Brahiam18/controlador-pid-analogico-levitador/README.md

# Controlador PID analógico para levitación electromagnética







Diseño, cálculo, simulación, implementación y pruebas de un controlador **PID 100 % analógico**, construido solo con amplificadores operacionales LM741, para estabilizar la posición de un objeto en levitación por atracción electromagnética. El repositorio incluye el informe técnico completo (PDF y código fuente LaTeX), las figuras, la lista de materiales, las mediciones del montaje físico y su comparación con la teoría.

> **TL;DR (EN):** Fully analog, parallel PID controller built with LM741 op-amps for an electromagnetic levitation system: error amplifier, P / I (with anti-windup leak) / D (with high-frequency limiting) stages, and a summing stage with offset that produces a 1–3 V control signal. Reference voltages are generated by resistive dividers isolated with voltage-follower buffers. Includes hand calculations, Proteus simulation and an IEEE-style report written in LaTeX (Spanish).

📄 **Informe:** [`informe/Informe_PID_Analogico_Levitador.pdf`](informe/Informe_PID_Analogico_Levitador.pdf)

---

## Resumen del diseño

| Parámetro | Valor |
|---|---|
| Topología | PID en **paralelo** (P, I y D independientes; no en cascada) |
| Amplificadores | 7 × LM741 (U1–U7) |
| Alimentación de diseño | ±16 V |
| Salida del controlador | 1 V a 3 V (1 V = error nulo) |
| Referencia de posición | `V_ref` ≈ 2 V |
| Ganancias finales | `Kp = 2.2` · `Ki,max = 4.5` · `Kd,max = 22` |
| Frecuencias de diseño | integrador: `f_aw ≈ 0.2 Hz` · derivador: `f_c ≈ 150 Hz` |

**¿Por qué un PID?** Un levitador por atracción es inestable en lazo abierto (teorema de Earnshaw). Se descartaron el control todo-o-nada (fuerza discontinua), el P puro y el PD (ambos dejan error de estado estable o no lo eliminan) y se eligió el PID: P corrige el error instantáneo, I elimina el error de estado estable y D aporta el amortiguamiento que el sistema no tiene por sí mismo.

## Arquitectura

```mermaid
flowchart LR
    S["Sensor de posición<br/>V_sensor"] --> D["Diferenciador de error<br/>U1"]
    VR["Divisor + buffer V_ref<br/>R12, R13, U6"] --> D
    D -- "V_e" --> P["Proporcional<br/>U2 (Pot1, R5)"]
    D -- "V_e" --> I["Integral + anti-windup<br/>U3 (Pot2, Ci, R11)"]
    D -- "V_e" --> De["Derivativo + filtro<br/>U4 (R6, C2, Pot3)"]
    P --> SUM["Sumador<br/>U5 (R7–R10, R_offset)"]
    I --> SUM
    De --> SUM
    VO["Divisor + buffer V_off<br/>R14, R15, U7"] --> SUM
    SUM -- "1 a 3 V" --> OUT["Etapa de potencia y bobina"]
    OUT --> OBJ["Posición del objeto"]
    OBJ -. "realimentación" .-> S
```

| Etapa | CI | Ecuación de diseño | Valores finales |
|---|---|---|---|
| Diferenciador de error | U1 | `V_e = (R2/R1)·(V_sensor − V_ref)`, `Av = 1` | R1 = R2 = R3 = R4 = 10 kΩ |
| Proporcional (P) | U2 | `V_P = −(Pot1/R5)·V_e` | R5 = 10 kΩ, Pot1 = 22 kΩ (`Kp = 2.2`) |
| Integral (I) | U3 | `V_I = −(1/(Pot2·Ci))∫V_e dt`, con fuga `R11 ‖ Ci`: `K_max = R11/Pot2` | Pot2 = 220 kΩ, Ci = 1 µF, R11 = 1 MΩ (`K_max = 4.5`) |
| Derivativo (D) | U4 | `V_D = −Pot3·C2·dV_e/dt`, `G_max = Pot3/R6`, `f_c = 1/(2π·R6·C2)` | R6 = 1 kΩ, C2 = 1 µF, Pot3 = 22 kΩ (`Kd,max = 22`) |
| Sumador | U5 | `V_PID = −(R10/R7·V_P + R10/R8·V_I + R10/R9·V_D + R10/R_offset·V_off)` | R7 = R8 = R9 = R_offset = 10 kΩ, R10 = 1 kΩ (ganancia 0.1 por rama) |
| Referencia `V_ref` | U6 | divisor + seguidor | R12 = 160 kΩ, R13 = 240 kΩ (desde 5 V → 2 V) |
| Offset `V_off` | U7 | divisor + seguidor | R14 = 96 kΩ (calculada; **pendiente de medir**), R15 = 160 kΩ |

La nomenclatura de las resistencias fue actualizada respecto a la primera versión del informe; la tabla de equivalencias está en [`docs/nomenclatura.md`](docs/nomenclatura.md).

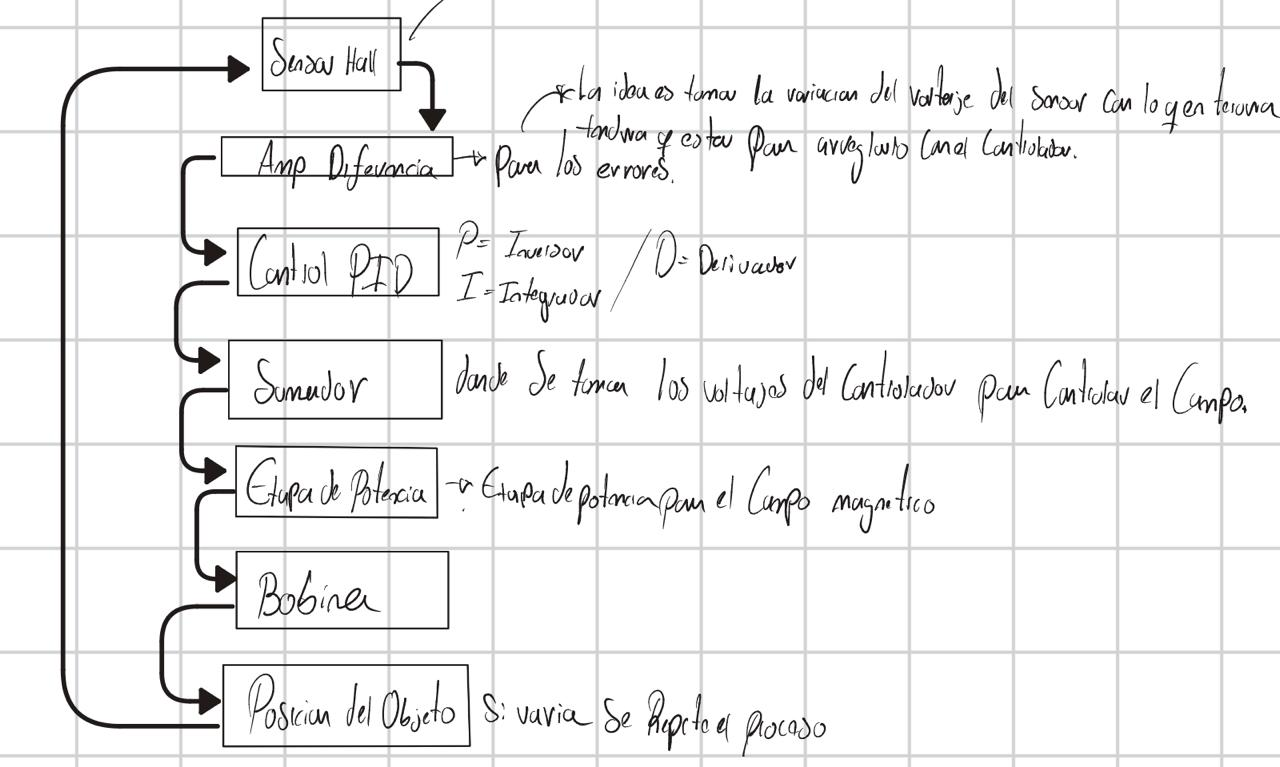
[picture p1: informe/figuras/diagrama_de_bloques.jpeg]
Diagrama de bloques


## Problemas encontrados y cómo se resolvieron

1. **Saturación del sumador.** Con ganancia unitaria por rama, la salida teórica ante error máximo era de 23.24 V, muy por encima de los rieles. Se bajó la ganancia por rama a 0.1 (`R10`: 10 kΩ → 1 kΩ), se agregó un voltaje de offset para fijar el piso en 1 V y se redujo `Kp` de 3 a 2.2 para que el máximo converja a ≈ 3 V (3.02 V).
2. **Topología del integrador.** La resistencia de anti-windup se había conectado *en serie* con el capacitor, dejando la realimentación abierta en continua. Al colocarla en **paralelo** (`R11 ‖ Ci`) el integrador recuperó su comportamiento (salida nula para error nulo, rampa ante un escalón). Además se rediseñó `Ki` (ganancia DC máxima de 80 → 4.5) porque la original saturaba ante errores pequeños.
3. **Efecto de carga en los divisores.** Los divisores de `V_ref` y `V_off` entregaban menos voltaje del calculado al conectarse a la etapa siguiente. Se intercaló un seguidor de voltaje (U6 y U7) en cada uno.

## Placa de circuito impreso (2 PID con etapa de potencia por tarjeta)

En [`hardware/pcb/`](hardware/pcb/) hay una placa de una sola cara (170.2 × 116.8 mm, cabe en una baquela de 20 × 20 cm) con **dos controladores PID independientes, cada uno con su etapa de potencia** (TIP122, banco de sensado de 3 × 1 Ω y bornes de bobina). Para los cuatro controladores se hacen **dos tarjetas iguales**. Está lista para quemar en baquela: archivos EAGLE para Fusion, hojas de cobre espejado a escala 1:1 y de ensamble con los nombres de cada pieza (U1 a U8 sobre los TL074CN), lista de puentes y el generador en Python. El informe todavía describe el diseño con LM741.

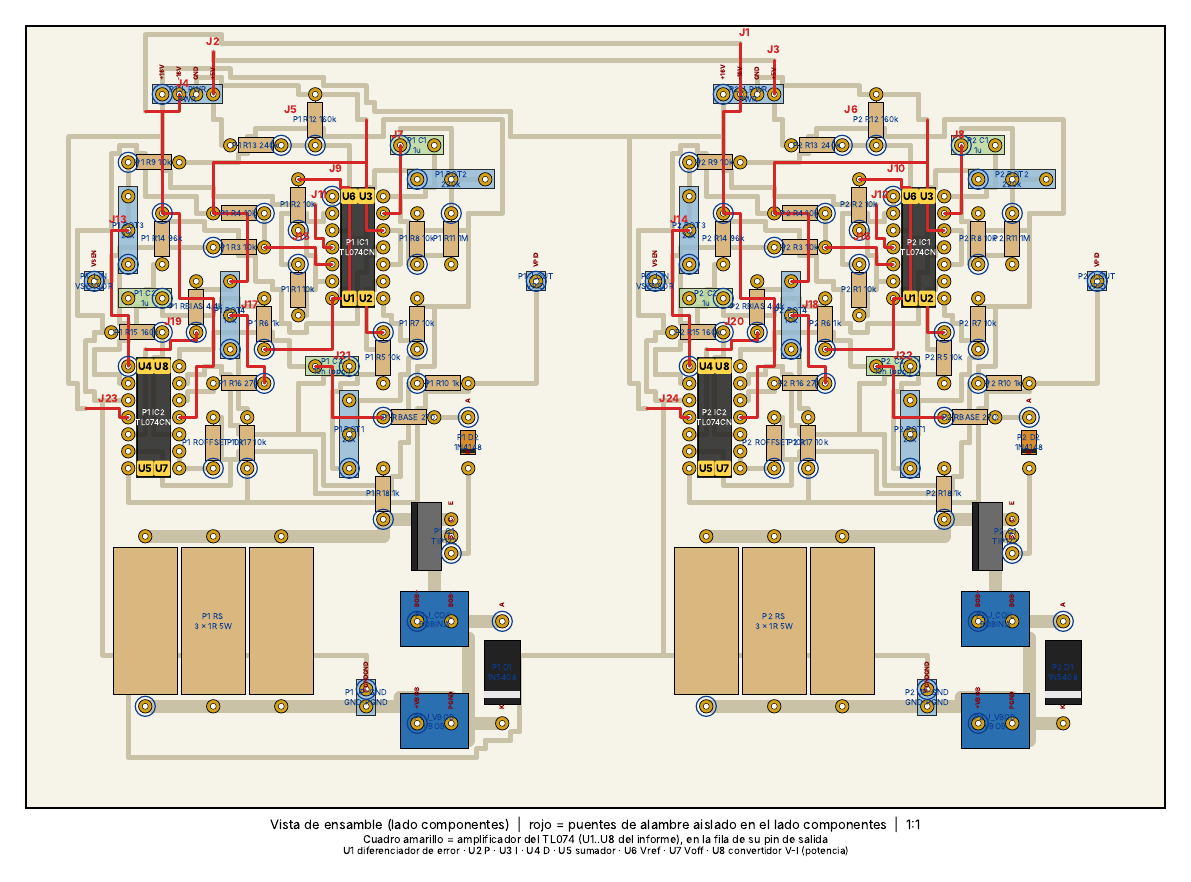
[picture p2: hardware/pcb/img/ensamble.png]
Placa de 2 PID


## Etapa de potencia (convertidor tensión-corriente)

La salida del PID (`V_PID`, 1 V a 3 V) no mueve la bobina directamente: pasa por un **convertidor tensión-corriente** con un amplificador operacional (U8) y un transistor Darlington TIP122, de modo que la bobina recibe una **corriente proporcional a `V_PID`** y no depende de su resistencia ni de la fuente (mientras el transistor no se sature). Es lo que se necesita en un levitador: la fuerza magnética depende de la corriente.

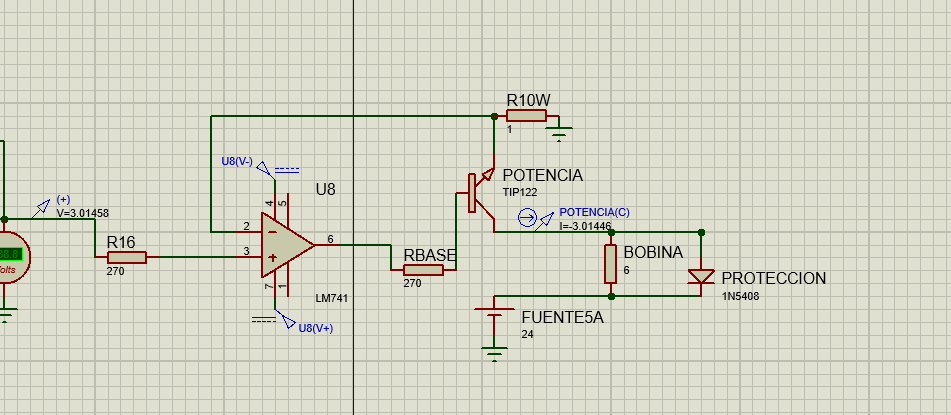
[picture p3: informe/figuras/proteus_etapa_potencia.png]
Etapa de potencia en Proteus


**Cómo funciona.**

1. `V_PID` llega a la entrada no inversora de U8 por `R17` (10 kΩ), el potenciómetro de calibración `POT4` (10 kΩ) y `R16` (270 Ω); `POT4` fija cuántos amperios se obtienen por voltio de `V_PID`.
2. U8 maneja la base del TIP122 a través de `R_BASE` (270 Ω) y del diodo `D2` (1N4148).
3. La corriente de la bobina pasa por el TIP122 y por el **banco de sensado** (3 × 1 Ω / 5 W en paralelo = 0.33 Ω), cuya caída `V_ISENSE = 0.33 V/A · I` vuelve a la entrada inversora de U8 por `R18` (1 kΩ).
4. U8 corrige la base hasta que `V_ISENSE` iguala la tensión de su entrada no inversora; por eso `I ≈ V₊ / R_sense`, es decir, **la corriente sigue a `V_PID`**.
5. `D1` (1N5408) en antiparalelo con la bobina absorbe la tensión inducida cuando se corta la corriente. `C3` (10 nF, opcional) compensa el lazo de U8 si oscila.

| Elemento | Valor | Función |
|---|---|---|
| `R17` | 10 kΩ | entrada del convertidor desde `V_PID` |
| `POT4` | 10 kΩ | calibración (A por voltio de `V_PID`) |
| `R16` | 270 Ω | protección de la entrada no inversora de U8 |
| `R18` | 1 kΩ | realimentación de `V_ISENSE` a la entrada inversora |
| `R_BASE` | 270 Ω | limita la corriente de base del TIP122 |
| `R_sense` | 3 × 1 Ω / 5 W (0.33 Ω) | sensado de la corriente de la bobina |
| `D1` / `D2` | 1N5408 / 1N4148 | protección de la bobina / protección de la base |
| TIP122 | Darlington NPN | elemento de paso (≈ 4.7 W con 1 A: lleva disipador de ≤ 10 °C/W y tab aislado) |

**Simulación (Proteus).** El archivo [`simulacion/proteus/EtapaPID1.pdsprj`](simulacion/proteus/EtapaPID1.pdsprj) contiene el PID completo con esta etapa. La captura muestra una **variante de simulación** para comprobar el principio: LM741 como U8, resistencia de sensado de 1 Ω / 10 W, bobina de 6 Ω y fuente de 24 V. Con `V₊ = 3.015 V` la corriente por el TIP122 es de **3.014 A**, igual a `V₊ / 1 Ω`: el convertidor entrega la corriente que se le pide. En el montaje real el sensado es de 0.33 Ω, la bobina ronda los 4 Ω y la corriente de trabajo es de unos 1 A, alimentada desde módulos reductores (ver [`docs/estado_del_proyecto.md`](docs/estado_del_proyecto.md)).

## Simulación en Proteus

Cada etapa se simuló y midió con voltímetros virtuales antes del montaje. El proyecto de Proteus se encuentra en [`simulacion/proteus/`](simulacion/proteus/) (`EtapaPID1.pdsprj`). El esquemático completo está en [`informe/figuras/proteus_circuito_completo.png`](informe/figuras/proteus_circuito_completo.png) y el esquemático hecho a mano en [`informe/figuras/circuito_manuscrito.jpeg`](informe/figuras/circuito_manuscrito.jpeg).

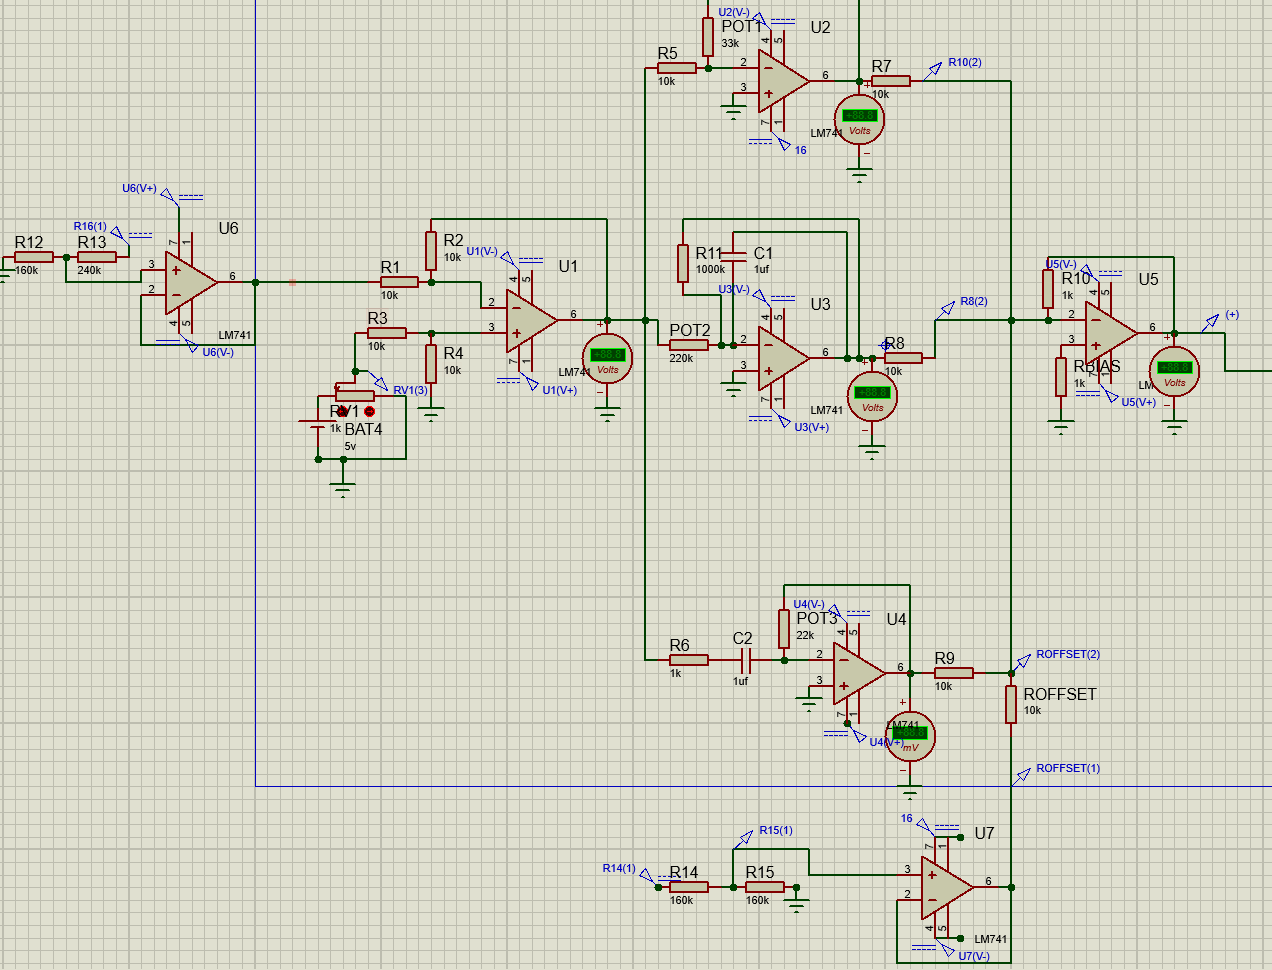
[picture p4: informe/figuras/proteus_circuito_completo.png]
Esquemático en Proteus


## Resultados experimentales

Voltaje teórico vs. práctico por etapa, para error mínimo, medio y máximo (`V_sensor` = 0, 2 y 5 V con `V_ref` = 2 V). Las mediciones se tomaron con multímetro sobre el montaje en protoboard alimentado a ±16 V. Los datos completos, con error absoluto y relativo, están en [`datos/mediciones_practicas.csv`](datos/mediciones_practicas.csv).

| Etapa | Teórico mín. (V) | Teórico medio (V) | Teórico máx. (V) | Práctico mín. (V) | Práctico medio (V) | Práctico máx. (V) |
|---|---:|---:|---:|---:|---:|---:|
| Diferenciador | −2 | 0 | 3 | −2.02 | 0 | 2.99 |
| Proporcional (P) | 4.38 | −0.01 | −6.6 | 4.46 | −0.15 | −6.6 |
| Integral (I) | 9.14 | 0.07 | −13.5 | 6.22 | −0.32 | −13.22 |
| Derivativo (D) | −3.24 mV | −3.24 mV | −3.3 mV | 3 mV | 3 mV | 172 mV |
| Sumador | −0.35 | 1 | 3.01 | −0.04 | 1 | 2.96 |
| Divisor `V_ref` | 2 | 2 | 2 | 2 | 2 | 2 |
| Divisor `V_off` | −10.1 | −10.1 | −10.1 | −10.21 | −10.21 | −10.21 |

**Lectura rápida:**
- El diferenciador, el proporcional, el sumador y los divisores con buffer coinciden con lo calculado (error relativo ≤ 2 % donde el valor teórico es mayor que 0.5 V). La salida del sumador con error máximo es 2.96 V, dentro del rango de diseño de 1 V a 3 V, y con error medio es exactamente 1 V.
- La etapa integral con error mínimo da 6.22 V frente a 9.14 V teóricos (−32 %). Con ese valor práctico, el sumador resulta en −0.04 V, que es coherente con la salida medida.
- En la etapa derivativa, con entrada en DC, los valores son del orden de milivoltios; el de 172 mV con error máximo queda pendiente de analizar.

### Montaje físico

<p align="center">
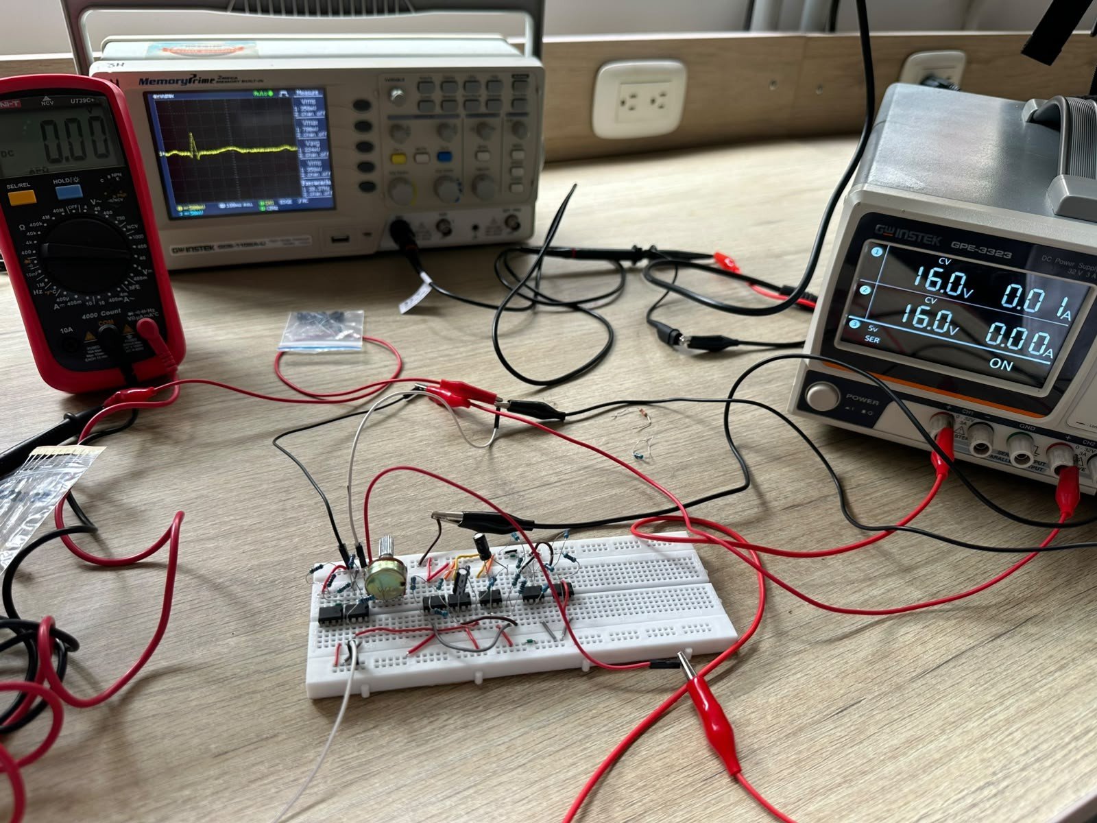
[picture p5: informe/figuras/pruebas/montaje_fisico.jpg]
Montaje físico del controlador PID
  
</p>

| Circuito en protoboard | Medición a la salida del diferenciador (2.99 V) |
|:-:|:-:|
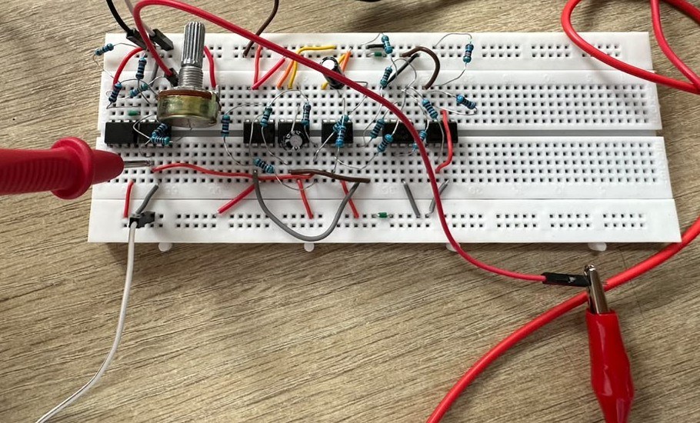
[picture p6: informe/figuras/pruebas/montaje_protoboard.jpg]
Protoboard
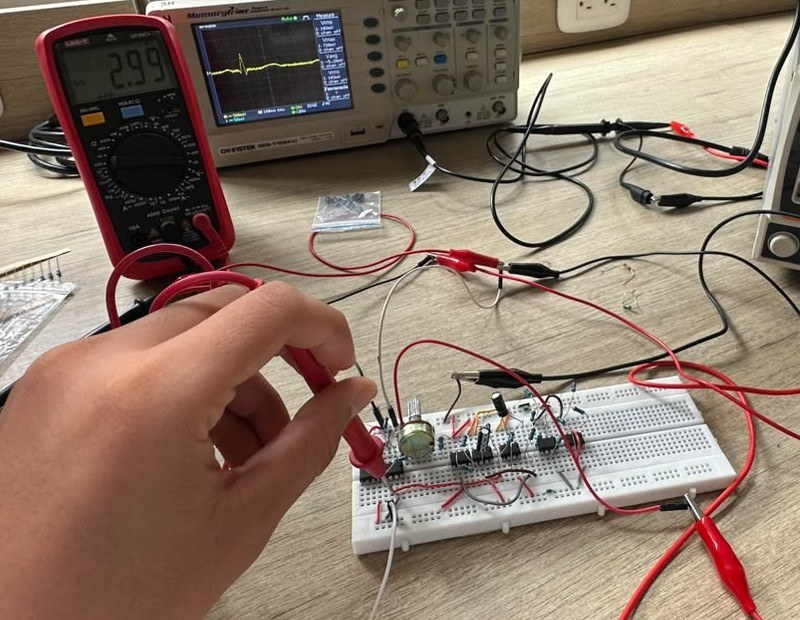
[picture p7: informe/figuras/pruebas/medicion_diferenciador.jpg]
Medición del diferenciador
|  |  |

## Simulación del campo y póster

Modelo del campo magnético de las 4 bobinas y del imán (aproximación de dipolos, solvers propios en Python, no FEMM) para estimar la corriente de equilibrio: unos **0,7 A por bobina a 30 mm** (±15 %). Es una estimación ilustrativa; **la levitación todavía no se ha logrado en el montaje**.

<p align="center">
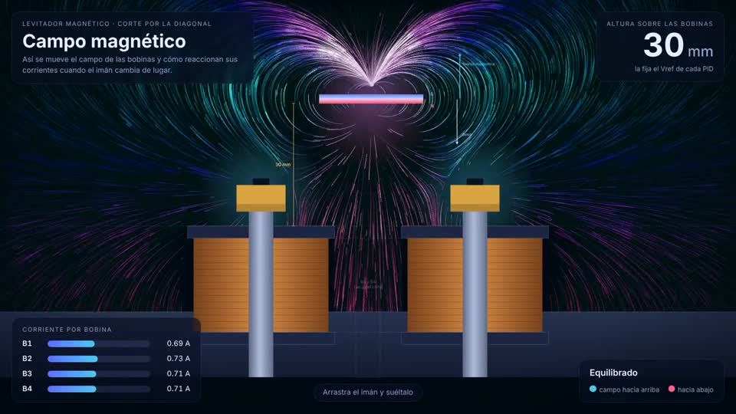
[picture p8: docs/simulacion_campo/vista_previa.jpg]
Video de la simulación del campo
  
</p>

- Video (720p): [`docs/simulacion_campo/campo_levitador_720p.mp4`](docs/simulacion_campo/campo_levitador_720p.mp4)
- Visor interactivo 3D: [`docs/simulacion_campo/campo_levitador.html`](docs/simulacion_campo/campo_levitador.html) (descargar y abrir en el navegador)
- Notas del modelo: [`docs/simulacion_campo/README.md`](docs/simulacion_campo/README.md)
- Póster presentado en METIE 2026: [PDF](docs/poster_metie/Poster_Levitador_METIE.pdf) · [PPTX](docs/poster_metie/Poster_Levitador_METIE.pptx)

<p align="center">
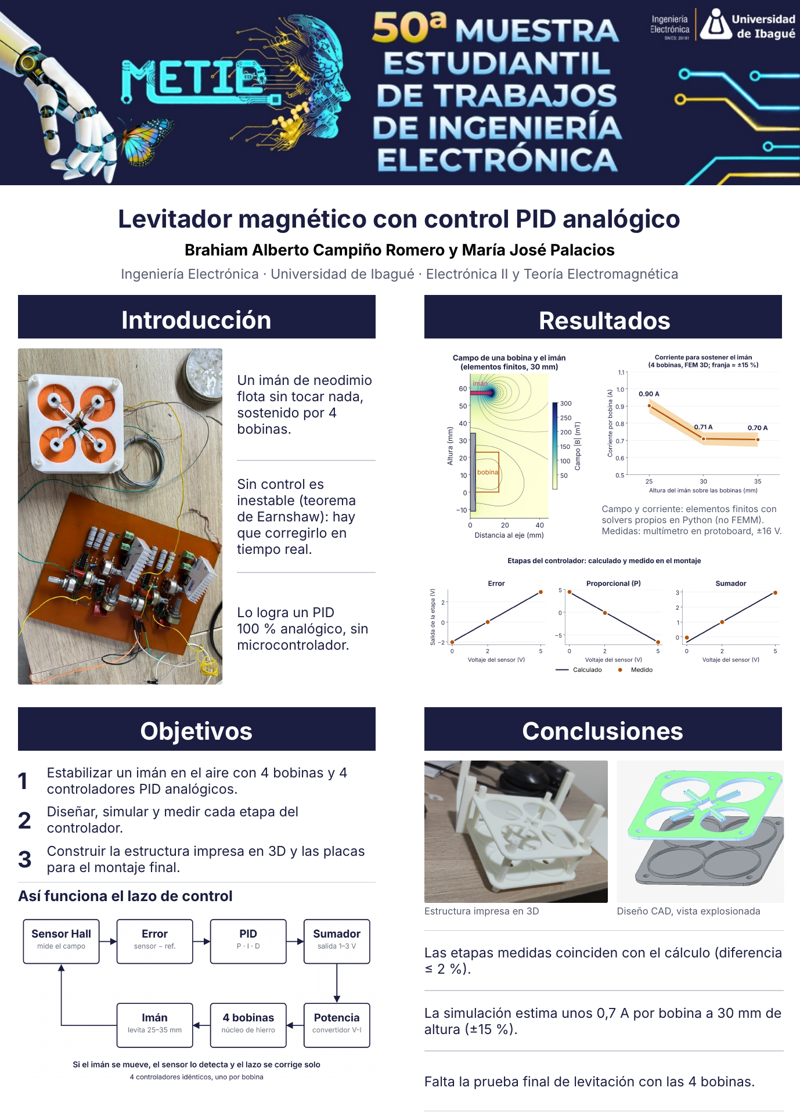
[picture p9: docs/poster_metie/poster_vista_previa.png]
Póster METIE 2026
  
</p>

## Estructura del repositorio

```text
.
├── informe/
│   ├── informe_pid_analogico.tex        # código fuente del informe (IEEEtran)
│   ├── Informe_PID_Analogico_Levitador.pdf
│   └── figuras/                         # esquemáticos (incl. Proteus de la etapa de potencia), cálculos a mano y diagrama de bloques
│       └── pruebas/                     # fotografías del montaje y de las mediciones
├── docs/
│   ├── nomenclatura.md                  # nomenclatura vigente y equivalencias con la versión anterior
│   ├── errata-y-pendientes.md           # inconsistencias detectadas en el informe y tareas abiertas
│   ├── estado_del_proyecto.md           # estado actual, qué falta y requisitos de alimentación
│   ├── plan_2027.md                     # plan para lograr la levitación estable
│   ├── guia_depuracion.md               # diagnósticos y pruebas de un PID
│   ├── resumen_para_posgrado.md         # resumen del proyecto (ES/EN)
│   ├── simulacion_campo/                # visualización interactiva del campo y video
│   └── poster_metie/                    # póster de la muestra METIE 2026
├── hardware/
│   ├── lista_de_materiales.md
│   ├── lista_de_materiales.csv
│   └── pcb/                             # placa de 2 PID: .sch/.brd (Fusion/EAGLE), PDF de cobre y ensamble, generador
├── simulacion/
│   └── proteus/                         # proyecto de Proteus (PID + etapa de potencia)
├── pruebas/
│   ├── montaje/                         # fotos del montaje de los 4 PID con la base 3D (nov. 2026)
│   └── levitacion/                      # fotos de los 4 PID levitando y Vref por altura (pendiente)
├── datos/
│   └── mediciones_practicas.csv         # teórico vs. práctico, con error absoluto y relativo
├── fuente/                              # fuente ±16 V (1,5 A) / +5 V de los 4 PID (informe, esquemáticos, simulación, PCB, pruebas)
├── LICENSE
└── README.md
```

## Compilar el informe

Requiere una distribución de TeX Live con `IEEEtran`, `siunitx` y `booktabs`.

```bash
cd informe
latexmk -pdf informe_pid_analogico.tex
```

## Estado y próximos pasos

**Noviembre de 2026:** los 4 PID, la etapa de potencia y la base impresa en 3D están montados y funcionando por separado, pero la levitación estable a 3 cm quedó pendiente: falta un método rápido para fijar los `V_ref` y los sensores ven una variación muy pequeña del campo. El trabajo continúa en 2027; ver [`docs/estado_del_proyecto.md`](docs/estado_del_proyecto.md), [`docs/plan_2027.md`](docs/plan_2027.md) y [`docs/guia_depuracion.md`](docs/guia_depuracion.md).

<p align="center">
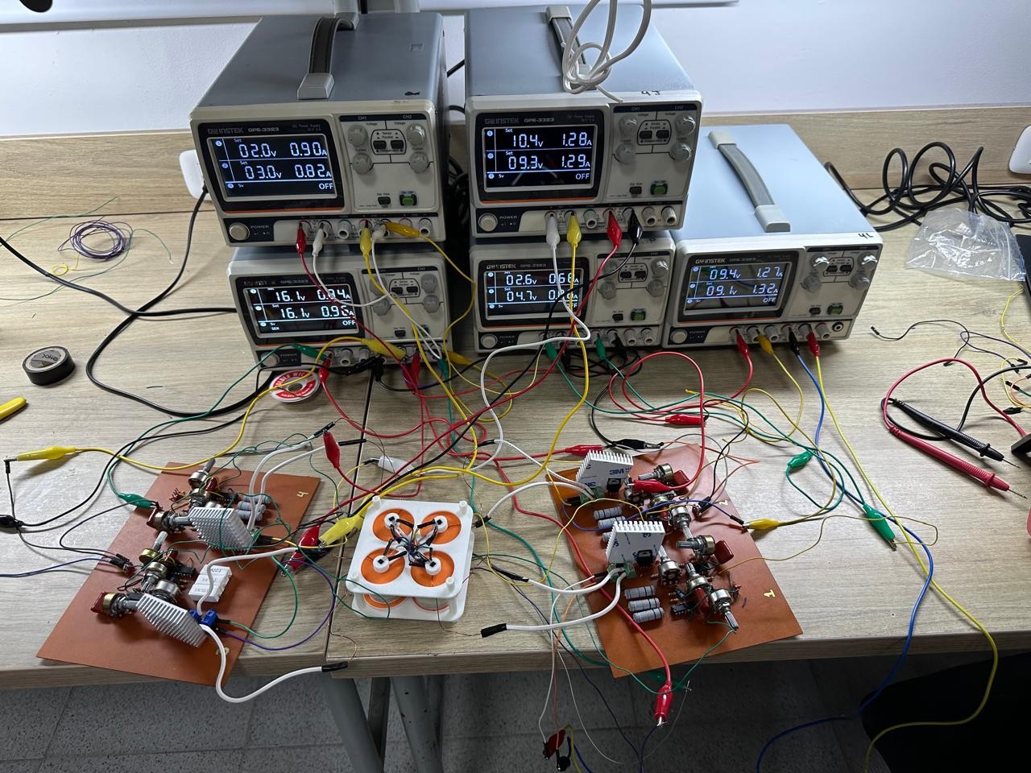
[picture p10: pruebas/montaje/montaje_2026-11_banco_4_pid.jpg]
Banco con los 4 PID y la base impresa en 3D
  
</p>

- [x] Diseño y cálculo de cada etapa
- [x] Simulación en Proteus
- [x] Informe técnico en LaTeX (formato IEEE)
- [ ] Medir `R14` (divisor de `V_off`) y registrar su valor final
- [x] Tomas de voltaje prácticas por etapa (error mínimo, medio y máximo)
- [x] Fotografías del montaje
- [ ] Analizar la desviación de la etapa integral con error mínimo y el valor de la etapa derivativa con error máximo
- [ ] Capturas de osciloscopio con la escala legible (pruebas con señal senoidal)
- [x] Agregar el archivo del proyecto de Proteus
- [x] Documentar la etapa de potencia (README e informe)
- [ ] Fotos de los 4 PID con el objeto levitando y `V_ref` por altura ([`pruebas/levitacion/`](pruebas/levitacion/))
- [ ] Aplicar la [errata](docs/errata-y-pendientes.md) al informe (versión 1.1)

## Autor

**Brahiam Alberto Campiño Romero**: Ingeniería Electrónica, Universidad de Ibagué (Ibagué-Tolima, Colombia) · [@Brahiam18](https://github.com/Brahiam18)

## Licencia

[MIT](LICENSE)
