Brahiam18/controlador-pid-analogico-levitador/hardware/pcb/puentes_esquinas45.md

# Puentes de alambre (capa de arriba)

| # | Red | Largo (mm) | Extremos |
|---|---|---|---|
| J1 | +5V | 7 | P1_J_PWR.4 ↔ agujero (27.8; 113.1) mm, junto a P1_J_PWR.4 |
| J2 | +5V | 5 | P2_J_PWR.4 ↔ agujero (111.3; 111.8) mm, junto a P2_J_PWR.4 |
| J3 | -16V | 67 | P2_IC2.11 ↔ agujero (106.7; 111.7) mm, junto a P2_J_PWR.2 |
| J4 | -16V | 65 | P1_IC2.11 ↔ P1_J_PWR.2 ↔ agujero (17.3; 104.1) mm, junto a P1_J_PWR.1 |
| J5 | GND | 70 | P2_IC1.12 ↔ P2_POT4.3 ↔ agujero (135.9; 105.9) mm, junto a P2_C1.1 ↔ agujero (135.9; 96.5) mm, junto a P2_C1.1 |
| J6 | GND | 67 | P1_IC1.12 ↔ P1_POT4.3 ↔ agujero (50.8; 102.9) mm, junto a P1_C1.1 ↔ agujero (50.8; 96.5) mm, junto a P1_IC1.14 |
| J7 | P1_U3N | 13 | P1_C1.1 ↔ P1_IC1.13 |
| J8 | P2_U3N | 13 | P2_C1.1 ↔ P2_IC1.13 |
| J9 | P1_VE | 56 | P1_R2.2 ↔ P1_R5.1 ↔ P1_R6.1 ↔ agujero (48.3; 76.2) mm, junto a P1_IC1.7 |
| J10 | P2_VE | 56 | P2_R2.2 ↔ P2_R5.1 ↔ P2_R6.1 ↔ agujero (132.1; 76.2) mm, junto a P2_IC1.7 |
| J11 | +16V | 9 | P2_IC1.4 ↔ agujero (127.0; 90.7) mm, junto a P2_IC1.1 |
| J12 | +16V | 9 | P1_IC1.4 ↔ agujero (43.2; 90.2) mm, junto a P1_IC1.1 |
| J13 | P1_VD | 25 | P1_IC2.1 ↔ P1_POT3.2 |
| J14 | P2_VD | 25 | P2_IC2.1 ↔ P2_POT3.2 |
| J15 | P1_U1P | 13 | P1_IC1.5 ↔ P1_R3.2 |
| J16 | P2_U1P | 13 | P2_IC1.5 ↔ P2_R3.2 |
| J17 | P1_VCAL | 15 | P1_POT4.2 ↔ P1_R16.1 |
| J18 | P2_VCAL | 15 | P2_POT4.2 ↔ P2_R16.1 |
| J19 | P1_U5P | 10 | P1_RBIAS.1 ↔ agujero (17.8; 68.6) mm, junto a P1_IC2.1 |
| J20 | P2_U5P | 10 | P2_RBIAS.1 ↔ agujero (101.6; 68.6) mm, junto a P2_IC2.1 |
| J21 | P1_IOUT | 18 | P1_C3.2 ↔ P1_RBASE.1 |
| J22 | P2_IOUT | 18 | P2_C3.2 ↔ P2_RBASE.1 |
| J23 | +16V | 7 | P1_IC2.4 ↔ agujero (8.9; 59.2) mm, junto a P1_IC2.4 |
| J24 | +16V | 10 | P2_IC2.4 ↔ agujero (88.9; 59.2) mm, junto a P2_IC2.4 |
