Brahiam18/controlador-pid-analogico-levitador/hardware/pcb/puentes.md

| N.º | Red | Longitud aprox. | Extremos |
|:-:|---|--:|---|
| J1 | `-16V` | 71 mm | P2_IC2.11 ↔ agujero (106.7; 114.3) mm, junto a P2_J_PWR.2 |
| J2 | `+5V` | 6 mm | P1_J_PWR.4 ↔ agujero (27.9; 113.0) mm, junto a P1_J_PWR.4 |
| J3 | `+5V` | 5 mm | P2_J_PWR.4 ↔ agujero (111.8; 111.8) mm, junto a P2_J_PWR.4 |
| J4 | `-16V` | 66 mm | agujero (17.8; 104.1) mm, junto a P1_J_PWR.1 ↔ P1_IC2.11 ↔ P1_J_PWR.2 |
| J5 | `GND` | 67 mm | P1_POT4.3 ↔ agujero (50.8; 102.9) mm, junto a P1_C1.1 ↔ P1_IC1.12 |
| J6 | `GND` | 67 mm | P2_POT4.3 ↔ agujero (134.6; 102.9) mm, junto a P2_C1.1 ↔ P2_IC1.12 |
| J7 | `P1_U3N` | 13 mm | P1_IC1.13 ↔ P1_C1.1 |
| J8 | `P2_U3N` | 13 mm | P2_IC1.13 ↔ P2_C1.1 |
| J9 | `P1_VE` | 56 mm | P1_R6.1 ↔ P1_R2.2 ↔ P1_R5.1 |
| J10 | `P2_VE` | 56 mm | P2_R6.1 ↔ P2_R2.2 ↔ P2_R5.1 |
| J11 | `+16V` | 9 mm | agujero (43.2; 90.2) mm, junto a P1_IC1.1 ↔ P1_IC1.4 |
| J12 | `+16V` | 9 mm | agujero (127.0; 90.2) mm, junto a P2_IC1.1 ↔ P2_IC1.4 |
| J13 | `P1_VD` | 25 mm | P1_IC2.1 ↔ P1_POT3.2 |
| J14 | `P2_VD` | 25 mm | P2_IC2.1 ↔ P2_POT3.2 |
| J15 | `P1_U1P` | 13 mm | P1_R3.2 ↔ P1_IC1.5 |
| J16 | `P2_U1P` | 13 mm | P2_R3.2 ↔ P2_IC1.5 |
| J17 | `P1_VCAL` | 15 mm | P1_POT4.2 ↔ P1_R16.1 |
| J18 | `P2_VCAL` | 15 mm | P2_POT4.2 ↔ P2_R16.1 |
| J19 | `P1_U5P` | 10 mm | agujero (17.8; 68.6) mm, junto a P1_IC2.1 ↔ P1_RBIAS.1 |
| J20 | `P2_U5P` | 10 mm | agujero (101.6; 68.6) mm, junto a P2_IC2.1 ↔ P2_RBIAS.1 |
| J21 | `P1_IOUT` | 18 mm | P1_C3.2 ↔ P1_RBASE.1 |
| J22 | `P2_IOUT` | 18 mm | P2_C3.2 ↔ P2_RBASE.1 |
| J23 | `+16V` | 8 mm | agujero (8.9; 59.7) mm, junto a P1_IC2.3 ↔ P1_IC2.4 |
| J24 | `+16V` | 8 mm | agujero (92.7; 59.7) mm, junto a P2_IC2.3 ↔ P2_IC2.4 |
