Brahiam18/controlador-pid-analogico-levitador/fuente/hardware/pcb/puentes.md

# Puentes de alambre (lado de componentes)

| N.º | Red | Longitud aprox. | Extremos |
|:-:|---|--:|---|
| P1 | `IN1` | 36 mm | agujero (88.9; 129.5) mm junto a Q2.3 ↔ Q4.1 ↔ R7A.2 |
| P2 | `BD1` | 9 mm | Q3.1 ↔ agujero (80.0; 121.9) mm junto a D5.2 |
| P3 | `+5V` | 6 mm | agujero (158.8; 121.9) mm junto a C19.1 ↔ C19.1 |
| P4 | `ADJ1` | 15 mm | C6.1 ↔ agujero (139.7; 119.4) mm junto a R20.1 |
| P5 | `LED3A` | 8 mm | R22.2 ↔ LED3.1 |
| P6 | `+5V` | 9 mm | agujero (168.9; 78.7) mm junto a RV3.2 ↔ D11.1 |
| P7 | `IN2` | 34 mm | agujero (102.9; 27.9) mm junto a R16.2 ↔ agujero (102.9; 35.6) mm junto a R16.1 ↔ agujero (129.5; 33.0) mm junto a TP14.1 |
| P8 | `BD2` | 30 mm | agujero (63.5; 20.3) mm junto a RSC2.2 ↔ Q6.3 |
