Brahiam18/controlador-pid-analogico-levitador/docs/plan_2027.md

# Plan de trabajo para lograr la levitación estable (hacia METIE 2027)

Objetivo: imán de Ø25,4 × 2,1 mm (7,94 g) estable a 3 cm de las bobinas, con los 4 PID analógicos. Estado de partida en [`estado_del_proyecto.md`](estado_del_proyecto.md); procedimientos en [`guia_depuracion.md`](guia_depuracion.md).

Los dos bloqueos de 2026 fueron (1) el tiempo que toma encontrar los `V_ref` y (2) la poca variación que ven los sensores. Lo que sigue son **propuestas** por validar en el banco; ninguna se ha probado todavía.

## 1. Señal del sensor (prioridad alta)
- Medir con el imán a 25, 30 y 35 mm la salida de cada SS495A y registrar la variación en mV (hoy ≈2,4 V con poca variación). Anotar con qué cara del imán sube el voltaje al acercarse.
- Subir la ganancia del diferenciador U1 (`V_e = (R2/R1)(V_sensor − V_ref)`, hoy `Av = 1`): cambiar `R2` y `R4` de 10 kΩ a 100 kΩ daría `Av = 10`. Recalcular las ganancias del sumador para que la salida siga en 1–3 V y revisar que no sature.
- Evaluar sensado diferencial entre sensores opuestos para X e Y, y la posición del sensor (más cerca de la cara del imán o con núcleo) para aumentar la señal.

## 2. Encontrar los `V_ref` más rápido (prioridad alta)
- Hoy se ajusta cada `V_ref` a mano, imán en mano. Propuesta: procedimiento con separador calibrado (por ejemplo, un cilindro impreso de 30 mm) y tabla de `V_ref` por altura y por PID, de modo que cada ajuste sea medir una vez el voltaje del sensor y fijarlo.
- Poner `V_ref` en un potenciómetro multivuelta (la PCB actual tiene R12/R13 fijas; cambiar R12 por un pot de 500 kΩ como reóstato, con una fija de ~100 kΩ en serie) y un selector por altura para los cuatro a la vez.
- Los cuatro sensores y bobinas no son idénticos, por lo que cada PID necesita su propio `V_ref`.

## 3. Fuerza y corriente
- Verificar con una balanza la fuerza real sobre el imán a 25–35 mm contra la simulación FEM (≈0,7 A por bobina a 30 mm, ±15 %; a 20 mm no hay fuerza útil). Subir a 1,0–1,2 A solo con disipador en los TIP.
- Confirmar que las 4 bobinas repelen (probar una a una) y fijar el sentido del imán respecto del sensor.
- Repetir la corriente de equilibrio con FEMM (scripts `.lua` en `simulacion/magnetica/femm/`) para comparar con los solvers propios.

## 4. Ajuste del control
- Con ganancia alta en U1, partir de `Kp` bajo (`POT1`) y subir de a poco. Descargar el integrador antes de cada prueba (puente corto en `C1`).
- Registrar en `pruebas/levitacion/` fotos y capturas de osciloscopio con los valores de cada potenciómetro.

## 5. Presentación y documentación
- Posible proyecto conjunto de dos materias para METIE 2027 (por definir).
- Aplicar la errata v1.1 del informe, cambiar LM741 por TL074CN y agregar los resultados de levitación.
