Brahiam18/controlador-pid-analogico-levitador/fuente/esquematicos/esq_completo.tex

\documentclass[border=6pt]{standalone}
\usepackage{amsmath}
\input{estilo}
\usetikzlibrary{calc}
\begin{document}
\begin{circuitikz}
\node[font=\Large\bfseries, anchor=west] at (-6.4,5.6) {Fuente $\pm$16 V / 1,5 A y +5 V (versión 2.2) --- esquemático completo};
\node[font=\small, anchor=west] at (-6.4,4.9) {Las redes con el mismo nombre ($V_{RAW+}$, $V_{RAW-}$, +16 V, GND) están unidas. Brahiam Alberto Campiño Romero, Universidad de Ibagué.};
\begin{scope}[shift={(0,0)}]\input{etapa_entrada.tikz}\end{scope}
\node[font=\bfseries, anchor=west] at (-6.4,-8.0) {Riel +16 V: limitador con foldback ($R_{SC1}$, $Q_1$--$Q_2$, $Q_3$), ampliación de corriente ($Q_4$) y regulador U1};
\begin{scope}[shift={(-6.0,-12.6)}]\input{etapa_pos.tikz}\end{scope}
\node[font=\bfseries, anchor=west] at (-6.4,-21.4) {Riel $-$16 V: limitador con foldback ($R_{SC2}$, $Q_5$--$Q_6$, $Q_7$), ampliación de corriente ($Q_8$) y regulador U2};
\begin{scope}[shift={(-6.0,-26.0)}]\input{etapa_neg.tikz}\end{scope}
\node[font=\bfseries, anchor=west] at (-6.4,-33.4) {Riel +5 V (desde +16 V por $R_{19}$, regulador U3)};
\begin{scope}[shift={(-6.0,-36.6)}]\input{etapa_5v.tikz}\end{scope}
\node[font=\bfseries, anchor=west] at (-6.4,-42.6) {Borneras de salida y puntos de prueba};
\begin{scope}[shift={(-3.0,-43.6)}]\input{etapa_salida.tikz}\end{scope}
\end{circuitikz}
\end{document}
