Brahiam18/controlador-pid-analogico-levitador/fuente/esquematicos/wrap.tex

\documentclass[border=4pt]{standalone}
\usepackage{amsmath}
\input{estilo}
\usetikzlibrary{calc}
\begin{document}
\begin{circuitikz}
\input{\etapa}
\end{circuitikz}
\end{document}
