Brahiam18/controlador-pid-analogico-levitador/docs/poster_metie/Poster_Levitador_METIE.pptx

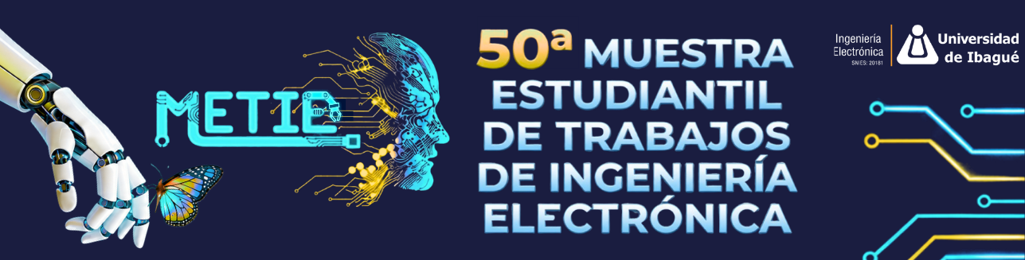
[picture p33: figure]

Introducción

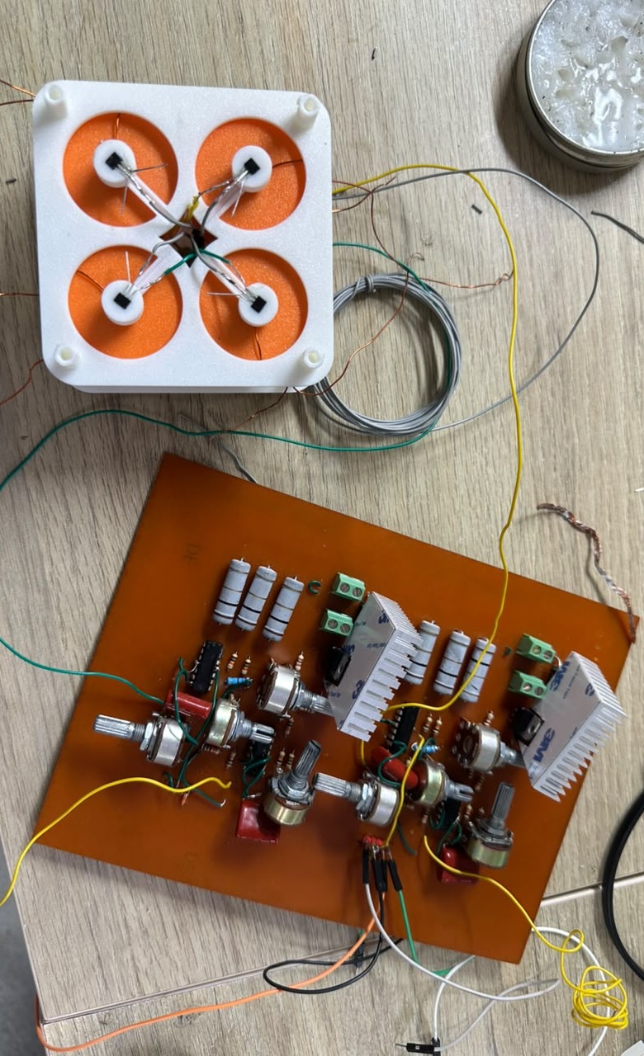
[picture p34: figure]

Levitador magnético con control PID analógico

Brahiam Alberto Campiño Romero y María José Palacios
Ingeniería Electrónica · Universidad de Ibagué · Electrónica II y Teoría Electromagnética

Resultados

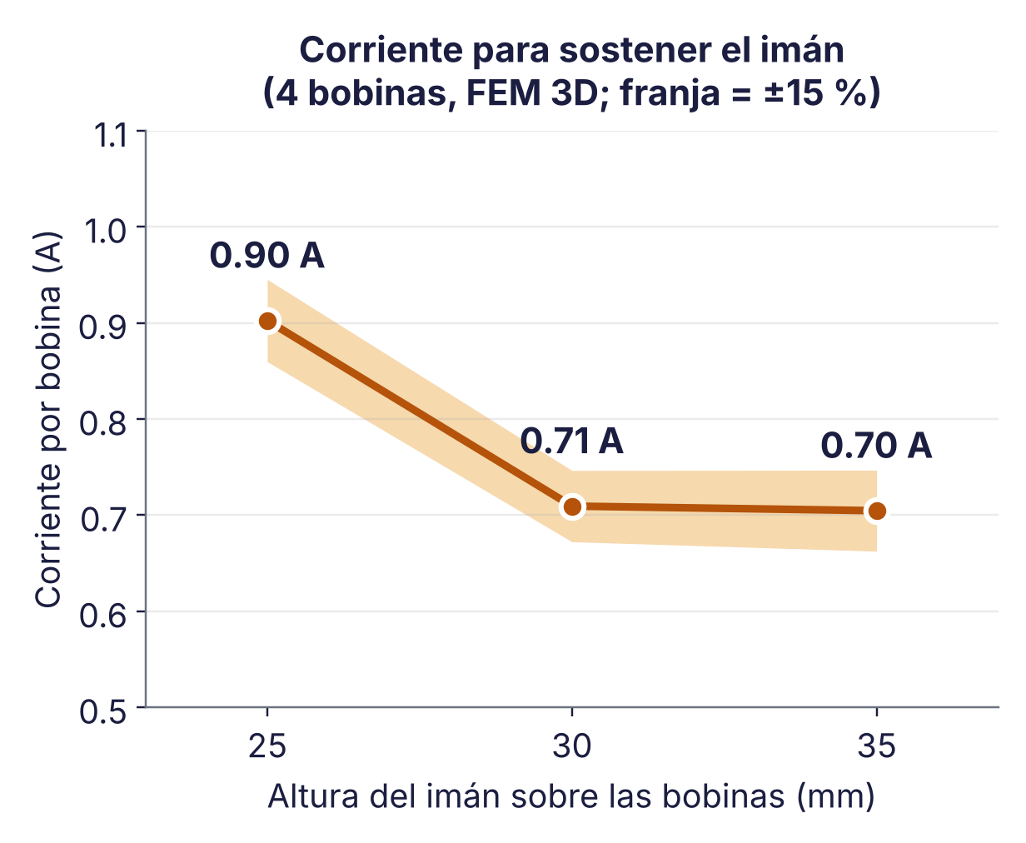
[picture p35: figure]

Campo y corriente: elementos finitos con solvers propios en Python (no FEMM). Medidas: multímetro en protoboard, ±16 V.

Un imán de neodimio flota sin tocar nada, sostenido por 4 bobinas.

Sin control es inestable (teorema de Earnshaw): hay que corregirlo en tiempo real.

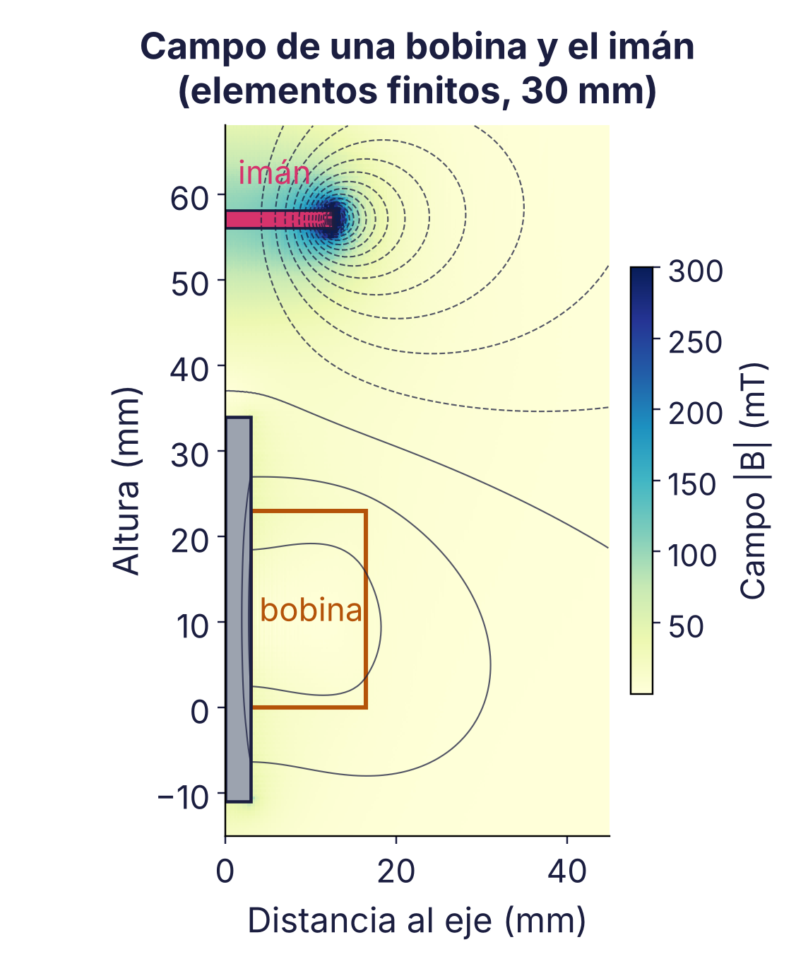
[picture p36: figure]
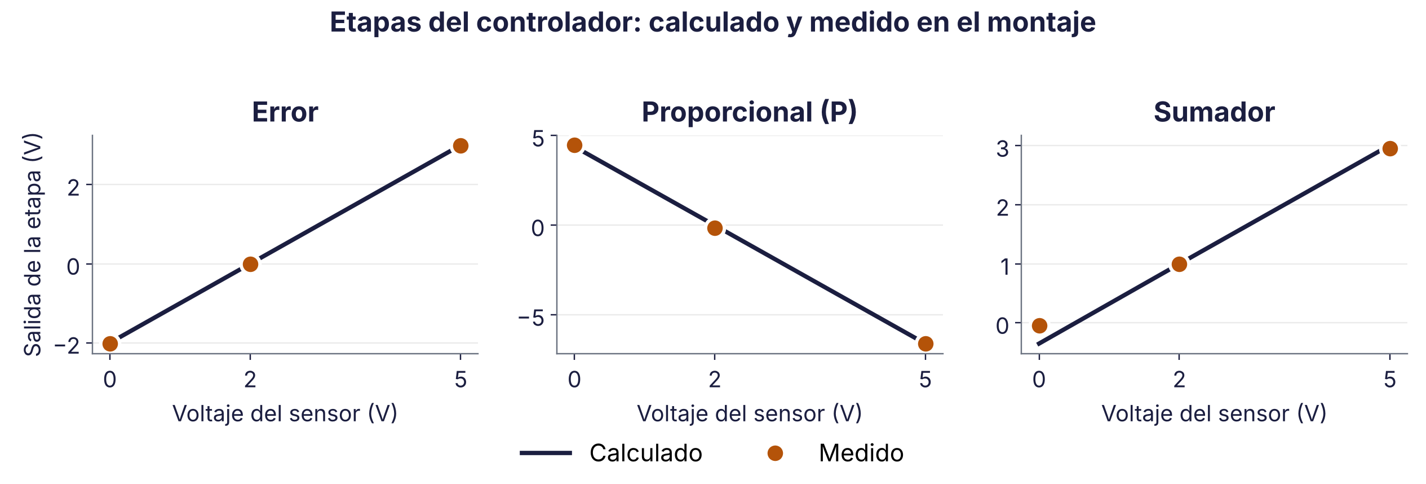
[picture p37: figure]

Lo logra un PID 100 % analógico, sin microcontrolador.

Objetivos

Estabilizar un imán en el aire con 4 bobinas y 4 controladores PID analógicos.

Conclusiones

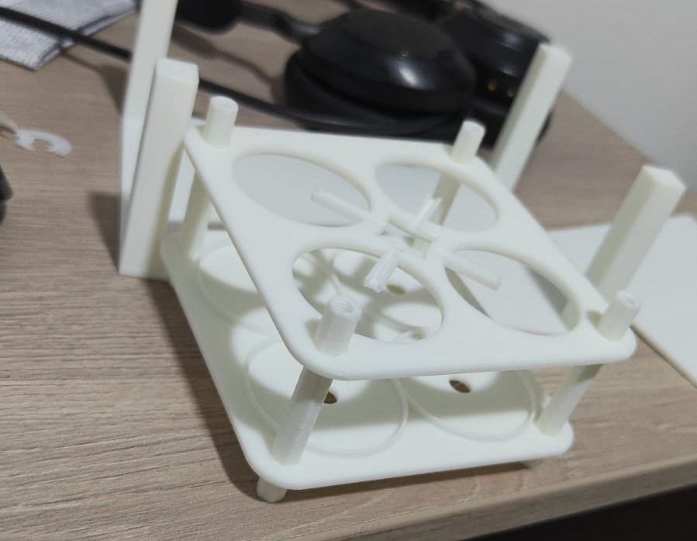
[picture p38: figure]

Estructura impresa en 3D

1

2

Diseñar, simular y medir cada etapa del controlador.

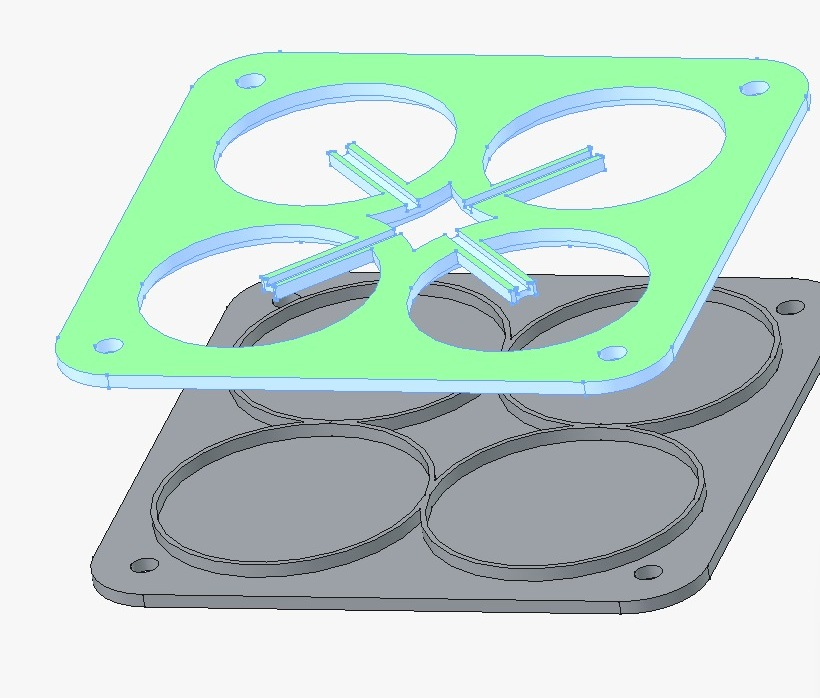
[picture p39: figure]

Diseño CAD, vista explosionada

3

Así funciona el lazo de control

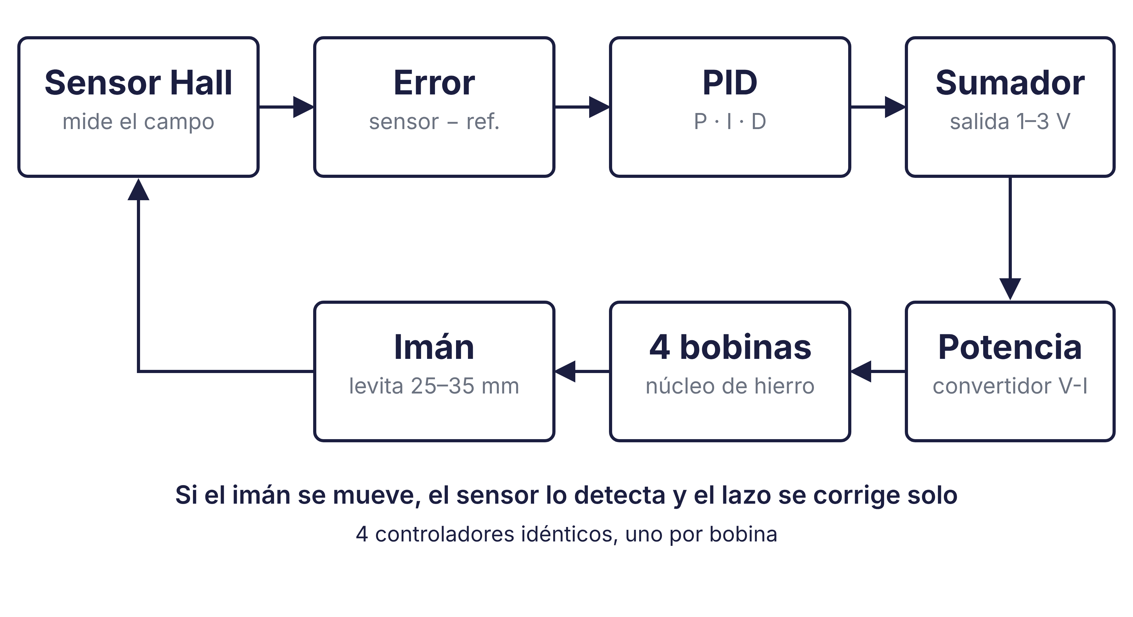
[picture p40: figure]

Construir la estructura impresa en 3D y las placas para el montaje final.

Las etapas medidas coinciden con el cálculo (diferencia ≤ 2 %).

La simulación estima unos 0,7 A por bobina a 30 mm de altura (±15 %).

Falta la prueba final de levitación con las 4 bobinas.
