Brahiam18/controlador-pid-analogico-levitador/informe/Informe_PID_Analogico_Levitador.pdf

Diseno e Implementaci ˜ | on de un Controlador PID ´

# Analogico con Amplificadores Operacionales para ´

un Sistema de Levitacion Electromagn ´ | etica ´

Brahiam Alberto Campino Romero ˜
Programa de Ingeniería Electronica ´ Universidad de Ibagué
Ibague-Tolima, Colombia ´
brahiam.campino@estudiantesunibague.edu.co
Abstract—Se presenta el diseno, el c ˜ | alculo te ´ | orico y la imple- ´
mentacion de un controlador Proporcional-Integral-Derivativo ´ (PID) completamente analogico, construido con amplificadores ´ operacionales, destinado a estabilizar la posicion de un objeto ´
en levitacion mediante fuerza electromagn ´ | etica de atracci ´ | on. El ´
controlador entrega una senal de salida que var ˜ | ía entre 1 V
y 3 V, proporcional al estado de correccion requerido por el ´ sistema. Se justifica la eleccion del PID frente a alternativas de ´
control mas simples, se derivan las ecuaciones de dise ´ | no de cada ˜
etapa (diferenciador de error, proporcional, integral con anti-windup, derivativo y sumador), y se documentan las correcciones realizadas durante la etapa experimental, entre ellas la saturacion´ del integrador y del sumador, y el efecto de carga observado en los divisores resistivos utilizados para generar los voltajes de referencia y de offset. Los resultados teoricos se contrastan con ´ las mediciones obtenidas sobre el circuito implementado. Index Terms—control PID analogico, amplificador operacional, ´
levitacion magn ´ | etica, anti-windup, control de posici ´ | on, LM741 ´
I. INTRODUCCION Y ´ | JUSTIFICACION DEL ´ | CONTROLADOR
Un sistema de levitacion electromagn ´ | etica por atracci ´ | on´
es, por naturaleza, un sistema inestable en lazo abierto: la
fuerza de atraccion entre el electroim ´ | an y el objeto aumenta ´
al disminuir la distancia entre ambos, de modo que cualquier desviacion respecto al punto de equilibrio tiende a crecer ´ en lugar de corregirse por sí sola. Este comportamiento está respaldado por el teorema de Earnshaw [1], que demuestra que ninguna configuracion est ´ atica de imanes puede sostener ´ un cuerpo en equilibrio estable sin control activo.
Antes de seleccionar la estrategia de control se evaluaron las siguientes alternativas:
- Control todo-o-nada: produce una fuerza discontinua, generando oscilaciones bruscas incompatibles con un posicionamiento fino y continuo.
- Proporcional (P) puro: reacciona de forma instantanea ´ al error, pero al no tener memoria del pasado, su salida es nula en el punto de equilibrio exacto (error nulo), dejando un error de estado estable permanente.
- Proporcional-Derivativo (PD): anade amortiguamiento ˜ y mejora la estabilidad dinamica, pero conserva el error ´ de estado estable al carecer de accion integral. ´
- Proporcional-Integral-Derivativo (PID): combina los tres efectos de forma paralela. El termino proporcional ´ corrige el error instantaneo, el integral elimina el error de ´ estado estable acumulando el historial reciente del error, y el derivativo introduce el amortiguamiento que el sistema no posee de forma natural, al no existir friccion mec ´ anica ´ real en un sistema sin contacto.

Matematicamente, el controlador PID se expresa como la ´ suma de tres terminos independientes: ´

u(t) = Kp e(t) + Ki

Z t

0

e(τ ) dτ + Kd

de(t)
dt | (1)

Es fundamental resaltar que los tres terminos se implemen- ´ tan en configuracion´ paralela y no en cascada: la definicion´
matematica del PID es una suma, y una conexi ´ | on en serie ´
alteraría la funcion de transferencia resultante, acoplando las ´ ganancias Kp, Ki y Kd entre sí e impidiendo su ajuste independiente.
II. MARCO TEORICO DE ´ | CADA ETAPA

La nomenclatura de referencia utilizada en esta seccion´ corresponde a la Tabla II.

A. Amplificador diferenciador de error

Compara el voltaje del sensor de posicion ( ´ Vsensor) contra el voltaje de referencia (Vref ). Con R1 = R3 y R2 = R4:

Ve =

R2
R1
(Vref − Vsensor) | (2)

Ve alimenta en paralelo a las ramas P, I y D.

B. Etapa Proporcional (P)

Amplificador inversor simple, sin memoria:

VP (t) = −Kp Ve(t) = −

P ot1
R5
Ve(t) | (3)

Por sí sola deja un error de estado estable, pues su salida es nula cuando el error es nulo.

C. Etapa Integral (I)

Acumula el historial del error, eliminando el error de estado estable que deja P:

VI (t) = −

1
RiCi

Z
Ve(t) dt | (4)

Un integrador ideal posee memoria infinita, lo que provoca saturacion ( ´ windup) ante cualquier offset residual del amplificador operacional. Se incorpora una resistencia de fuga R6 en paralelo con Ci
, acotando la ganancia en continua a un valor finito y dotando al integrador de una memoria efectiva finita τ = R6Ci
:

GDC,max =

R11
P ot2

, faw =

1
2πR11Ci

(5)

D. Etapa Derivativa (D)

Responde a la velocidad de cambio del error, aportando el amortiguamiento que el sistema no posee de forma natural:

VD(t) = −P ot3 C2

dVe(t)
dt | (6)

Se agrega una resistencia R7 en serie con C2 para limitar la ganancia a alta frecuencia y no amplificar ruido:

Gmax =

P ot3
R6

, fc =

1
2πR6C2

(7)

Esta etapa opera normalmente en el rango de milivoltios y no de voltios, ya que su salida depende de que tan r ´ apido cambia ´ el error (de/dt) y no de su magnitud. Dado que la posicion del ´ objeto varía de forma mecanica —relativamente lenta frente ´
a la respuesta electrica del circuito— ´ | de/dt es pequena la ˜
mayor parte del tiempo, y VD solo alcanza el rango de voltios durante una perturbacion brusca. El voltaje residual de pocos ´ milivoltios observado en reposo corresponde principalmente al offset de entrada propio del amplificador operacional (1 a 6 mV típico en el LM741), no a una derivada real distinta de cero.
E. Etapa Sumadora

Combina VP , VI , VD y el offset Vof f :

VP ID = −

R10
R7

VP +

R10
R8

VI +

R10
R9

VD +

R10

Rof f set

Vof f

(8)
Es la salida final del controlador, con rango de operacion´ objetivo entre 1 V y 3 V.
F. Generacion de ´ Vref y Vof f

Para evitar fuentes adicionales, Vref y Vof f se generan desde una unica fuente mediante divisores resistivos. Un ´ divisor cargado por la etapa siguiente entrega un voltaje distinto al calculado (efecto de carga); por ello cada divisor se desacopla con un amplificador operacional en configuracion´ de seguidor de voltaje (buffer no inversor, ganancia unitaria), de alta impedancia de entrada y baja impedancia de salida, que preserva el voltaje calculado sin alterarlo.

III. CALCULOS DE ´ | DISENÕ
Esta seccion presenta la derivaci ´ | on completa de cada etapa a ´
partir del analisis nodal del amplificador operacional (corriente ´ de entrada nula, corto virtual entre sus terminales).
A. Diferenciador de error
Con R1 = R3, R2 = R4, corto virtual (V

− = V
+) y
I1 = I2:

I1 =

V1 − V

+
R1
| = I2 = V + − Vout
R2

(9)

−

Vout
R2

=

V1
R1

− V

+

| 1 R1 +
| 1 R2
(10)

Vout =

1 +

R2
R1
V

+ − V1

R2
R1

(11)

Sustituyendo el divisor de la rama no inversora, V

+ =

V2

R2
R1 + R2

, y simplificando:

Vout =

R2
R1

(V1 − V2) = R2
R1
Vs | , | Av =

R2
R1

(12)

Diseno: ˜ se propone una ganancia unitaria para obtener la diferencia sin alterar las magnitudes de entrada:

Av = 1, | R1 = 10 kΩ, | VCC > Vout, | Vref = 2 V
(13)
Condiciones de voltajes maximos, medios y m ´ | ínimos:
Vout,max = (5V − 2V) = | 3 V | (14)
Vout,min = (0V − 2V) = | −2 V | (15)
Vout,mid = (2V − 2V) = | 0 V | (16)

Despeje de R2:
R2 = Av · R1 | (17)

Con VCC,general = 16 V, los valores finales de diseno son: ˜

Av = 1, | R1 = 10 kΩ, | R2 = 10 kΩ, | VCC = ±16 V
(18)
Ecuacion final: ´
Vout = (Vsensor − Vref ) | (19)
B. Etapa Proporcional (P)
Con V

− = 0 (entrada no inversora a tierra) e I1 = I2:

Vout1
R5

= −

Vout2
P ot1

⇒ Av =

P ot1
R5

(20)

Diseno: ˜ con R5 = 10 kΩ y Vout,max = 3 V como referencia de prueba:
P ot1 = Kp · R5 | (21)

Valores evaluados: Kp = 1 ⇒ P ot1 = 10 kΩ; Kp = 2 ⇒ P ot1 = 20 kΩ. El potenciometro se dispuso para variar de ´ 10 kΩ a 20 kΩ segun el punto de ajuste deseado. ´

C. Etapa Integral (I)
Eleccion de ´ | faw: se parte de la dinamica reportada en ´
la literatura de referencia (oscilaciones entre 2 y 5 Hz [2]), ubicando faw con margen amplio por debajo de dicho rango:
faw = 0.2 Hz, | Ci = 1 µF | (22)

R11 =

1
2π (0.2)(1µF)
| ≈ 800 kΩ | (23)

Constante de integracion: ´

Ki =

1
RiCi

= 10 s

−1 ⇒ P ot2 =

| 1
(1µF)(10) = 10 kΩ
| | (24)
Derivacion por Laplace (integrador ideal), condiciones ´ iniciales nulas:

Vout(s) = −

1
P ot2 Ci

·

Ve(s)
s

, H(s) = −

1
P ot2 Ci s
| | (25)

Sustituyendo s = j2πf y tomando magnitud:

|H(jω)| =

| 1
2π P ot2 f Ci
| | (26)

Integrador con fuga (R6 ∥ Ci
, topología correcta tras la
correccion descrita en la Secci ´ | on IV): ´

Zf (s) = R11 ∥

1

sCi | = R11 1 + sR11Ci | (27)

|H(jω)| = p

| R11/P ot2
| 1 + (f /faw)
| 2 | (28)

Evaluando en f = 0 se obtiene la ganancia maxima en ´ continua:

Ki,max =

R11/P ot2
√
1 + 0

=

R11
P ot2

=

1M
12.5k
= | 80 | (29)
D. Etapa Derivativa (D)
Limitacion de ganancia en alta frecuencia: ´ | dado que
ZC = 1/(2πfC) → 0 a alta frecuencia, un diferenciador puro amplificaría el ruido sin límite. R7 fija un piso mínimo de impedancia:
R7 ≤

1
2πfcC2

(30)

Eleccion de ´ fd (frecuencia de corte, termino medio entre la ´ dinamica del sistema y el ruido de alta frecuencia, valor de ´ prueba):
fd = 150 Hz, | C2 = 1 µF | (31)

R7 =

1
2π(150)(1µF)
= 1.06 kΩ ≈ | 1 kΩ | (32)

Ganancia:
Kd =

P ot3
R6

(33)

Con Kd = 21 como punto de diseno: ˜

P ot3 = Kd ·R6 = 21×1k = 21 kΩ ≈ | 22 kΩ | (Kd,max = 22)
(34)
E. Etapa Sumadora
Condiciones de partida (op-amp ideal): Iin = 0, corto virtual entre terminales. Criterio de diseno: se busca ganancia ˜ unitaria por rama para no alterar los valores de Kp, Ki y Kd ya calculados; las resistencias no deben ser demasiado altas (acoplan ruido) ni demasiado bajas (cargan la salida del operacional anterior).
Con R8 = R9 = R10 = R7 kΩ (entradas y realimentacion´
iguales, Avs = 1), el analisis nodal en el nodo inversor ( ´ | V

−,
corto virtual con V

+ = 0), incluyendo la rama de offset, da:

V

− − 0

Req

=

0 − Vout

R10

| (35)

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
Vout

R10

| (36)

Con ganancia unitaria por rama (R10 = R8 = R9 = R7 =

Rof f set):

Vout = R10
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
(37)
Vout = VP + VI + VD | (38)
Resistencia de compensacion de bias ´ | en la entrada no
inversora:
Rbias = R8 ∥ R9 ∥ R7 = 10k ∥ 10k ∥ 10k = | 3.3 kΩ | (39)
F. Divisores de Vof f y Vref
Divisor de Vof f (VCC = 16 V, R15 = 160 kΩ fijo, objetivo Vout = 10 V antes del buffer):

Vout = VCC ·

R15

R15 + R14

⇒ R14 =

VCC R15

Vout

− R15 (40)

R14 =

(16)(160k)
10
− 160k = | 96 kΩ | (41)

Divisor de Vref (R13 = 160 kΩ fijo, objetivo Vout = 2 V):

R12 =

VCC R13

Vout

− R13 | (42)

R12 =

(16)(160k)
2
− 160k = | 1.12 MΩ | (43)
Nota de verificacion: en el desarrollo a mano de esta etapa se registr ´ | ó
VCC = 5 V para el divisor de Vref , lo que da R12 =

(5)(160k)
2 −
160k = 240 kΩ. Confirmar con el montaje físico cual de las dos fuentes ´ (5 V dedicada o 16 V compartida) alimenta realmente esta rama antes de fijar el valor definitivo de R12.

IV. AJUSTES REALIZADOS DURANTE LAS PRUEBAS

A. Saturacion de la etapa sumadora ´
Al evaluar la salida del controlador con un error cercano
al maximo esperado, se observ ´ | o que la salida del sumador ´
tendía a saturarse contra los rieles de alimentacion por su alta ´ ganancia (la cual era de 23.24v) cuando su alimentacion max ´ es de 18v. Para solucionarlo se bajo la ganancia unitaria del sumador por una de 0.1 veces en todas las ramas para no afectar a los datos de control, ademas se bajo la ganancia ´

propuesta anteriormente de P para acercarse mas a los valores requeridos.
Ajuste del rango de salida (1 V a 3 V): con las ganancias
iniciales de diseno, se eval ˜ | ua el error m ´ | ínimo y maximo del ´
sistema:
Verror,min = 0 + 0 + 0 ≈ 0 V | (44)

Verror,max = 9.90+13.5+3.24×10⁻³ = 23.24 V (excesivo)
| | | (45)
Se corrige bajando la ganancia del sumador de 1 a 0.1 (resistencia de realimentacion´ R12 de 10 kΩ a 1 kΩ):

Vout,max =

1k
10k
(9.9) + 1k
| 10k (13.3)

+

1k
10k
| (3 × 10⁻³
) + 1
10k
(10) = 3.34 V
| | | (46)

Se agrega el voltaje de offset para fijar el piso en 1 V:

Vout,min =

| 1k 10k
(0) + 1k
| 10k

(0)
| + 1k 10k
(0) + 1
| 10k
(10) = | 1 V
| | | (47)

Finalmente se reduce Kp de 3 a Kp = 2.2 (P ot1 = 22 kΩ) para que el valor maximo converja exactamente a 3 V: ´

Vout,max =

1k
10k
(6.6) + 1k
| 10k (13.3)

+

1k
10k
| (3 × 10⁻³
) + 1
| 10k
(10) = | 3.02 V
| | | (48)

Ecuacion del sumador modificada.

−

VP R7 − | VI R8 − VD R9 − Vof f

Rof f set

| | = − Vout R10 | (49)

Con ganancia unitaria por rama (R10 = R8 = R9 = R7 =

Rof f set):

Vout = R10
| VP R10 + VI R10
+
| | VD R10 + Vof f R10 | (50)

Nueva Rbias.

Rbias = R8 ∥ R9 ∥ R7 ∥ Rof f set = 10k ∥ 10k ∥ 10k ∥ 10k = | 4.4 kΩ
| | | (51)


B. Saturacion y correcci ´ | on de topolog ´ | ía de la etapa integral
En una primera implementacion, la resistencia de anti- ´ windup se conectó en serie con el capacitor de integracion, ´ en lugar de en paralelo. Esta configuracion deja la rama ´ de realimentacion en circuito abierto en corriente continua ´ (el capacitor en serie bloquea el paso de DC), dejando al amplificador operacional sin una realimentacion negativa bien ´ definida en ese regimen y produciendo un comportamiento ´ dominado por el desbalance interno del propio amplificador,
en lugar de la funcion de integraci ´ | on esperada. Al corregir ´
la conexion a su posici ´ | on correcta ( ´ | R11 ∥ Ci), el circuito
recupero el comportamiento esperado: salida nula para error ´ nulo y respuesta en rampa ante un escalon de error sostenido. ´ Adicionalmente, se verifico que una ganancia en continua ´ desproporcionadamente alta respecto a Kp saturaba la etapa integral ante errores muy por debajo del rango real de op-
eracion, lo que llev ´ | o a reconsiderar el valor te ´ | orico de dise ´ | nõ
(R11 = 1 MΩ, ganancia DC de 80) y a recalcular con un punto de operacion distinto, obtenido durante las pruebas: ´
Ki = 4.5, | Ci = 1 µF, | faw = 0.2 Hz | (52)

Ki =

1
Ri
- Ci

Ki,max =

R11
P ot2

(53)

4.5 =

1
(1 µF) · P ot2

⇒ P ot2 =

1
(1 µF)(4.5) = | 220 kΩ
| (54)
Con R11 = 1 MΩ, se verifica la ganancia maxima resultante: ´

Kmax =

1M
220k
⇒ | Kmax = 4.5 | (55)
C. Efecto de carga en los divisores resistivos

Se verifico experimentalmente que los divisores resistivos ´
disenados para ˜ | Vref y Vof f no entregaban el voltaje teorico ´
calculado al conectarse a la etapa siguiente: el voltaje medido variaba y disminuía bajo carga. Este comportamiento corresponde al efecto de carga de un divisor resistivo, que solo entrega el voltaje calculado con precision cuando la ´ resistencia de la etapa siguiente es considerablemente mayor que las resistencias del propio divisor. La solucion aplicada ´ fue intercalar un amplificador operacional en configuracion de ´ seguidor de voltaje (buffer no inversor, ganancia unitaria) entre cada divisor y la etapa que utiliza esa referencia, aprovechando la alta impedancia de entrada del operacional para no cargar el divisor.
V. RESULTADOS EXPERIMENTALES
A. Montaje y pruebas

Fig. 1: Esquematico a mano del controlador PID com- ´ pleto(puede verlo mas grande en los anexos).

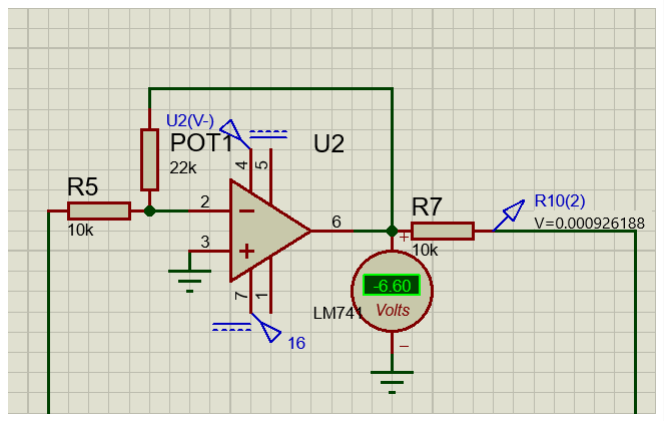
[picture p41: figure]

Fig. 2: Esquematico en Proteus inversor. ´

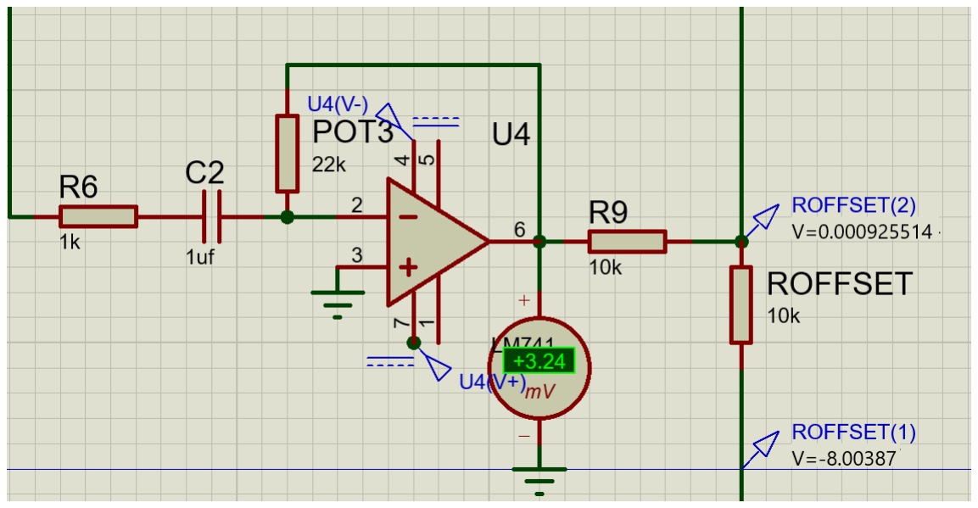
[picture p42: figure]

Fig. 3: Esquematico en Proteus integrador. ´

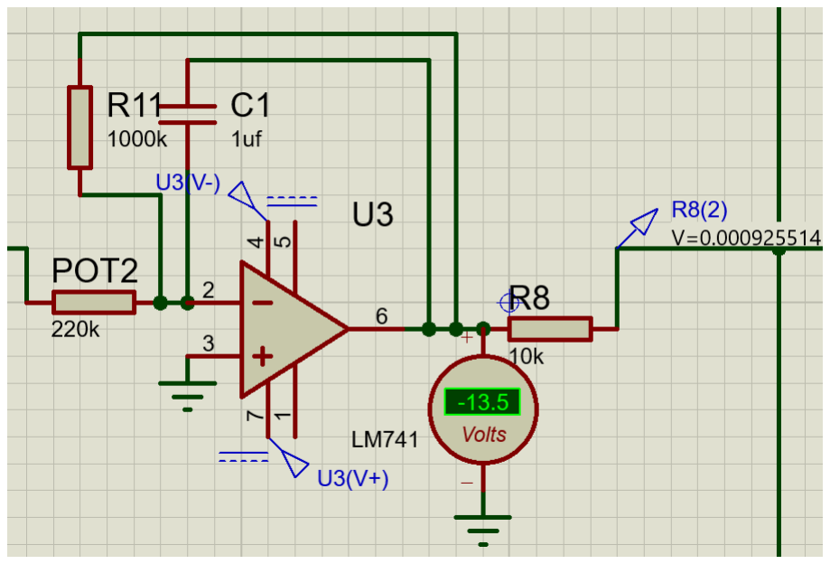
[picture p43: figure]

Fig. 4: Esquematico en Proteus derivador. ´


Fig. 5: Esquematico en Proteus diferenciador. ´


Fig. 6: Esquematico en Proteus sumador. ´

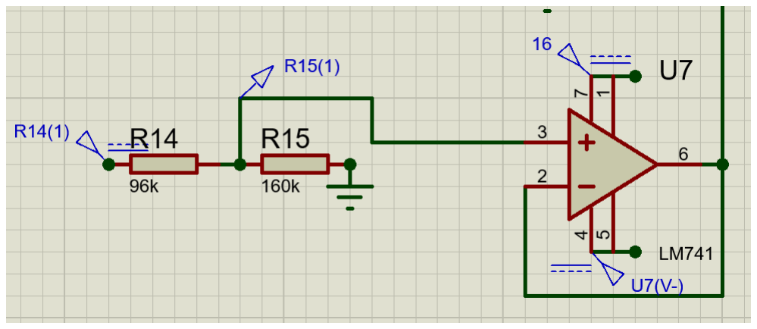
[picture p44: figure]

Fig. 7: Esquematico en Proteus del controlador PID completo. ´


Fig. 8: Esquematico en Proteus del controlador PID completo. ´

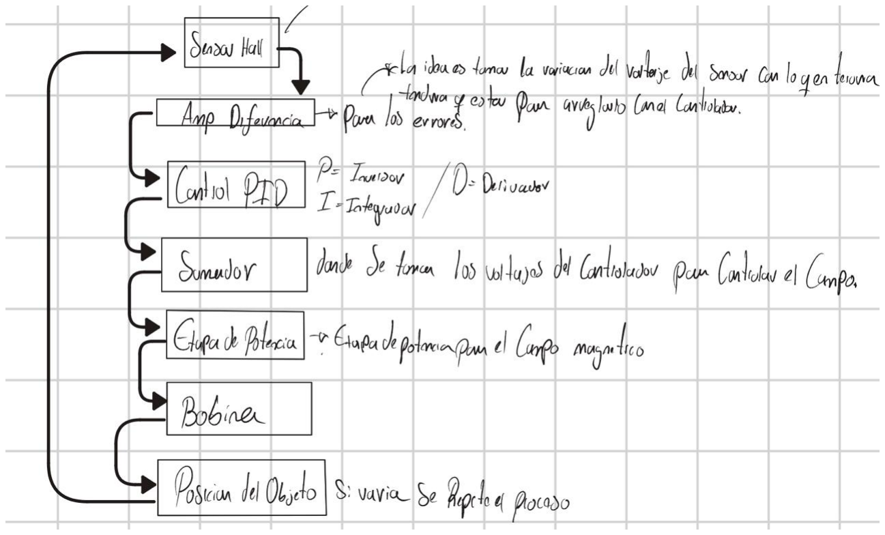
[picture p45: figure]

Fig. 9: Esquematico diagrama de bloques. ´


Fig. 10: Montaje físico del controlador PID: fuente de alimentacion de ´ ±16 V, osciloscopio, multímetro y protoboard.


Fig. 11: Circuito del controlador PID armado en protoboard con los siete amplificadores LM741.


Fig. 12: Toma de voltaje practico con mult ´ | ímetro a la salida
del diferenciador de error: 2.99 V para el error maximo. ´
B. Comparacion de voltajes te ´ | oricos y pr ´ | acticos ´
La Tabla I resume, para cada etapa, el voltaje de entrada y de salida medido experimentalmente frente al valor teorico ´ calculado, evaluado para error mínimo, medio y maximo. ´

TABLE I: Comparacion de voltajes te ´ | oricos y pr ´ | acticos por etapa ´
Etapa | Teorico (V) | Pr ´ | actico (V) ´
mín. | medio | max. | m ´ | ín. | medio | max. ´
Diferenciador | −2 | 0 | 3 | −2.02 | 0 | 2.99
Proporcional (P) | 4.38 | −0.01 | −6.6 | 4.46 | −0.15 | −6.6
Integral (I) | 9.14 | 0.07 | −13.5 | 6.22 | −0.32 | −13.22
Derivativo (D) | −3.24 mV | −3.24 mV | −3.3 mV | 3 mV | 3 mV | 172 mV
Sumador | −0.35 | 1 | 3.01 | −0.04 | 1 | 2.96
Divisor Vref | 2 | 2 | 2 | 2 | 2 | 2
Divisor Voff | −10.1 | −10.1 | −10.1 | −10.21 | −10.21 | −10.21

VI. LISTA DE COMPONENTES

TABLE II: Nomenclatura general del circuito

Ref. Descripcion´

Diferenciador de error
R1 | Entrada Vsensor (rama inversora)
Rf1 | Realimentacion del diferenciador ´
R3 | Entrada Vref (rama no inversora)
R4 | A GND (rama no inversora)
U1 | LM741 — Diferenciador de error

Proporcional (P)
R5 | Entrada fija (10 kΩ)
P ot1 | Potenciometro de realimentaci ´ | on, ajusta ´ | Kp
U2 | LM741 — Etapa Proporcional

Integral (I)
P ot2 | Potenciometro de entrada, ajusta ´ | | Ki (Ri)
Ci | Capacitor de integracion ( ´ | 1 µF)
R6 | Resistencia de fuga (anti-windup), en paralelo con Ci
U3 | LM741 — Etapa Integral

Derivativa (D)
C2 | Capacitor de entrada (1 µF)
R7 | En serie con C2, limita ganancia en alta frecuencia
P ot3 | Potenciometro de realimentaci ´ | on, ajusta ´ | Kd
U4 | LM741 — Etapa Derivativa

Sumador
R8 | Entrada desde VP
R9 | Entrada desde VI
R10 | Entrada desde VD
R11 | Entrada desde Voff
R12 | Realimentacion del sumador ´
U5 | LM741 — Sumador

Divisor + buffer de Vref
R13 | Divisor — resistencia superior
R14 | Divisor — resistencia inferior
U6 | LM741 — Buffer no inversor

Divisor + buffer de Voff
R15 | Divisor — resistencia superior
R16 | Divisor — resistencia inferior
P ot4 | Ajuste fino del offset
U7 | LM741 — Buffer no inversor

TABLE III: Valores teoricos y finales ajustados ´

Ref. | Teorico | Final (ajustado) | Obs. ´
R1 | 10 kΩ | 10 kΩ
R2 | 10 kΩ | 10 kΩ
R3 | 10 kΩ | 10 kΩ
R4 | 10 kΩ | 10 kΩ
R5 | 10 kΩ | 10 kΩ
P ot1 | 33 kΩ | 22 kΩ | Kp = 2.2
P ot2 | 12.5 kΩ | 220 kΩ | Ki (ajustado)
Ci (C1) | 1 µF | 1 µF
R6 | 1 kΩ | 1 kΩ
C2 | 1 µF | 1 µF
R7 | 10 kΩ | 10 kΩ
P ot3 | 22 kΩ | 22 kΩ | Kd = 22
R8 | 10 kΩ | 10 kΩ | Entrada VP (sumador)
R9 | 10 kΩ | 10 kΩ | Entrada VI (sumador)
R10 | 10 kΩ | 1 kΩ | Entrada VD (sumador)
R11 | 1 MΩ | 1 MΩ | Ki,max = 4.5 (fuga/anti-windup)
R12 | 160 kΩ | 160 kΩ | Divisor Vref (fija)
R13 | 240 kΩ | 240 kΩ | Divisor Vref (VCC = 5 V)
R14 | 96 kΩ | falta medir | Divisor Voff (calculada)
R15 | 160 kΩ | 160 kΩ | Divisor Voff (fija)
Roffset | 10 kΩ | 10 kΩ | Entrada Voff (sumador)

VII. CONCLUSIONES

A. Sobre la arquitectura de control
El controlador PID en configuracion paralela permiti ´ | ó
cubrir, con un solo circuito, las tres necesidades dinamicas ´
del sistema: correccion proporcional al error instant ´ | aneo (P), ´
eliminacion del error de estado estable mediante acumulaci ´ | on´
del historial reciente de error (I), y amortiguamiento ante
transitorios rapidos (D). La conexi ´ | on en paralelo, y no en ´
cascada, fue indispensable para ajustar Kp, Ki y Kd de forma independiente.
B. Sobre las correcciones de disenõ
La resistencia de anti-windup del integrador debe conectarse en paralelo con el capacitor de integracion, nunca en serie: una ´
conexion en serie deja la rama de realimentaci ´ | on en circuito ´
abierto en continua y el amplificador opera practicamente en ´ lazo abierto. La ganancia en continua del integrador debe
guardar una proporcion razonable frente a ´ | Kp, ya que una
ganancia DC excesiva provoca saturacion ante errores muy por ´ debajo del rango real de operacion. Un divisor de voltaje re- ´ sistivo solo entrega el voltaje calculado cuando la etapa que lo carga presenta una impedancia de entrada considerablemente mayor que las resistencias del propio divisor; este efecto de carga se resolvio con un buffer no inversor en cada divisor. ´ El rango de salida (1 V a 3 V) se logro mediante dos ajustes ´ independientes y secuenciales: la ganancia del sumador, que define el ancho del rango, y el offset, que define su punto de partida.
C. Sobre el comportamiento observado
La etapa derivativa opera en el rango de milivoltios la mayor parte del tiempo, alcanzando el rango de voltios solo durante
transitorios rapidos del error, dado que la din ´ | amica mec ´ | anica ´

del sistema es comparativamente lenta frente a la respuesta electrica del circuito. El offset de entrada de los amplificadores ´ LM741 (1 a 6 mV típico) resulta despreciable frente a las senales de voltios manejadas por P y el sumador, pero se ˜ vuelve relevante al amplificarse por la ganancia en continua del integrador.

D. Efecto de carga en los divisores resistivos

Se verifico experimentalmente que los divisores resistivos ´
disenados para ˜ | Vref y Vof f no entregaban el voltaje teorico ´
calculado al conectarse a la etapa siguiente: el voltaje medido variaba y disminuía bajo carga. Este comportamiento corresponde al efecto de carga de un divisor resistivo, que solo entrega el voltaje calculado con precision cuando la ´ resistencia de la etapa siguiente es considerablemente mayor que las resistencias del propio divisor. La solucion aplicada ´ fue intercalar un amplificador operacional en configuracion de ´ seguidor de voltaje (buffer no inversor, ganancia unitaria) entre cada divisor y la etapa que utiliza esa referencia, aprovechando la alta impedancia de entrada del operacional para no cargar el divisor.
Nota (Algunos cambios practicos e explicaciones mas pro-fundas se encuetran en el apartado IV)
| REFERENCES
[1] S. Earnshaw, “On the nature of the molecular forces which regulate the constitution of the luminiferous ether,” Transactions of the Cambridge Philosophical Society, vol. 7, pp. 97–112, 1842.
[2] P. Berkelman and S. Kang, “Optimization of the Four Coil Configuration for Single Magnet Levitation from Below,” University of Hawaii at Manoa, Honolulu, HI, USA. ¯
[3] Texas Instruments, “LM741 Operational Amplifier,” datasheet.
[4] Honeywell, “SS490 Series / SS495A Linear Hall-Effect Sensor,” datasheet.
[5] STMicroelectronics, “TIP122 — NPN Darlington Power Transistor,” datasheet.

[6] K. Ogata, Modern Control Engineering, 5th ed. Upper Saddle River, NJ, USA: Prentice Hall, 2010.

APPENDIX
| ÍNDICE DE CALCULOS A ´ | MANO
La Tabla IV indexa las imagenes de los c ´ | alculos realizados ´
a mano durante el desarrollo del proyecto, referenciando la etapa a la que corresponde cada una.

TABLE IV: Índice de anexos de imagenes ´

N.° | Descripcion | Etapa ´
1 | Circuito completo simulado en Proteus | Montaje
2 | Circuito armado físicamente (fotografía) | Montaje
3–4 | Derivacion del diferenciador (amplificador ´
| diferencial) | | Diferenciador
5–6 | Derivacion de la etapa inversora / Propor- ´
| cional | | P
7–8 | Derivacion del integrador, Laplace y anti- ´
| windup | | I
9–10 | Derivacion del derivador y filtro en alta ´
| frecuencia | | D
11 | Derivacion del sumador y ´ | Rbias | Sumador
12 | Calculos de los divisores de ´ | Vref y Voff | Offset/Ref.
13 | Ajuste de ganancias del sumador por sat-
| uracion y offset ´ | | Sumador
14–19 | Tomas de voltajes practicos por etapa (6 ´
| imagenes) ´ | | Resultados


Fig. 13: Esquematico de proteous.

Fig. 14: Esquematico hecho a mano.


Fig. 15: Calculos diferenciador (1). ´


Fig. 16: Calculos diferenciador (2). ´


Fig. 17: Calculos inversor (1). ´


Fig. 18: Calculos inversor (2). ´


Fig. 19: Calculos integrador (1). ´


Fig. 20: Calculos integrador (2). ´


Fig. 21: Calculos Derivador (1). ´


Fig. 22: Calculos Derivador (2). ´


Fig. 23: Calculos Sumador. ´


Fig. 24: Calculos divisor Voffset y Vref. ´

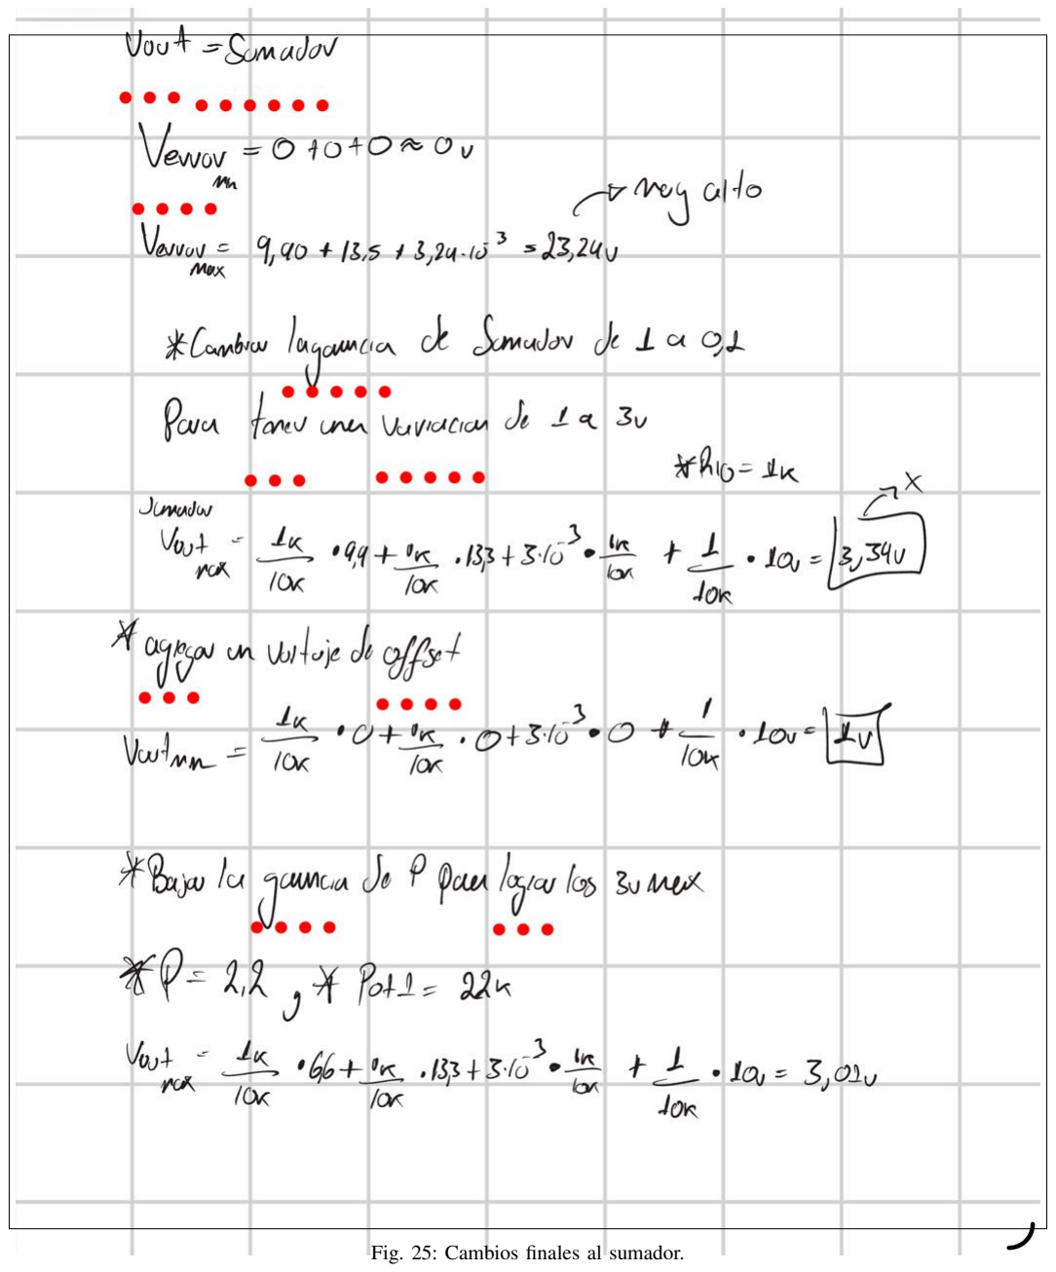
[picture p46: page 23]

Fig. 25: Cambios finales al sumador.
