Brahiam18/controlador-pid-analogico-levitador/fuente/informe/Informe_Fuente_Alimentacion.pdf

Diseno de una Fuente de Alimentaci ˜ | on Lineal ´

# Regulada de ±16 V / 1,5 A y +5 V con Proteccion´ Foldback para los Controladores PID Analogicos de ´ un Levitador Magnetico ´

Brahiam Alberto Campino Romero ˜
Programa de Ingeniería Electronica ´ Universidad de Ibagué
Ibague-Tolima, Colombia ´
brahiam.campino@estudiantesunibague.edu.co

Resumen—Se disena, simula y lleva a placa una fuente lineal ˜ que entrega +16 V y −16 V, cada una capaz de 1,5 A, y +5 V, para alimentar los cuatro controladores PID analogicos ´ de un levitador magnetico y para demostrar la corriente de ´
especificacion sobre una carga de prueba removible. El m ´ | etodo ´
es el del tema 3 de la monografía Electronica Tomo II ´ | [1]:
transformador, rectificador, filtro y regulador, con regulacion´ de línea, regulacion de carga, factor de rizado y protecciones. ´ Como los reguladores LM317 y LM337 no podían cambiarse, su capacidad se amplía con un transistor de potencia (Fig. 3-

### 21 de la monografía), de modo que el integrado conduzca solo

una cuarta parte de la corriente. Antes de cada regulador hay un limitador de corriente con transistor Darlington y proteccion´ foldback (Figs. 3-26 y 3-27): limita a unos 2,4 A en sobrecarga y reduce la corriente de cortocircuito a 0,3–0,9 A segun la red, ´ y esta ajustado para que la carga de prueba no lo deje trabado ´ al arrancar. Un transformador de 18-0-18 V / 5 A con puente rectificador alimenta los dos rieles, y se reutilizan capacitores de 15 000 µF y 2 × 6800 µF. La simulacion en ngspice muestra ´ salidas de ±15,98 V con 1,6 A, regulacion de carga del 0,08 %, ´ rizado de salida de 0,1 mVpp, regulacion aun con la red al ´
−10 %, y recuperacion autom ´ | atica tras cortocircuitos sostenidos. ´
La validacion en Proteus llev ´ | o a dos ajustes (versi ´ | on 2.1): el ´
divisor de foldback paso de 270 a ´ | | 330 Ω y el transformador de 3
a 5 A. Se entregan los esquematicos, los archivos EAGLE/Fusion ´ de una placa de una cara de 190 × 140 mm con pistas a 45°, la lista de materiales y el plan de pruebas.
Palabras clave—fuente lineal, LM317, LM337, ampliacion de ´ corriente, foldback, limitador de corriente, puente rectificador,
regulacion de carga, levitaci ´ | on magn ´ | etica ´
I. INTRODUCCION´

El levitador magnetico del proyecto usa cuatro controladores ´
PID analogicos id ´ | enticos, uno por bobina. Cada uno tiene dos ´
TL074CN, un sensor Hall SS495A y un divisor que genera la referencia Vref = 2 V a partir de +5 V [2]. Los amplificadores se alimentan con ±16 V, el divisor y los sensores con +5 V, y las bobinas con una fuente aparte, cuyo negativo (PGND) se une a la tierra de senal en un solo punto. ˜
La primera version de esta fuente se dimension ´ | o solo para ´
los operacionales: 0,27 A por riel con el transformador M509
disponible. Despues se agreg ´ | o una especificaci ´ | on: la fuente ´

debe entregar 1,5 A en los rieles de ±16 V sobre una carga de prueba que pueda conectarse y desconectarse, para medir con y sin carga. Ademas, deb ´ ía conservar las protecciones y usar los mismos reguladores LM317 y LM337, porque no había tiempo para conseguir otros. Este informe documenta el
diseno definitivo (versi ˜ | on 2.1, ajustada tras la validaci ´ | on en ´
Proteus) y explica que cambi ´ | o y por qu ´ | e.´
Todos los archivos (calculos, simulaciones en ngspice y ´ Proteus, esquematicos, placa, lista de materiales y pruebas) ´ estan en el repositorio https://github.com/Brahiam18/Fuente-1 (https://github.com/Brahiam18/Fuente-1.6A--16v-5v-con-anti-corto-en-solo-un-fuente-a-la-vez-carga-y-sin-carga) ´ .6A--16v-5v-con-anti-corto-en-solo-un-fuente-a-la-vez-carga -y-sin-carga. (https://github.com/Brahiam18/Fuente-1.6A--16v-5v-con-anti-corto-en-solo-un-fuente-a-la-vez-carga-y-sin-carga)
El metodo es el del tema 3 de la monograf ´ | ía [1]. La
fuente se divide en los bloques de su Fig. 3-1: transformador, rectificador, filtro y regulador. Los parametros se definen como ´
allí: voltaje y corriente de salida, regulacion de l ´ | ínea ante
±10 %, regulacion de carga, factor de rizado y coeficiente de ´
temperatura. Las topologías y los criterios de diseno tambi ˜ | en´
son los de la monografía.

II. OBJETIVOS

A. Objetivo general
Disenar una fuente lineal regulada de ˜ | ±16 V / 1,5 A y
+5 V, con proteccion contra cortocircuito, que alimente los ´ cuatro controladores PID del levitador y permita demostrar la corriente de especificacion sobre una carga removible, ´
siguiendo el metodo de la monograf ´ | ía Electronica Tomo II ´ | .
B. Objetivos específicos
- Dimensionar el transformador, el rectificador y el filtro para 1,5 A, reutilizando los capacitores disponibles.
- Ampliar la corriente de los reguladores LM317/LM337 sin reemplazarlos.
- Disenar una protecci ˜ | on contra cortocircuito que soporte ´
un corto sostenido y que no se trabe al arrancar con la carga de prueba.
- Dimensionar disipadores y fusibles.

- Comprobar el diseno por simulaci ˜ | on: r ´ | egimen, l ´ | ínea,
carga, cortocircuito, arranque y curva V–I.
- Entregar la placa, la lista de materiales y el plan de pruebas.

III. ESPECIFICACIONES

A. Corrientes

Los cuatro PID consumen hasta 200 mA en cada riel de ±16 V (50 mA por PID, con margen [9]). La rama de +5 V consume 57 mA: cuatro sensores de 10 mA [10], los divisores, la red de ajuste de su regulador y un LED. La especificacion de ´ 1,5 A se comprueba con una resistencia externa RL = 10 Ω en la bornera J4 (+16 V) o J5 (−16 V), que da 16/10 = 1,6 A. A esa corriente se suma el consumo interno de cada riel (red de ajuste, LED y, en +16 V, la rama de +5 V):

IL(+16) = 1,6 + 0,017 + 0,057 = 1,674 A, | (1)
IL(−16) = 1,6 + 0,017 = 1,617 A. | (2)

La carga de 1,5 A se prueba en un riel a la vez, y con eso se dimensiona el transformador.

TABLA I: Especificaciones de la fuente (version 2.1) ´

Parametro | +16 V ´ | −16 V | +5 V
Ajuste de salida | ±15 a ±17 V | 4,7 a 5,2 V
Corriente nominal | 1,5 A (RL) | 1,5 A (RL) | 57 mA
Límite en sobrecarga | ≈2,4 A | ≈90 mA
Corriente de corto | 0,3–0,9 A (foldback) | 0,145 A
Regulacion de carga ´ | ≤0,5 %
Regulacion de l ´ | ínea (±10 %) | ≤0,2 % de Vout
Rizado de salida | <1 mVpp
Entrada | 120 Vrms ±10 %, 60 Hz

IV. MARCO TEORICO ´

A. Parametros de la fuente ´

La fuente regulada (Fig. 3-1 de [1]) esta formada por ´ transformador, rectificador, filtro y regulador. La monografía la caracteriza con cuatro parametros: voltaje y corriente de salida, ´
regulacion (de l ´ | ínea, ante ±10 % de Vin, y de carga), factor
de rizado Fr = Vr(rms)/VDC y coeficiente de temperatura. La regulacion de carga se define como ´

% Regulacion´ =

# |Vro| − |Vr|

|Vr|

× 100 %, | (3)

con Vro la salida en vacío y Vr a plena carga.

B. Regulador ajustable

El LM317 mantiene VA = 1,25 V entre OUT y ADJ, y por ADJ sale una corriente IQ ≈ 50 µA [3]. Con R1 entre OUT y ADJ y R2 de ADJ a tierra (ec. (3.19) de [1]):

Vout = VA

1 +

R2
R1
+ IQR2. | (4)

El LM337 es su complemento negativo [4].

C. Ampliacion de corriente ´
La monografía amplía la corriente de un regulador integrado con un transistor de paso PNP (Fig. 3-21). La corriente de entrada del regulador, IU , pasa por una resistencia R conectada entre la base y el emisor del transistor. Cuando IU R llega a VBE, el transistor conduce y aporta la corriente que falta:

IL = IC1 + IU , R =

VBE
IU − IB
. | (5)
El regulador sigue fijando la tension de salida, y la monograf ´ | ía
recomienda que IU sea menor que el 50 % de la corriente maxima del regulador. ´
D. Limitacion de corriente y foldback ´
En el limitador con transistor (Figs. 3-24b y 3-26), la corriente pasa por RSC , conectada entre la base y el emisor de un transistor sensor. Cuando IRSC ≥ VBE, el sensor le quita la corriente de base al transistor de paso:

RSC =

VBE

IL(max)

. | (6)

En un corto sostenido, el transistor de paso disipa VinIL(max) .
El limitador foldback (Fig. 3-27) suma al sensor una fraccion´
k de una tension que cae cuando la salida colapsa. As ´ | í la
corriente de corto ISC queda por debajo de la corriente maxima ´ IF B (ecs. (3.33)–(3.35)):

ISC =

VBE
kRSC
, | IF B = ISC +

(1 − k)Vout
kRSC

. (7)

V. DISENO PASO A PASO ˜
A. Historial de versiones
La Tabla II resume la evolucion del dise ´ | no. ˜
- Version 1. ´ | Solo alimentaba los operacionales. Con el
M509 (9-6-0-6-9 V / 2 A) usaba el devanado completo de 18 V con dos rectificadores de media onda, limitadores de 0,39 y 0,32 A y capacitores de 3300 µF. Estos se cambiaron luego por 6800 µF, que ya se tenían.
- Version 2. ´ Al pedirse 1,5 A, el M509 ya no alcanzaba: con media onda, su secundario habría conducido unos 3,6 A eficaces, casi el doble de su capacidad. Ademas, el ´ LM317 solo a 1,5 A estaría en su límite y no habría disipador capaz de mantenerlo frío. Se especifico un ´ transformador de 18-0-18 V / 3 A y se paso a onda ´ completa. Los capacitores disponibles se reutilizaron: el de 15 000 µF en el riel positivo y los dos de 6800 µF en paralelo en el negativo. Se agregaron la ampliacion´ de corriente y el limitador con foldback. El regulador de +5 V no cambio.´
- Version 2.1. ´ | La simulacion en Proteus (Secci ´ | on VIII) ´
mostro dos ajustes necesarios. (a) Con el transformador ´ de 3 A y la red al −10 %, la salida con RL caía a 14,6 V: la resistencia de su devanado le quitaba el poco margen que había. Con uno de 5 A, de menor resistencia, regula.
(b) El sensor Q3 del modelo de Proteus conduce con ≈ 0,8 V en vez de 0,7 V, y la corriente de corto con la red baja subía a 1,26 A (≈ 23 W en Q1). Con R5 =

R13 = 330 Ω el foldback es mas fuerte, la corriente de ´ corto baja a 0,3–0,9 A y la fuente sigue sin trabarse con
RL. Ademas, ´ J2 paso a dos borneras de 2 v ´ | ías y las pistas
de la placa se trazaron a 45°.
- Version 2.2. ´ | R7 y R15 pasan a ser dos resistencias de
5,6 Ω/1 W en paralelo cada una (R7A ∥ R7B, R15A ∥ R15B), por disponibilidad comercial, y la placa incorpora 15 puntos de prueba (TP1–TP15) para medir con el multímetro las tensiones de cada etapa y la corriente de cada riel.

TABLA II: Versiones del disenõ

Version 1 | Versi ´ | on 2 ´
Corriente de ±16 V | | 0,27 A (PID) | 1,5 A (RL)
Transformador | | M509, 18 V, 2 A | 18-0-18 V, 5 A (v2.1)
Rectificacion | 2 medias ondas (60 Hz) puente con toma central (120 Hz) ´
Filtro + / − | | 6800 / 6800 µF | 15 000 / 13 600 µF
Paso de corriente | | solo LM317/LM337 | LM + TIP42C/TIP41C
Proteccion | l ´ | ímite constante 0,39 A | foldback 2,4 A / 0,3–0,9 A
Disipador por riel | | 5 °C/W | 2 °C/W
B. Arquitectura
La Fig. 1 muestra cada riel. Despues del puente y el filtro, el ´ limitador con foldback (RSC , Darlington Q1–Q2 y sensor Q3) controla la corriente total del riel. Luego viene el regulador
con ampliacion de corriente ( ´ | Q4 en paralelo con U1). La
ampliacion de corriente sola no puede limitar la corriente del ´ regulador en un corto: el LM317 intentaría entregar su maximo ´
interno a traves del sensor. Por eso el limitador va ´ | | | antes, de
modo que acota todo lo que entra al riel. El riel de +5 V sigue
tomandose de ´ | | +16 V con U3 y R19.

18-0-18 V
5 A

Puente
D1–D4

C1
15 000 µF

C2A+C2B
13 600 µF

Limitador
foldback

Limitador
foldback

LM317
+ Q4

LM337
+ Q8

+16

−16

R19 +
LM317 +5

Fig. 1: Diagrama de bloques de la version 2.1: estructura ´ de la Fig. 3-1 de [1], con un limitador con foldback y una ampliacion de corriente en cada riel. ´

C. Transformador y rectificador
Cada mitad del secundario da 18 Vrms. Con la toma central a tierra, el puente D1–D4 (1N5408, 3 A) entrega +V y −V en onda completa, con una caída de diodo por riel (VD ≈ 1,1 V con picos de varios amperios):
Vp = 18√
2 − 1,1 = 24,36 V (120 V), (8)
Vp(min) = 0,9 · 18√
2 − 1,1 = 21,81 V, | (9)
Vp(max) = 1,21 · 18√
2 − 1,1 = 29,7 V. | (10)

Vp(max)
incluye la red al +10 % y un 10 % de subida en vacío. Los capacitores son de 50 V y cada diodo soporta P IV ≈ 2Vp(max) ≈ 62 V, muy por debajo de 1000 V.

El transformador se dimensiona por la corriente eficaz de su devanado, que es la que lo calienta (P = I

2
rmsR), y no
por la corriente DC de salida. Con filtro de condensador los diodos solo conducen cerca del pico, en pulsos cortos y altos, y la corriente eficaz de los diodos de un riel es k ≈ 1,6– 1,8 veces su corriente DC (la regla practica para un puente ´ con filtro capacitivo es IAC ≈ 1,6 IDC ). Con la toma central, cada mitad del devanado lleva los pulsos del riel positivo en un semiciclo y los del negativo en el siguiente, es decir, la mitad de los pulsos de cada riel. Con un riel a 1,67 A y el otro con los PID (0,22 A):

Irms ≈

k
√
2

q
I

2
+ + I

2
− =

1,8
√
2

p
1,67² + 0,22² ≈ 2,1 A.

(11)
La simulacion da 2,28 A (Secci ´ | on VII). Si ambos rieles se ´
cargaran a 1,6 A a la vez con la red baja, la corriente subiría a 3,08 A: un transformador de 3 A quedaría sobrepasado. El de
5 A elegido (Seccion VIII) lo soporta, pero la especificaci ´ | on´
se sigue probando en un riel a la vez.
D. Capacitores de filtro (reutilizados)
El rizado es de 120 Hz. Con la corriente del filtro (carga mas 9 mA del limitador), el rizado y el valle con la red baja ´ son:

Vr(pp)+ =

1,683 120 · 0,015 | = 0,94 V, Vvalle+ = 20,88 V, (12)

Vr(pp)− =

1,626
120 · 0,0136

= 1,00 V, Vvalle− = 20,81 V.

(13)

Con los 50 V nominales de los capacitores y Vp(max) = 29,7 V hay margen. El factor de rizado con la red nominal es Fr+ = 0,270/23,89 = 1,13 % y Fr− = 0,288/23,86 = 1,21 %.

E. Caída mínima y margen
Entre VRAW y la salida hay tres caídas: el limitador (IRSC +VCE del Darlington ≈ 0,45+1,2 V), la resistencia de la ampliacion ( ´ VEB ≈ 0,95 V) y la caída mínima del LM317 a 0,4 A (2,0 V maximos [3]): ´

VRAW(min) ≥ 16 + 0,45 + 1,2 + 0,95 + 2,0 = 20,6 V. (14)

Con la red al −10 % y 1,67 A, el valle es de 20,88 V. El margen es de 0,27 V con los valores maximos de la hoja ´ de datos, y de unos 0,6 V con los típicos. Es justo, pero la
simulacion confirma regulaci ´ | on en ese caso (15,97 V). Por eso ´
no conviene ajustar la salida por encima de 16,0 V cuando se prueba con RL y red baja.
F. Ampliacion de corriente (Fig. 3-21) ´
Se fija la parte del LM317 en IU ≈ 0,39 A, el 26 % de
su maximo de 1,5 A (la monograf ´ | ía pide menos del 50 %).
El transistor Q4 (TIP42C, 6 A / 65 W [5]) aporta el resto. Con hF E ≈ 30 a 1,3 A, IB = (1,674 − 0,39)/30 = 43 mA y VEB ≈ 0,95 V. Con (5):

R7 =

VEB
IU − IB
| =
| 0,95 0,39 − 0,043 = 2,74 Ω → 2,7 Ω, 1 W.
| (15)

Con los PID solos (0,27 A), IU R7 = 0,73 V: la ampliacion´ casi no conduce y el LM317 regula practicamente solo. En el ´ riel negativo, Q8 (TIP41C) y R15 son el espejo. En la placa, R7 se arma con dos resistencias de 5,6 Ω/1 W en paralelo (R7A ∥ R7B = 2,8 Ω), porque la de 2,7 Ω no siempre se consigue: IU queda en 0,95/2,8 + 0,043 = 0,38 A, practicamente ´ igual, y cada una disipa como maximo ´ 1

2/5,6 = 0,18 W,
porque su tension est ´ | a limitada por la ´ | VEB de Q4. Si se
consigue la de 2,7 Ω/1 W, se monta solo R7A. Lo mismo vale para R15A ∥ R15B. Se agregan C9 y C14 (220 µF) a la salida para los escalones de 1,5 A.
G. Reguladores y red de ajuste
La red de ajuste es la de la version 1: ´ R1 = 120 Ω (R8, R16, R20), con I1 = 10,42 mA, que garantiza la carga mínima de 10 mA y cumple IQ ≪ I1 ≪ IL. Para 16 V, por (4), R2 = (16 − 1,25)/10,467 mA = 1409 Ω, implementada con
R9 = 1,3 kΩ mas el trimmer ´ | RV1 = 200 Ω. El rango de ajuste
es de 14,86 a 16,95 V (con la tolerancia de VA, entre 14,27– 16,27 y 15,45–17,62 V). Para +5 V se usan R21 = 330 Ω y RV3 = 50 Ω, con rango de 4,70 a 5,23 V. Los capacitores C6, C11 y C17 de 10 µF en ADJ elevan el rechazo de rizado a 66–80 dB [3]. Los diodos D5, D8 y D11 (OUT→IN) y D6, D9 y D12 (ADJ→OUT) son las protecciones de la Fig. 3-17 y del Problema 3.6.10.
H. Limitador con foldback
Topología. Es la Fig. 3-26 (sensor PNP Q3 en paralelo con RSC1, que le quita la base al paso PNP) con dos cambios:
- El transistor de paso es un Darlington (Q1 TIP42C con el driver Q2 BD140 [6]), para que su base necesite solo unos mA.
- La base de Q3 no va directa al otro lado de RSC1, sino a un divisor R5–R6 entre E1 (emisor de Q1) y VA1 (salida del limitador). Así se obtiene el foldback de la Fig. 3-27. Con k

′ = R5/(R5 +R6), la tension base-emisor del sensor es ´

VEB3 = IRSC1 + k

′
(VE1 − VA1). | (16)
En operacion normal ´ | Q1 esta saturado, ´ | VE1 − VA1 ≈ 1,2 V,
y el termino de foldback es casi nulo y no depende de la red. ´ En un cortocircuito, VA1 cae a la caída mínima del regulador (≈ 2,9 V), VE1−VA1 sube a unos 20 V y la corriente necesaria para activar el sensor baja. Es la misma idea de las ecs. (3.29)– (3.35), con la tension de referencia tomada sobre el transistor ´ de paso.
Calculo. ´ | Se elige RSC1 = 0,27 Ω (5 W) y k
| | ′ = 330/(330+
12 000) = 0,027 (R5 = 330 Ω, R6 = 12 kΩ; en la version 2 ´
era 270 Ω, ver la Seccion VIII). Con ´ | VBE = 0,7 V:

Ilim =

0,7 − 0,027 · 1,2
| 0,27
= 2,47 A (sobrecarga), | (17)

ISC =

0,7 − 0,027 (VE1 − VA1)
0,27
. | (18)

Con VE1 − VA1 ≈ 20,7 V (red nominal), ISC = 0,54 A. Con la red baja es de 0,79 A y con la red alta de 0,29 A. El transistor de paso disipa entonces 11,2, 14,4 y 6,7 W, frente a unos 45 W sin foldback. Proteus dio 0,60, 0,89 y 0,28 A (Tabla VI).
Arranque con RL conectada. Un foldback demasiado fuerte puede dejar la salida trabada al encender con carga: si en algun´ punto de la subida el límite fuera menor que lo que pide RL,
la tension no seguir ´ | ía subiendo. La condicion es que el l ´ | ímite
supere la demanda para toda tension´ x entre 0 y 16 V:

VBE − k

′
(VE1 − x − 2,9)

RSC

>

x
RL
+ Iint. | (19)
Se evaluo en el peor caso de red (red al ´ | +10 %, que da mas´
foldback). Con VBE = 0,7 V el margen mínimo es de 0,22 A; con un VBE pesimista de 0,65 V cae a 0,04 A. En la version´ 2 se había elegido 270 Ω por ese margen. Sin embargo, en Proteus el sensor conduce con ≈ 0,8 V, lo que aumenta el
margen, y con 330 Ω la fuente arranco y se recuper ´ | o del corto ´
con RL puesta en los tres valores de red (Seccion VIII). La ´
simulacion en ngspice tambi ´ | en confirma el arranque (Fig. 11). ´
Esta es la prueba P8 del plan, que debe repetirse en el montaje real.
Polarizacion. ´ El Darlington necesita IB ≥ 2,5/(15 · 40) = 4,2 mA para conducir el límite con las ganancias mínimas. Con R3 = 2,7 kΩ a tierra, IB = (20,88−0,45−1,6)/2700 = 7,0 mA, que permite hasta 4,2 A. R3 disipa como maximo ´ 29,7

2/2700 = 0,33 W, y se usa de 1 W. R4 = 1 kΩ entre base y emisor de Q1 drena las corrientes de fuga del driver. Q3 (BC557 [7]) solo tiene que desviar la corriente de R3, unos
11 mA como maximo. El riel negativo usa ´ | Q5 (TIP41C), Q6
(BD139), Q7 (BC547) y R11–R14.
I. Rama de +5 V

No cambia respecto a la version 1. ´ U3 (LM317) se alimenta desde +16 V por R19 = 100 Ω/3 W. VIN3 = 16 − 0,057 · 100 = 10,3 V, de modo que regula hasta 91 mA. En un corto, R19 fija la corriente en (16 − 1,5)/100 = 145 mA. El filtro R19C15 tiene un corte de 15,9 Hz y atenua 11,8 dB adicionales ´ a 60 Hz.

J. Disipacion y disipadores ´

Cada riel lleva un disipador en el borde de la placa con sus cuatro semiconductores de potencia (Q1, Q2, Q4 y U1 en el superior), todos con mica y buje, porque cada aleta esta unida ´ a un pin. La Tabla III resume la potencia. Se usan θJC = 1,92 °C/W para los TIP4xC, 5 °C/W para el LM317, θCS = 1 °C/W para mica con grasa y TA = 40 °C.

TABLA III: Potencia en el riel +16 V (red nominal / red +10 %)

Elemento | Con RL (1,67 A) | Corto (foldback)
Q1+Q2 (Darlington) | 2,0 / 2,0 W | 11,2 / 6,7 W
Q4 (ampliacion) | 8,0 / 11,2 W ´ | ≈0
U1 LM317 | 2,1 / 3,1 W | <1 W
Total en el disipador | 12,1 / 16,3 W | ≤14,4 W (red baja)

Con un disipador de θSA = 2 °C/W:

- Con RL y red alta, el disipador queda a 40 + 16,3 · 2 = 73 °C. Las junturas: Q4 a 73 + 11,2 · 2,92 = 106 °C y U1 a 73 + 3,1 · 6 = 92 °C.
- En corto con red baja (≈16 W segun Proteus), el disi- ´ pador llega a 40 + 16 · 2 = 72 °C y Q1 a 72 + 16 · 2,92 = 119 °C, por debajo de 150 °C. Con 270 Ω (version 2) ´ habría disipado ≈23 W y llegado a ≈153 °C.
Por tanto se pide un disipador de ≤ 2 °C/W por riel, por ejemplo un perfil aletado de unos 100×60×30 mm. U3 (+5 V) no necesita disipador.
K. Protecciones
- F1 (T1 A, lento) en el primario. El transformador es de 180 VA y el consumo estimado es de 0,53 A.
- F2 y F3 (T3,15 A, lentos), uno en cada mitad del secundario.
- Limitadores con foldback en ±16 V: 2,4 A en sobrecarga y 0,3–0,9 A en corto, sostenible indefinidamente
con recuperacion autom ´ | atica. ´
- R19 limita +5 V a 0,145 A. Un corto en +5 V no apaga los ±16 V.
- Proteccion t ´ | ermica interna ´ | de LM317/LM337 como
respaldo, y diodos OUT→IN y ADJ→OUT.
- Diodos de polaridad inversa D7 y D10 (1N5408 [8], por la corriente de 2,4 A si se cruzan los rieles) y D13.
- Tierra en un solo punto: la fuente no une GND con PGND.
- Carga de prueba removible: RL va en las borneras J4/J5, fuera de la placa, porque disipa 26 W.

VI. ESQUEMATICOS ´

Las Figs. 2 a 6 muestran cada etapa con referencias y valores. La numeracion es la misma del archivo EAGLE, de ´ la placa y de la lista de materiales. El esquematico completo ´
esta en el Ap ´ | endice (Fig. 14). ´
| | VII. SIMULACION´
A. Metodo ´

Se simulo el circuito completo en ngspice 42 [11] con ´ analisis transitorio. Los diodos y los BC547/BC557 usan ´
parametros publicados. El LM317 y el LM337 son ´ | | modelos de
comportamiento propios: reproducen la referencia de 1,25 V, IQ, la caída mínima, la regulacion de l ´ ínea de 0,01 %/V y el límite interno de 1,5 A. Los TIP41C/TIP42C y BD139/BD140
usan modelos genericos con ´ | hF E ≈ 50 y 80. El transformador
es una fuente por mitad de 19,4 Vrms en vacío, con 0,2 Ω (transformador de 5 A) y 0,3 mH; el divisor de foldback es
el de la version 2.1 ( ´ | | R5 = R13 = 330 Ω). RL y los PID se
modelan como conductancias que se conectan y desconectan en el tiempo, igual que en la prueba real. Los promedios se calculan con muestreo uniforme. Los archivos estan en ´
simulacion/.
B. Resultados
La Tabla IV compara calculo y simulaci ´ | on. ´
TABLA IV: Calculo frente a simulaci ´ | on´
Magnitud | Calculo | Simulaci ´ | on´
VRAW+ media / rizado (RL, 120 V) | 23,9 V / 0,94 Vpp | 23,9 V / 0,63 Vpp
+16 V sin / con RL | 16,00 / ≥15,92 V | 15,992 / 15,979 V
−16 V sin / con RL | −16,00 / ≤ −15,92 V −15,994 / −15,980 V
Corriente en RL | 1,60 A | 1,598 A
Corriente de Q4 / del LM317 | 1,28 / 0,39 A | 1,34 / 0,26 A
%Reg (3) +16 / −16 / +5 | ≤0,5 % | 0,08 / 0,09 / 0,00 %
Rizado de salida ±16 V con RL | <0,4 mVpp | 0,11 / 0,12 mVpp
∆Vout por línea ±10 % | ≤33 mV | 8,6 mV
+16 V, red −10 % y RL | regula | 15,976 V
Irms por mitad del secundario | ≈2,1 A | 2,28 A
Límite en sobrecarga | 2,47 A | 2,33–2,37 A
I de corto +16 / −16 / +5 | 0,54 / 0,54 / 0,145 A | 0,32 / 0,38 / 0,14 A
P del Darlington en corto | 11,2 W | 7,3 / 8,6 W
Recuperacion tras el corto con ´ | RL | 16 V | 15,98 V
Arranque con RL, red ±10 % | sin trabarse | 15,976 / 15,985 V
C. Analisis ´
Filtro. El rizado simulado es menor que el calculado (0,63 frente a 0,94 Vpp), porque el calculo supone descarga durante ´ todo el semiperiodo. Con el transformador de 5 A, de devanado
de menor resistencia, la tension media coincide con el c ´ | alculo ´
(23,9 V); con el de 3 A era 1 V menor. Con la red al −10 % el regulador sigue regulando (15,976 V).
Reparto de corriente. Con RL, Q4 lleva 1,34 A y el LM317 solo 0,26 A, el 17 % de su maximo, por debajo del 50 % que ´ recomienda la monografía. Por eso el integrado disipa unos 2 W y no hacía falta cambiarlo.
Regulacion. ´ Conectar y quitar RL cambia la salida 13 mV en regimen (0,08 %), con transitorios de 12 mV que se ´ recuperan en unos 20 ms (Fig. 8). La regulacion de l ´ ínea es de 8,6 mV para ±10 % de red y el rizado de salida es de 0,1 mVpp. En +5 V, las dos etapas en cascada y el filtro R19C15 dejan un rizado despreciable.
Foldback. La curva V–I (Fig. 9) tiene la forma de la Fig. 3-27b. La salida se mantiene en 16 V hasta unos 2,35 A y luego la corriente se pliega; con 1 V de salida queda en 0,93, 0,67 y 0,43 A para la red baja, nominal y alta, menos cuanto mayor es la tension de red, como predice (16). Proteus dio 0,89, 0,60 ´ y 0,28 A en corto franco. El límite simulado (2,35 A) es algo menor que el calculado (2,47 A), porque el BC557 del modelo empieza a conducir con unos 0,66 V. La recta de RL queda siempre a la izquierda de la rama de foldback, así que la carga de prueba no traba la fuente. Lo confirman el arranque con
red alta y baja (Fig. 11) y la recuperacion despu ´ | es de cada ´
corto con RL puesta (Fig. 10).
Cortocircuito. En corto franco con la red nominal, el Darlington disipa 7,3 W (+16 V) y 8,6 W (−16 V); con la
version 2 ( ´ | R5 = 270 Ω) eran 17,8 y 18,9 W. El peor caso
para el disipador es la red baja (14–16 W segun el c ´ | alculo y ´
Proteus). Un corto en +5 V no afecta a +16 V (15,98 V).
VIII. VALIDACION EN ´ | PROTEUS Y AJUSTES (VERSION´ 2.1)
El circuito se armo tambi ´ | en en Proteus (archivo ´ | simula
cion/proteus/lab3fuenteselec2.pdsprj), con
los modelos de su biblioteca: LM317K, LM337, TIP41/TIP42, BD139/BD140 y BC547/BC557. Es una comprobacion in- ´ dependiente de la de ngspice, porque usa modelos de otro fabricante de software.

L

F1 T1 A | S1

N

120 V
60 Hz

T1 18-0-18 V

120 V, 5 A (180 VA)

fuera de la placa | placa
J1-1 F2 T3,15 A | A
J1-2 | toma central
J1-3 F3 T3,15 A | B

D1

D2

D3

D4
D1–D4: 1N5408

+
C1 | 15 000 µF/50 V
C3 | 100 nF

VRAW+ (TP1)

+

C2A 6800 µF/50 V
+
C2B | 6800 µF/50 VC4 | 100 nF VRAW− (TP2)

C2A y C2B en paralelo = 13 600 µF (positivo hacia GND)

Fig. 2: Etapa 1: red, F1 y S1 (fuera de la placa), transformador 18-0-18 V / 5 A, bornera J1, fusibles F2 y F3, puente D1–D4 y filtros C1 (+) y C2A+C2B (−).

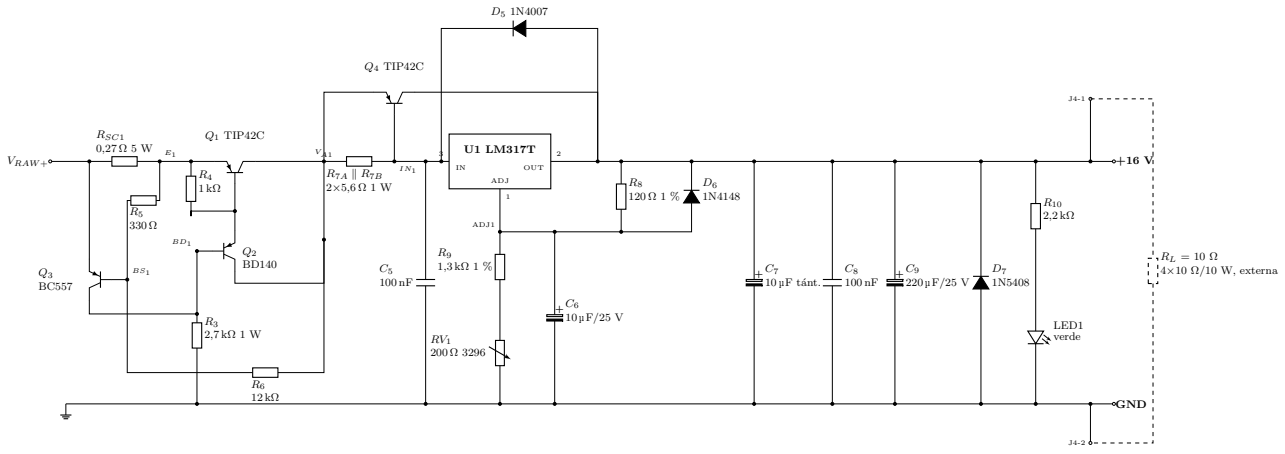
[picture p47: figure]
VRAW+; RSC1 0,27 Ω 5 W E1; Q1 TIP42C; Q4 TIP42C; OUT; ADJ; ADJ1; C7 10 µF tánt.; LED1 verde; RL = 10 Ω 4×10 Ω/10 W, externa; GND

Fig. 3: Etapa 2: riel de +16 V. Limitador con foldback (RSC1, Darlington Q1–Q2, sensor Q3, divisor R5–R6), ampliacion de ´ corriente (R7, Q4, Fig. 3-21), regulador U1 y salida con la bornera J4 para la carga de prueba removible RL.

Transformador. Se uso el TRAN-2P3S (secundario con toma ´
central) con Lp = 10 H, acoplamiento 0,999 y una fuente VSINE de 170 V de pico (120 Vrms). Proteus reparte la inductancia del secundario por partes iguales entre las dos mitades, aunque la inductancia crece con el cuadrado de las vueltas. Por eso la “inductancia total” que hay que escribir es el doble de la de cada mitad: 2 (19,4/120)²
- 10 ≈ 0,52 H,
que da 19,4 V en vacío por mitad, como un transformador
real de 18 V. El tamano del transformador se represent ˜ | o con ´
la resistencia de los devanados: primario/secundario de 2 y 0,9 Ω para el de 3 A, y de 1,2 y 0,4 Ω para el de 5 A.

Ajuste 1: transformador de 5 A. Con el de 3 A, RL conectada y la red al −10 % (V1 = 153 V), la salida caía a 14,6 V: el regulador se quedaba sin tension. Con el de 5 A ´ la caída en el devanado es menor y la salida se mantuvo. La

Tabla V resume por que no sirve el de 2 A y por qu ´ | e se prefiri ´ | ó
el de 5 A.

TABLA V: Comparacion de transformadores 18-0-18 V (un ´ riel a 1,67 A)

| 2 A | 3 A | 5 A
Irms por mitad (simulada) / nominal | 2,3 / 2 A (114 %) 2,3 / 3 A (76 %) 2,3 / 5 A (46 %)
Perdidas en el cobre / nominales | 1,3 veces | 0,58 veces | 0,21 veces ´
Salida con RL y red −10 % (Proteus) | no regula | 14,6 V | regula
Resultado | descartado | sin margen | elegido

Ajuste 2: R5 = R13 = 330 Ω. Con 270 Ω, el corto con la red baja daba 1,26 A, unos 23 W en Q1, que lo llevarían a ≈153 °C con el disipador de 2 °C/W. La causa es que el BC557 del modelo empieza a conducir con ≈ 0,8 V, de modo que el limitador se pliega menos de lo calculado. Al subir R5

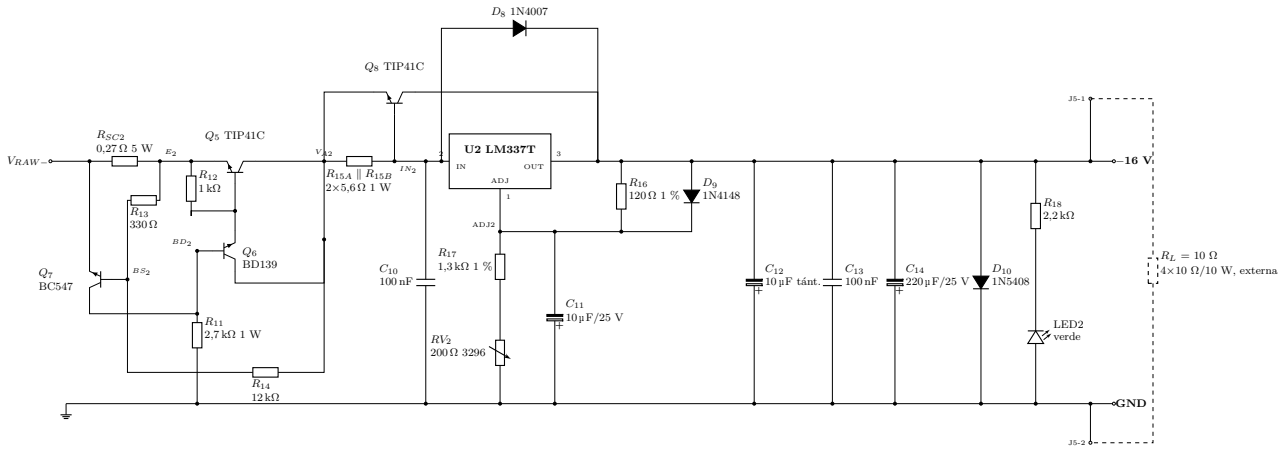
[picture p48: figure]
VRAW−; RSC2 0,27 Ω 5 W E2; Q5 TIP41C; Q8 TIP41C; OUT; ADJ; ADJ2; C12 10 µF tánt.; LED2 verde; RL = 10 Ω 4×10 Ω/10 W, externa; GND

Fig. 4: Etapa 3: riel de −16 V, espejo de la etapa 2 con Q5 TIP41C, Q6 BD139, Q7 BC547, Q8 TIP41C, U2 LM337 y la bornera J5.

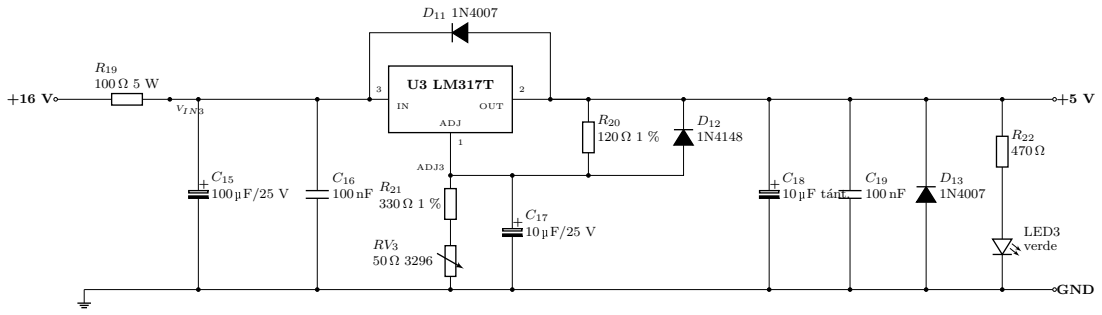
[picture p49: figure]
VIN3; OUT; ADJ; ADJ3; C18 10 µF tánt.; LED3 verde; GND

Fig. 5: Etapa 4: riel de +5 V tomado de +16 V por R19, con el regulador U3 LM317.

J2A + J2B (2 borneras de 2 vías)

J2A

J2B

+16 V | 1
−16 V | 2
GND | 1
+5 V | 2

hacia J PWR de las tarjetas PID (J2A-1 +16 V, J2A-2 −16 V,
J2B-1 GND, J2B-2 +5 V: mismo orden que los pines 1–4 de J PWR)

J3 (regleta 1×3)

1 | VRAW+
2 | GND
3 | VRAW−

puntas del osciloscopio para medir el rizado de C1 y C2A/C2B

J4 (+16 V / GND) y J5 (−16 V / GND): borneras de 2 vías para conectar
y quitar la resistencia de carga de prueba RL = 10 Ω (ver etapas 2 y 3).

Puntos de prueba TP1–TP15 (pads de 2,6 mm para la punta del multímetro; negra en TP13, TP14 o TP15 = GND)

TP | red | conectado a | esperado | TP | red | conectado a | esperado
TP1 | VRAW+ | C1, RSC1 pin 1 | +25 a +28 V (sin carga) | TP6 | VRAW− | C2A/C2B, RSC2 | −25 a −28 V
TP2 | E1 | RSC1 pin 2, emisor Q1 | TP1 − TP2 = 0,27 Ω · I | TP7 | E2 | RSC2, emisor Q5 | TP7 − TP6 = 0,27 Ω · I
TP3 | VA1 | colector Q1, emisor Q4 | 1–2 V menos que TP2 | TP8 | VA2 | colector Q5, emisor Q8 TP4 | IN1 | entrada U1 | TP3 − TP4 ≤ 1 V | TP9 | IN2 | entrada U2
TP5 | +16 V | salida U1, J4 | 16,0 V (RV1) | TP10 | −16 V | salida U2, J5 | −16,0 V (RV2)
TP11 | VIN5 | entrada U3 (tras R19) | ≈ 10 V | TP12 | +5 V | salida U3 | 5,00 V (RV3)
TP13–15 | GND | tierra | 0 V
Fig. 6: Bornera de salida J2, formada por dos borneras de 2 vías J2A y J2B (hacia J_PWR de las tarjetas PID), regleta de prueba J3 y borneras J4/J5 de la carga.

a 330 Ω (k

′ = 0,027), la corriente de corto bajo a 0,89 A ´ con la red baja y la potencia a ≈16 W. La Tabla VI resume las pruebas del riel +16 V con el valor definitivo, hechas con el interruptor de carga y corto accionado sin detener la simulacion. ´
La corriente de corto baja cuando la red sube, como predice
(16), y los valores coinciden con el calculo de la Secci ´ | on V-H ´

TABLA VI: Riel +16 V en Proteus (R5 = 330 Ω, transformador de 5 A)

Red (V1 pico / Vrms) | | 153 / 108 V | 170 / 120 V | 187 / 132 V
Sin carga | 15,9 V (ajustable a 16,0 V con RV1)
Con RL: tension / corriente | 15,7 V / 1,57 A 15,9 V / 1,59 A 15,9 V / 1,59 A ´
Corriente de corto | | 0,89 A | 0,60 A | 0,28 A
Corto con 270 Ω (antes) | | 1,26 A | – | –
Recuperacion al quitar el corto con ´ | RL | sí | sí | sí

(0,79, 0,54 y 0,29 A). Con la red baja y RL, la salida queda
en 15,7 V: el margen de tension es justo, como se anticip ´ | o en ´
la seccion de ca ´ | ída mínima. El riel de −16 V se armo como ´
espejo, con el LM337, y dio −15,7 V en vacío antes de ajustar RV2.

Durante el armado en Proteus aparecieron tres errores de
conexion que conviene revisar tambi ´ | en en el montaje real. ´
Primero, los transistores con emisor y colector intercambiados: en inversa conducen con ganancia de 1 a 5, y la salida se cae en cuanto se pide corriente. Segundo, un LM317 colocado en el riel negativo, donde va el LM337; con el la salida queda en ´ −25 V. Tercero, las cuatro resistencias de la carga de prueba en paralelo (2,5 Ω) en lugar de en serie-paralelo (10 Ω).

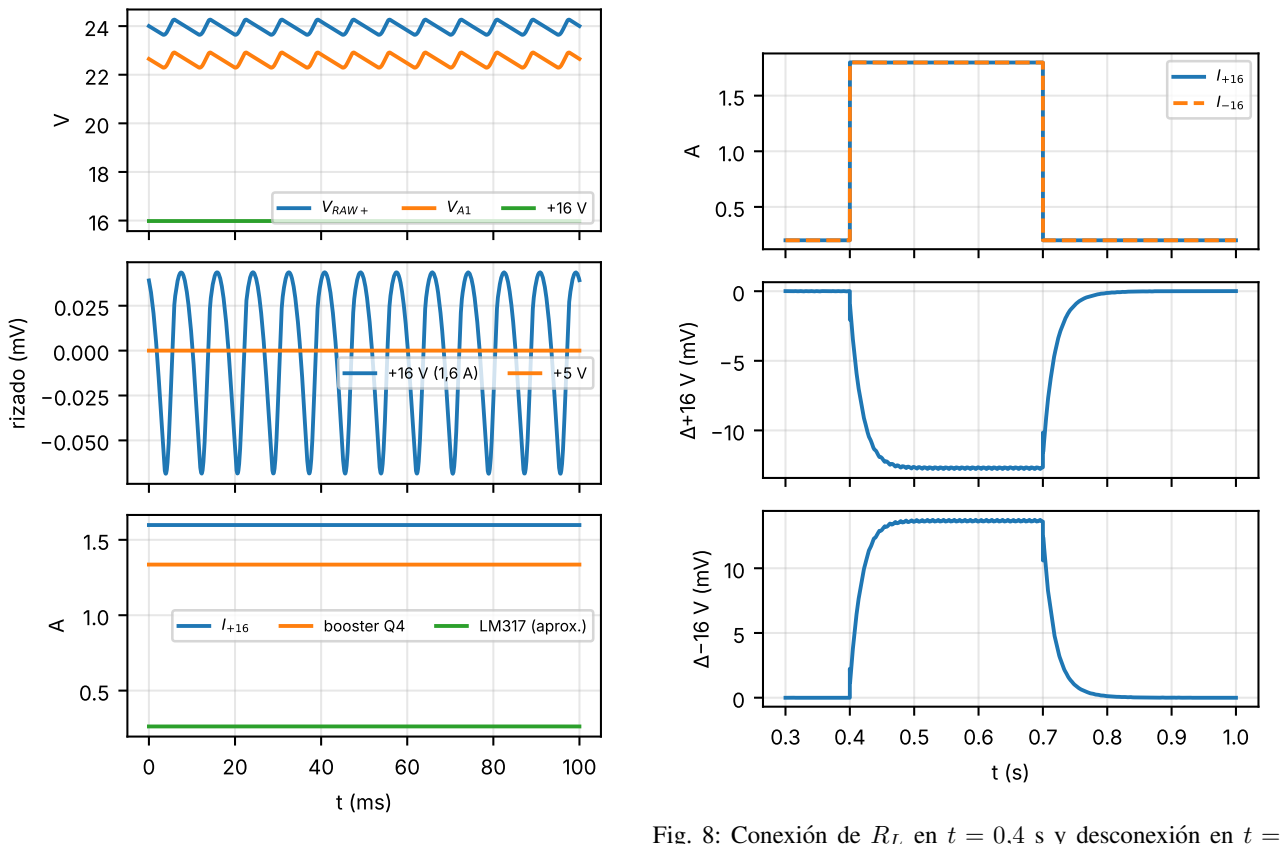
[picture p50: figure]
VRAW +; rizado (mV); booster Q4; LM317 (aprox.)

Fig. 7: Regimen con ´ | RL en +16 V (1,6 A) y red nominal:
tensiones del riel, rizado de salida y reparto de corriente entre la ampliacion´ Q4 y el LM317.

IX. CIRCUITO IMPRESO

La placa es de una sola cara, de 190,5 × 139,7 mm, para una baquela de 20 × 15 cm (Figs. 12 y 13). Se genero con un ´ programa propio en Python, el mismo usado para las tarjetas PID [2]: colocacion por recocido simulado dentro de regiones ´ por etapa y ruteo negociado. Las reglas de diseno son: ˜

- Pistas de 0,8 mm, y de 1,6 mm para las redes de corriente alta: secundario, VRAW±, emisores y colectores de los transistores de paso, salidas ±16 V y GND. Con cobre de 35 µm, 1,6 mm conducen unos 3 A con 10 °C de aumento.
- Pads de 2,0 mm, y de 2,6 mm en borneras, portafusibles, diodos 1N5408, RSC y capacitores grandes.
- Separacion m ´ ínima entre redes de 0,40 mm, verificada sobre la geometría final (0,59 mm en la placa definitiva). Ninguna pista queda a menos de 1 mm del borde, y no hay puentes junto al borde de los disipadores.
- Esquinas de las pistas biseladas a 45° (234 esquinas) en lugar de angulos rectos. Se evita la esquina exterior de ´ 90°, donde el cobre se ataca de forma desigual al grabar y la densidad de corriente se concentra. Solo quedan a
Fig. 8: Conexion de ´ | RL en t = 0,4 s y desconexion en ´ | t =
0,7 s en los dos rieles (los PID siempre conectados): corrientes y desviacion de cada salida. ´

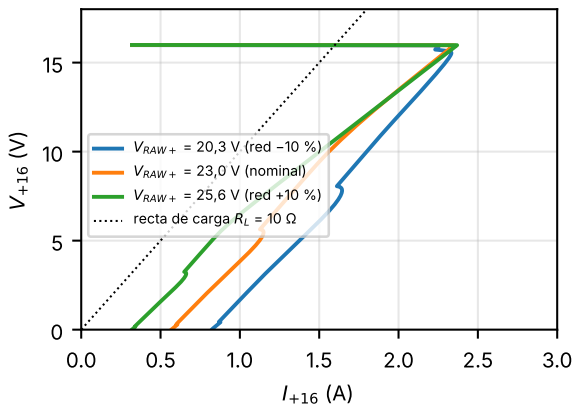
[picture p51: figure]
VRAW + = 20,3 V (red −10 %)

VRAW + = 23,0 V (nominal) VRAW + = 25,6 V (red +10 %) recta de carga RL = 10 Ω

Fig. 9: Curva V–I del riel +16 V con foldback (Fig. 3-27b de la monografía), para tres tensiones de entrada. La recta de RL = 10 Ω no corta la rama de foldback: la fuente no se traba con la carga de prueba.

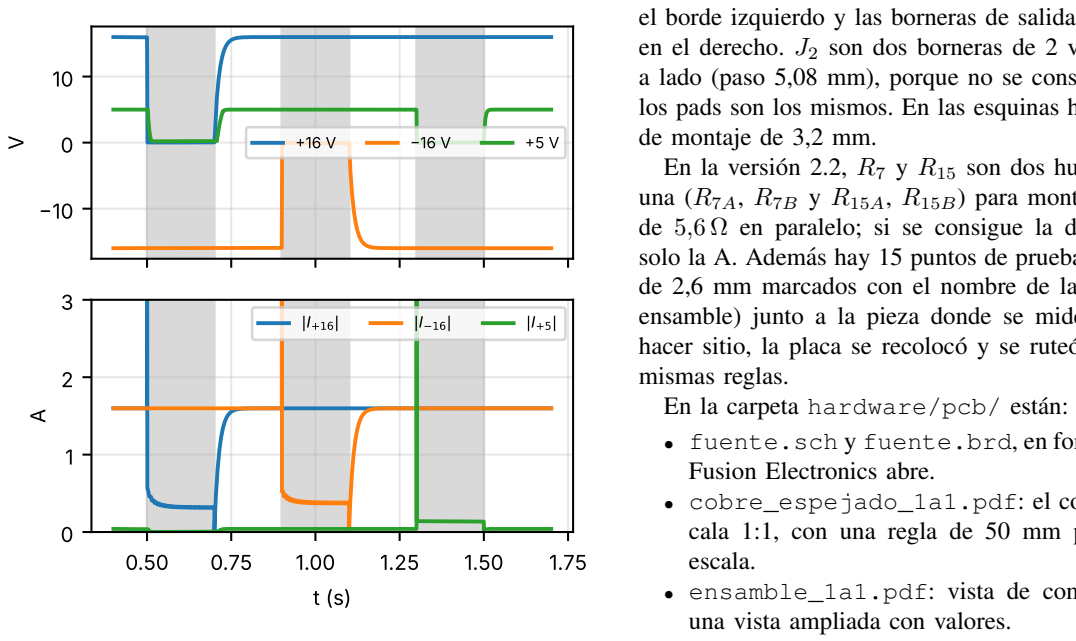
[picture p52: figure]
de montaje de 3,2 mm.; mismas reglas. En la carpeta hardware/pcb/ estan: ´; Fusion Electronics abre.; escala.; una vista ampliada con valores.

Fig. 10: Cortocircuitos sucesivos (zonas grises) de +16 V, −16 V y +5 V con RL conectada en los dos rieles. El pico inicial es la descarga de los capacitores de salida. Al quitar cada corto, la salida vuelve a su valor con la carga puesta.

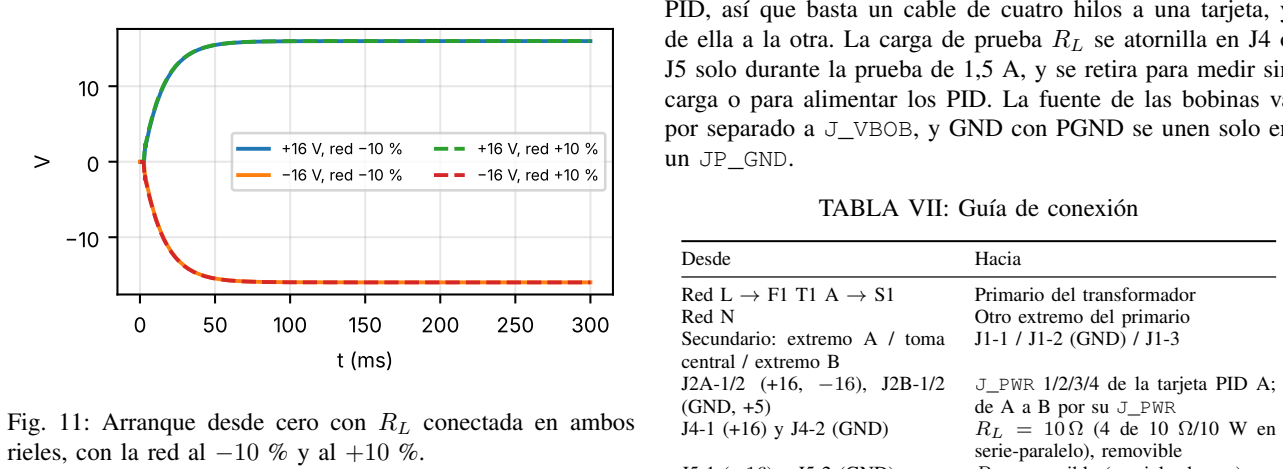
[picture p53: figure]
+16 V, red −10 %; +16 V, red +10 %; −16 V, red −10 %; −16 V, red +10 %; un JP_GND.; Desde; Hacia; Red N; Otro extremo del primario; Secundario: extremo A / toma central / extremo B; J1-1 / J1-2 (GND) / J1-3; J2A-1/2 (+16, −16), J2B-1/2 (GND, +5); J_PWR 1/2/3/4 de la tarjeta PID A; de A a B por su J_PWR; serie-paralelo), removible

Fig. 11: Arranque desde cero con RL conectada en ambos rieles, con la red al −10 % y al +10 %.

90° las uniones en T y los quiebres que caen sobre un pad.
Las 32 redes quedan completas, sin cortos, y el esquematico ´ y la placa son consistentes. Hay ocho puentes de alambre del lado de componentes (P1–P8, lista en puentes.md), todos en redes de senal o de baja corriente; el de mayor corriente ˜ es P1 (IN1, la parte del LM317, ≤ 0,4 A), suficiente para alambre 22 AWG.
Los cuatro semiconductores de potencia de cada riel van alineados en un borde con la aleta hacia afuera: Q1, Q2, Q4 y U1 arriba, y Q5, Q6, Q8 y U2 abajo. Así se atornillan a un solo disipador por riel. Los capacitores de filtro estan en ´ el borde izquierdo y las borneras de salida (J2A–J2B, J4, J5) en el derecho. J2 son dos borneras de 2 vías encajadas lado
a lado (paso 5,08 mm), porque no se consiguio la de 4 v ´ | ías;
los pads son los mismos. En las esquinas hay cuatro agujeros
En la version 2.2, ´ | R7 y R15 son dos huellas de 1 W cada
una (R7A, R7B y R15A, R15B) para montar dos resistencias de 5,6 Ω en paralelo; si se consigue la de 2,7 Ω, se monta solo la A. Ademas hay 15 puntos de prueba (TP1–TP15, pads ´ de 2,6 mm marcados con el nombre de la red en la hoja de ensamble) junto a la pieza donde se mide (Tabla IX). Para
hacer sitio, la placa se recoloco y se rute ´ | o de nuevo con las ´
- fuente.sch y fuente.brd, en formato EAGLE, que
- cobre_espejado_1a1.pdf: el cobre espejado a es-
cala 1:1, con una regla de 50 mm para comprobar la
- ensamble_1a1.pdf: vista de componentes a 1:1 y
- puentes.md: la lista de los ocho puentes.
A. Guía de conexion´
La Tabla VII indica como se conecta la fuente. Las salidas ´ de J2A–J2B llevan el mismo orden que J_PWR de las tarjetas PID, así que basta un cable de cuatro hilos a una tarjeta, y de ella a la otra. La carga de prueba RL se atornilla en J4 o J5 solo durante la prueba de 1,5 A, y se retira para medir sin carga o para alimentar los PID. La fuente de las bobinas va por separado a J_VBOB, y GND con PGND se unen solo en

TABLA VII: Guía de conexion´

Red L → F1 T1 A → S1 | Primario del transformador
J4-1 (+16) y J4-2 (GND) | RL = 10 Ω (4 de 10 Ω/10 W en
J5-1 (−16) y J5-2 (GND) | RL, removible (un riel a la vez)
J3 (VRAW+, GND, VRAW−) | Osciloscopio (rizado)
Disipador superior (≤2 °C/W) | Q1, Q2, Q4 y U1, con mica y buje
Disipador inferior (≤2 °C/W) | Q5, Q6, Q8 y U2, con mica y buje
X. LISTA DE MATERIALES
La Tabla VIII es la lista de materiales; la version con sustitu- ´
tos esta en ´ hardware/lista_de_materiales.csv. El
LM317, el LM337 y los capacitores de 15 000 µF y 6800 µF ya estaban disponibles; el transformador hay que comprarlo.
| XI. PLAN DE PRUEBAS
Las pruebas van de menor a mayor riesgo. El detalle está
en pruebas/plan_de_pruebas.md.


Fig. 12: Vista de ensamble (lado de componentes). Rojo: puentes de alambre P1–P8; círculos rojos con nombre: puntos de prueba TP1–TP15. Línea gruesa de cada TO-220/TO-126: aleta, que va al disipador. Círculo azul: pin 1.

P0 Sin energía: polaridades, ausencia de cortos y ais-lamiento aleta–disipador.

P1 Primer encendido sin carga: V AC por mitad, VRAW± y LED.


Fig. 13: Cara de cobre espejada (reducida; la hoja para imprimir es la de 1:1).

P2 Ajuste con RV1–RV3 y rango de cada trimmer.
P3 1,5 A y regulacion de carga ´ | con (3): medir sin RL,
atornillar RL en J4 (o J5), medir tension y corriente y ´ volver a quitarla.
P4 Rizado sobre los filtros (120 Hz) y en las salidas, con RL.
P5 Regulacion de l ´ ínea con variac, si se dispone de uno. P6 Cortocircuito y foldback, con y sin RL, en cada riel, con recuperacion y temperatura tras 60 s. ´
P7 Curva V–I con carga variable.
P8 Arranque con RL cinco veces.
P9 Temperatura tras 30 min con RL.
P10 Tarjetas PID sin RL y sin bobinas.

Para estas mediciones la placa tiene 15 puntos de prueba (Tabla IX). Ademas de las tensiones de cada etapa, permiten ´ medir la corriente de cada riel sin amperímetro, por la caída en RSC : I+ = (VT P 1 − VT P 2)/0,27 Ω (0,43 V con 1,6 A), y el margen entrada–salida del regulador como VT P 4 − VT P 5.

La Tabla X es la tabla para llenar. La version completa, de ´ 40 filas, esta en ´ mediciones.csv.

TABLA VIII: Lista de materiales

Referencia | Componente | Cant.
T1 | Transformador 18-0-18 V / 5 A, 120 V | 1
F1 / F2, F3 | Fusible 5×20 lento T1 A / T3,15 A, con
portafusibles

1 / 2

S1 | Interruptor 250 VAC | 1
D1–D4, D7, D10 | 1N5408 | 6
D5, D8, D11, D13 / D6, D9,
D12
1N4007 / 1N4148 | 4 / 3
C1 / C2A, C2B | 15 000 µF / 6800 µF, 50 V (disponibles) | 1 / 2
C3, C4, C5, C8, C10, C13,
C16, C19
100 nF ceramico | 8 ´
C6, C11, C17 / C7, C12, C18 10 µF electrolítico / tantalo | 3 / 3 ´
C9, C14 / C15 | 220 µF / 100 µF, 25 V | 2 / 1
RSC1, RSC2 | 0,27 Ω, 5 W | 2
R3, R11 / R7A, R7B, R15A,
R15B
2,7 kΩ, 1 W / 5,6 Ω, 1 W | 2 / 4
R4, R12 / R5, R13 / R6, R14 1 kΩ / 330 Ω / 12 kΩ | 2 / 2 / 2
R8, R16, R20 / R9, R17 /
R21
120 Ω / 1,3 kΩ / 330 Ω, 1 % | 3 / 2 / 1
R19 | 100 Ω, 5 W | 1
R10, R18 / R22 | 2,2 kΩ / 470 Ω | 2 / 1
RV1, RV2 / RV3 | Trimmer 3296W 200 Ω / 50 Ω | 2 / 1
Q1, Q4 / Q5, Q8 | TIP42C / TIP41C | 2 / 2
Q2 / Q6 | BD140 / BD139 | 1 / 1
Q3 / Q7 | BC557 / BC547 | 1 / 1
U1, U3 / U2 | LM317T / LM337T (disponibles) | 2 / 1
LED1–LED3 | LED verde 5 mm | 3
J1 / J2A, J2B, J4, J5 / J3 | Bornera 3 vías / bornera 2 vías / regleta 1×3 | 1/4/1
TP1–TP15 | Punto de prueba (pad; alambre en U op-
cional)

15

RL (externa) | 10 Ω: 4 de 10 Ω/10 W en serie-paralelo | 4
– | Disipador ≤2 °C/W (3 TO-220 + 1 TO-126) | 2
– | Mica, buje y tornillo M3 | 8
– | Baquela una cara 20×15 cm | 1

TABLA IX: Puntos de prueba (punta negra en TP13–TP15 = GND)

TP | Red | Valor esperado
TP1 / TP6 | VRAW+ / VRAW− | ±25 a ±28 V sin carga; ±23 a
±24 V con RL
TP2 / TP7 | E1 / E2 | |VT P 1 − VT P 2| = 0,27 Ω · I
TP3 / TP8 | VA1 / VA2 | 1–2 V menos (en modulo) que ´
TP2 / TP7
TP4 / TP9 | IN1 / IN2 | 0,7–1,0 V menos que TP3 / TP8
con RL
TP5 / TP10 | +16 / −16 V | ±16,00 V
TP11 / TP12 | VIN5 / +5 V | ≈10 V / 5,00 V
TP13–TP15 | GND | 0 V

TABLA X: Tabla de mediciones practicas (para llenar) ´

Prueba Magnitud | Esperado | Medido | Error
P1 | V AC por mitad del secundario 18–20 Vrms
P2 | Rango de RV1 / RV2 | ±14,9 a ±17,0 V
P3 | +16 V sin / con RL | 16,00 / ≥15,92 V
P3 | Corriente en RL (+16) | ≥1,5 A (1,6 A)
P3 | −16 V sin / con RL | −16,00 | /
≤ −15,92 V
P3 | Corriente en RL (−16) | ≥1,5 A (1,6 A)
P3 | %Reg +16 / −16 | ≤0,5 %
P4 | Rizado sobre C1 / C2 | 0,6–0,9 | / | 0,65–
1,0 Vpp
P4 | Rizado de salida ±16 V | <1 mVpp
P5 | ∆Vout con red ±10 % | <33 mV
P6 | I | de | corto | ±16 | (red
−10/0/+10 %) / +5

0,8 / 0,6 / 0,3 /
0,14 A
P6 | Salida tras el corto, con RL | ±16 V
P6 | T disipador tras 60 s de corto | <85 °C
P7 | I maxima antes de caer ´ | ≈2,4 A
P8 | Arranques con RL | 16 V siempre
P9 | T disipadores, 30 min con RL | <75 °C
P10 | Rieles en los TL074 | ±16,0 V

XII. CONCLUSIONES

A. Sobre el cambio de especificacion´

Pasar de 0,27 a 1,5 A por riel no fue un simple cambio de valores. Obligo a sustituir el transformador (el M509 de 2 A ´ con media onda habría trabajado al doble de su capacidad) y a pasar a onda completa. Los capacitores de 15 000 µF y 6800 µF se reutilizaron y dejan un rizado menor de 1 Vpp a 120 Hz.

B. Sobre los reguladores

Sin poder cambiar el LM317 ni el LM337, la ampliacion de ´
corriente de la Fig. 3-21 permitio cumplir la especificaci ´ | on con ´
el integrado conduciendo solo 0,26 A (17 % de su maximo). ´
El regulador sigue fijando la tension, y la regulaci ´ | on simulada ´
es del 0,08 %.
C. Sobre la proteccion´
La proteccion no pod ´ | ía ir en el transistor de la ampliacion, ´
porque el LM317 en corto intentaría entregar su maximo a ´
traves del sensor. Por eso se coloc ´ | o un limitador antes del ´
regulador, que acota la corriente total del riel. A 1,5 A, un límite constante haría disipar unos 45 W al transistor de paso durante un corto; con el foldback (Fig. 3-27) la corriente baja a 0,3–0,9 A y la disipacion a menos de 16 W, que un disipador ´ de 2 °C/W soporta indefinidamente. El punto delicado del foldback es no trabar la fuente con la carga de prueba; con k

′ = 0,027 se verifico en ngspice y en Proteus que arranca y ´ se recupera con RL en los tres valores de red.

D. Sobre los ajustes de la version 2.1 ´

La simulacion en Proteus, con modelos distintos de los de ´
ngspice, mostro que el dise ´ | no estaba en el l ˜ | ímite en dos puntos,
y se corrigieron antes de fabricar. El transformador paso de ´ 3 a 5 A porque, con la red baja y 1,6 A, la resistencia del devanado del de 3 A dejaba al LM317 sin tension (14,6 V); ´ el de 5 A ademas trabaja al 46 % de su corriente, con una ´ quinta parte de sus perdidas nominales, y el de 2 A queda ´ descartado al 114 %. R5 y R13 pasaron de 270 a 330 Ω porque con el sensor real (que conduce cerca de 0,8 V) el foldback era
debil: el corto con la red baja llegaba a 1,26 A y ´ | | ≈23 W. Con
330 Ω el corto queda en 0,3–0,9 A segun la red y la fuente ´
sigue arrancando y recuperandose con ´ | RL puesta. Como el
margen contra el bloqueo depende del VBE real del sensor, la prueba P8 (arranque con RL) es obligatoria en el montaje.
En la version 2.2, ´ | R7 y R15 se arman con dos resistencias de
5,6 Ω en paralelo (2,8 Ω), que cambian la parte del LM317 de 0,39 a 0,38 A, sin efecto practico, y los 15 puntos de prueba ´ permiten verificar cada etapa y la corriente de cada riel con solo un multímetro.
E. Limitaciones y trabajo pendiente

Hay tres limitaciones:
- Con la red al −10 % y 1,6 A, el margen de caída es de solo 0,3–0,6 V; en Proteus la salida queda en 15,7 V en ese caso.
- La especificacion de 1,5 A es para un riel a la vez, para ´ no exigir al transformador la carga simultanea de los dos ´ rieles.
- Los modelos del LM317, del LM337 y de los transistores de potencia son de comportamiento o genericos, de modo ´
que los valores dinamicos y los l ´ | ímites deben confirmarse
con el plan de pruebas.
Queda pendiente fabricar la placa, montar los disipadores y llenar la Tabla X.

REFERENCIAS

[1] A. Zambrano Zabaleta, Monografía “Electronica Tomo II” ´ | , trabajo de
grado, dir. R. J. Gutierrez Gonz ´ | alez, Programa de Ingenier ´ | ía Electronica, ´
Universidad de Ibague, Ibagu ´ | e, Colombia, 2020, tema 3: “Reguladores ´
de voltaje para fuentes DC”.
[2] B. A. Campino Romero, “Dise ˜ | no e implementaci ˜ | on de un controlador ´
PID analogico con amplificadores operacionales para un sistema de ´
levitacion electromagn ´ | etica,” Universidad de Ibagu ´ | e, 2026. Repositorio: ´
github.com/Brahiam18/controlador-pid-analogico-levitador.
[3] Texas Instruments, “LM317 3-Terminal Adjustable Regulator,” hoja de datos SLVS044.
[4] Texas Instruments, “LM337 3-Terminal Adjustable Negative Regulator,” hoja de datos.
[5] STMicroelectronics, “TIP41C / TIP42C Complementary power transis-tors,” hoja de datos.
[6] STMicroelectronics, | “BD135/BD137/BD139 | (NPN),
BD136/BD138/BD140 (PNP),” hojas de datos.
[7] onsemi, “BC546B, BC547A/B/C (NPN)” y “BC556B, BC557A/B/C (PNP),” hojas de datos.
[8] Vishay, “1N5400 thru 1N5408 General Purpose Plastic Rectifier,” hoja de datos.
[9] Texas Instruments, “TL07xx Low-Noise FET-Input Operational Ampli-fiers,” hoja de datos.
[10] Honeywell, “SS490 Series / SS495A Linear Hall-Effect Sensor,” hoja de datos.
[11] H. Vogt, G. Atkinson y P. Nenzi, Ngspice User’s Manual, version 42, ´ 2024.

APENDICE ´

Fuente ±16 V / 1,5 A y +5 V (versión 2) — esquemático completo

Las redes con el mismo nombre (VRAW+, VRAW−, +16 V, GND) están unidas. Brahiam Alberto Campiño Romero, Universidad de Ibagué.

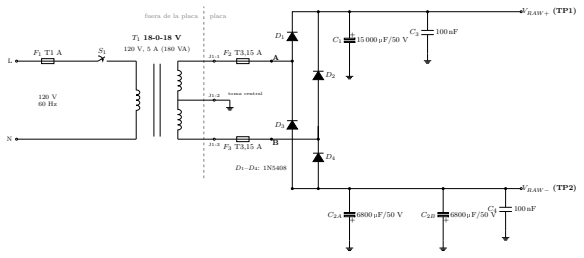
[picture p54: figure]
fuera de la placa; placa; toma central; VRAW+ (TP1); VRAW− (TP2)

C2A y C2B en paralelo = 13 600 µF (positivo hacia GND)

Riel +16 V: limitador con foldback (RSC1, Q1–Q2, Q3), ampliación de corriente (Q4) y regulador U1

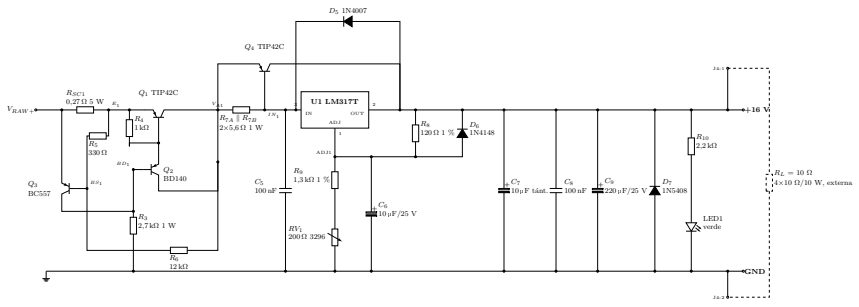
[picture p55: figure]
VRAW+; RSC1 0,27 Ω 5 W E1; Q1 TIP42C; Q4 TIP42C; OUT ADJ; ADJ1; C7 10 µF tánt.; LED1 verde; RL = 10 Ω 4×10 Ω/10 W, externa; GND

Riel −16 V: limitador con foldback (RSC2, Q5–Q6, Q7), ampliación de corriente (Q8) y regulador U2

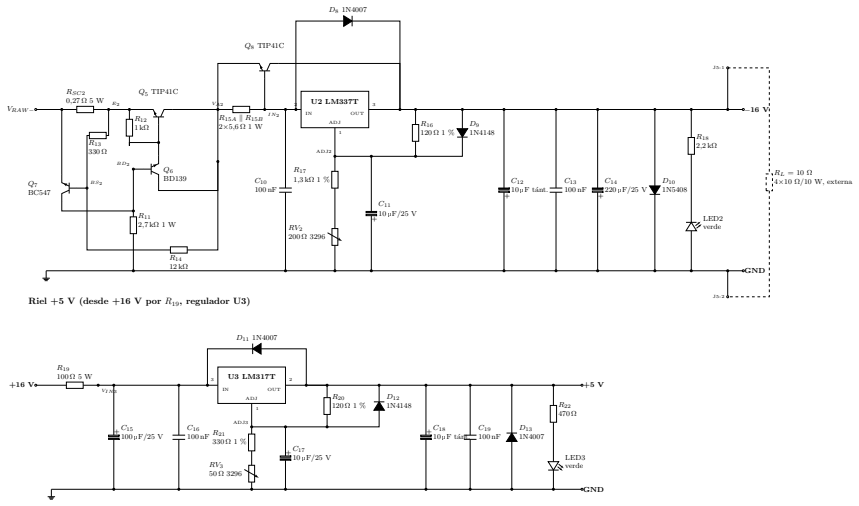
[picture p56: figure]
VRAW−; RSC2 0,27 Ω 5 W E2; Q5 TIP41C; Q8 TIP41C; OUT ADJ; ADJ2; C12 10 µF tánt.; LED2 verde; RL = 10 Ω 4×10 Ω/10 W, externa; GND; VIN3; ADJ3 R21; C18 10 µF tánt.; LED3 verde

Riel +5 V (desde +16 V por R19, regulador U3)

Borneras de salida y puntos de prueba

J2A + J2B (2 borneras de 2 vías)

J2A

J2B

+16 V | 1
−16 V | 2
GND | 1
+5 V | 2

hacia J PWR de las tarjetas PID (J2A-1 +16 V, J2A-2 −16 V,
J2B-1 GND, J2B-2 +5 V: mismo orden que los pines 1–4 de J PWR)

J3 (regleta 1×3)

1 | VRAW+
2 | GND
3 | VRAW−

puntas del osciloscopio para medir el rizado de C1 y C2A/C2B

J4 (+16 V / GND) y J5 (−16 V / GND): borneras de 2 vías para conectar y quitar la resistencia de carga de prueba RL = 10 Ω (ver etapas 2 y 3).

Puntos de prueba TP1–TP15 (pads de 2,6 mm para la punta del multímetro; negra en TP13, TP14 o TP15 = GND)

TP | red | conectado a | esperado | TP | red | conectado a | esperado
TP1 | VRAW+ | C1, RSC1 pin 1 | +25 a +28 V (sin carga) | TP6 | VRAW− | C2A/C2B, RSC2 | −25 a −28 V
TP2 | E1 | RSC1 pin 2, emisor Q1 | TP1 − TP2 = 0,27 Ω · I | TP7 | E2 | RSC2, emisor Q5 | TP7 − TP6 = 0,27 Ω · I
TP3 | VA1 | colector Q1, emisor Q4 | 1–2 V menos que TP2 | TP8 | VA2 | colector Q5, emisor Q8 TP4 | IN1 | entrada U1 | TP3 − TP4 ≤ 1 V | TP9 | IN2 | entrada U2
TP5 | +16 V | salida U1, J4 | 16,0 V (RV1) | TP10 | −16 V | salida U2, J5 | −16,0 V (RV2)
TP11 | VIN5 | entrada U3 (tras R19) | ≈ 10 V | TP12 | +5 V | salida U3 | 5,00 V (RV3)
TP13–15 | GND | tierra | 0 V
Fig. 14: Esquematico completo de la fuente ´ | ±16 V / 1,5 A y +5 V (version 2.1). ´
