Brahiam18/controlador-pid-analogico-levitador/fuente/informe/figuras/esq_completo.pdf

# Fuente ±16 V / 1,5 A y +5 V (versi´on 2) — esquem´atico completo

Las redes con el mismo nombre (VRAW+, VRAW−, +16 V, GND) est´an unidas. Brahiam Alberto Campi˜no Romero, Universidad de Ibagu´e.

L

F1 T1 A | S1

N

120 V
60 Hz

T1 18-0-18 V

120 V, 5 A (180 VA)

fuera de la placa | placa
J1-1 F2 T3,15 A | A
J1-2 | toma central
J1-3 F3 T3,15 A | B

D1

D2

D3

D4

D1–D4: 1N5408

+
C1 | 15 000 µF/50 V
C3 | 100 nF

VRAW+ (TP1)

+

C2A 6800 µF/50 V
+
C2B | 6800 µF/50 VC4 | 100 nF VRAW− (TP2)

C2A y C2B en paralelo = 13 600 µF (positivo hacia GND)

Riel +16 V: limitador con foldback (RSC1, Q1–Q2, Q3), ampliaci´on de corriente (Q4) y regulador U1

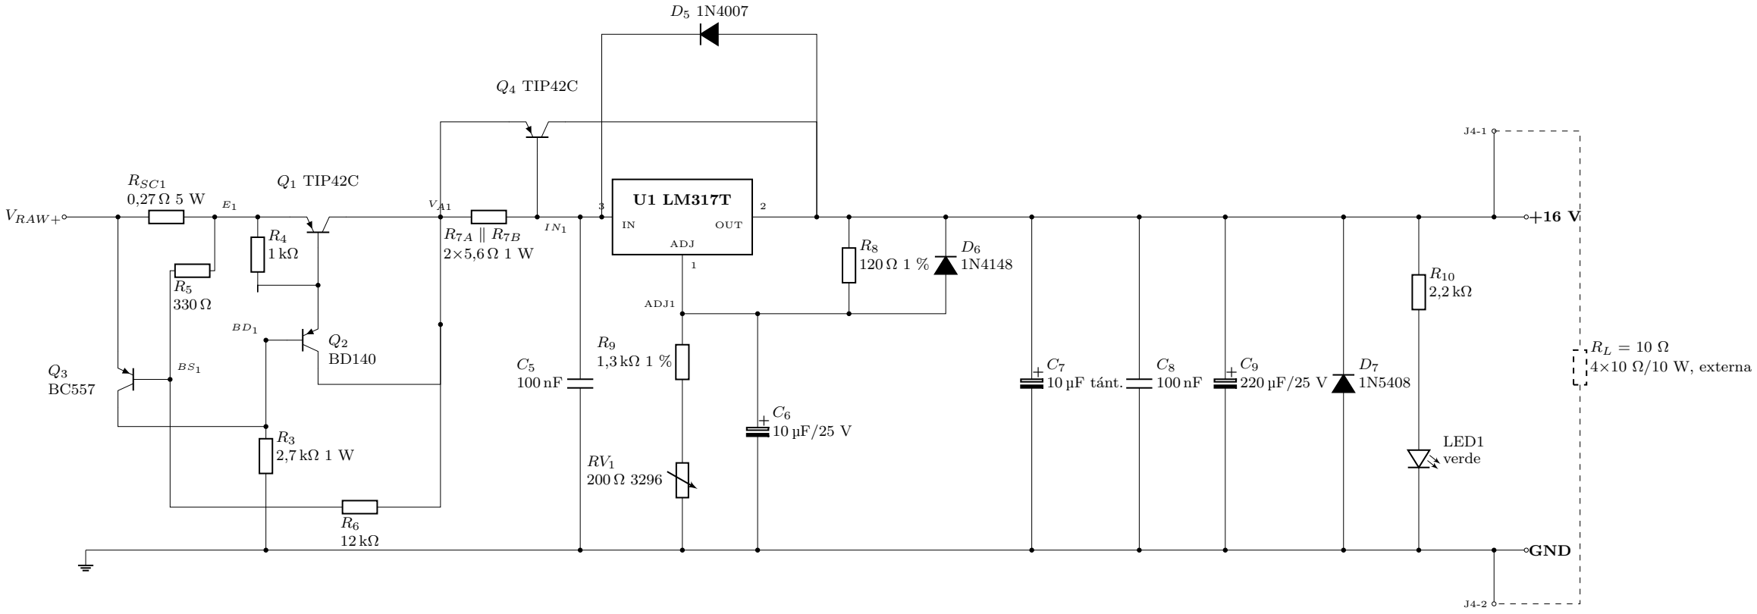
[picture p60: figure]
VRAW+; RSC1 0,27 Ω 5 W E1; Q1 TIP42C; Q4 TIP42C; OUT; ADJ; ADJ1; C7 10 µF t´ant.; LED1 verde; RL = 10 Ω 4×10 Ω/10 W, externa; GND

Riel −16 V: limitador con foldback (RSC2, Q5–Q6, Q7), ampliaci´on de corriente (Q8) y regulador U2

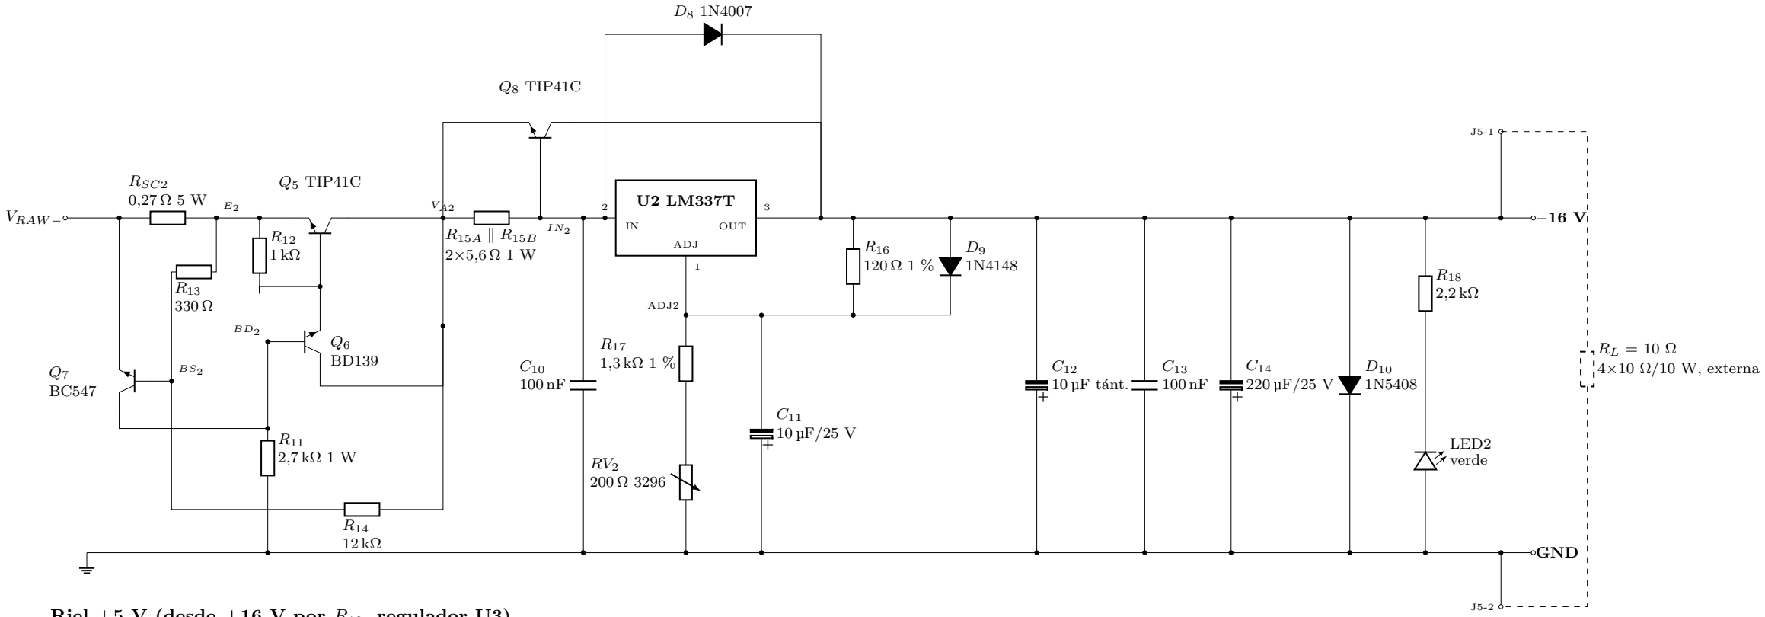
[picture p61: figure]
VRAW−; RSC2 0,27 Ω 5 W E2; Q5 TIP41C; Q8 TIP41C; OUT; ADJ; ADJ2; C12 10 µF t´ant.; LED2 verde; RL = 10 Ω 4×10 Ω/10 W, externa; GND

## Riel +5 V (desde +16 V por R19, regulador U3)

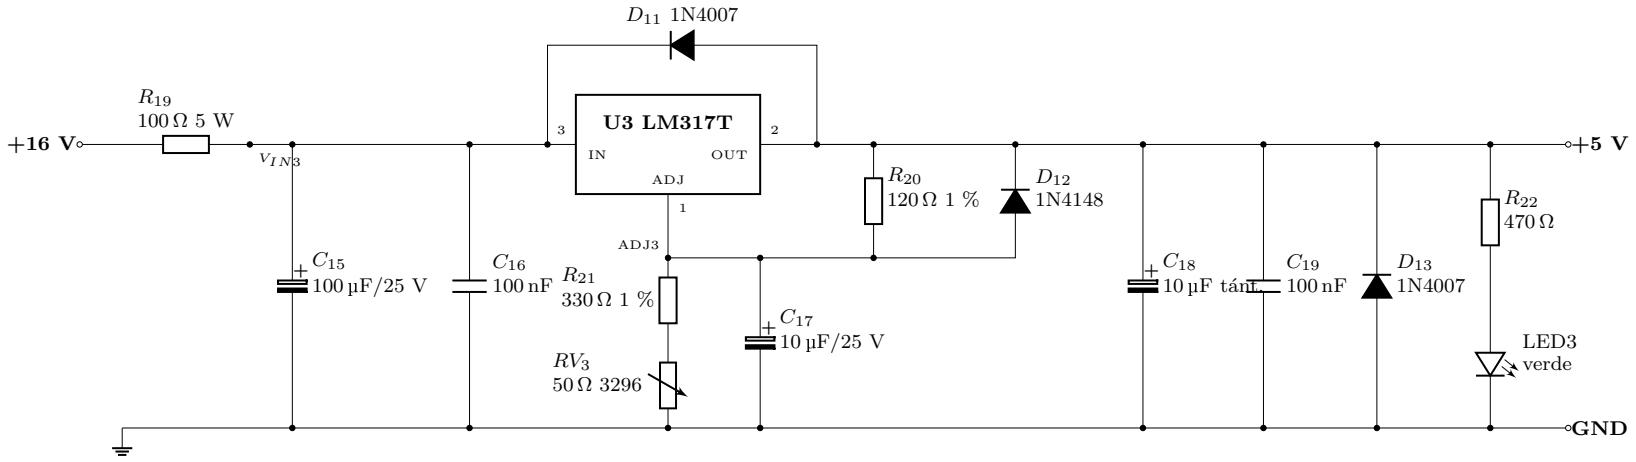
[picture p62: figure]
VIN3; OUT; ADJ; ADJ3; C18 10 µF t´ant.; LED3 verde; GND

## Borneras de salida y puntos de prueba

J2A + J2B (2 borneras de 2 v´ıas)

J2A

J2B

+16 V | 1
−16 V | 2
GND | 1
+5 V | 2

hacia J PWR de las tarjetas PID (J2A-1 +16 V, J2A-2 −16 V,
J2B-1 GND, J2B-2 +5 V: mismo orden que los pines 1–4 de J PWR)

J3 (regleta 1×3)

1 | VRAW+
2 | GND
3 | VRAW−

puntas del osciloscopio para medir el rizado de C1 y C2A/C2B

J4 (+16 V / GND) y J5 (−16 V / GND): borneras de 2 v´ıas para conectar y quitar la resistencia de carga de prueba RL = 10 Ω (ver etapas 2 y 3).

Puntos de prueba TP1–TP15 (pads de 2,6 mm para la punta del mult´ımetro; negra en TP13, TP14 o TP15 = GND)

TP | red | conectado a | esperado | TP | red | conectado a | esperado
TP1 | VRAW+ | C1, RSC1 pin 1 | +25 a +28 V (sin carga) | TP6 | VRAW− | C2A/C2B, RSC2 | −25 a −28 V
TP2 | E1 | RSC1 pin 2, emisor Q1 | TP1 − TP2 = 0,27 Ω · I | TP7 | E2 | RSC2, emisor Q5 | TP7 − TP6 = 0,27 Ω · I
TP3 | VA1 | colector Q1, emisor Q4 | 1–2 V menos que TP2 | TP8 | VA2 | colector Q5, emisor Q8
TP4 | IN1 | entrada U1 | TP3 − TP4 ≤ 1 V | TP9 | IN2 | entrada U2
TP5 | +16 V | salida U1, J4 | 16,0 V (RV1) | TP10 | −16 V | salida U2, J5 | −16,0 V (RV2)
TP11 | VIN5 | entrada U3 (tras R19) | ≈ 10 V | TP12 | +5 V | salida U3 | 5,00 V (RV3)
TP13–15 | GND | tierra | 0 V
