Brahiam18/controlador-pid-analogico-levitador/fuente/informe/figuras/sim_arranque.pdf

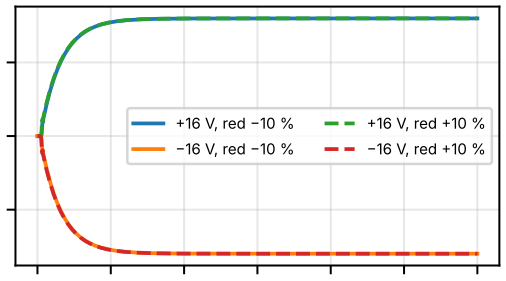
[picture p63: figure]
+16 V, red −10 %; +16 V, red +10 %; −16 V, red −10 %; −16 V, red +10 %

0 | 50 | 100 | 150 | 200 | 250 | 300
| | | t (ms)

−10

0

10

V
