Brahiam18/controlador-pid-analogico-levitador/fuente/informe/figuras/sim_foldback.pdf

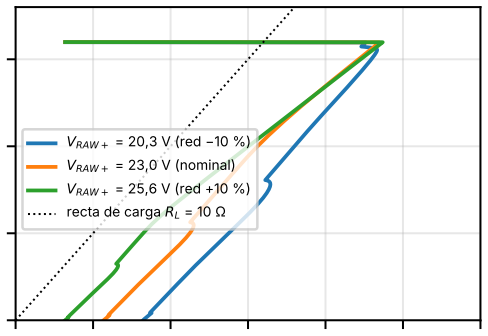
[picture p64: figure]
VRAW + = 20,3 V (red −10 %); VRAW + = 23,0 V (nominal); VRAW + = 25,6 V (red +10 %) recta de carga RL = 10 Ω

0.0 | 0.5 | 1.0 | 1.5 | 2.0 | 2.5 | 3.0
I+16 (A)

0

5

10

15

V+16 (V)
