Brahiam18/controlador-pid-analogico-levitador/docs/voltajes_por_etapa/voltajes_por_etapa.png

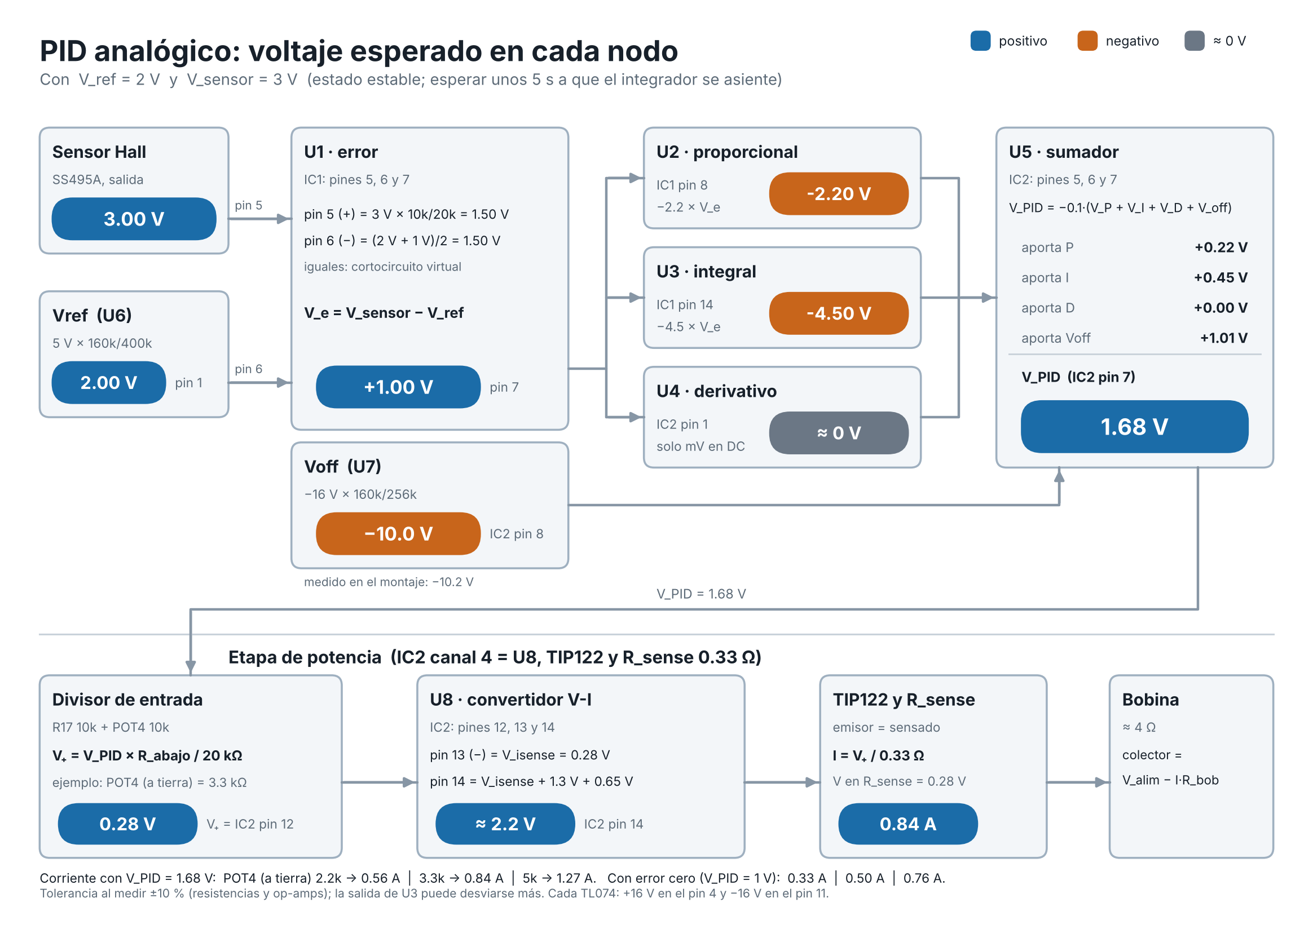
docs/voltajes_por_etapa/voltajes_por_etapa.png
