Brahiam18/controlador-pid-analogico-levitador/fuente/esquematicos/esq_entrada.png

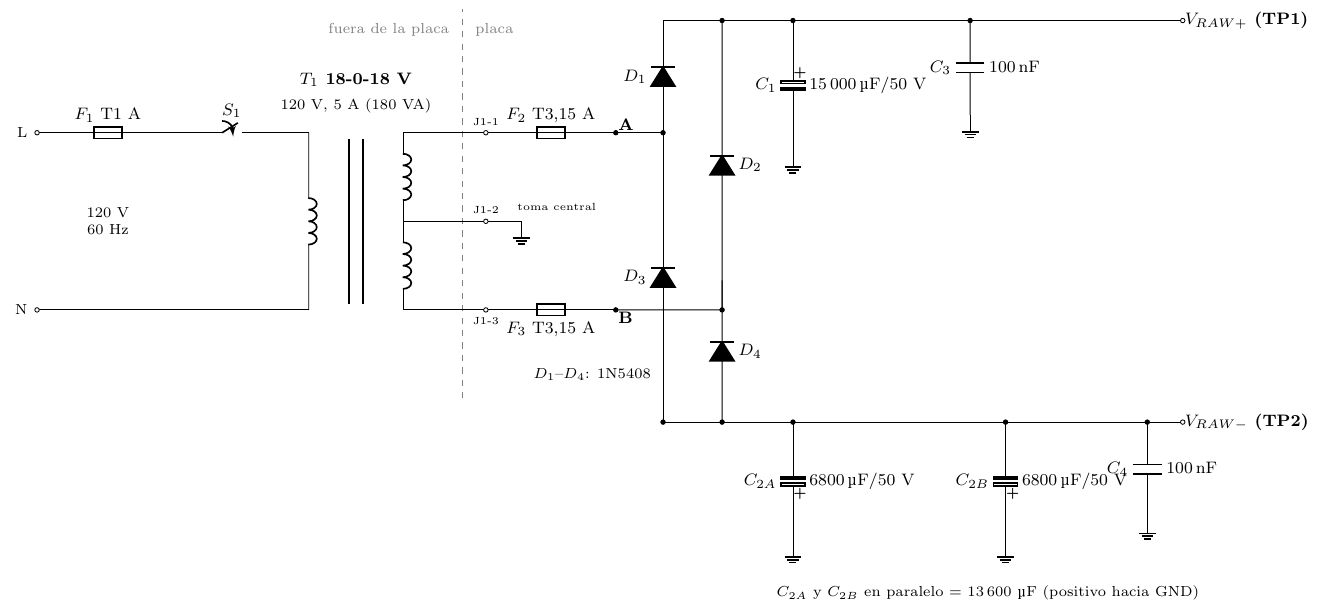
fuente/esquematicos/esq_entrada.png
