Brahiam18/controlador-pid-analogico-levitador/fuente/esquematicos/esq_salida.png

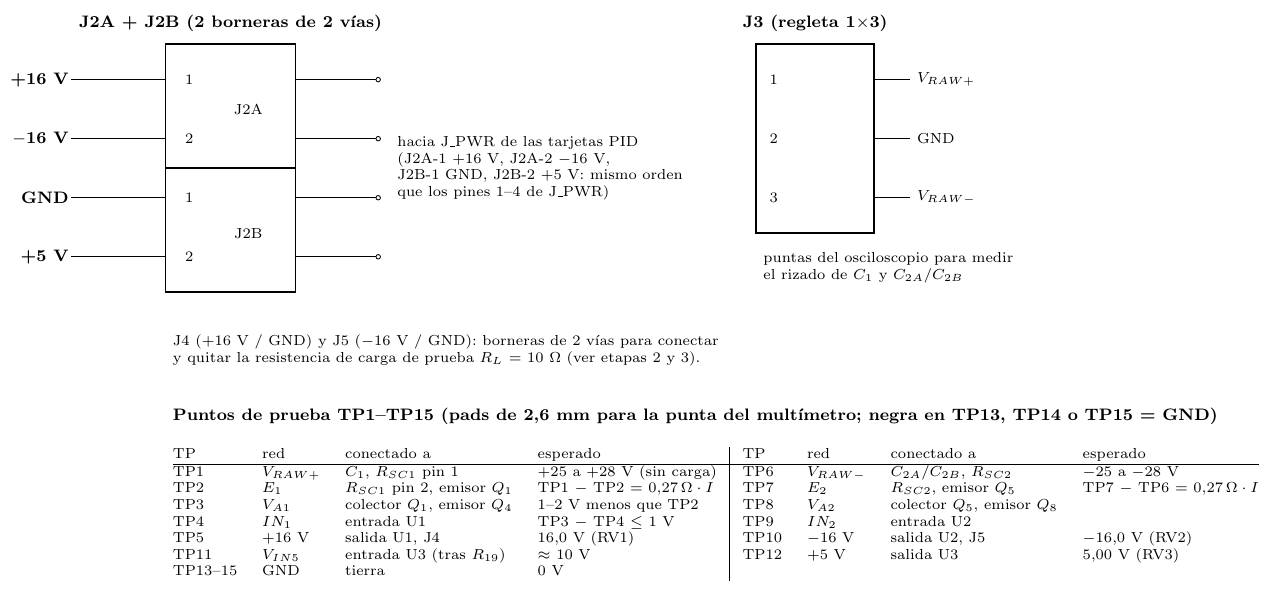
fuente/esquematicos/esq_salida.png
