Brahiam18/controlador-pid-analogico-levitador/fuente/simulacion/figuras/sim_arranque.png

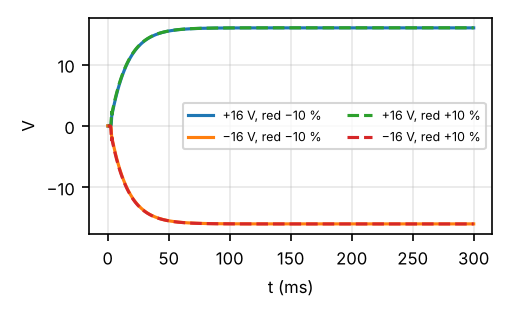
fuente/simulacion/figuras/sim_arranque.png
