Brahiam18/controlador-pid-analogico-levitador/fuente/simulacion/figuras/sim_carga.png

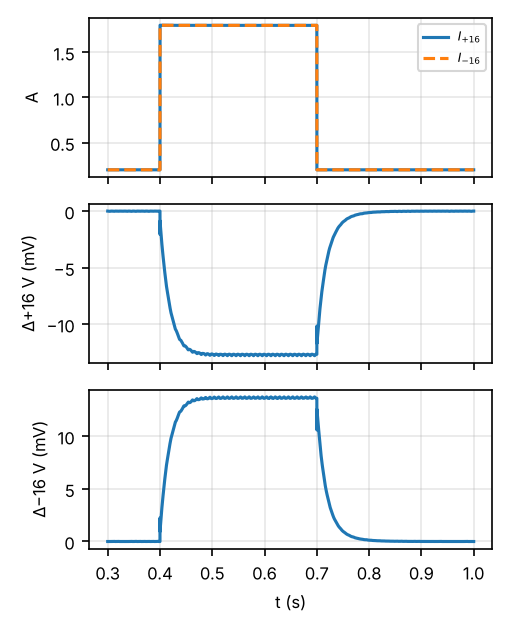
fuente/simulacion/figuras/sim_carga.png
