Brahiam18/controlador-pid-analogico-levitador/fuente/simulacion/figuras/sim_corto.png

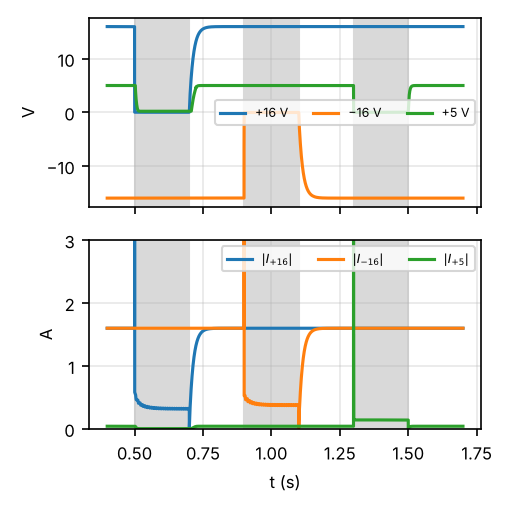
fuente/simulacion/figuras/sim_corto.png
