Brahiam18/controlador-pid-analogico-levitador/fuente/simulacion/figuras/sim_foldback.png

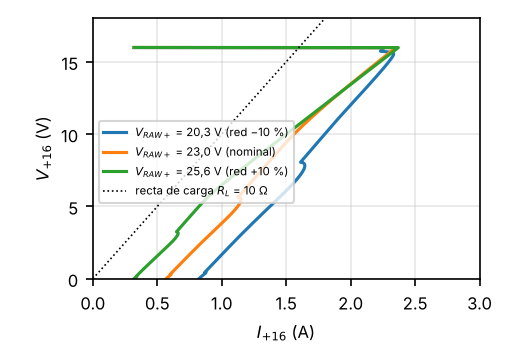
fuente/simulacion/figuras/sim_foldback.png
