Brahiam18/controlador-pid-analogico-levitador/fuente/simulacion/figuras/sim_regimen.png

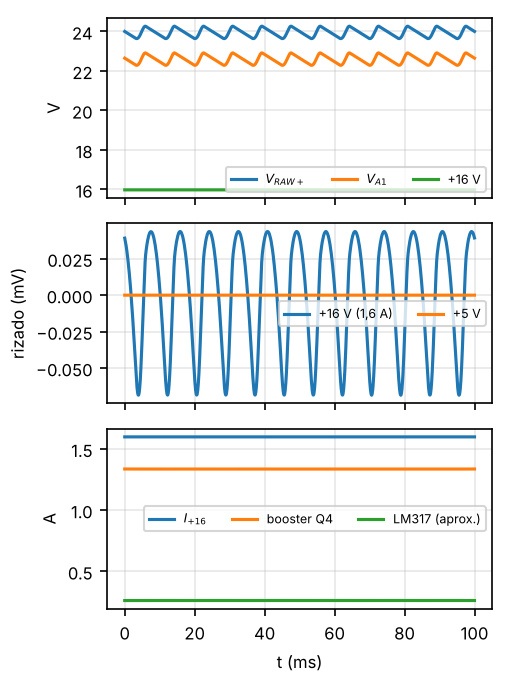
fuente/simulacion/figuras/sim_regimen.png
