Brahiam18/controlador-pid-analogico-levitador/simulacion/magnetica/figuras/fem_1_mapa_campo.png

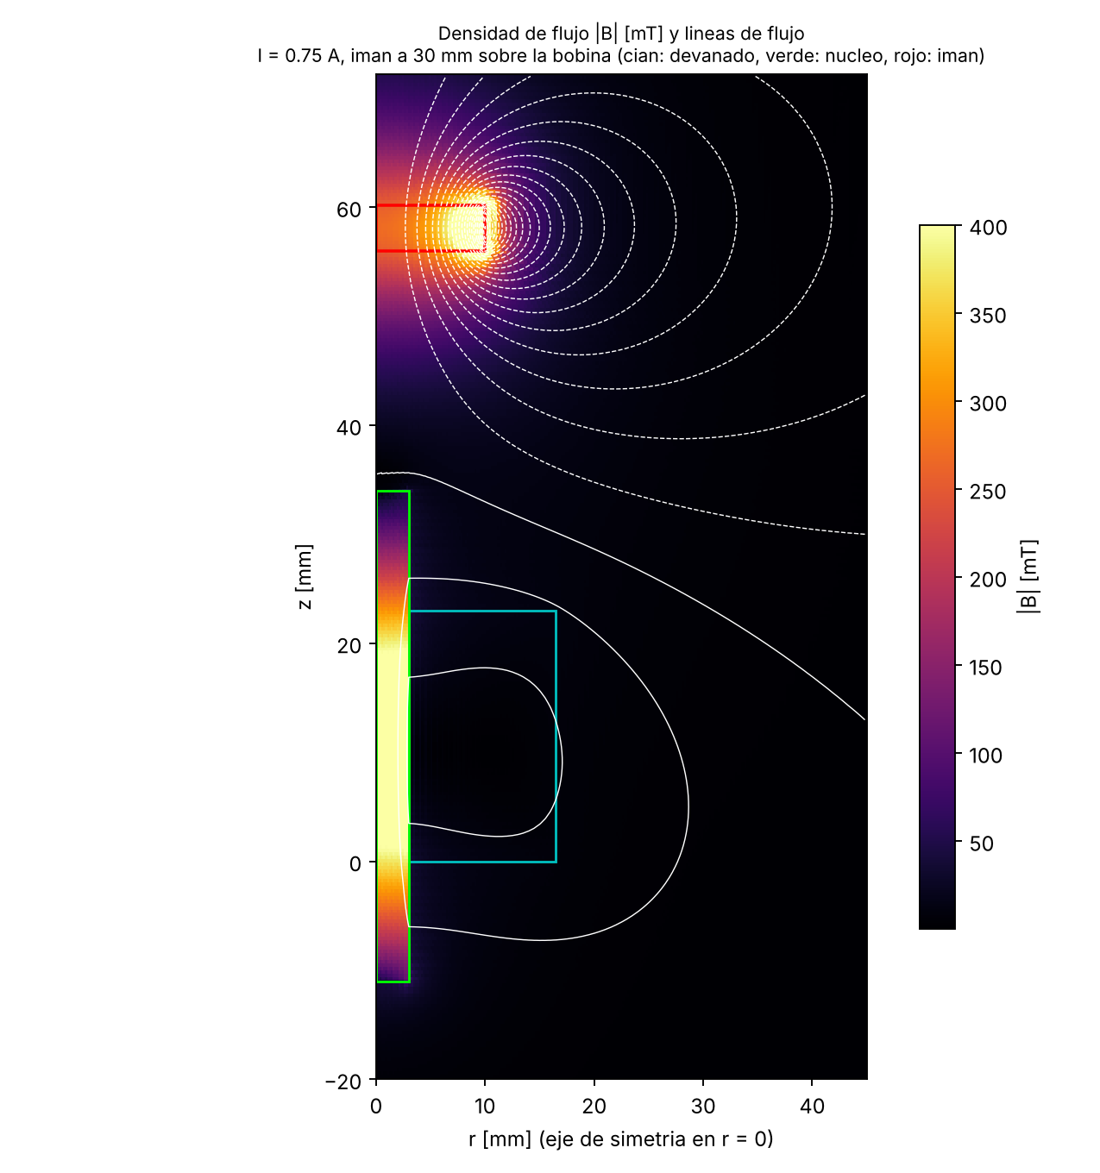
simulacion/magnetica/figuras/fem_1_mapa_campo.png
