Brahiam18/controlador-pid-analogico-levitador/simulacion/magnetica/figuras/fem_2_fuerza_vs_corriente.png

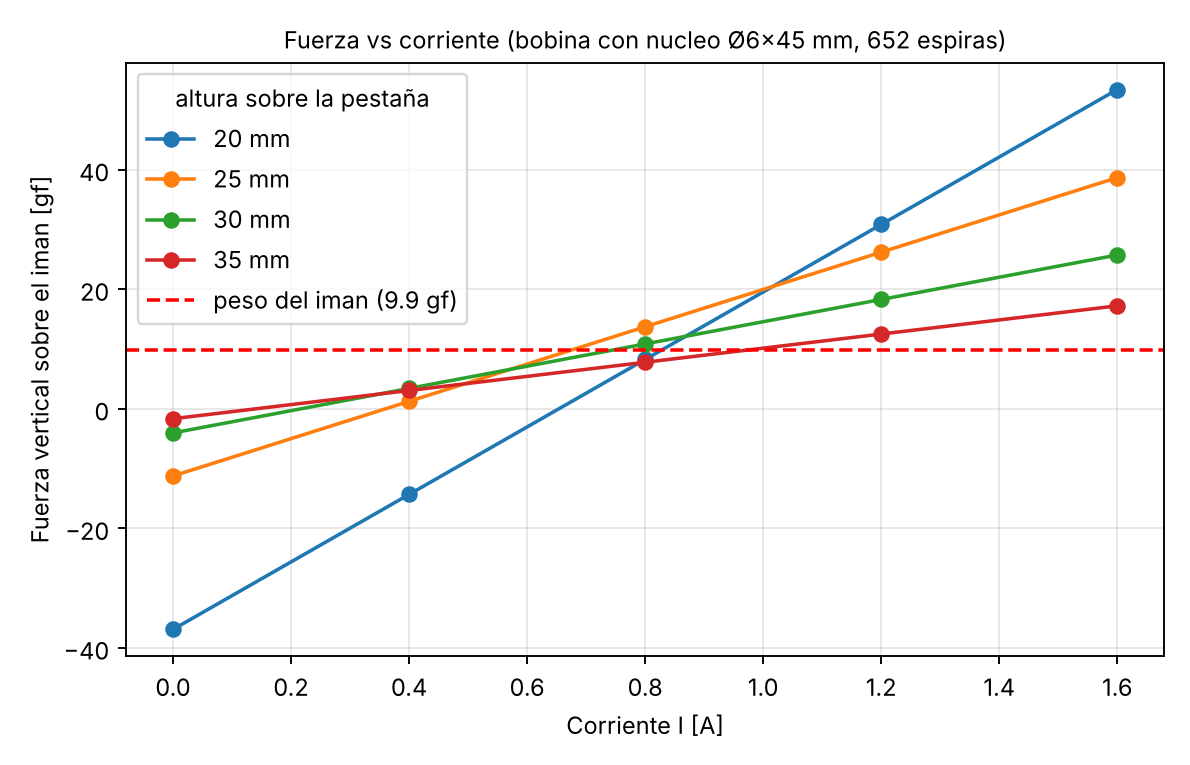
simulacion/magnetica/figuras/fem_2_fuerza_vs_corriente.png
