Brahiam18/controlador-pid-analogico-levitador/simulacion/magnetica/figuras/fem_3_corriente_equilibrio.png

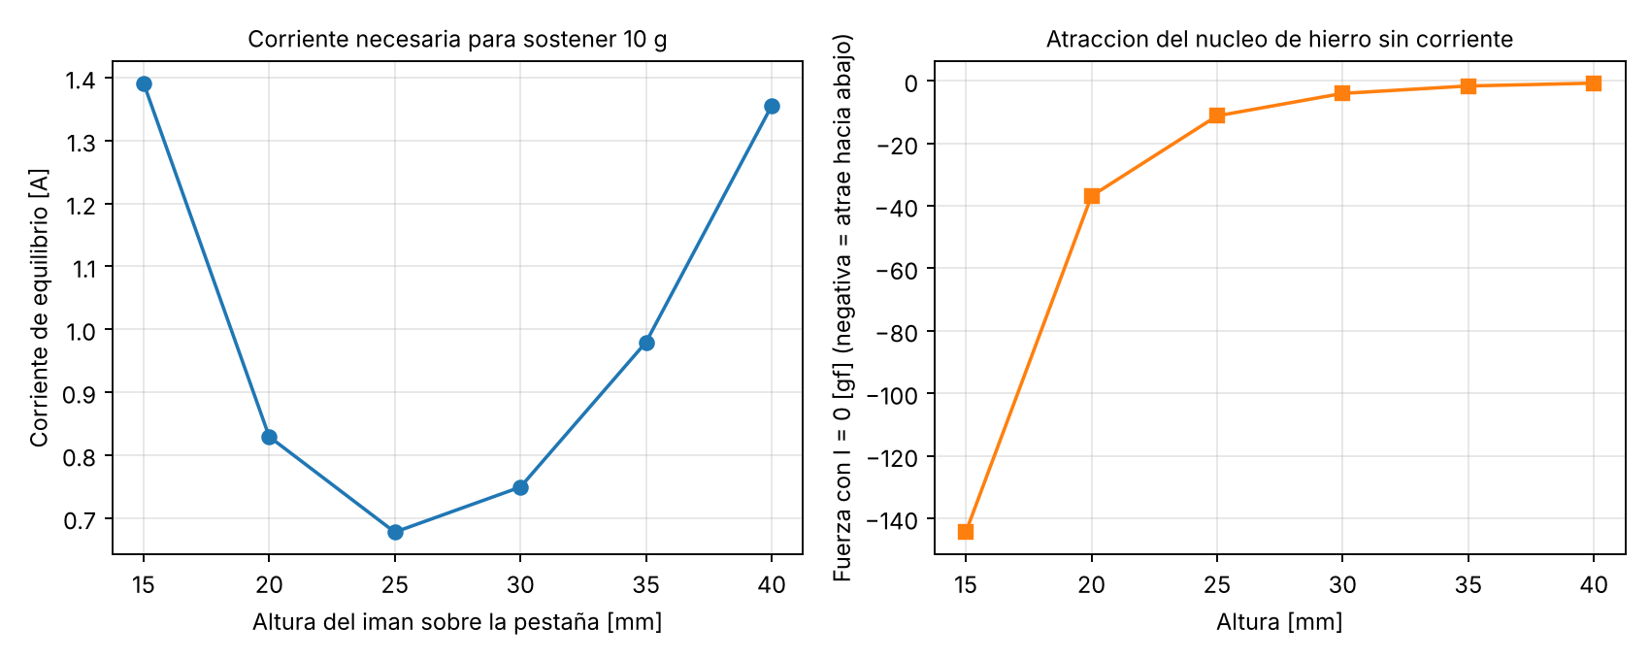
simulacion/magnetica/figuras/fem_3_corriente_equilibrio.png
