Brahiam18/controlador-pid-analogico-levitador/fuente/hardware/Lista_Materiales_Fuente_v2.2.xlsx

Sheet: Lista de compras
Lista de materiales – Fuente ±16 V / 1,6 A y +5 V (versión 2.2)
Cómo usarla: en "¿Ya lo tengo?" y "¿Comprado?" elige Sí/No (celdas amarillas). La fila se tacha y se pone gris cuando tienes la pieza. Escribe los precios que falten en "Precio unit." (amarillo). Precios de las tiendas consultados el 30-oct-2026 (COP); pueden cambiar.
Total de ítems |  |  | 53
Ítems que ya tengo o compré |  |  | 4
Ítems que faltan |  |  | 48
Costo pendiente (con precio conocido) |  |  | $138900
Ítems que faltan sin precio |  |  | 38
¿Ya lo tengo? | ¿Comprado? | Categoría | Referencia | Componente | Valor | Especificación | Cant. | Tienda sugerida | Link | Precio unit. (COP) | Subtotal pendiente (COP) | Notas | Estado
No | No | 1. Entrada | T1 | Transformador | 18-0-18 V / 5 A | Primario 120 V; toma central | 1 | Ferretronica | Abrir (https://www.ferretronica.com/collections/componentes-pasivos/products/transformador-18v-5a-con-tap-central-18-0-18) | $125000 | $125000 | Elegido (v2.1): con el de 3 A la salida cae a 14,6 V con red baja en Proteus. El de 2 A NO sirve | Falta
No | No | 1. Entrada | F1 | Fusible lento + portafusible de chasis | T1 A | 5x20 mm 250 V | 1 | Cualquier tienda |  |  | $0 | Fuera de la placa, en el primario | Falta
No | No | 1. Entrada | F2, F3 | Fusible lento + portafusible de PCB | T3,15 A | 5x20 mm | 2 | Cualquier tienda |  |  | $0 | Uno por mitad del secundario | Falta
No | No | 1. Entrada | S1 | Interruptor de balancín | — | 250 VAC 3 A | 1 | Cualquier tienda |  |  | $0 |  | Falta
No | No | 1. Entrada | — | Cable de poder con clavija | — | 2 x 18 AWG | 1 | Cualquier tienda |  |  | $0 | Aislar empalmes con termoencogible | Falta
Sí | No | 2. Reguladores | U1, U3 | Regulador ajustable positivo | LM317T | TO-220 | 2 | Cualquier tienda |  |  | $0 | Ya disponibles. Opcional: LM350T (3 A) en U1, mismo pinout | Lo tengo
Sí | No | 2. Reguladores | U2 | Regulador ajustable negativo | LM337T | TO-220 | 1 | Cualquier tienda |  |  | $0 | Ya disponible | Lo tengo
No | No | 2. Reguladores | U1 (opcional) | Regulador 3 A (sustituto de U1) | LM350T | TO-220 | 0 | Zamux (Bogotá) | Abrir (https://www.zamux.co/regulador-de-voltaje-lm350t) | $2900 | $0 | Cantidad 0 = no se compra. Poner 1 si se quiere | Opcional
No | No | 3. Transistores | Q1, Q4 | Transistor PNP de potencia | TIP42C | TO-220 6 A 65 W | 2 | Ferretronica | Abrir (https://www.ferretronica.com/products/tip42c-transistor-bjt-pnp-100v-6a-to-220) | $1100 | $2200 | Con mica y buje | Falta
No | No | 3. Transistores | Q5, Q8 | Transistor NPN de potencia | TIP41C | TO-220 6 A 65 W | 2 | Ferretronica |  | $1100 | $2200 | En Ferretronica (buscar TIP41C) | Falta
No | No | 3. Transistores | Q2 | Transistor PNP mediana potencia | BD140 | TO-126 | 1 | Ferretronica | Abrir (https://www.ferretronica.com/products/bd140-transistor-bjt-pnp-80v-1-5a-to-126) | $1000 | $1000 | Al disipador con mica | Falta
No | No | 3. Transistores | Q6 | Transistor NPN mediana potencia | BD139 | TO-126 | 1 | Ferretronica | Abrir (https://www.ferretronica.com/products/bd139-transistor-bjt-npn-80v-1-5a-to-126) | $1000 | $1000 | Al disipador con mica | Falta
No | No | 3. Transistores | Q3 | Transistor PNP de señal | BC557 | TO-92 | 1 | Cualquier tienda |  |  | $0 | Sustituto 2N3906 (girado 180°) | Falta
No | No | 3. Transistores | Q7 | Transistor NPN de señal | BC547 | TO-92 | 1 | Cualquier tienda |  |  | $0 | Sustituto 2N3904 (girado 180°) | Falta
No | No | 4. Diodos y LED | D1-D4, D7, D10 | Diodo rectificador | 1N5408 | 3 A 1000 V DO-201 | 6 | Cualquier tienda |  |  | $0 | D1-D4 puente; D7, D10 polaridad inversa | Falta
No | No | 4. Diodos y LED | D5, D8, D11, D13 | Diodo | 1N4007 | 1 A DO-41 | 4 | Cualquier tienda |  |  | $0 |  | Falta
No | No | 4. Diodos y LED | D6, D9, D12 | Diodo de señal | 1N4148 | DO-35 | 3 | Cualquier tienda |  |  | $0 |  | Falta
No | No | 4. Diodos y LED | LED1-LED3 | LED | Verde | 5 mm | 3 | Cualquier tienda |  |  | $0 |  | Falta
No | No | 5. Resistencias de potencia | RSC1, RSC2 | Resistencia de cemento | 0,27 Ω | 5 W | 2 | Ferretronica | Abrir (https://www.ferretronica.com/products/resistencias-5-w-de-0-1-ohm-a-820-ohm) | $500 | $1000 | Elegir 0.27 Ω en la página | Falta
No | No | 5. Resistencias de potencia | R19 | Resistencia de cemento | 100 Ω | 5 W (en lugar de 3 W) | 1 | Ferretronica | Abrir (https://www.ferretronica.com/products/resistencias-5-w-de-0-1-ohm-a-820-ohm) | $500 | $500 | Elegir 100 Ω; dejar levantada de la placa | Falta
No | No | 5. Resistencias de potencia | R7A, R7B, R15A, R15B | Resistencia metal óxido | 5,6 Ω | 1 W | 4 | Cualquier tienda |  |  | $0 | v2.2: dos en paralelo por riel (2,8 Ω). Si consigues 2,7 Ω / 1 W, compra 2 y monta solo R7A y R15A | Falta
No | No | 5. Resistencias de potencia | R3, R11 | Resistencia | 2,7 kΩ | 1 W | 2 | Ferretronica | Abrir (https://www.ferretronica.com/products/resistencias-1-w-de-1-kohm-a-1-mohm) | $200 | $400 | Elegir 2.7 KΩ | Falta
No | No | 5. Resistencias de potencia | RL (externa) | Resistencia cerámica (carga de prueba) | 10 Ω | 10 W | 4 | Ferretronica | Abrir (https://www.ferretronica.com/products/resistencias-10-w-de-0-1-ohm-a-820-ohm) | $1000 | $4000 | 2 en serie x 2 en paralelo = 10 Ω; 6,4 W c/u | Falta
No | No | 6. Resistencias ¼ W | R4, R12 | Resistencia | 1 kΩ | 1/4 W | 2 | Cualquier tienda |  |  | $0 |  | Falta
No | No | 6. Resistencias ¼ W | R5, R13 | Resistencia | 330 Ω | 1/4 W 1 % | 2 | Cualquier tienda |  |  | $0 | Divisor de foldback (v2.1: antes 270 Ω) | Falta
No | No | 6. Resistencias ¼ W | R6, R14 | Resistencia | 12 kΩ | 1/4 W 1 % | 2 | Cualquier tienda |  |  | $0 | Divisor de foldback | Falta
No | No | 6. Resistencias ¼ W | R8, R16, R20 | Resistencia película metálica | 120 Ω | 1/4 W 1 % | 3 | Cualquier tienda |  |  | $0 |  | Falta
No | No | 6. Resistencias ¼ W | R9, R17 | Resistencia película metálica | 1,3 kΩ | 1/4 W 1 % | 2 | Cualquier tienda |  |  | $0 | Alternativa 1,2 kΩ + 100 Ω en serie | Falta
No | No | 6. Resistencias ¼ W | R21 | Resistencia película metálica | 330 Ω | 1/4 W 1 % | 1 | Cualquier tienda |  |  | $0 |  | Falta
No | No | 6. Resistencias ¼ W | R10, R18 | Resistencia | 2,2 kΩ | 1/4 W | 2 | Cualquier tienda |  |  | $0 | LED de ±16 V | Falta
No | No | 6. Resistencias ¼ W | R22 | Resistencia | 470 Ω | 1/4 W | 1 | Cualquier tienda |  |  | $0 | LED de +5 V | Falta
No | No | 6. Resistencias ¼ W | RV1, RV2 | Trimmer multivuelta | 200 Ω | 3296W | 2 | Cualquier tienda |  |  | $0 | Ajuste de ±16 V | Falta
No | No | 6. Resistencias ¼ W | RV3 | Trimmer multivuelta | 50 Ω | 3296W | 1 | Cualquier tienda |  |  | $0 | Ajuste de +5 V | Falta
Sí | No | 7. Condensadores | C1 | Electrolítico | 15 000 µF | 50 V, Ø ≤ 35 mm, paso 10 mm | 1 | Cualquier tienda |  |  | $0 | Ya disponible | Lo tengo
Sí | No | 7. Condensadores | C2A, C2B | Electrolítico | 6800 µF | 50 V, Ø 28 mm, paso 10 mm | 2 | Cualquier tienda |  |  | $0 | Ya disponibles | Lo tengo
No | No | 7. Condensadores | C3, C4, C5, C8, C10, C13, C16, C19 | Cerámico | 100 nF | 50 V (C3, C4 de 100 V) | 8 | Cualquier tienda |  |  | $0 |  | Falta
No | No | 7. Condensadores | C6, C11, C17 | Electrolítico | 10 µF | 25 V | 3 | Cualquier tienda |  |  | $0 |  | Falta
No | No | 7. Condensadores | C7, C12, C18 | Tántalo | 10 µF | 25 V | 3 | Cualquier tienda |  |  | $0 | Respetar polaridad | Falta
No | No | 7. Condensadores | C9, C14 | Electrolítico | 220 µF | 25 V | 2 | Cualquier tienda |  |  | $0 |  | Falta
No | No | 7. Condensadores | C15 | Electrolítico | 100 µF | 25 V | 1 | Cualquier tienda |  |  | $0 |  | Falta
No | No | 8. Conectores | J1 | Bornera de tornillo | 3 vías | paso 5,08 mm | 1 | Cualquier tienda |  |  | $0 | Secundario A / CT / B | Falta
No | No | 8. Conectores | J2A, J2B | Bornera de tornillo | 2 vías | paso 5,08 mm, encajadas | 2 | Cualquier tienda |  |  | $0 | Salida a J_PWR de los PID (en lugar de una de 4 vías) | Falta
No | No | 8. Conectores | J4, J5 | Bornera de tornillo | 2 vías | paso 5,08 mm | 2 | Cualquier tienda |  |  | $0 | Carga de prueba RL removible | Falta
No | No | 8. Conectores | J3 | Regleta macho | 1x3 | 2,54 mm | 1 | Cualquier tienda |  |  | $0 | Rizado con el osciloscopio | Falta
No | No | 8. Conectores | TP1-TP15 | Punto de prueba (pad) | — | alambre 22 AWG en U o pin de regleta (opcional) | 15 | Cualquier tienda |  |  | $0 | v2.2: puntos para el multímetro; se puede medir directo sobre el pad | Falta
No | No | 9. Mecánica | — | Disipador de aluminio aletado | ≤ 2 °C/W | ≈ 100 x 69 x 36 mm | 2 | Mercado Libre | Abrir (https://www.mercadolibre.com.co/disipador-de-calor-con-amplificador-de-potencia-de-aluminio/p/MCO2001400103) |  | $0 | Uno por riel; verificar medidas antes de comprar | Falta
No | No | 9. Mecánica | — | Mica TO-220 con buje | — | sirve también para TO-126 | 8 | JK Electronics (Pamplona) | Abrir (https://jkelectronics.co/producto/aislante-de-mica-to-220/) | $200 | $1600 | Preguntar primero en Ferretronica | Falta
No | No | 9. Mecánica | — | Tornillos M3 + tuercas | M3 x 10 mm |  | 8 | Cualquier tienda |  |  | $0 | Para fijar al disipador | Falta
No | No | 9. Mecánica | — | Grasa térmica | — |  | 1 | Cualquier tienda |  |  | $0 |  | Falta
No | No | 9. Mecánica | — | Baquela una cara | 20 x 15 cm | FR-4 o fibra | 1 | Cualquier tienda |  |  | $0 | Placa de 190,5 x 139,7 mm | Falta
No | No | 9. Mecánica | — | Separadores M3 | 10 mm |  | 4 | Cualquier tienda |  |  | $0 | Agujeros de montaje | Falta
No | No | 9. Mecánica | — | Alambre aislado | 22 AWG |  | 1 | Cualquier tienda |  |  | $0 | 1 m, para los 7 puentes | Falta
No | No | 9. Mecánica | — | Cable para RL y salidas | 18 AWG |  | 1 | Cualquier tienda |  |  | $0 | 1 m | Falta

Sheet: Por tienda
Pedido por tienda (solo lo que falta)
Tienda | Ítems que faltan | Costo pendiente (COP)
Ferretronica | 9 | $137300
JK Electronics (Pamplona) | 1 | $1600
Mercado Libre | 1 | $0
Zamux (Bogotá) | 0 | $0
Cualquier tienda | 37 | $0
Total | 48 | $138900
Las piezas sin tienda (diodos, condensadores, resistencias de ¼ W, conectores) se consiguen en cualquier tienda de electrónica; escribe su precio en la hoja principal.
