Brahiam18/controlador-pid-analogico-levitador/fuente/pruebas/mediciones.csv

Prueba | Magnitud | Condición | Esperado (cálculo) | Esperado (simulación) | Medido | Error % | Observaciones
P1 | V AC mitad A (J1-1 a J1-2) | sin carga | 18-20 V rms | 19.4 V rms (modelo)
P1 | V AC mitad B (J1-2 a J1-3) | sin carga | 18-20 V rms | 19.4 V rms (modelo)
P1 | V_RAW+ | sin carga | +25 a +28 V | —
P1 | V_RAW- | sin carga | -25 a -28 V | —
P2 | +16 V ajustado | sin carga | 16.00 V | 15.99 V
P2 | Rango RV1 | giro completo | 14.86 a 16.95 V | —
P2 | -16 V ajustado | sin carga | -16.00 V | -15.99 V
P2 | Rango RV2 | giro completo | -14.88 a -16.97 V | —
P2 | +5 V ajustado | sin carga | 5.00 V | 5.00 V
P2 | Rango RV3 | giro completo | 4.70 a 5.23 V | —
P3 | +16 V sin RL (V_ro) | J4 libre | 16.00 V | 15.991 V
P3 | +16 V con RL (V_r) | RL 10 ohm en J4 | ≥ 15.92 V | 15.977 V
P3 | I por RL (+16) | RL 10 ohm en J4 | ≥ 1.5 A (1.6 A) | 1.598 A
P3 | %Reg +16 V | — | ≤ 0.5 % | 0.09 %
P3 | -16 V sin RL (V_ro) | J5 libre | -16.00 V | -15.993 V
P3 | -16 V con RL (V_r) | RL 10 ohm en J5 | ≤ -15.92 V | -15.978 V
P3 | I por RL (-16) | RL 10 ohm en J5 | ≥ 1.5 A (1.6 A) | 1.598 A
P3 | %Reg -16 V | — | ≤ 0.5 % | 0.10 %
P3 | +5 V sin / con 120 ohm | — | 5.00 V | 5.000 V
P4 | Rizado sobre C1 | RL en J4 | 0.93 V pp | 0.60 V pp
P4 | Rizado sobre C2A/C2B | RL en J5 | 1.00 V pp | 0.65 V pp
P4 | Frecuencia del rizado | — | 120 Hz | 120 Hz
P4 | Rizado +16 V | RL en J4 | < 1 mV pp | 0.11 mV pp
P4 | Rizado -16 V | RL en J5 | < 1 mV pp | 0.12 mV pp
P5 | Delta +16 V | red 103.5 a 126.5 V con RL | < 33 mV | 8.8 mV
P6 | I de corto +16 V | sin RL (red nominal) | 0.54 A (0.29-0.79 A según red) | 0.32 A ngspice / 0.60 A Proteus
P6 | I de corto -16 V | sin RL (red nominal) | 0.54 A (0.29-0.79 A según red) | 0.38 A ngspice
P6 | I de corto +5 V | — | 0.145 A | 0.14 A
P6 | +16 V tras quitar el corto con RL | RL en J4 | 16.0 V | 15.98 V
P6 | -16 V tras quitar el corto con RL | RL en J5 | -16.0 V | -15.98 V
P6 | +16 V durante corto de +5 V | — | 16.0 V | 15.98 V
P6 | T disipador tras 60 s de corto | — | < 75 °C | —
P7 | I máxima antes de caer (+16) | sobrecarga | 2.5 A | 2.36 A
P7 | I con V = 1 V (+16) | sobrecarga | 0.9 A | 1.01 A
P8 | Arranques con RL (5 veces) | RL en J4 | 16 V siempre | 16 V
P9 | T disipador superior | 30 min con RL | < 75 °C | —
P9 | T disipador inferior | 30 min con RL | < 75 °C | —
P10 | +16 V en pin 4 de los TL074 | tarjetas conectadas | 16.0 V | —
P10 | -16 V en pin 11 de los TL074 | tarjetas conectadas | -16.0 V | —
P10 | +5 V en las tarjetas | tarjetas conectadas | 5.00 V | —
