Brahiam18/controlador-pid-analogico-levitador/hardware/mecanica/base_mdf_fabricacion.dxf

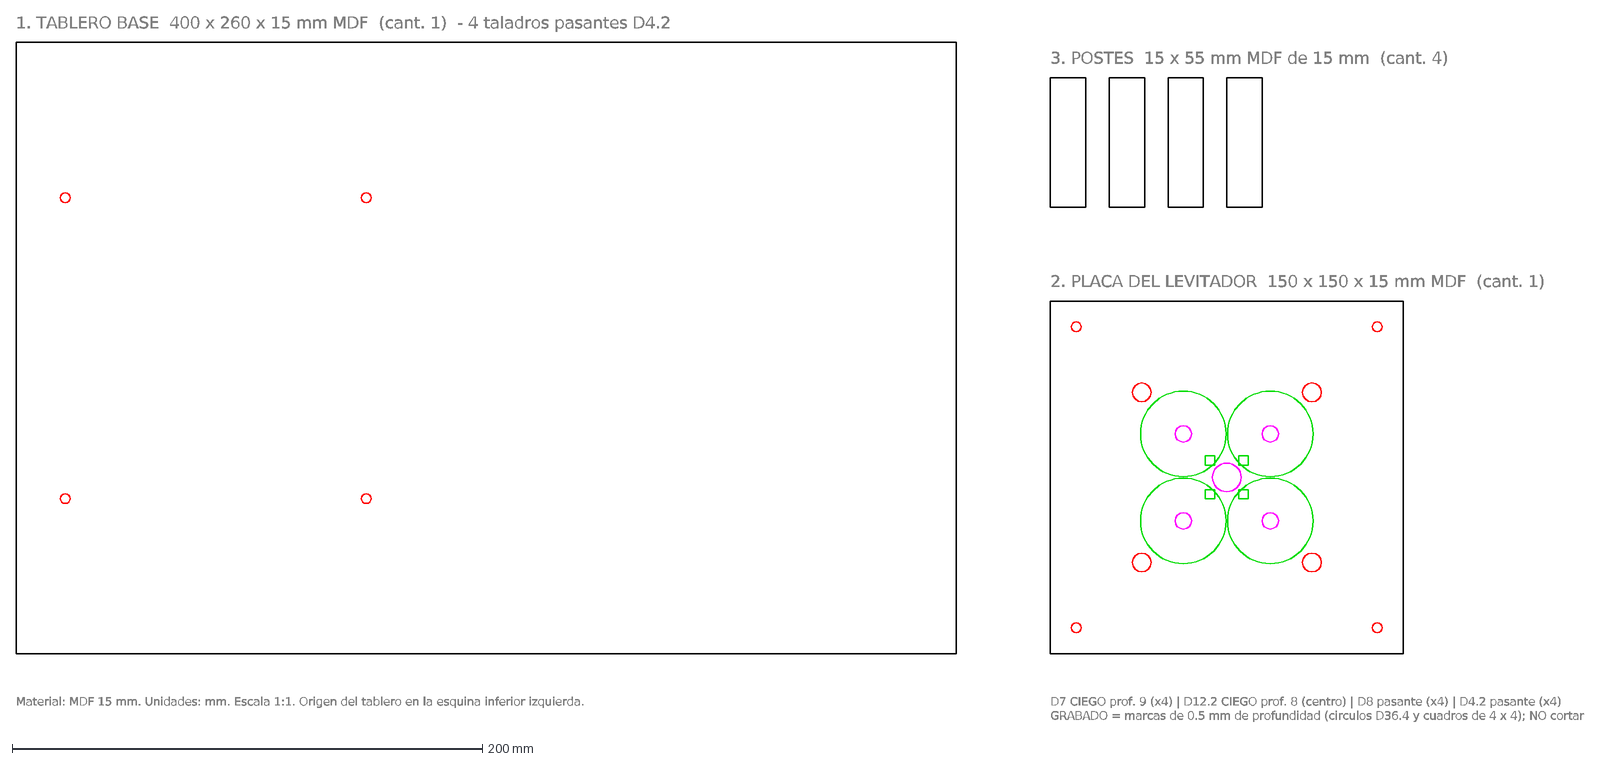
[picture p76: CAD file, 2026-11-09]
hardware/mecanica/base_mdf_fabricacion.dxf
1. TABLERO BASE 400 x 260 x 15 mm MDF (cant. 1) - 4 taladros pasantes D4.2
2. PLACA DEL LEVITADOR 150 x 150 x 15 mm MDF (cant. 1)
D7 CIEGO prof. 9 (x4) | D12.2 CIEGO prof. 8 (centro) | D8 pasante (x4) | D4.2 pasante (x4)
GRABADO = marcas de 0.5 mm de profundidad (circulos D36.4 y cuadros de 4 x 4); NO cortar
3. POSTES 15 x 55 mm MDF de 15 mm (cant. 4)
Material: MDF 15 mm. Unidades: mm. Escala 1:1. Origen del tablero en la esquina inferior izquierda.
