Brahiam18/controlador-pid-analogico-levitador/hardware/mecanica/impresion_3d/soporte_bobinas.stl

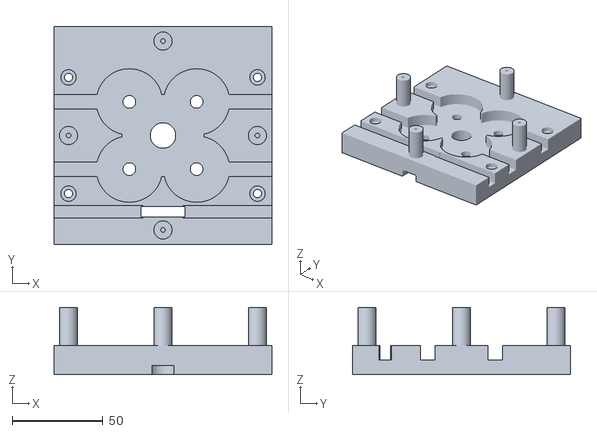
[picture p77: CAD file, 2026-11-10]
hardware/mecanica/impresion_3d/soporte_bobinas.stl
120.0 x 120.0 x 37.0
