Brahiam18/controlador-pid-analogico-levitador/hardware/mecanica/impresion_3d/capuchon_sensor.stl

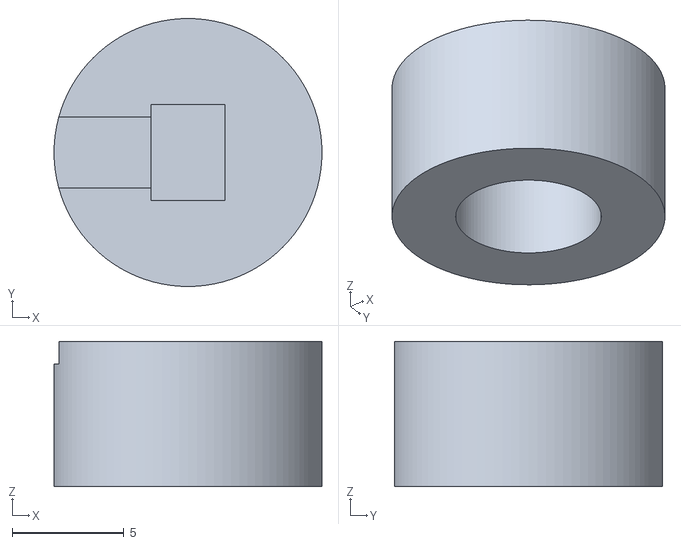
[picture p78: CAD file, 2026-11-10]
hardware/mecanica/impresion_3d/capuchon_sensor.stl
12.0 x 12.0 x 6.50
