Brahiam18/controlador-pid-analogico-levitador/hardware/mecanica/tablero_base.dxf

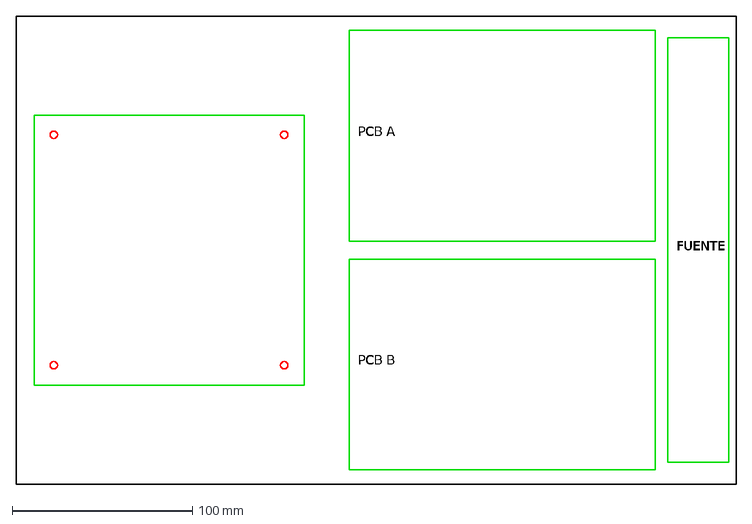
[picture p79: CAD file, 2026-11-09]
hardware/mecanica/tablero_base.dxf
PCB A
PCB B
FUENTE
