Brahiam18/controlador-pid-analogico-levitador/hardware/mecanica/impresion_3d/tapa_bobinas.stl

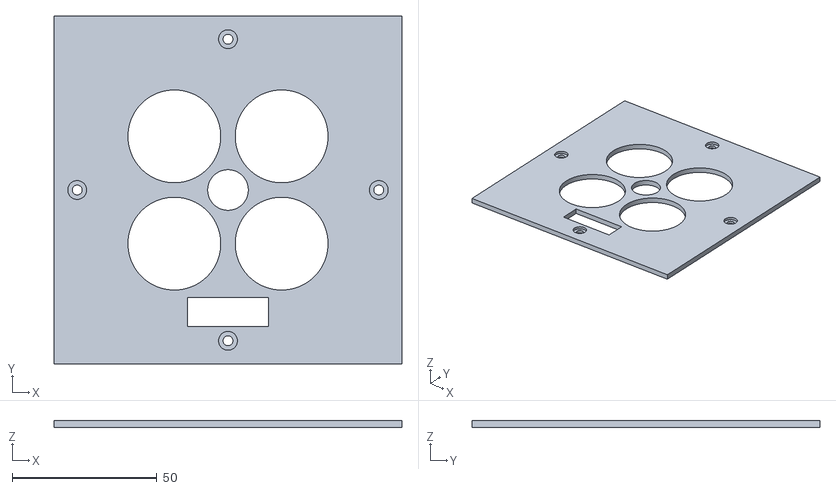
[picture p80: CAD file, 2026-11-10]
hardware/mecanica/impresion_3d/tapa_bobinas.stl
120.0 x 120.0 x 2.50
