Brahiam18/controlador-pid-analogico-levitador/hardware/mecanica/placa_levitador.dxf

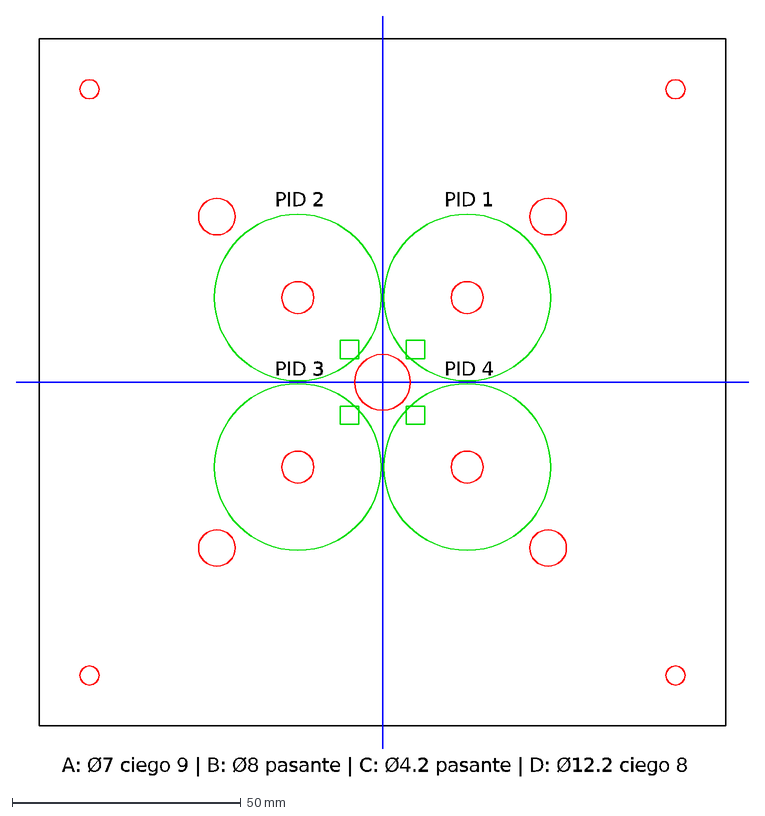
[picture p81: CAD file, 2026-11-09]
hardware/mecanica/placa_levitador.dxf
PID 1
PID 2
PID 3
PID 4
A: Ø7 ciego 9 | B: Ø8 pasante | C: Ø4.2 pasante | D: Ø12.2 ciego 8
