Brahiam18/controlador-pid-analogico-levitador/hardware/mecanica/impresion_3d/bandeja_baqueta.stl

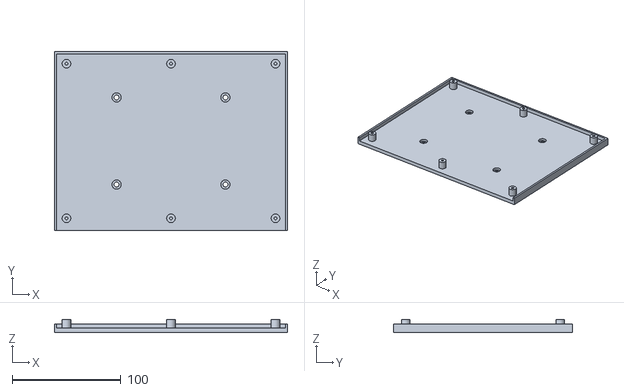
[picture p82: CAD file, 2026-11-10]
hardware/mecanica/impresion_3d/bandeja_baqueta.stl
214.0 x 164.0 x 12.0
