Brahiam18/controlador-pid-analogico-levitador/pruebas/montaje/README.md

# Montaje de los 4 PID con la base impresa en 3D (noviembre de 2026)

| Archivo | Contenido |
|---|---|
| `montaje_2026-11_base_y_placa.jpg` | Base impresa en 3D con las 4 bobinas (núcleos de hierro, soportes blancos de los sensores Hall) junto a una de las dos placas de 2 PID. |
| `montaje_2026-11_banco_4_pid.jpg` | Banco con las dos placas conectadas a la base y fuentes de laboratorio: ±16 V para los operacionales y 9 V para las bobinas. |

Estado en esta fecha: los 4 PID funcionan por separado (etapas, sumador, convertidor V-I y corriente por bobina), pero no se llegó a la levitación estable a 3 cm. Ver [`../../docs/estado_del_proyecto.md`](../../docs/estado_del_proyecto.md) y [`../../docs/plan_2027.md`](../../docs/plan_2027.md).
