Brahiam18/controlador-pid-analogico-levitador/pruebas/montaje/montaje_2026-11_base_y_placa.jpg

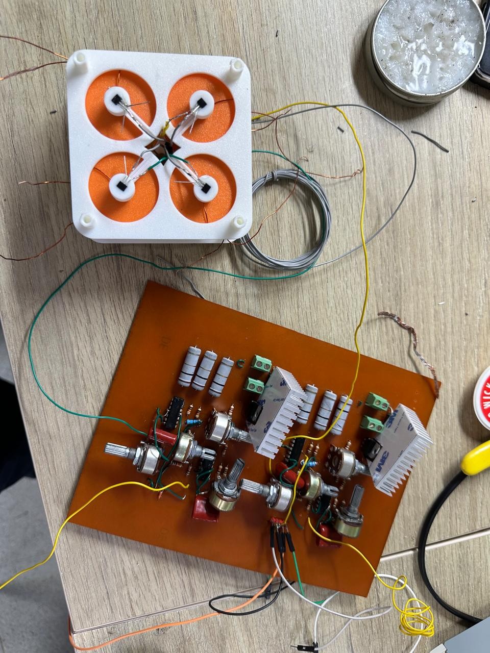
pruebas/montaje/montaje_2026-11_base_y_placa.jpg
