Brahiam18/controlador-pid-analogico-levitador/pruebas/levitacion/README.md

# Pruebas de levitación

Pendiente: fotos de cada uno de los 4 PID con el objeto levitando y el voltaje de referencia usado en cada altura.

| PID | Bobina | Altura (mm) | `V_ref` (V) | Foto |
|:-:|:-:|:-:|:-:|---|
| 1 | | | | |
| 2 | | | | |
| 3 | | | | |
| 4 | | | | |
