Brahiam18/controlador-pid-analogico-levitador/informe/figuras/pruebas/README.md

# Fotografías de las pruebas prácticas

| Archivo | Contenido | Figura del informe |
|---|---|:-:|
| `montaje_fisico.jpg` | Banco de pruebas: fuente de ±16 V, osciloscopio, multímetro y protoboard | 10 |
| `montaje_protoboard.jpg` | Circuito del controlador armado en protoboard (7 × LM741) | 11 |
| `medicion_diferenciador.jpg` | Medición con multímetro a la salida del diferenciador: 2.99 V con error máximo | 12 |

## Pendientes

Fotografías o capturas por etapa que aún pueden agregarse (nombres sugeridos):
`medicion_proporcional.jpg`, `medicion_integral.jpg`, `medicion_derivativo.jpg`, `medicion_sumador.jpg` y `medicion_divisores.jpg`.

Para que una captura de osciloscopio sirva como evidencia debe verse la escala vertical (V/div), la base de tiempo y el punto del circuito donde se mide.
