Brahiam18/controlador-pid-analogico-levitador/fuente/hardware/carga_prueba/img/cobre_espejado.png

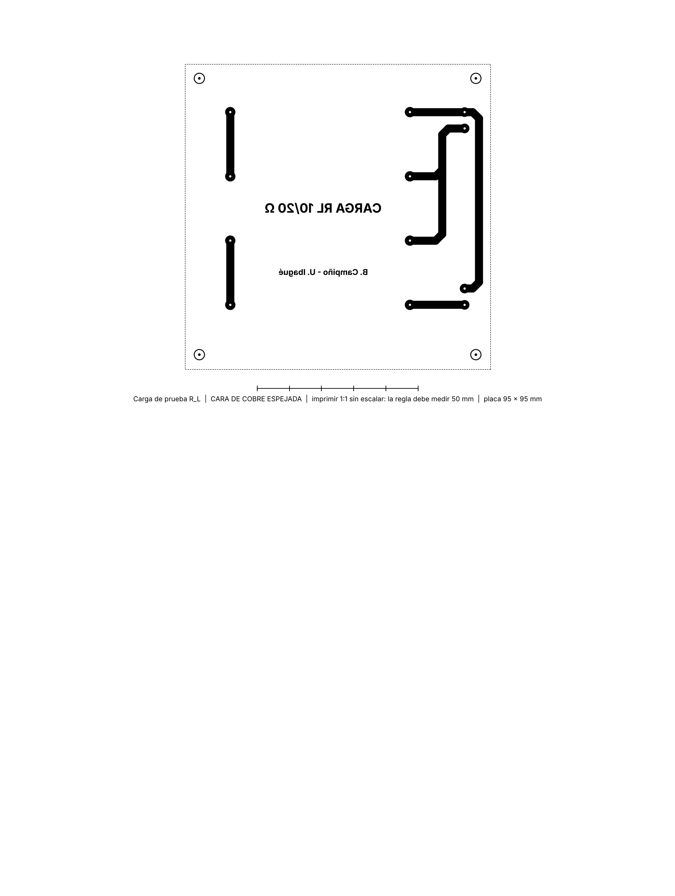
fuente/hardware/carga_prueba/img/cobre_espejado.png
