Brahiam18/controlador-pid-analogico-levitador/hardware/mecanica/impresion_3d/cortes_verificacion.png

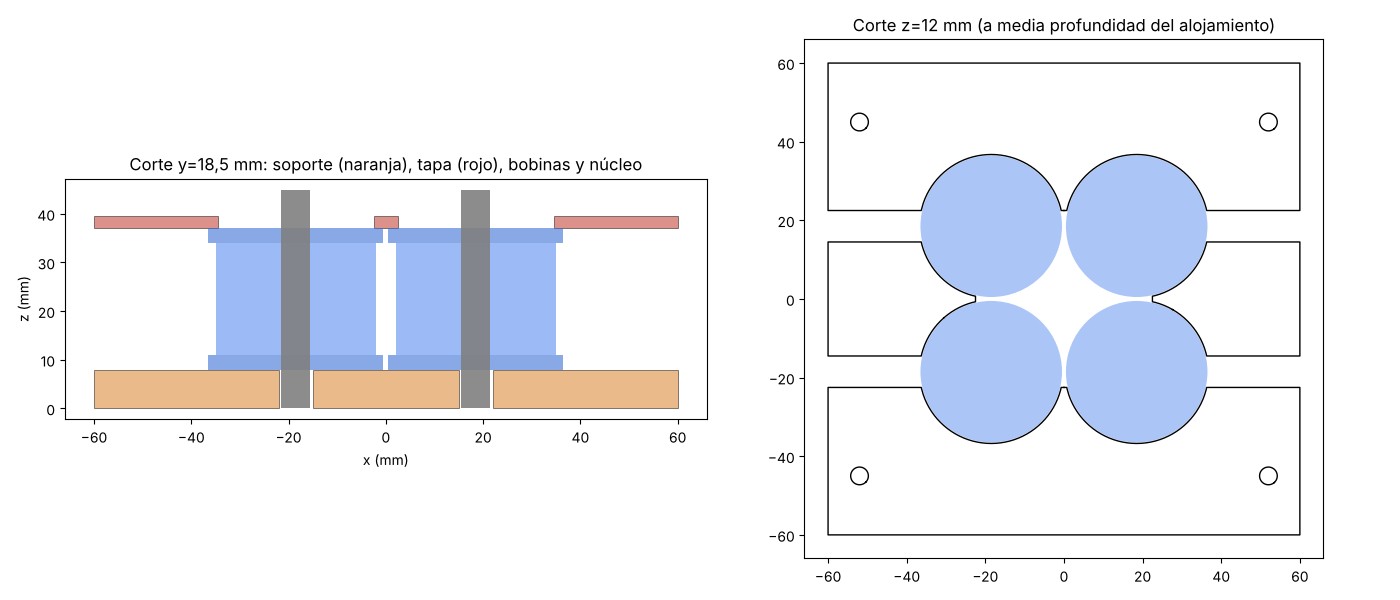
hardware/mecanica/impresion_3d/cortes_verificacion.png
