Brahiam18/controlador-pid-analogico-levitador/hardware/pcb/ensamble_esquinas45_1a1.pdf

J1
J3 J2

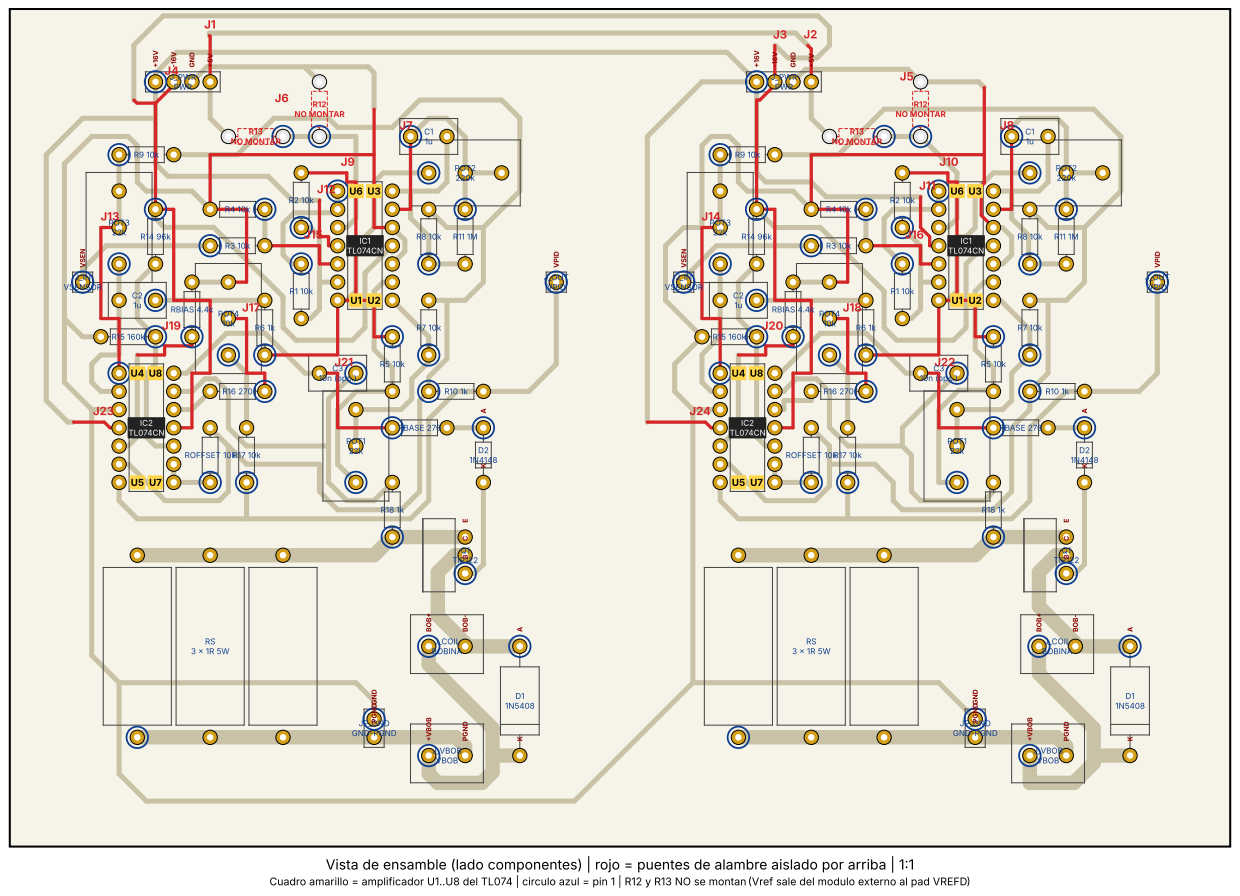
[picture p88: page 1]

Vista de ensamble (lado componentes) | rojo = puentes de alambre aislado por arriba | 1:1

Cuadro amarillo = amplificador U1..U8 del TL074 | circulo azul = pin 1 | R12 y R13 NO se montan (Vref sale del modulo externo al pad VREFD)

# PID 1 | vista de ensamble (lado componentes) | escala 2.2:1

Amarillo = U1..U8 del informe | circulo azul = pin 1 | rojo punteado = NO MONTAR (R12, R13) | J# = puentes (ver tabla)

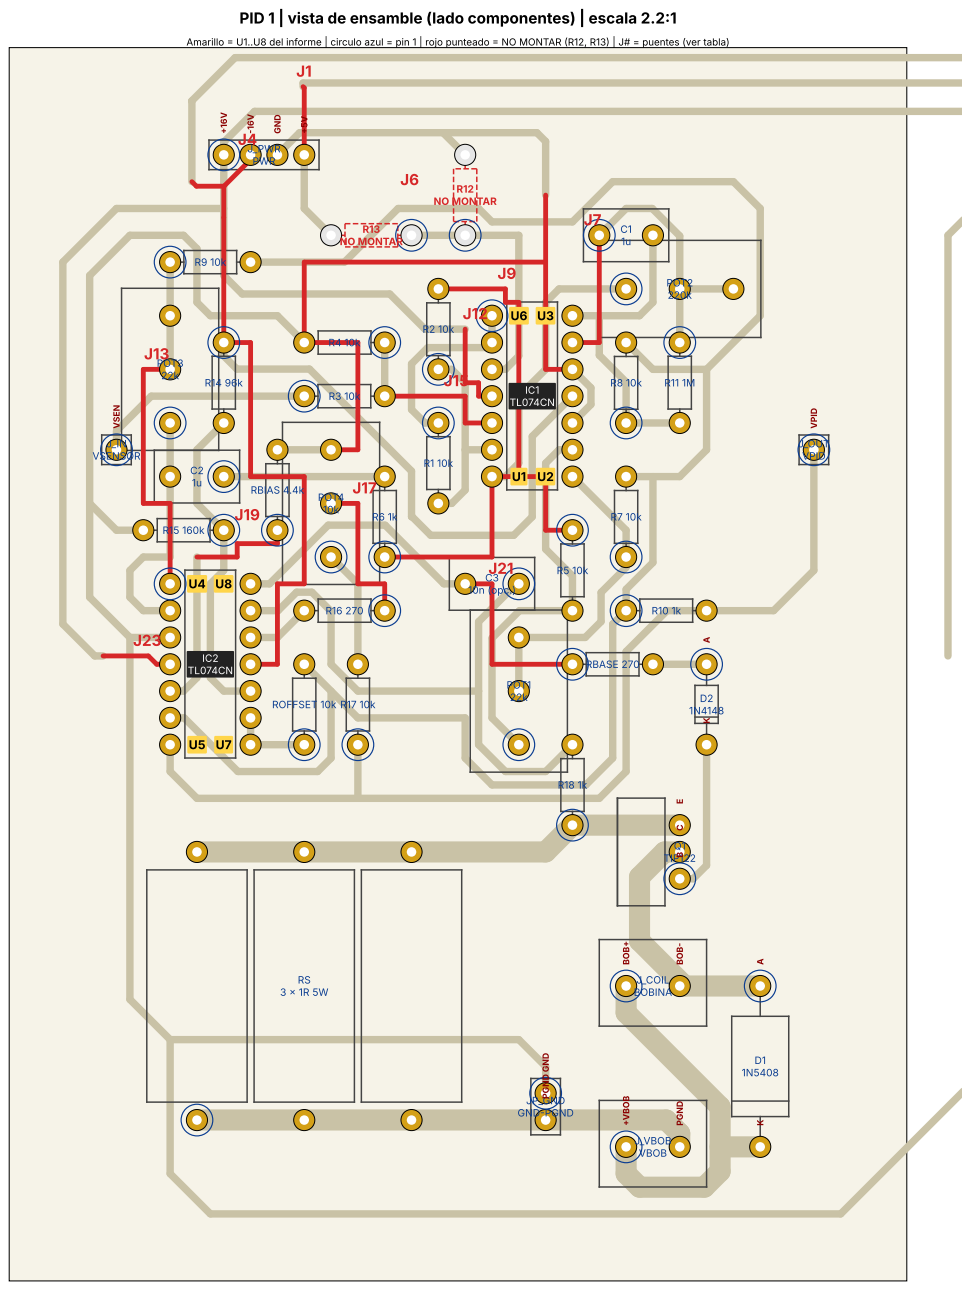
[picture p89: page 2]

1u | POT2

# PID 2 | vista de ensamble (lado componentes) | escala 2.2:1

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

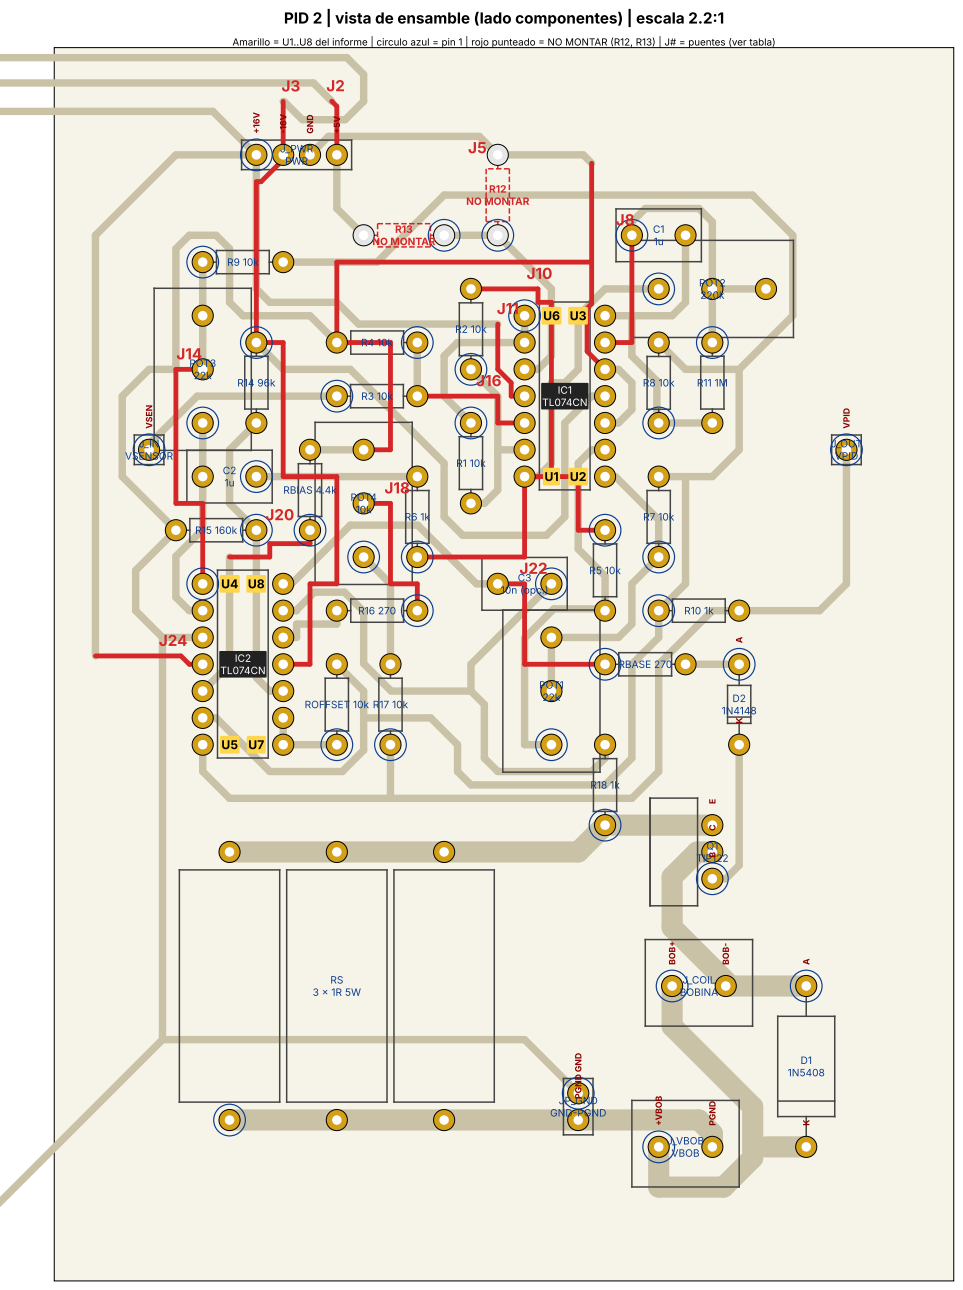
[picture p90: page 3]
