Brahiam18/controlador-pid-analogico-levitador/hardware/pcb/guia_colores_conexiones.pdf

IC1

R2

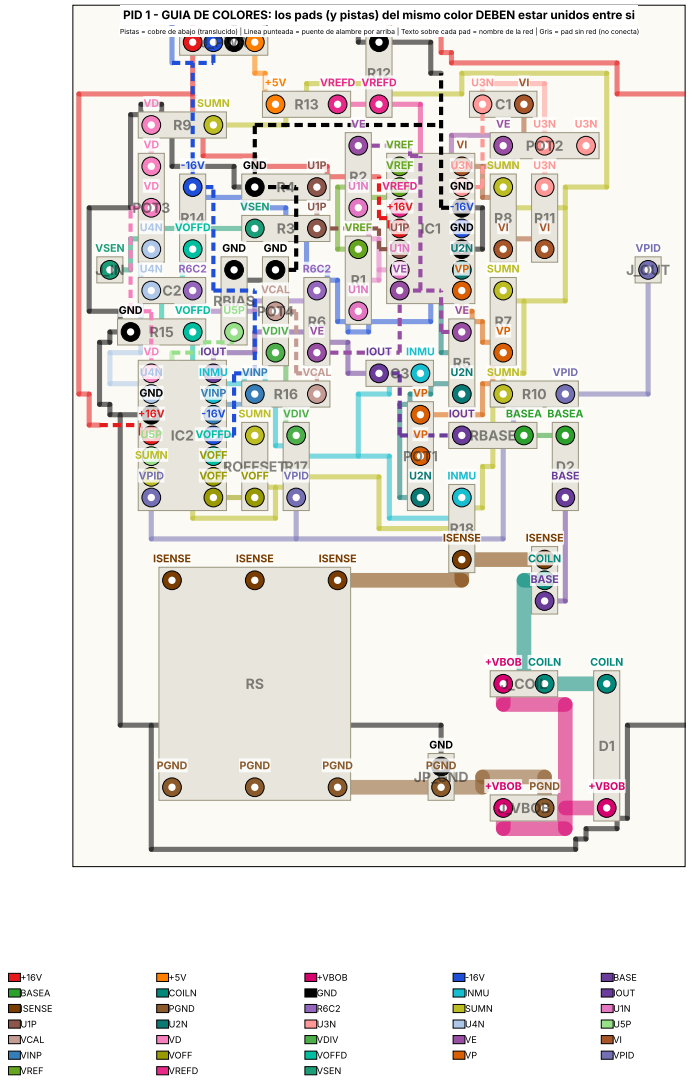
[picture p91: page 1]

PID 1 - GUIA DE COLORES: los pads (y pistas) del mismo color DEBEN estar unidos entre si

Pistas = cobre de abajo (translucido) | Linea punteada = puente de alambre por arriba | Texto sobre cada pad = nombre de la red | Gris = pad sin red (no conecta)

IC1

R2

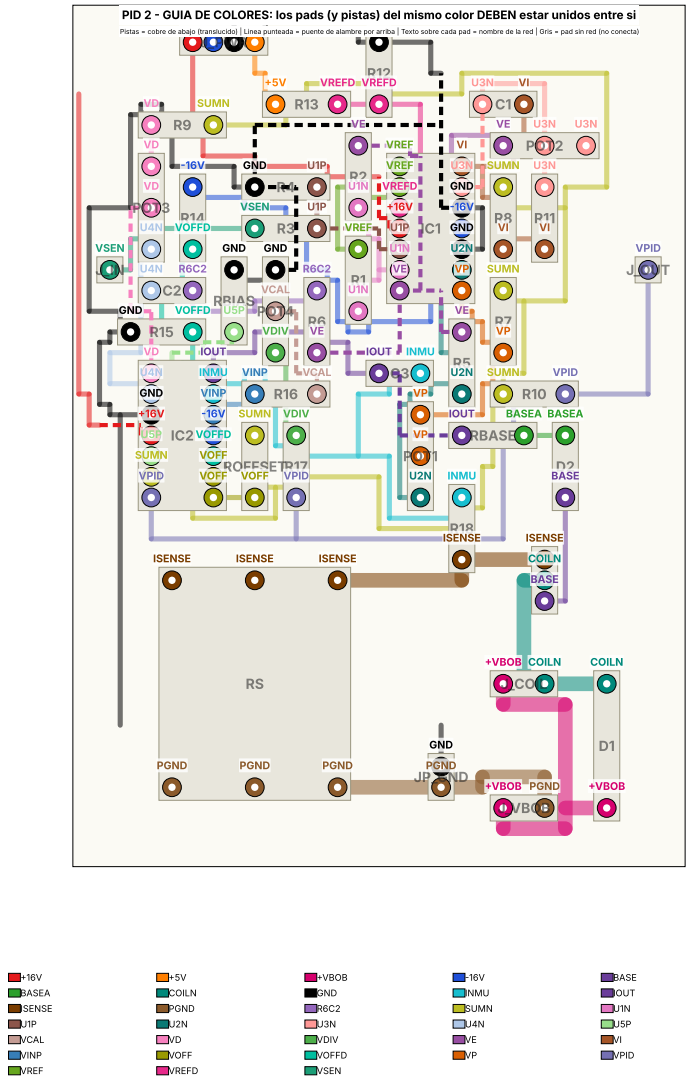
[picture p92: page 2]

PID 2 - GUIA DE COLORES: los pads (y pistas) del mismo color DEBEN estar unidos entre si

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

# Que pads van unidos (PID 1; el PID 2 es identico con prefijo P2_)

+16V: IC1.4, IC2.4, J_PWR.1

+5V: R13.2, J_PWR.4

-16V: IC1.11, IC2.11, R14.1, J_PWR.2

GND: R12.2, R4.2, IC1.10, IC1.12, IC2.3, RBIAS.2, R15.2, POT4.3, JP_GND.1, J_PWR.3

+VBOB: D1.2, J_COIL.1, J_VBOB.1

BASE: D2.2, Q1.1

BASEA: RBASE.2, D2.1

COILN: Q1.2, D1.1, J_COIL.2

INMU: R18.2, C3.1, IC2.13

IOUT: IC2.14, C3.2, RBASE.1

ISENSE: Q1.3, R18.1, RS.4, RS.5, RS.6

PGND: RS.1, RS.2, RS.3, J_VBOB.2, JP_GND.2

R6C2: R6.2, C2.1

SUMN: R7.2, R8.2, R9.2, ROFFSET.2, R10.1, IC2.6

U1N: R1.2, R2.1, IC1.6

U1P: R3.2, R4.1, IC1.5

U2N: R5.2, POT1.1, IC1.9

U3N: POT2.2, POT2.3, C1.1, R11.1, IC1.13

U4N: C2.2, POT3.1, IC2.2

U5P: IC2.5, RBIAS.1

VCAL: POT4.2, R16.1

VD: IC2.1, POT3.2, POT3.3, R9.1

VDIV: R17.2, POT4.1

VE: IC1.7, R2.2, R5.1, POT2.1, R6.1

VI: IC1.14, C1.2, R11.2, R8.1

VINP: R16.2, IC2.12

VOFF: IC2.8, IC2.9, ROFFSET.1

VOFFD: R14.2, R15.1, IC2.10

VP: IC1.8, POT1.2, POT1.3, R7.1

VPID: IC2.7, R10.2, J_OUT.1, R17.1

VREF: IC1.1, IC1.2, R1.1

VREFD: R12.1, R13.1, IC1.3

VSEN: R3.1, J_IN.1
