Brahiam18/controlador-pid-analogico-levitador/hardware/pcb/ensamble_1a1.pdf

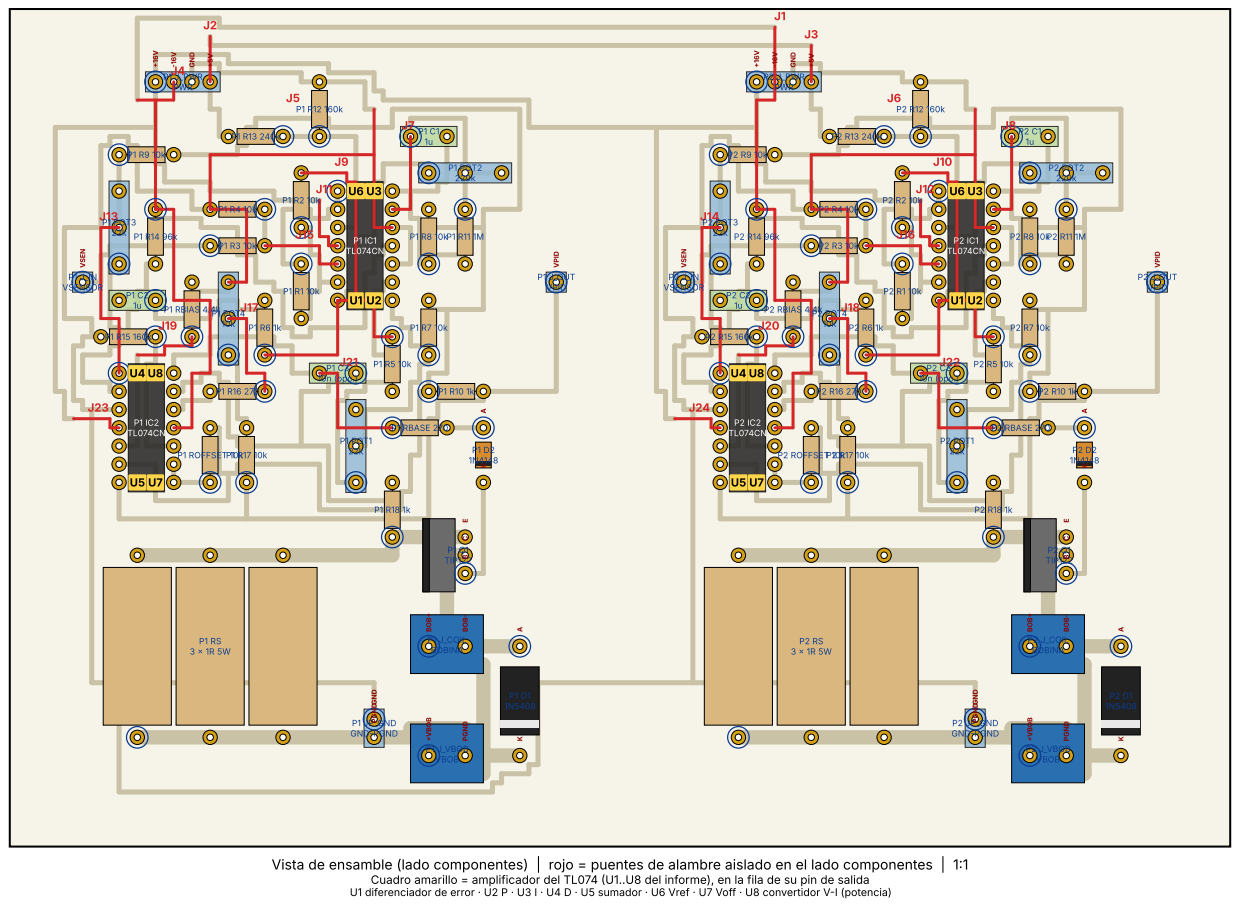
[picture p93: page 1]

Vista de ensamble (lado componentes) | rojo = puentes de alambre aislado en el lado componentes | 1:1

Cuadro amarillo = amplificador del TL074 (U1..U8 del informe), en la fila de su pin de salida
U1 diferenciador de error · U2 P · U3 I · U4 D · U5 sumador · U6 Vref · U7 Voff · U8 convertidor V-I (potencia)

PID 1 | | vista de ensamble (lado componentes) | escala 2.60:1
U6 | U3

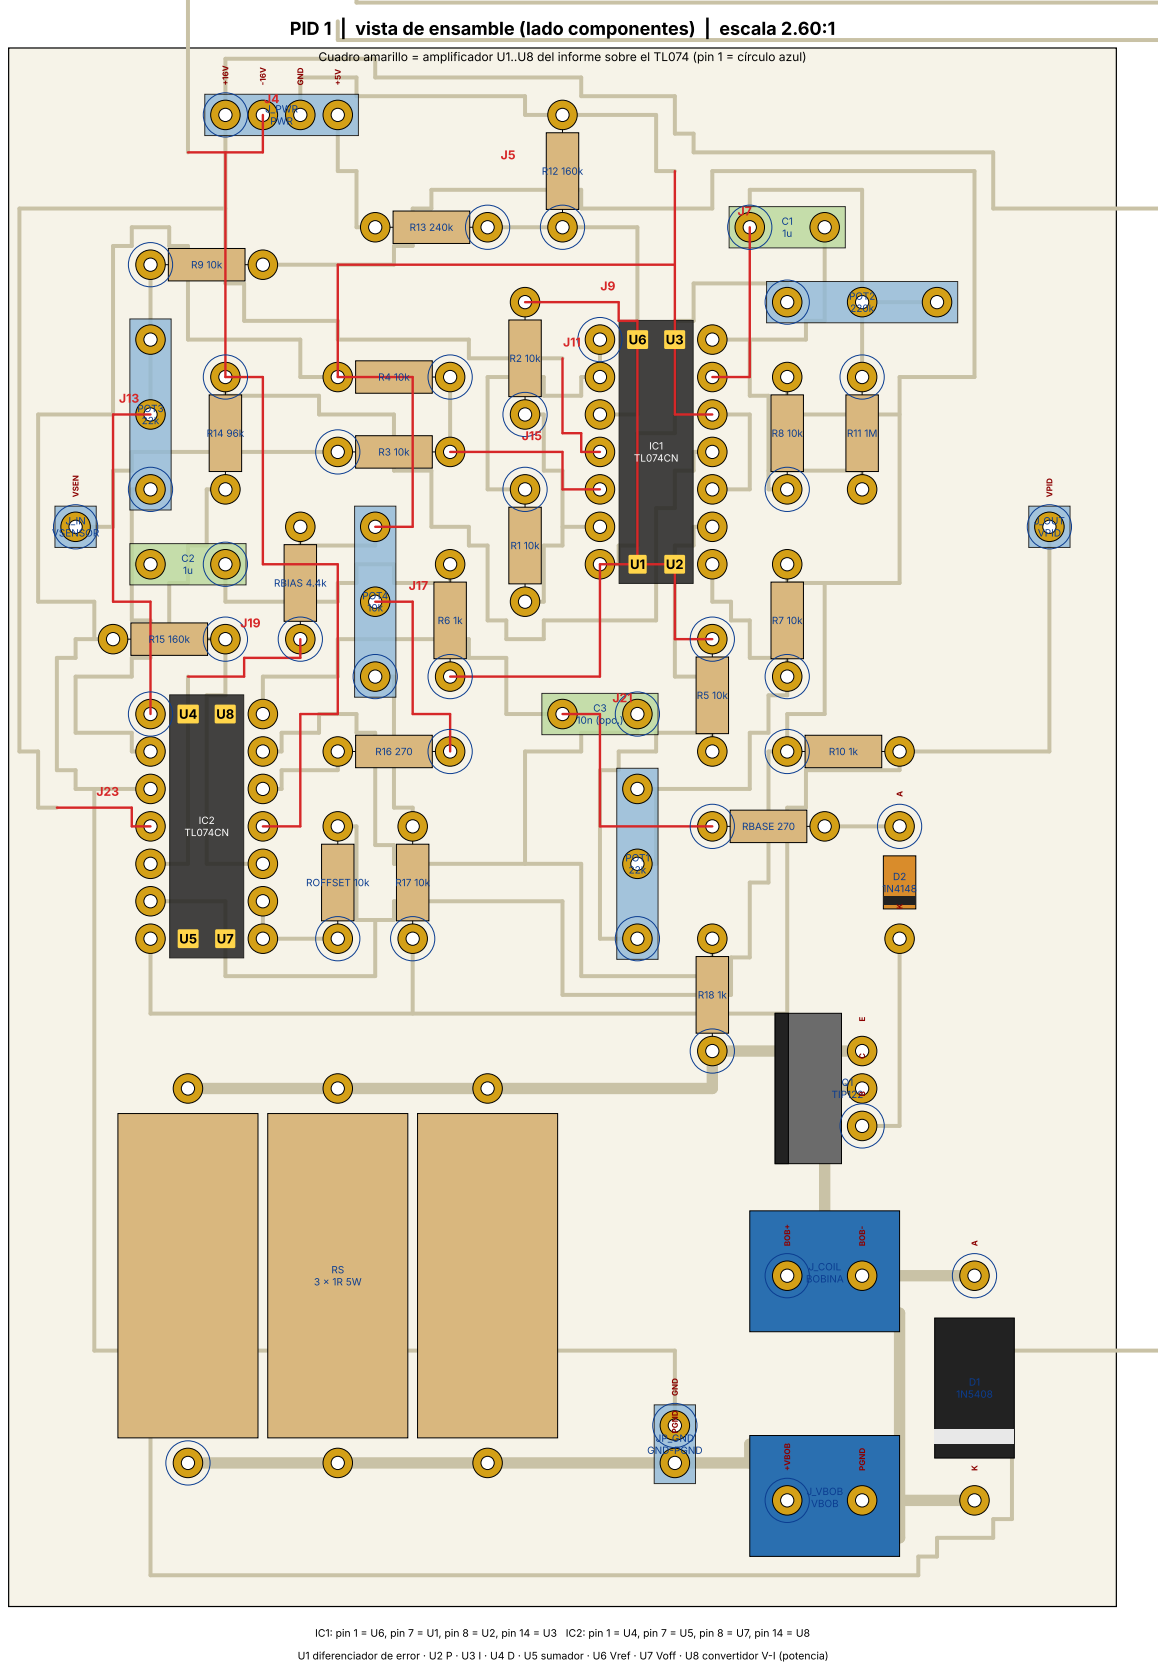
[picture p94: page 2]

Cuadro amarillo = amplificador U1..U8 del informe sobre el TL074 (pin 1 = círculo azul)

IC1: pin 1 = U6, pin 7 = U1, pin 8 = U2, pin 14 = U3 IC2: pin 1 = U4, pin 7 = U5, pin 8 = U7, pin 14 = U8

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

# PID 2 | vista de ensamble (lado componentes) | escala 2.60:1

U6 U3

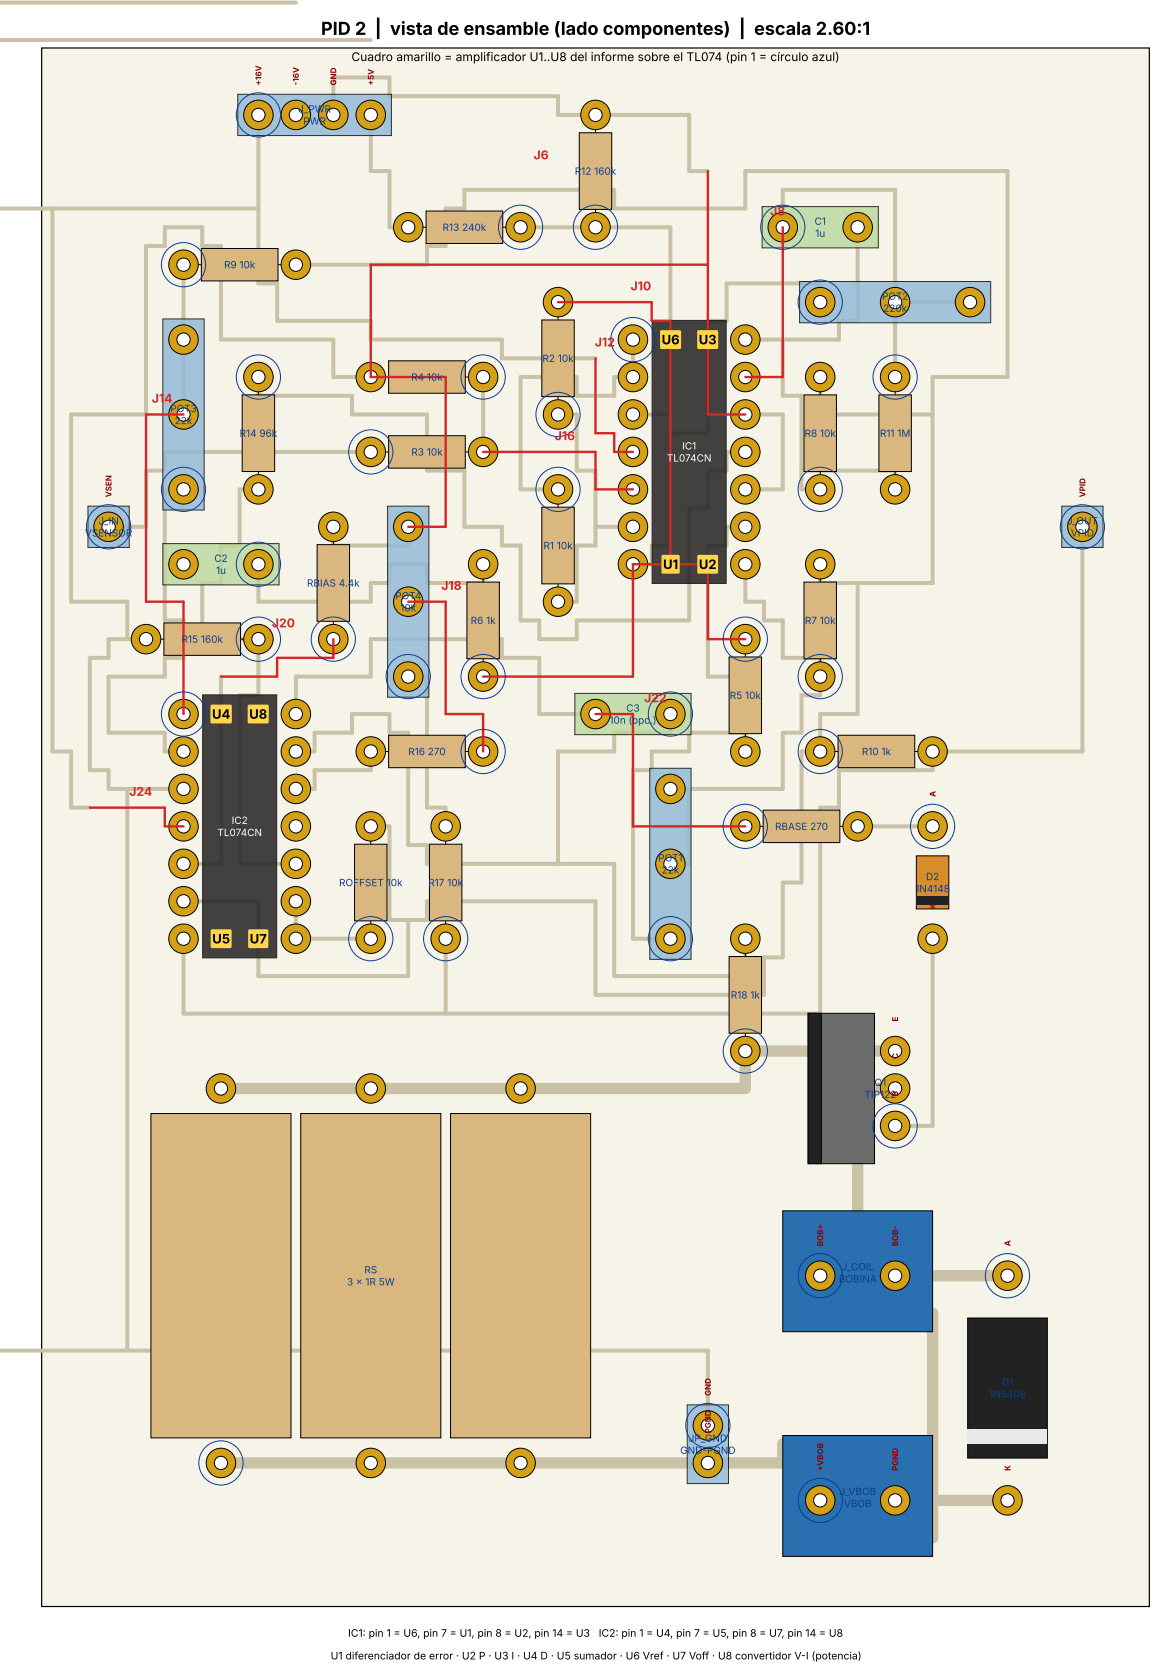
[picture p95: page 3]

Cuadro amarillo = amplificador U1..U8 del informe sobre el TL074 (pin 1 = círculo azul)

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
