Brahiam18/controlador-pid-analogico-levitador/hardware/pcb/cobre_espejado_1a1.pdf

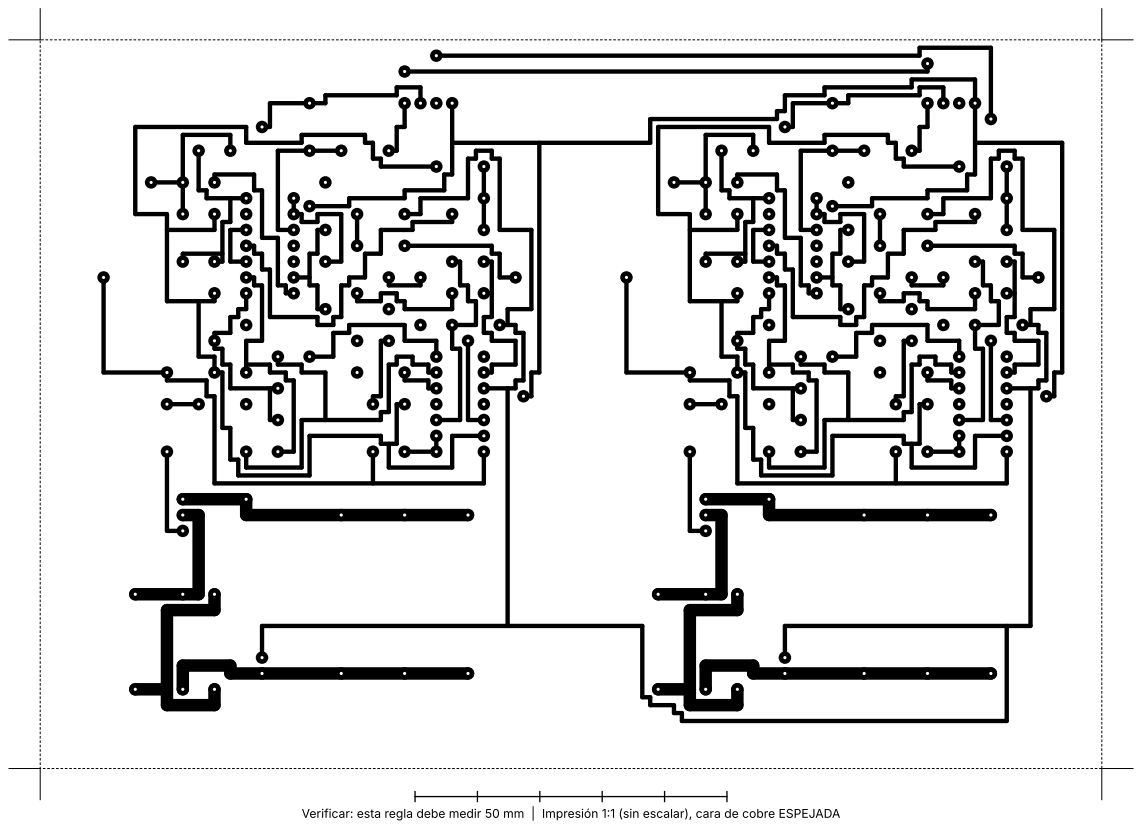
[picture p96: page 1]

Verificar: esta regla debe medir 50 mm | Impresión 1:1 (sin escalar), cara de cobre ESPEJADA
