Brahiam18/controlador-pid-analogico-levitador/fuente/hardware/carga_prueba/cobre_espejado_1a1.pdf

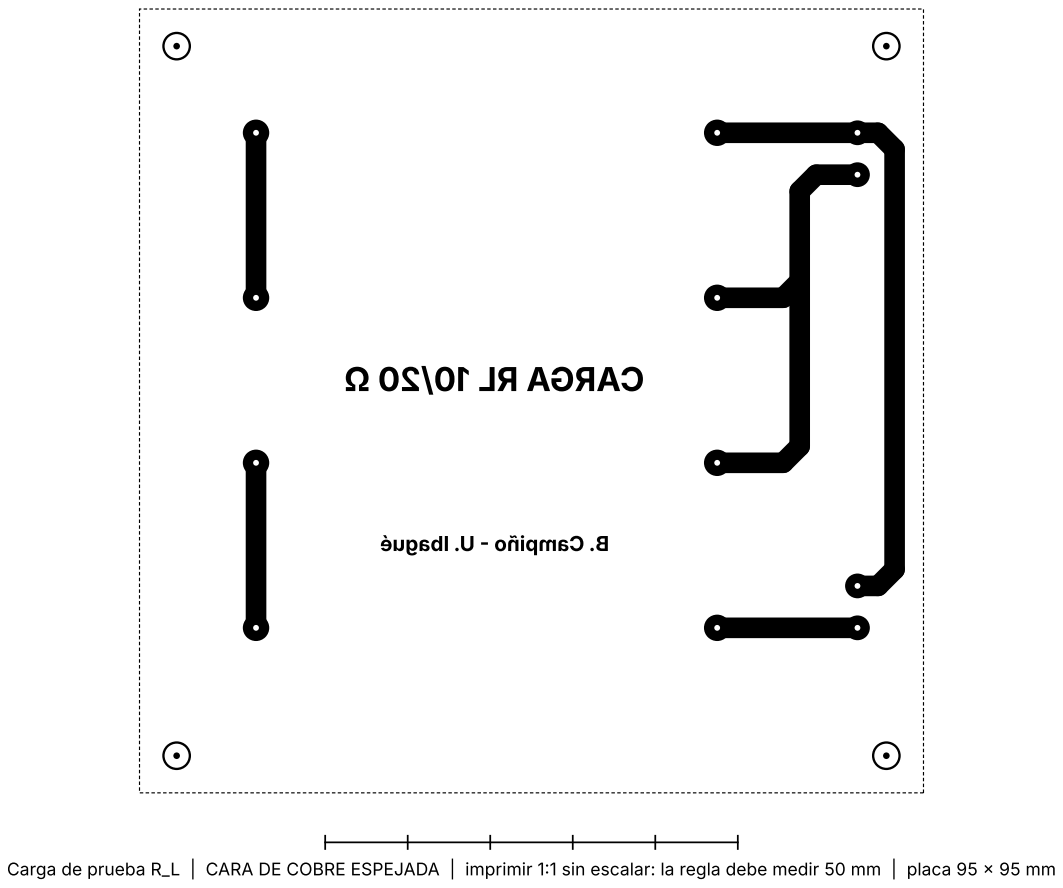
[picture p97: page 1]

Carga de prueba R_L | CARA DE COBRE ESPEJADA | imprimir 1:1 sin escalar: la regla debe medir 50 mm | placa 95 x 95 mm
