Brahiam18/controlador-pid-analogico-levitador/fuente/hardware/carga_prueba/ensamble_1a1.pdf

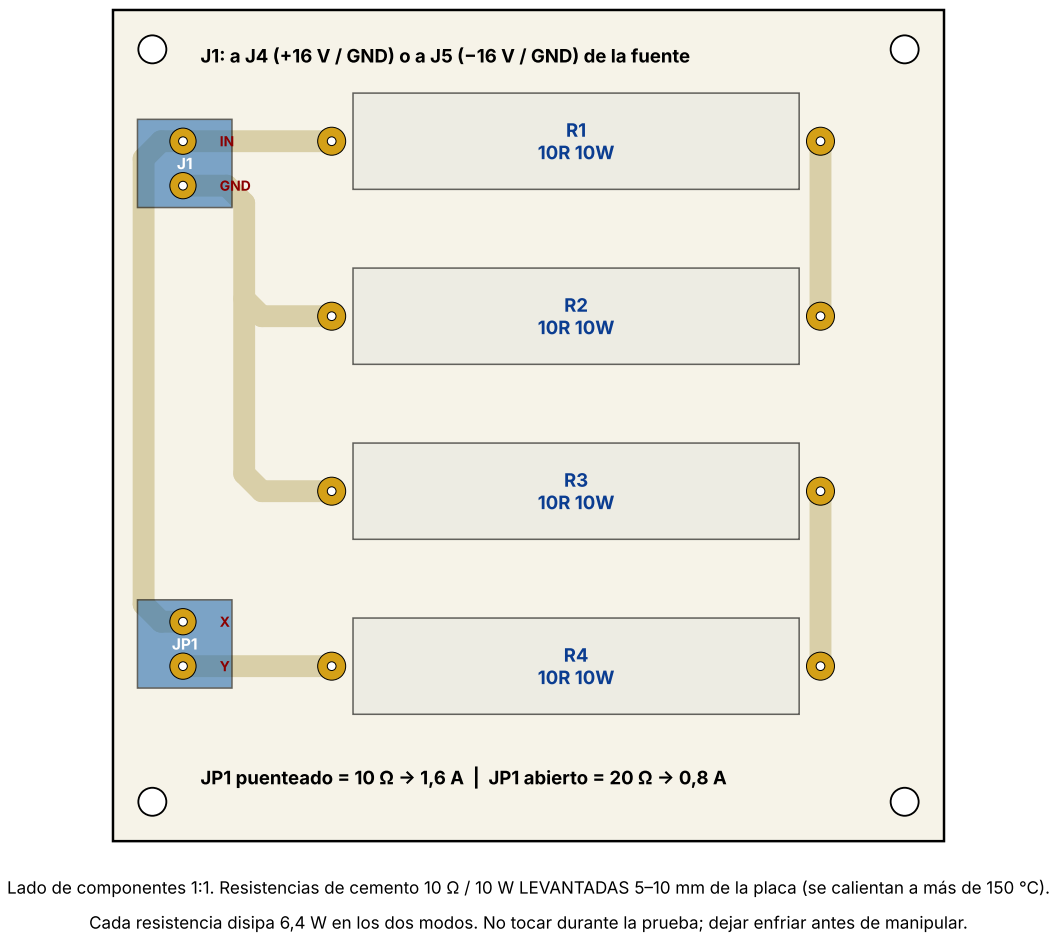
[picture p98: page 1]

J1: a J4 (+16 V / GND) o a J5 (−16 V / GND) de la fuente

Lado de componentes 1:1. Resistencias de cemento 10 Ω / 10 W LEVANTADAS 5–10 mm de la placa (se calientan a más de 150 °C).

Cada resistencia disipa 6,4 W en los dos modos. No tocar durante la prueba; dejar enfriar antes de manipular.
