Brahiam18/controlador-pid-analogico-levitador/fuente/hardware/pcb/cobre_espejado_1a1.pdf

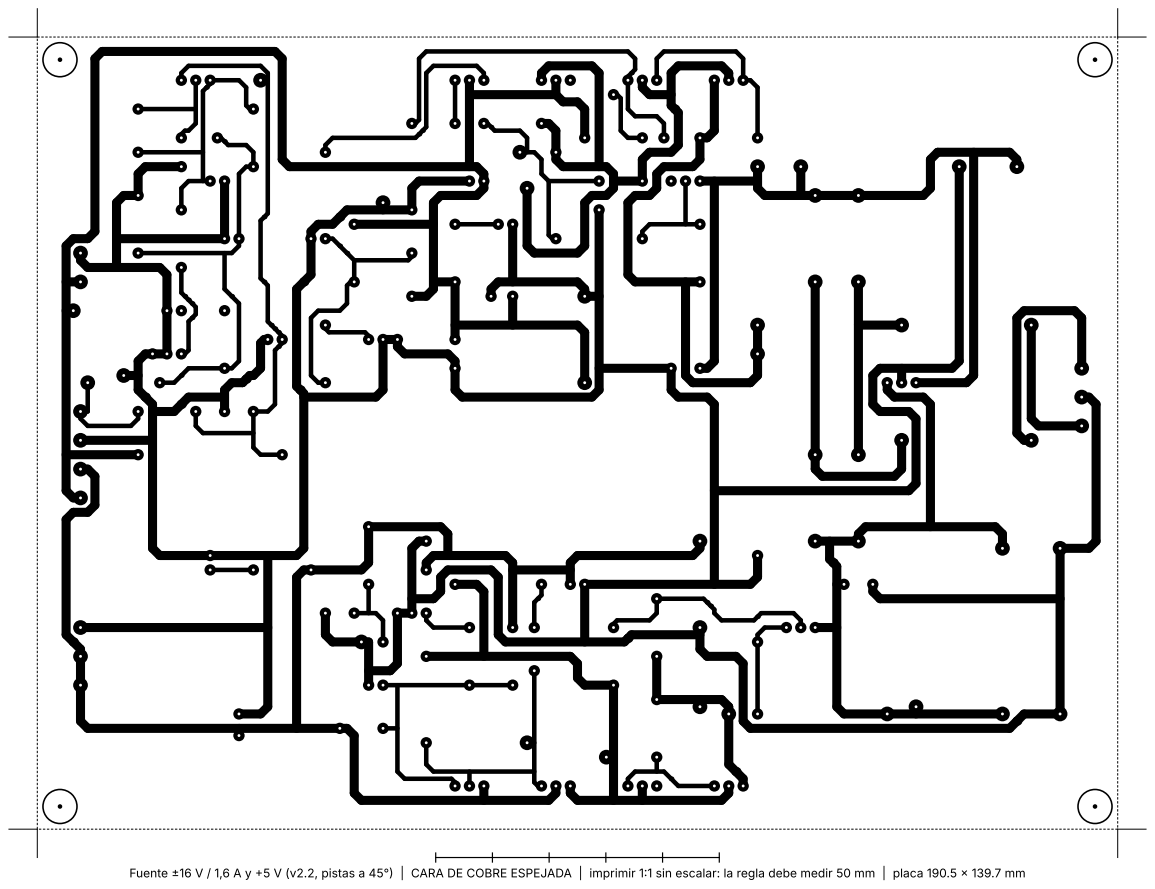
[picture p99: page 1]

Fuente ±16 V / 1,6 A y +5 V (v2.2, pistas a 45°) | CARA DE COBRE ESPEJADA | imprimir 1:1 sin escalar: la regla debe medir 50 mm | placa 190.5 x 139.7 mm
