Brahiam18/controlador-pid-analogico-levitador/fuente/hardware/pcb/ensamble_1a1.pdf

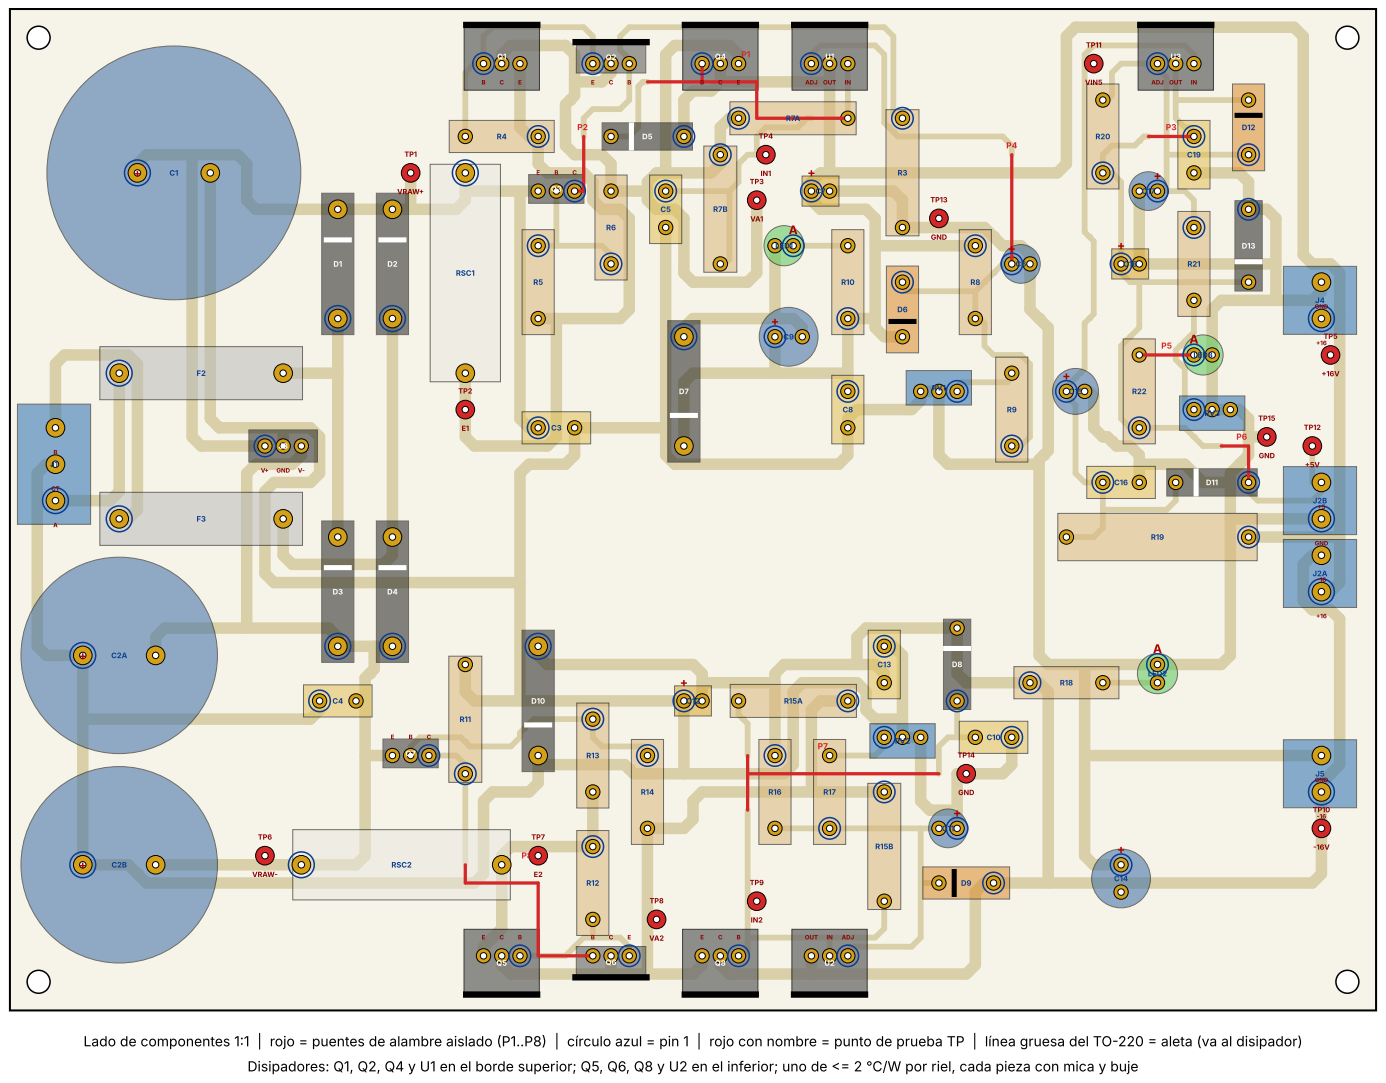
[picture p100: page 1]

Lado de componentes 1:1 | rojo = puentes de alambre aislado (P1..P8) | círculo azul = pin 1 | rojo con nombre = punto de prueba TP | línea gruesa del TO-220 = aleta (va al disipador)

Disipadores: Q1, Q2, Q4 y U1 en el borde superior; Q5, Q6, Q8 y U2 en el inferior; uno de <= 2 °C/W por riel, cada pieza con mica y buje

Fuente ±16 V / 1,6 A y +5 V (v2.2) - ensamble ampliado (escala 1.33:1, A4 horizontal): referencia y valor de cada pieza

+

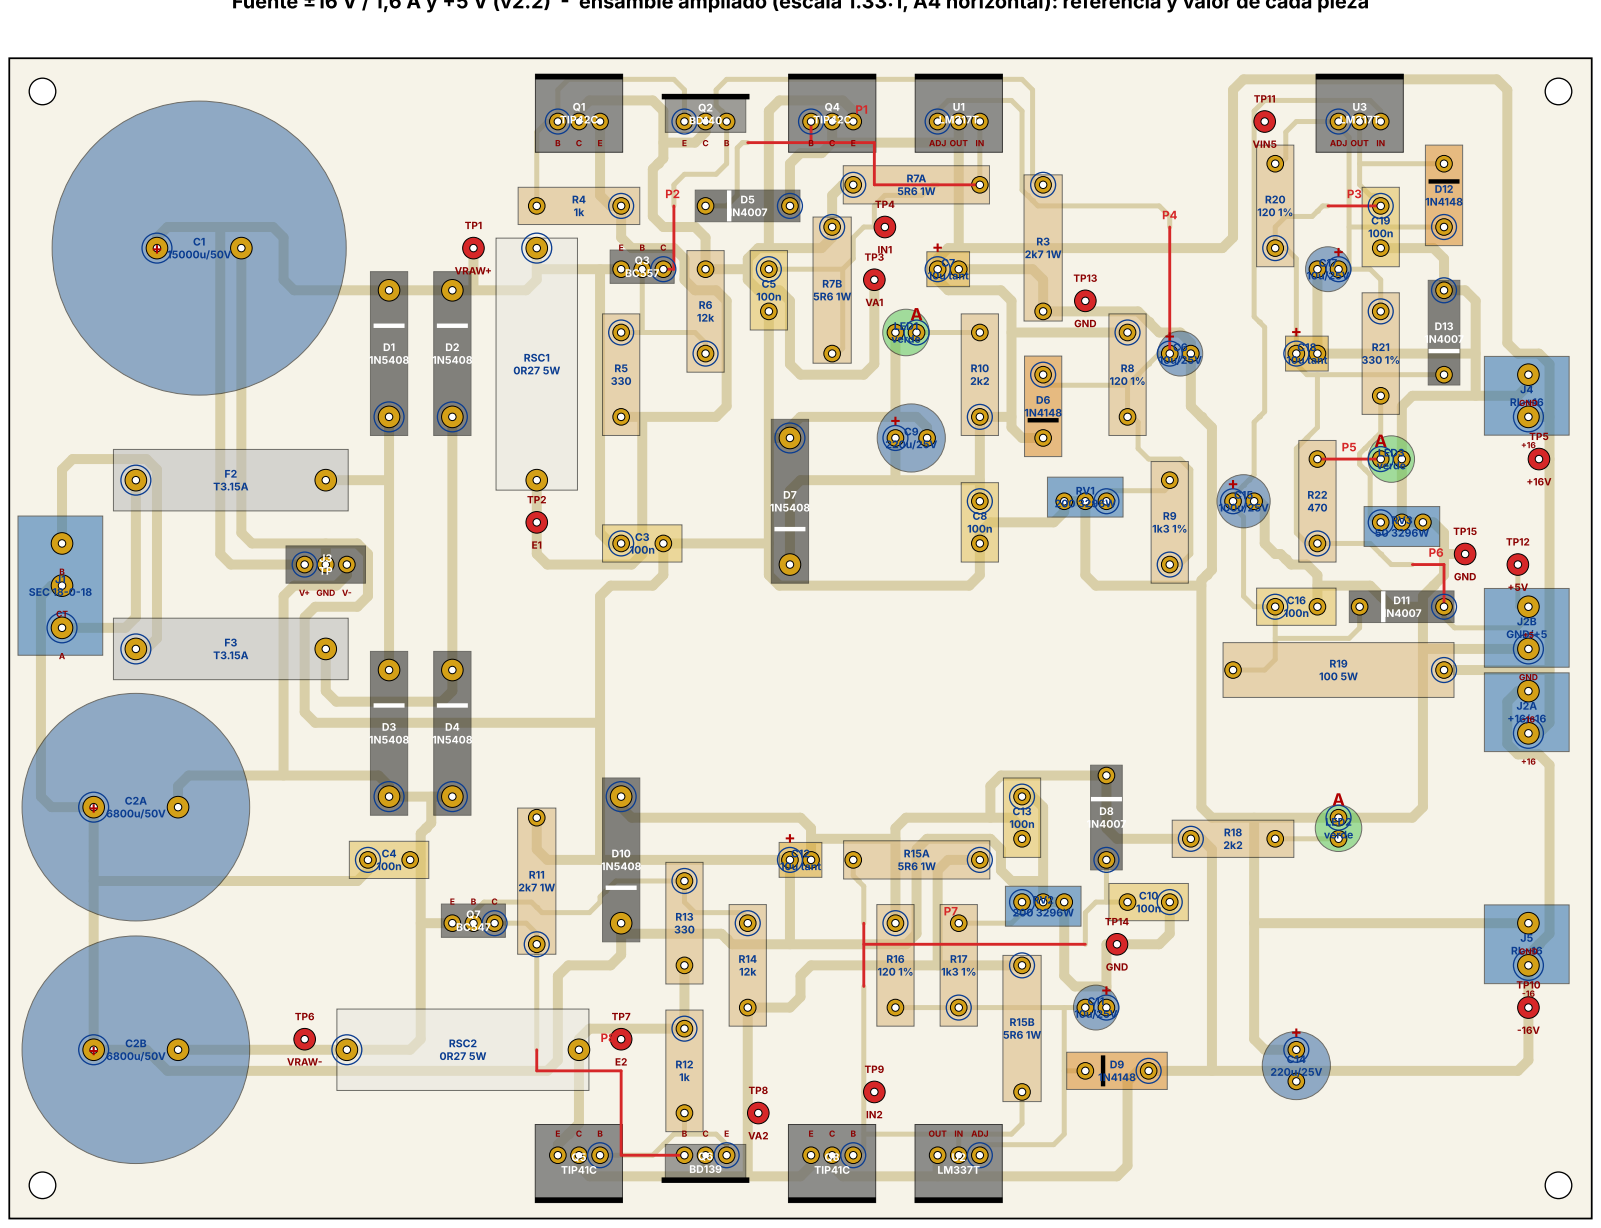
[picture p101: page 2]
