Brahiam18/controlador-pid-analogico-levitador/fuente/informe/figuras/esq_entrada.pdf

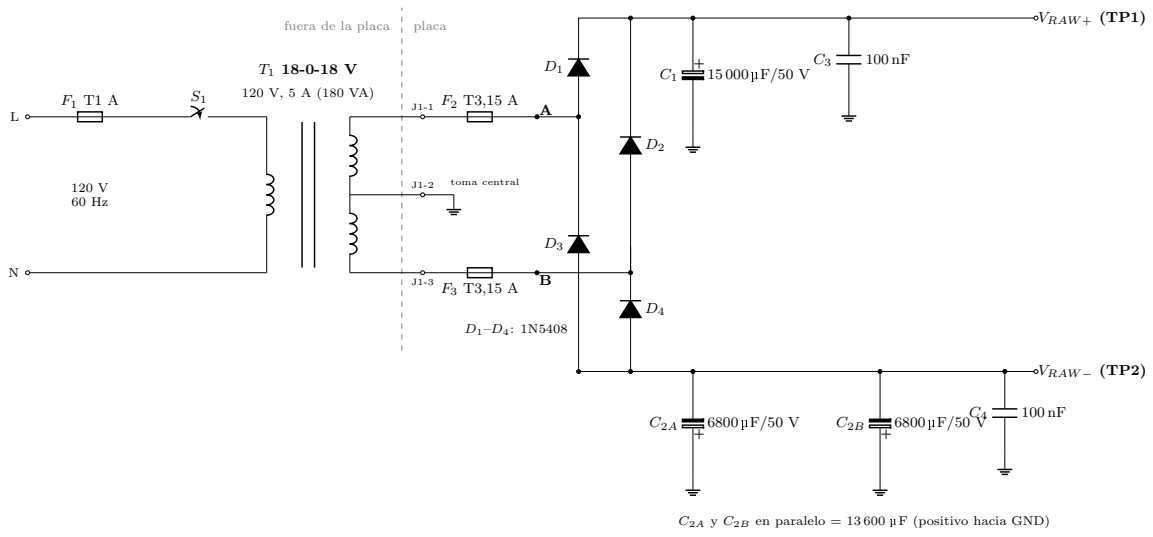
[picture p102: page 1]

C2A y C2B en paralelo = 13 600 µF (positivo hacia GND)
