Brahiam18/controlador-pid-analogico-levitador/docs/voltajes_por_etapa/voltajes_por_etapa.pdf

# PID analógico: voltaje esperado en cada nodo

Con V_ref = 2 V y V_sensor = 3 V (estado estable; esperar unos 5 s a que el integrador se asiente)

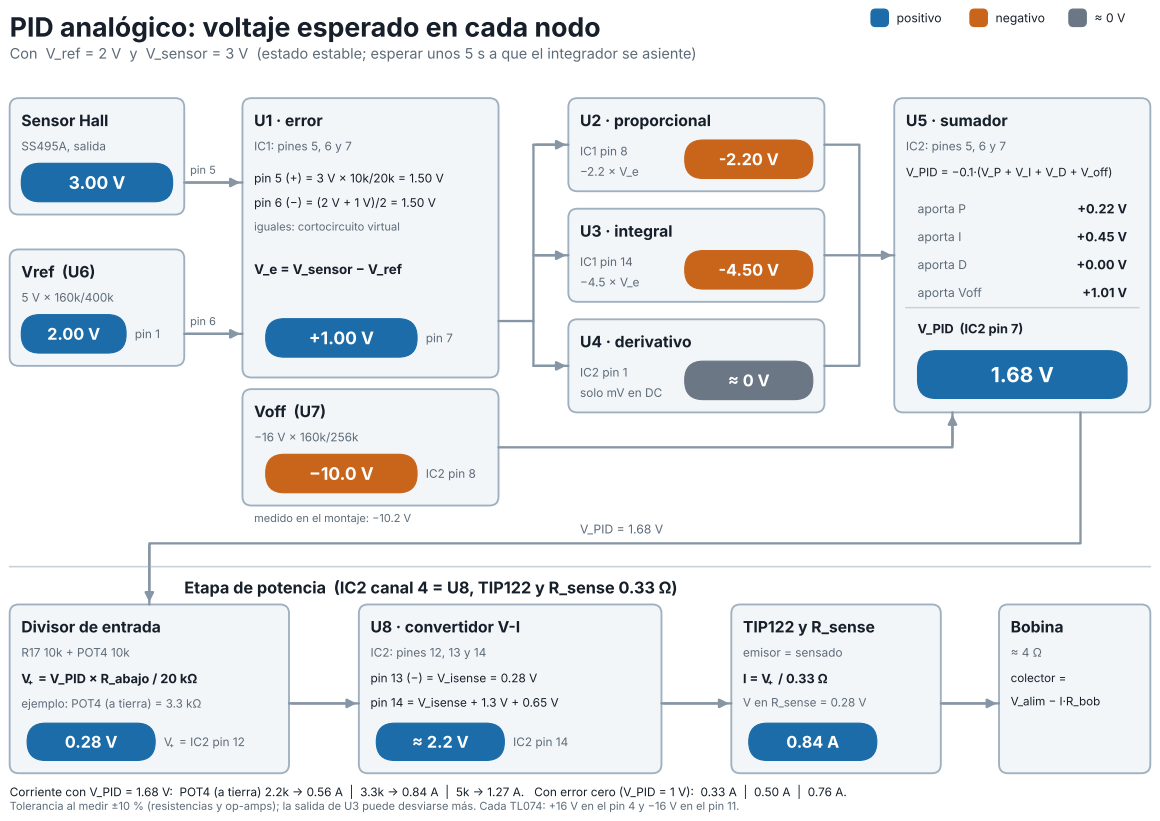
[picture p103: page 1]

IC2 pin 1
solo mV en DC

medido en el montaje: −10.2 V

Etapa de potencia (IC2 canal 4 = U8, TIP122 y R_sense 0.33 Ω)

Corriente con V_PID = 1.68 V: POT4 (a tierra) 2.2k → 0.56 A | 3.3k → 0.84 A | 5k → 1.27 A. Con error cero (V_PID = 1 V): 0.33 A | 0.50 A | 0.76 A.
Tolerancia al medir ±10 % (resistencias y op-amps); la salida de U3 puede desviarse más. Cada TL074: +16 V en el pin 4 y −16 V en el pin 11.
