Brahiam18/controlador-pid-analogico-levitador/fuente/informe/figuras/esq_neg.pdf

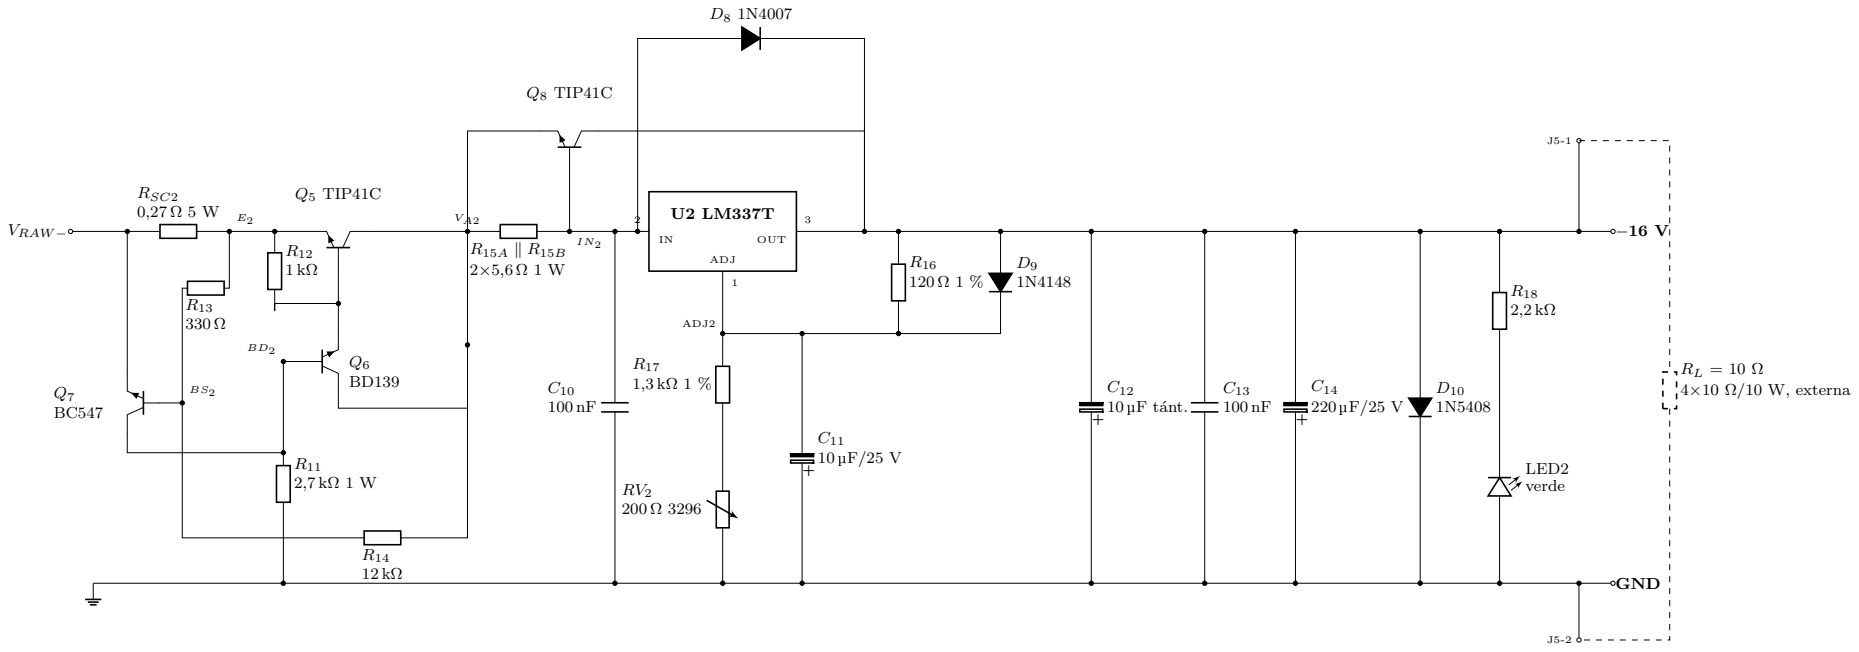
[picture p104: page 1]
