Brahiam18/controlador-pid-analogico-levitador/fuente/informe/figuras/esq_pos.pdf

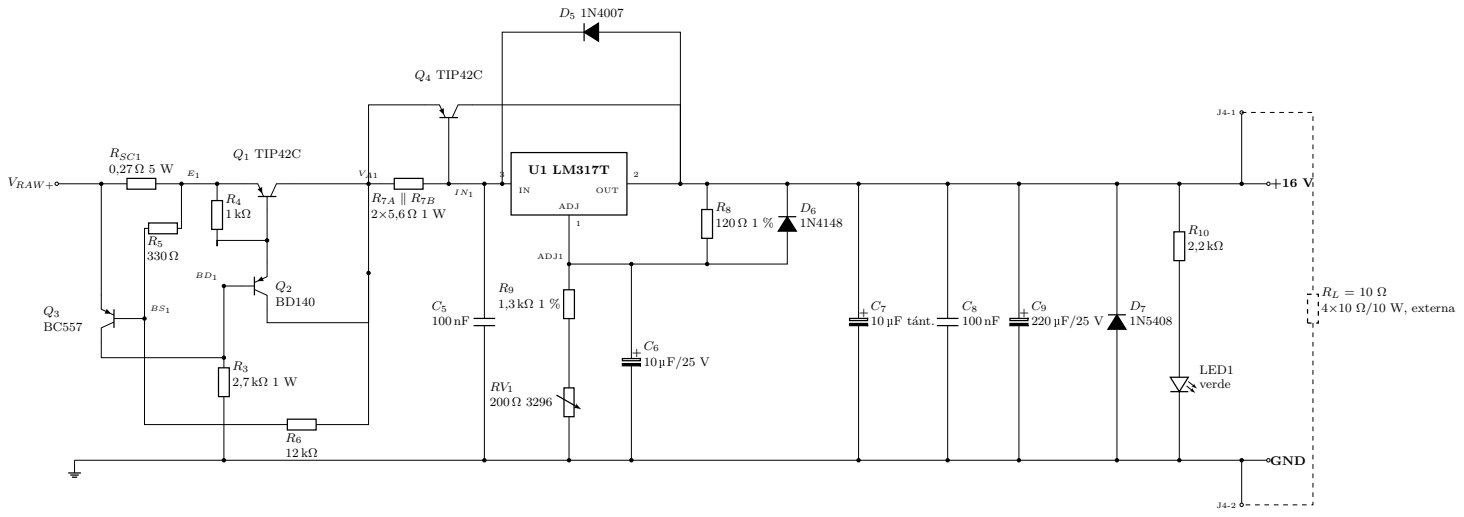
[picture p105: page 1]
