Brahiam18/controlador-pid-analogico-levitador/fuente/informe/figuras/esq_5v.pdf

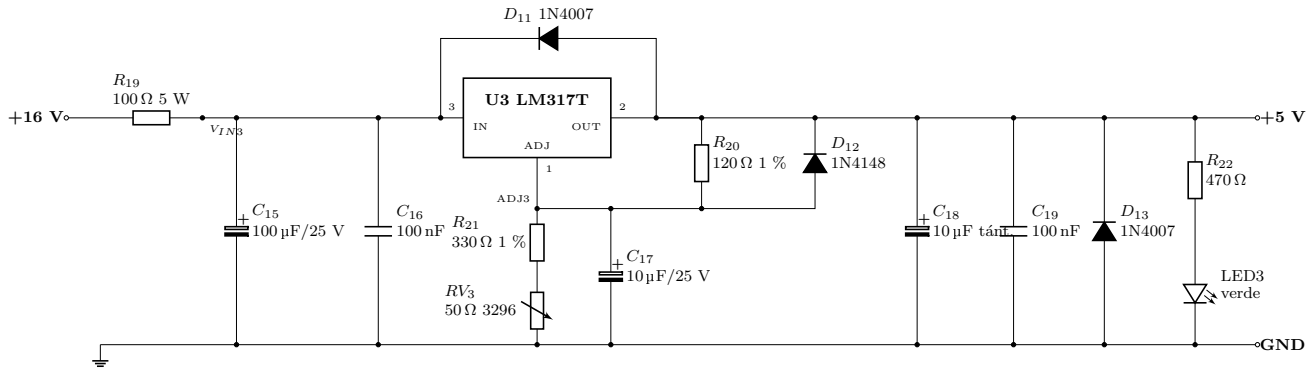
[picture p106: page 1]
