Brahiam18/controlador-pid-analogico-levitador/fuente/informe/figuras/sim_carga.pdf

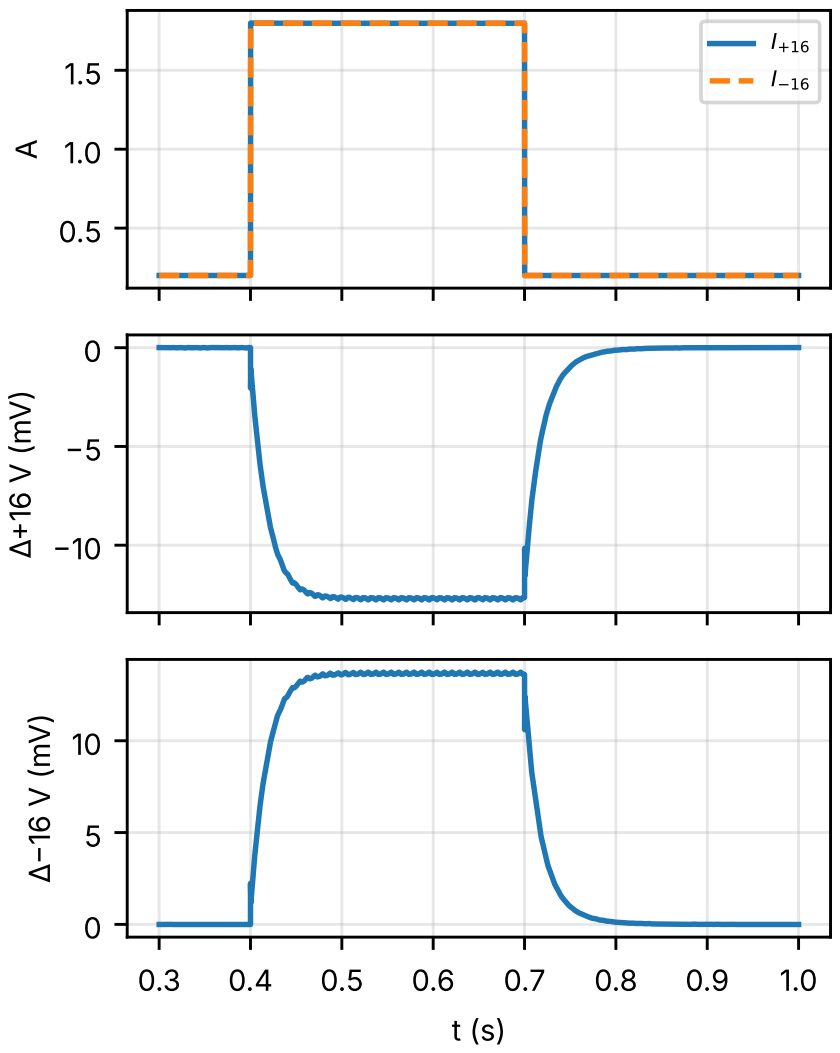
[picture p107: page 1]

I+16
I−16
