Brahiam18/controlador-pid-analogico-levitador/fuente/informe/figuras/sim_corto.pdf

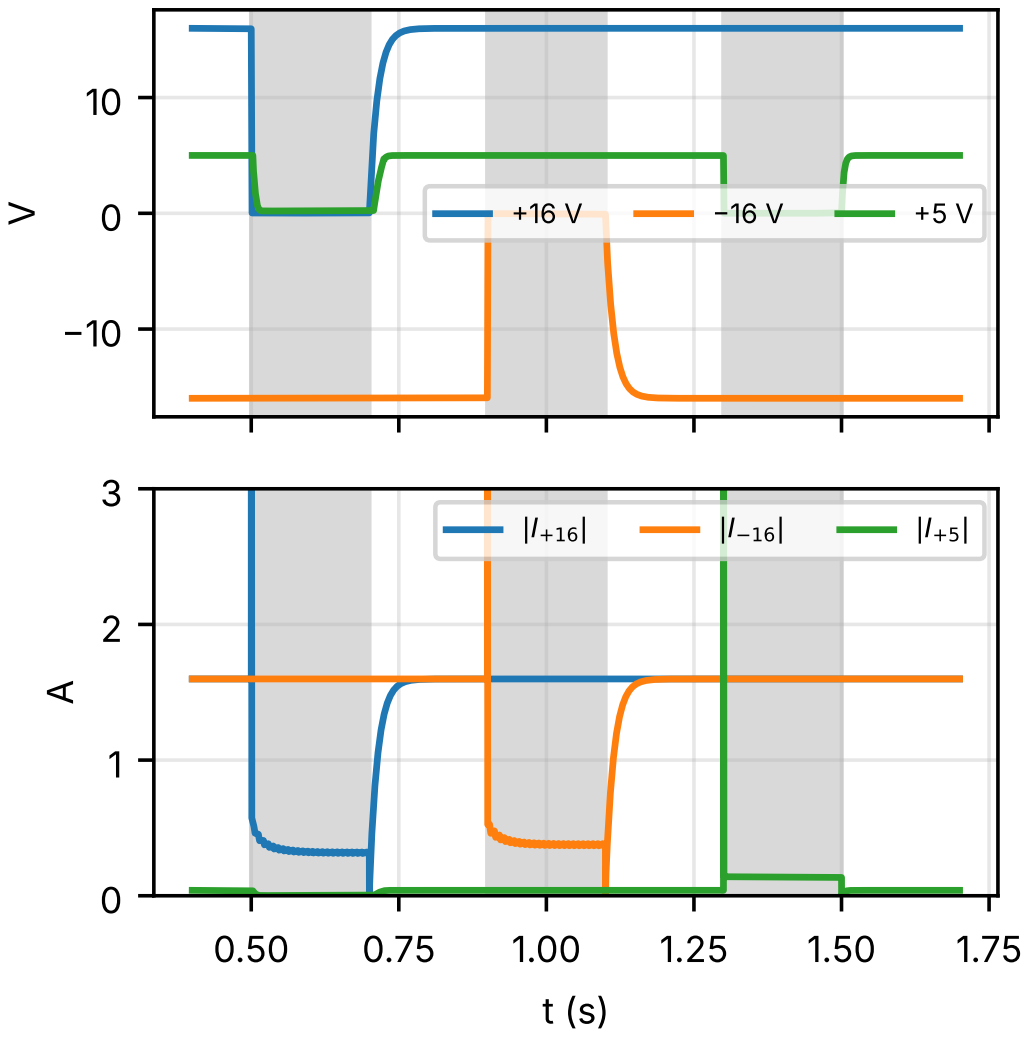
[picture p108: page 1]
