Brahiam18/controlador-pid-analogico-levitador/fuente/informe/figuras/sim_regimen.pdf

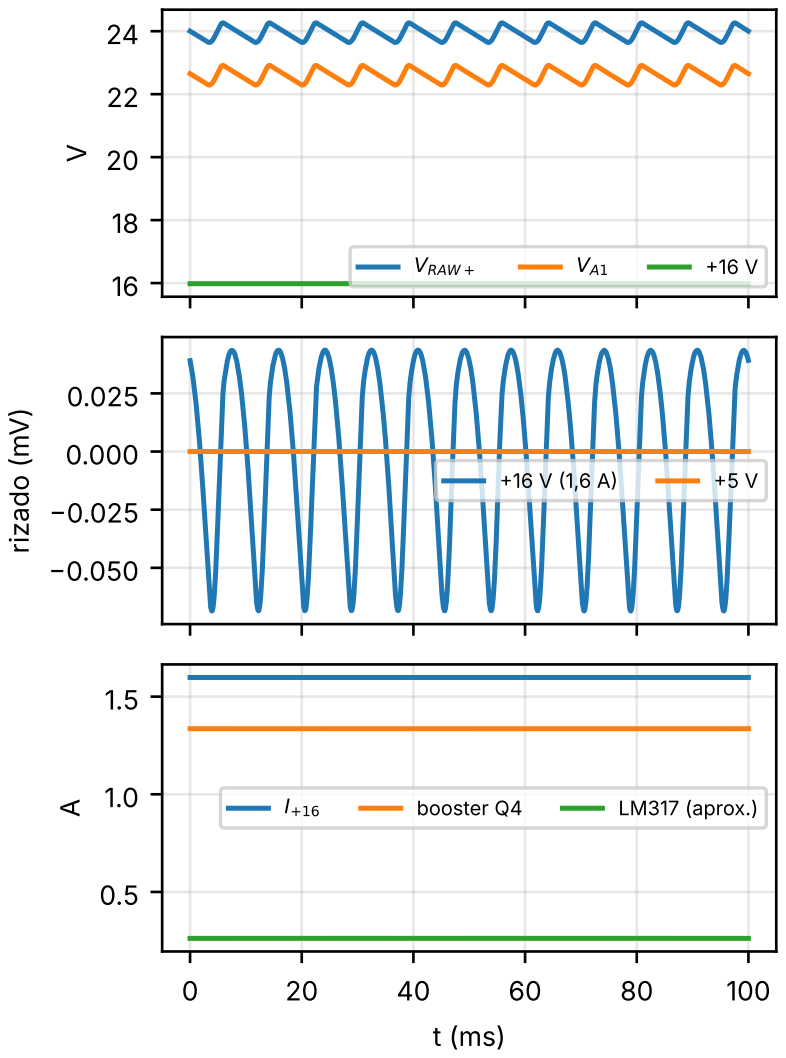
[picture p109: page 1]
VRAW +; rizado (mV); booster Q4; LM317 (aprox.)
