Brahiam18/controlador-pid-analogico-levitador/(list of files, drawings)

Other design files:
simulacion/proteus/EtapaPID1.pdsprj
