Brahiam18/controlador-pid-analogico-levitador/fuente/hardware/carga_prueba/carga.brd

## EAGLE design fuente/hardware/carga_prueba/carga.brd (2026-11-11)

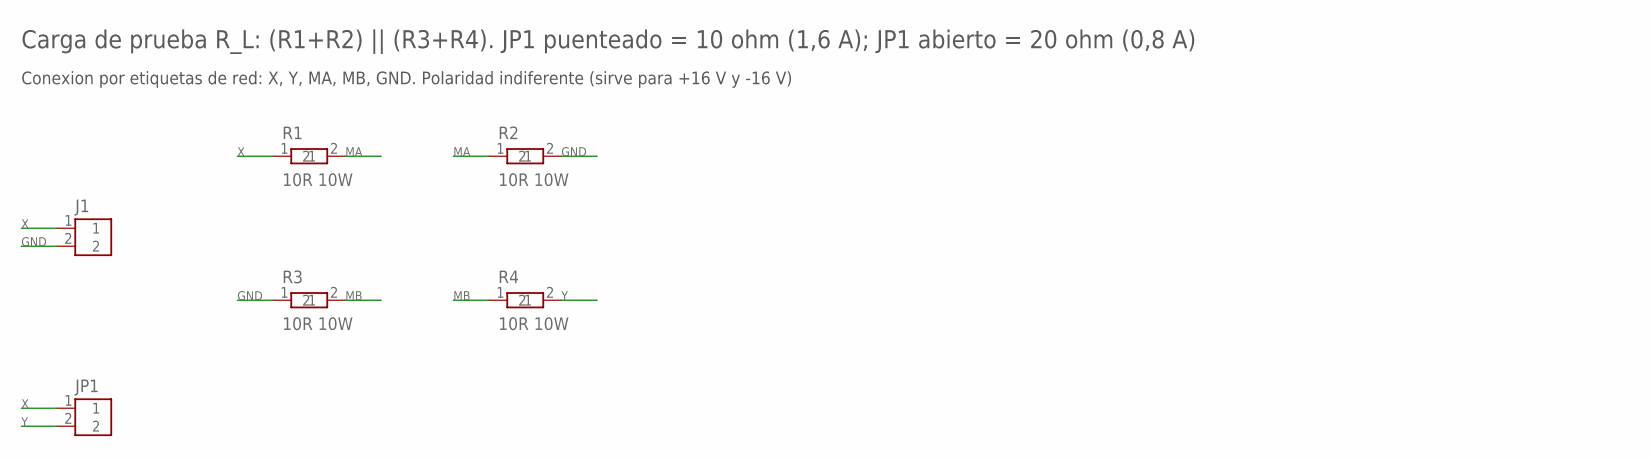
[picture p110: schematic carga.sch]

Parts:
J1: A J4 o J5; TERM2
JP1: SEL 10/20R; TERM2
R1, R2, R3, R4: 10R 10W; R10W

Connections:
GND: J1.2, R2.2, R3.1
MA: R1.2, R2.1
MB: R3.2, R4.1
X: J1.1, JP1.1, R1.1
Y: JP1.2, R4.2

Notes on the sheet:
Carga de prueba R_L: (R1+R2) || (R3+R4). JP1 puenteado = 10 ohm (1,6 A); JP1 abierto = 20 ohm (0,8 A)
Conexion por etiquetas de red: X, Y, MA, MB, GND. Polaridad indiferente (sirve para +16 V y -16 V)

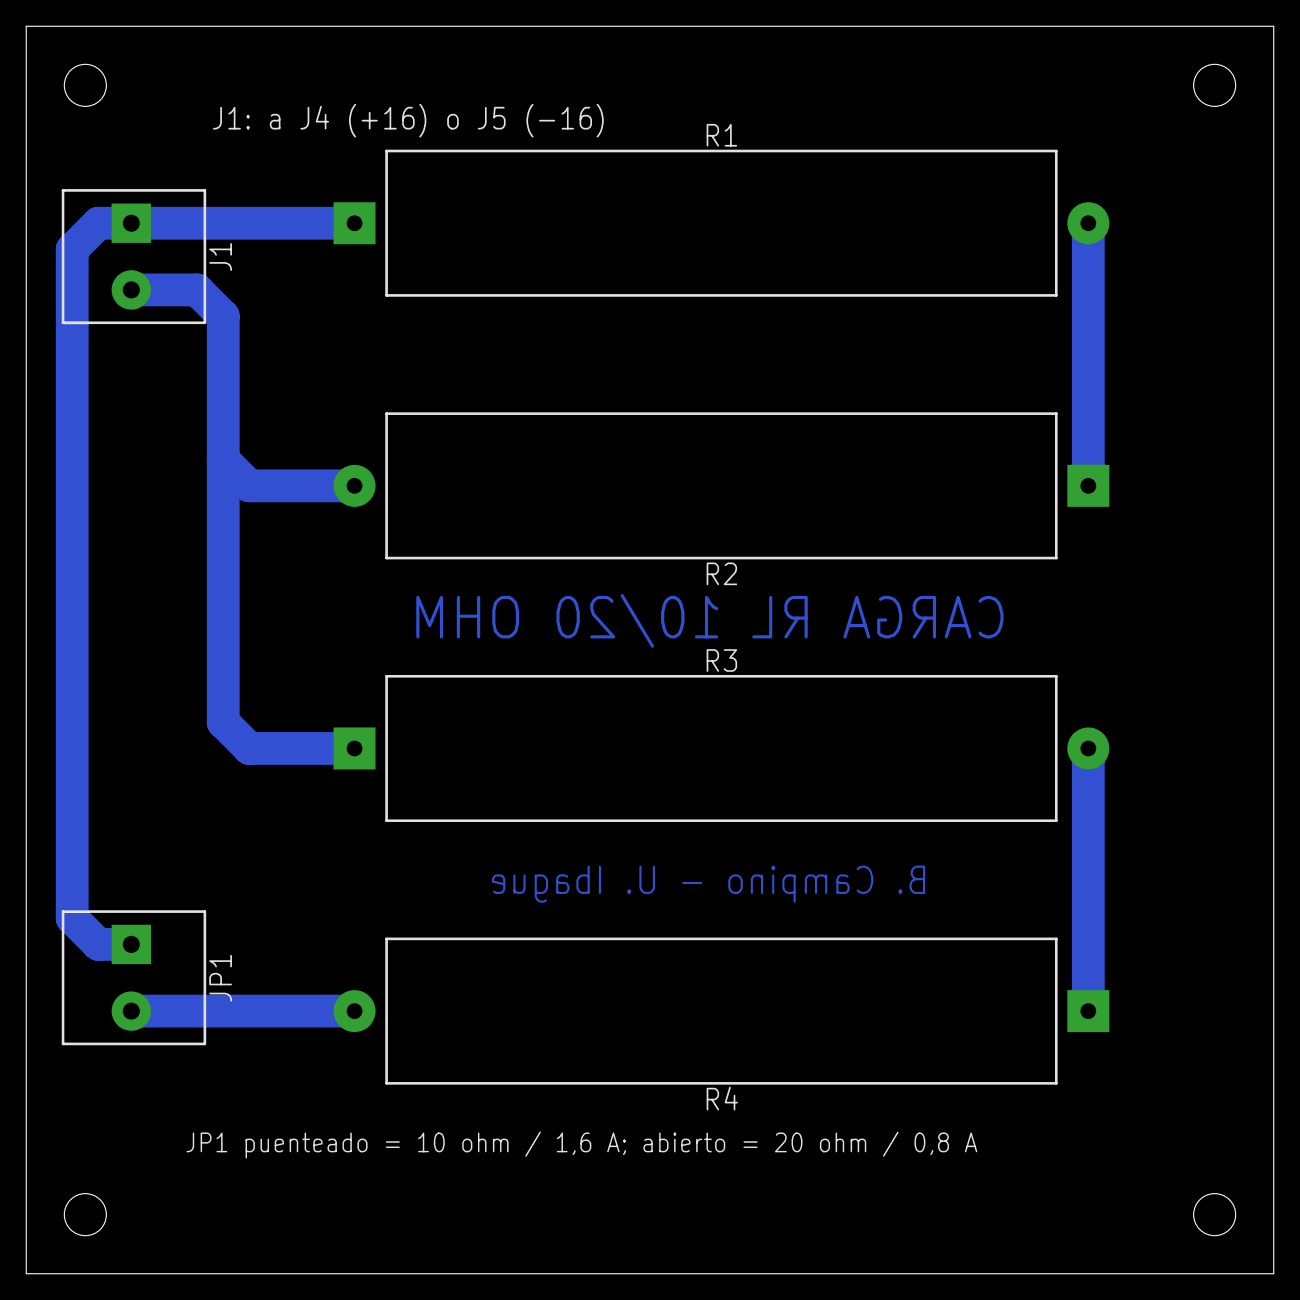
[picture p111: board carga.brd from above]

Board: 2 copper layers, 95.0 x 95.0 mm, 6 parts (0 on the bottom side), 5 nets.
