Brahiam18/controlador-pid-analogico-levitador/fuente/hardware/pcb/fuente.brd

## EAGLE design fuente/hardware/pcb/fuente.brd (2026-11-11)

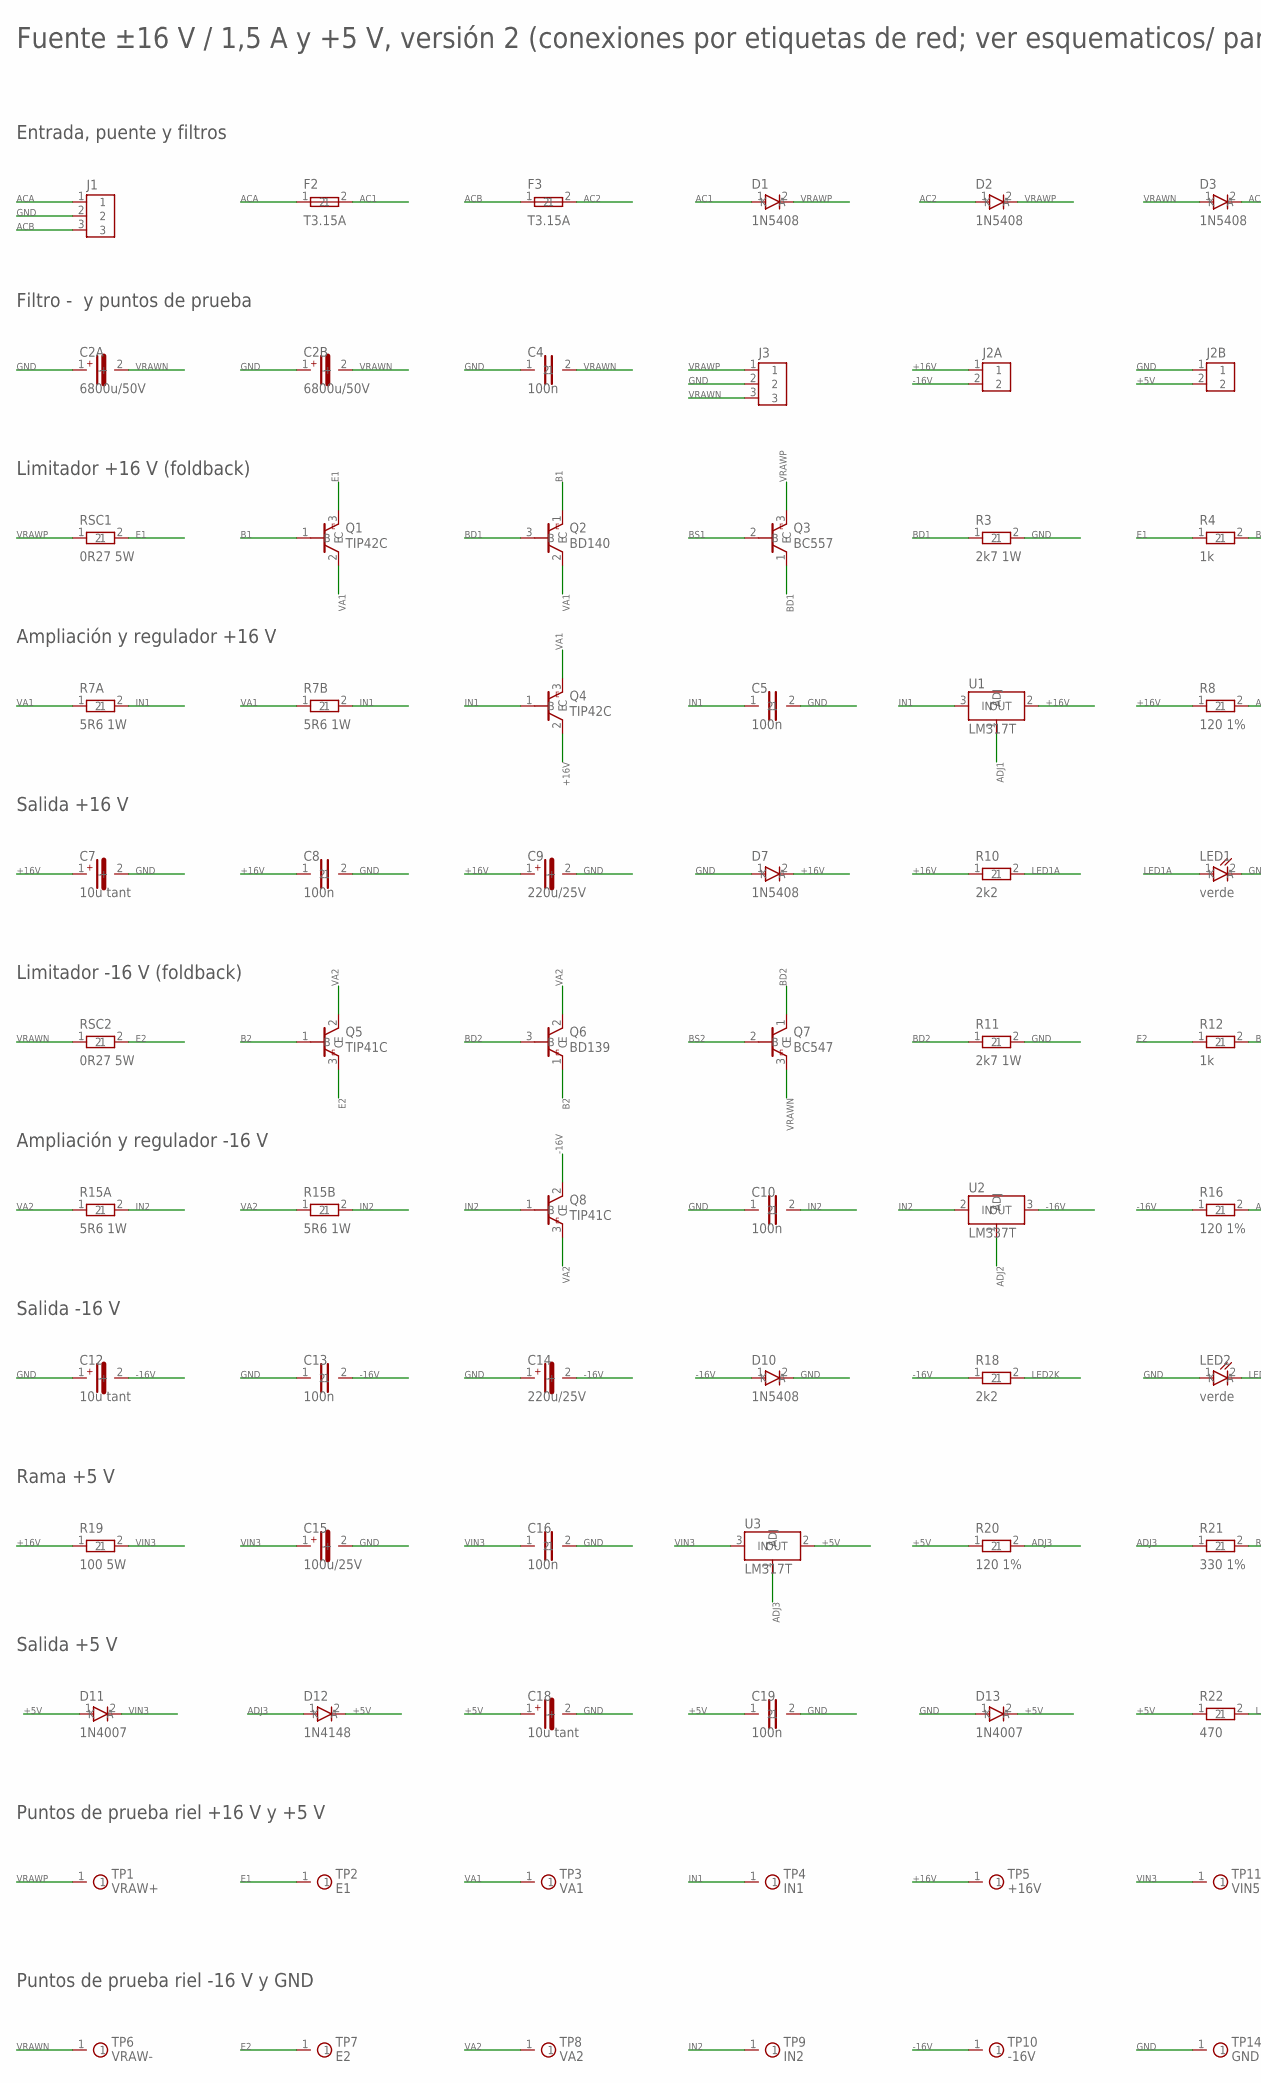
[picture p112: schematic fuente.sch, part in row 1, column 1]

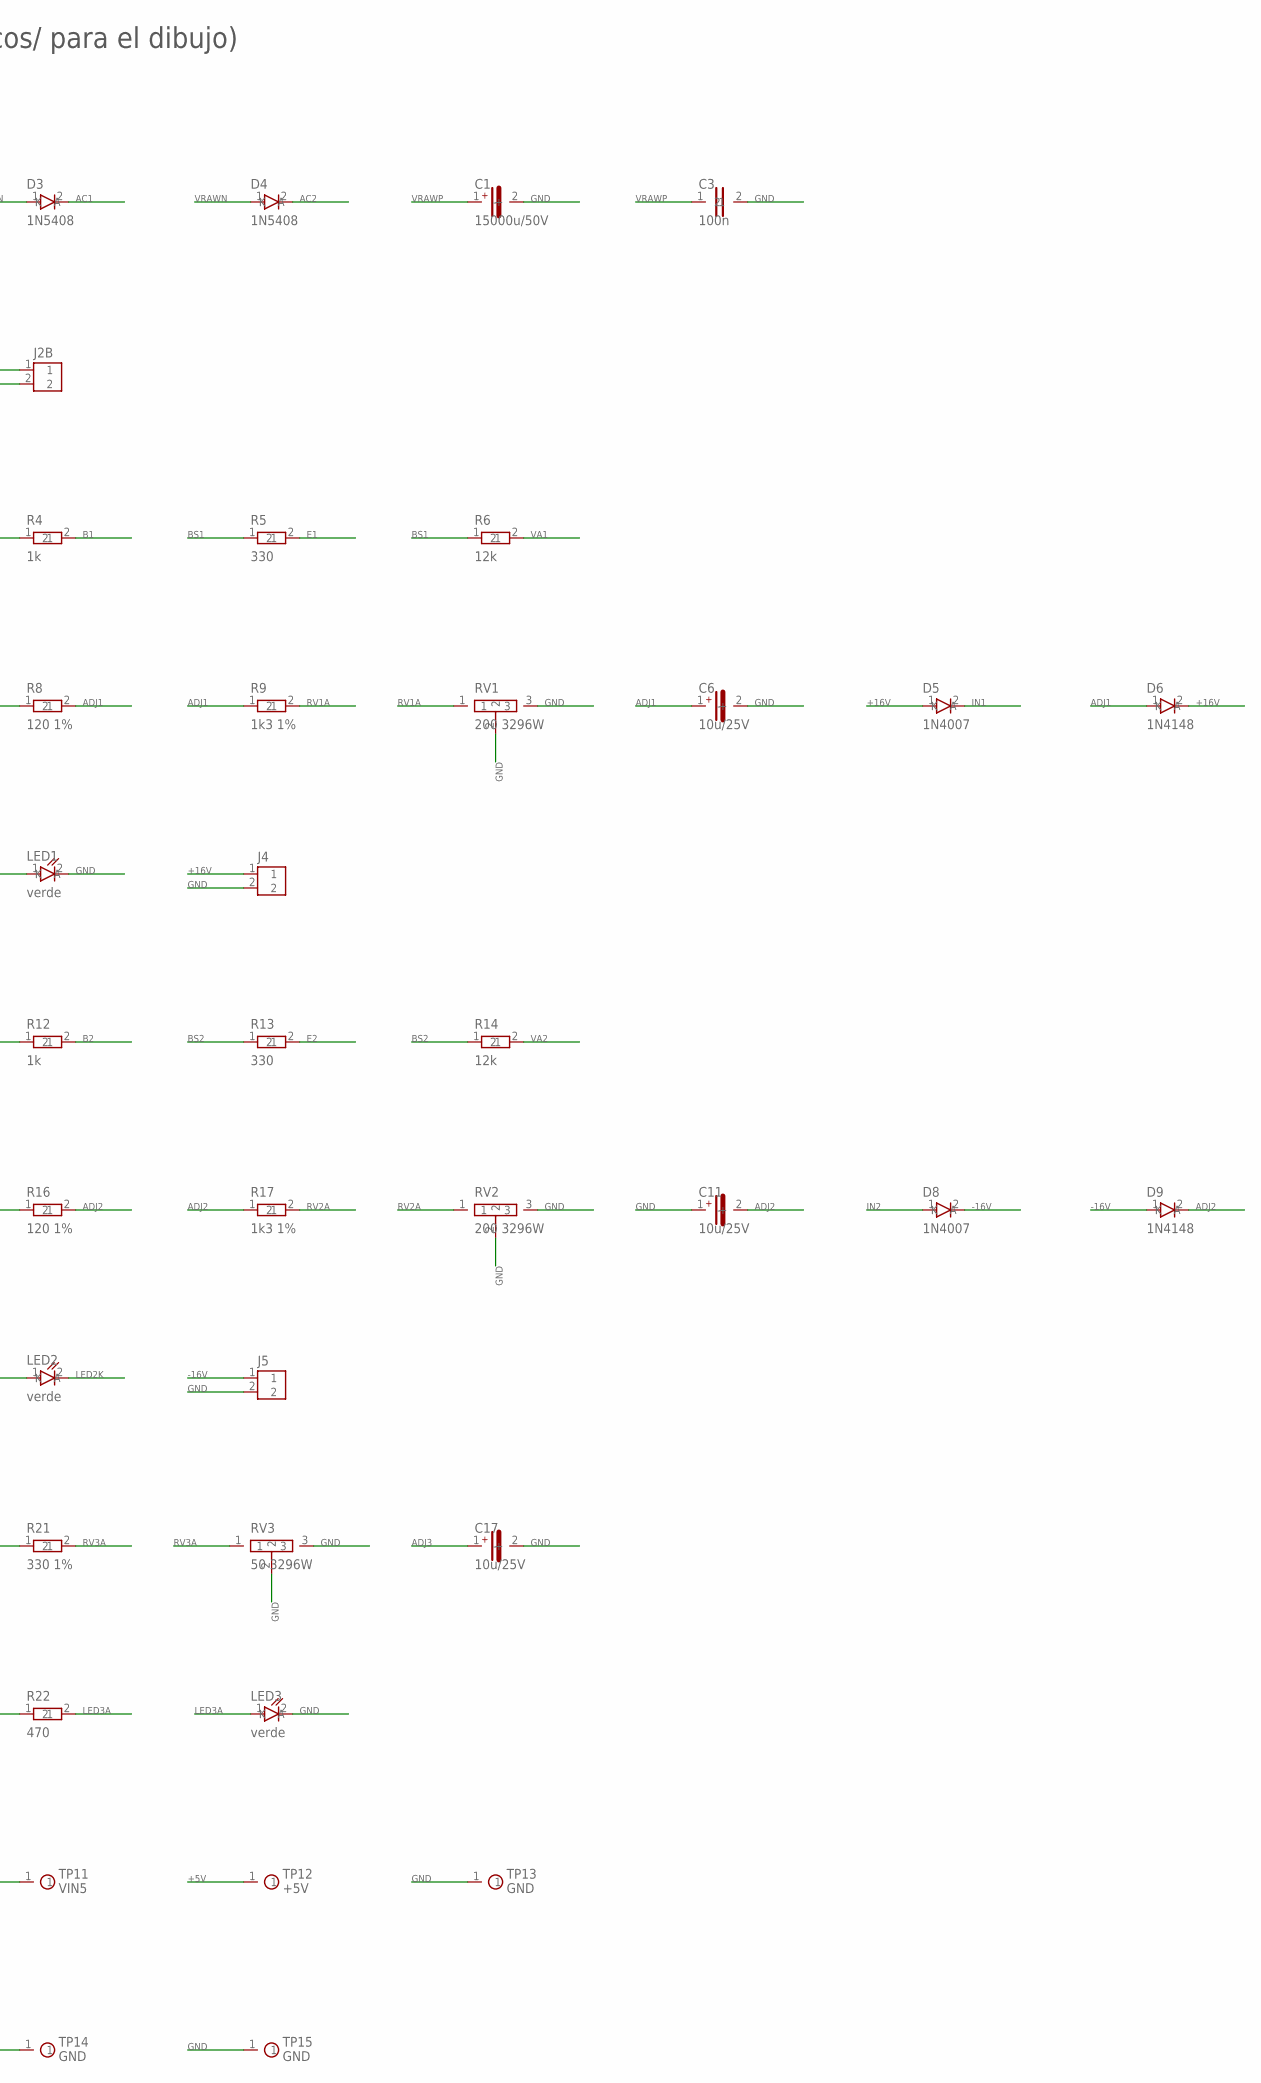
[picture p113: schematic fuente.sch, part in row 1, column 2]

Parts:
C1: 15000u/50V; CPOL35
C2A, C2B: 6800u/50V; CPOL25
C3, C4, C5, C8, C10, C13, C16, C19: 100n; CAP
C6, C11, C17: 10u/25V; CPOL5
C7, C12, C18: 10u tant; CTANT
C9, C14: 220u/25V; CPOL8
C15: 100u/25V; CPOL6
D1, D2, D3, D4, D7, D10: 1N5408; DIODE
D5, D8, D11, D13: 1N4007; DO41
D6, D9, D12: 1N4148; DO35
F2, F3: T3.15A; FUSE
J1: SEC 18-0-18; TERM3
J2A: +16/-16; TERM2
J2B: GND/+5; TERM2
J3: TP; HDR3
J4: RL +16; TERM2
J5: RL -16; TERM2
LED1, LED2, LED3: verde; LED5
Q1, Q4: TIP42C; TO220
Q2: BD140; TO126
Q3: BC557; TO92
Q5, Q8: TIP41C; TO220
Q6: BD139; TO126
Q7: BC547; TO92
R3, R11: 2k7 1W; RES1W
R4, R12: 1k; RES10
R5, R13: 330; RES10
R6, R14: 12k; RES10
R7A, R7B, R15A, R15B: 5R6 1W; RES1W
R8, R16, R20: 120 1%; RES10
R9, R17: 1k3 1%; RES10
R10, R18: 2k2; RES10
R19: 100 5W; RES3W
R21: 330 1%; RES10
R22: 470; RES10
RSC1, RSC2: 0R27 5W; RES5W
RV1, RV2: 200 3296W; TRIM
RV3: 50 3296W; TRIM
TP1: VRAW+; TP
TP2: E1; TP
TP3: VA1; TP
TP4: IN1; TP
TP5: +16V; TP
TP6: VRAW-; TP
TP7: E2; TP
TP8: VA2; TP
TP9: IN2; TP
TP10: -16V; TP
TP11: VIN5; TP
TP12: +5V; TP
TP13, TP14, TP15: GND; TP
U1, U3: LM317T; TO220
U2: LM337T; TO220

Connections:
+5V: C18.1 (+), C19.1, D11.1 (A), D12.2 (K), D13.2 (K), J2B.2, R20.1, R22.1, TP12.1, U3.2 (OUT)
+16V: C7.1 (+), C8.1, C9.1 (+), D5.1 (A), D6.2 (K), D7.2 (K), J2A.1, J4.1, Q4.2 (C), R8.1, R10.1, R19.1, TP5.1, U1.2 (OUT)
-16V: C12.2 (-), C13.2, C14.2 (-), D8.2 (K), D9.1 (A), D10.1 (A), J2A.2, J5.1, Q8.2 (C), R16.1, R18.1, TP10.1, U2.3 (OUT)
AC1: D1.1 (A), D3.2 (K), F2.2
AC2: D2.1 (A), D4.2 (K), F3.2
ACA: F2.1, J1.1
ACB: F3.1, J1.3
ADJ1: C6.1 (+), D6.1 (A), R8.2, R9.1, U1.1 (ADJ)
ADJ2: C11.2 (-), D9.2 (K), R16.2, R17.1, U2.1 (ADJ)
ADJ3: C17.1 (+), D12.1 (A), R20.2, R21.1, U3.1 (ADJ)
B1: Q1.1 (B), Q2.1 (E), R4.2
B2: Q5.1 (B), Q6.1 (E), R12.2
BD1: Q2.3 (B), Q3.1 (C), R3.1
BD2: Q6.3 (B), Q7.1 (C), R11.1
BS1: Q3.2 (B), R5.1, R6.1
BS2: Q7.2 (B), R13.1, R14.1
E1: Q1.3 (E), R4.1, R5.2, RSC1.2, TP2.1
E2: Q5.3 (E), R12.1, R13.2, RSC2.2, TP7.1
GND: C1.2 (-), C2A.1 (+), C2B.1 (+), C3.2, C4.1, C5.2, C6.2 (-), C7.2 (-), C8.2, C9.2 (-), C10.1, C11.1 (+), C12.1 (+), C13.1, C14.1 (+), C15.2 (-), C16.2, C17.2 (-), C18.2 (-), C19.2, D7.1 (A), D10.2 (K), D13.1 (A), J1.2, J2B.1, J3.2, J4.2, J5.2, LED1.2 (K), LED2.1 (A), LED3.2 (K), R3.2, R11.2, RV1.2, RV1.3, RV2.2, RV2.3, RV3.2, RV3.3, TP13.1, TP14.1, TP15.1
IN1: C5.1, D5.2 (K), Q4.1 (B), R7A.2, R7B.2, TP4.1, U1.3 (IN)
IN2: C10.2, D8.1 (A), Q8.1 (B), R15A.2, R15B.2, TP9.1, U2.2 (IN)
LED1A: LED1.1 (A), R10.2
LED2K: LED2.2 (K), R18.2
LED3A: LED3.1 (A), R22.2
RV1A: R9.2, RV1.1
RV2A: R17.2, RV2.1
RV3A: R21.2, RV3.1
VA1: Q1.2 (C), Q2.2 (C), Q4.3 (E), R6.2, R7A.1, R7B.1, TP3.1
VA2: Q5.2 (C), Q6.2 (C), Q8.3 (E), R14.2, R15A.1, R15B.1, TP8.1
VIN3: C15.1 (+), C16.1, D11.2 (K), R19.2, TP11.1, U3.3 (IN)
VRAWN: C2A.2 (-), C2B.2 (-), C4.2, D3.1 (A), D4.1 (A), J3.3, Q7.3 (E), RSC2.1, TP6.1
VRAWP: C1.1 (+), C3.1, D1.2 (K), D2.2 (K), J3.1, Q3.3 (E), RSC1.1, TP1.1

Notes on the sheet:
Entrada, puente y filtros
Filtro - y puntos de prueba
Limitador +16 V (foldback)
Ampliación y regulador +16 V
Salida +16 V
Limitador -16 V (foldback)
Ampliación y regulador -16 V
Salida -16 V
Rama +5 V
Salida +5 V
Puntos de prueba riel +16 V y +5 V
Puntos de prueba riel -16 V y GND
Fuente ±16 V / 1,5 A y +5 V, versión 2 (conexiones por etiquetas de red; ver esquematicos/ para el dibujo)

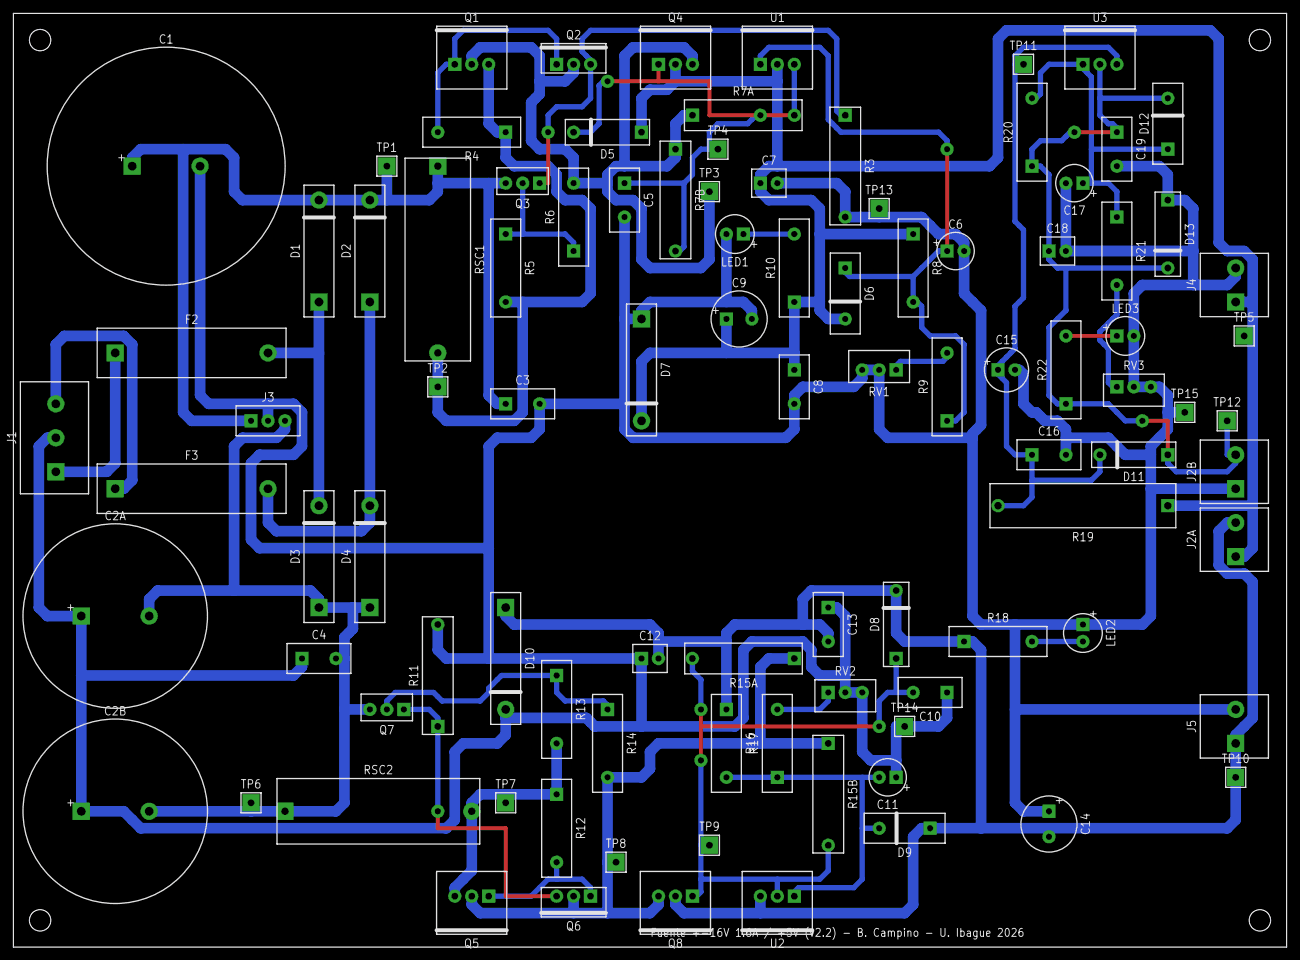
[picture p114: board fuente.brd from above]

Board: 2 copper layers, 190.5 x 139.7 mm, 97 parts (0 on the bottom side), 32 nets.
