Brahiam18/controlador-pid-analogico-levitador/hardware/pcb/pid2_levitador.brd

## EAGLE design hardware/pcb/pid2_levitador.brd (2026-10-23)

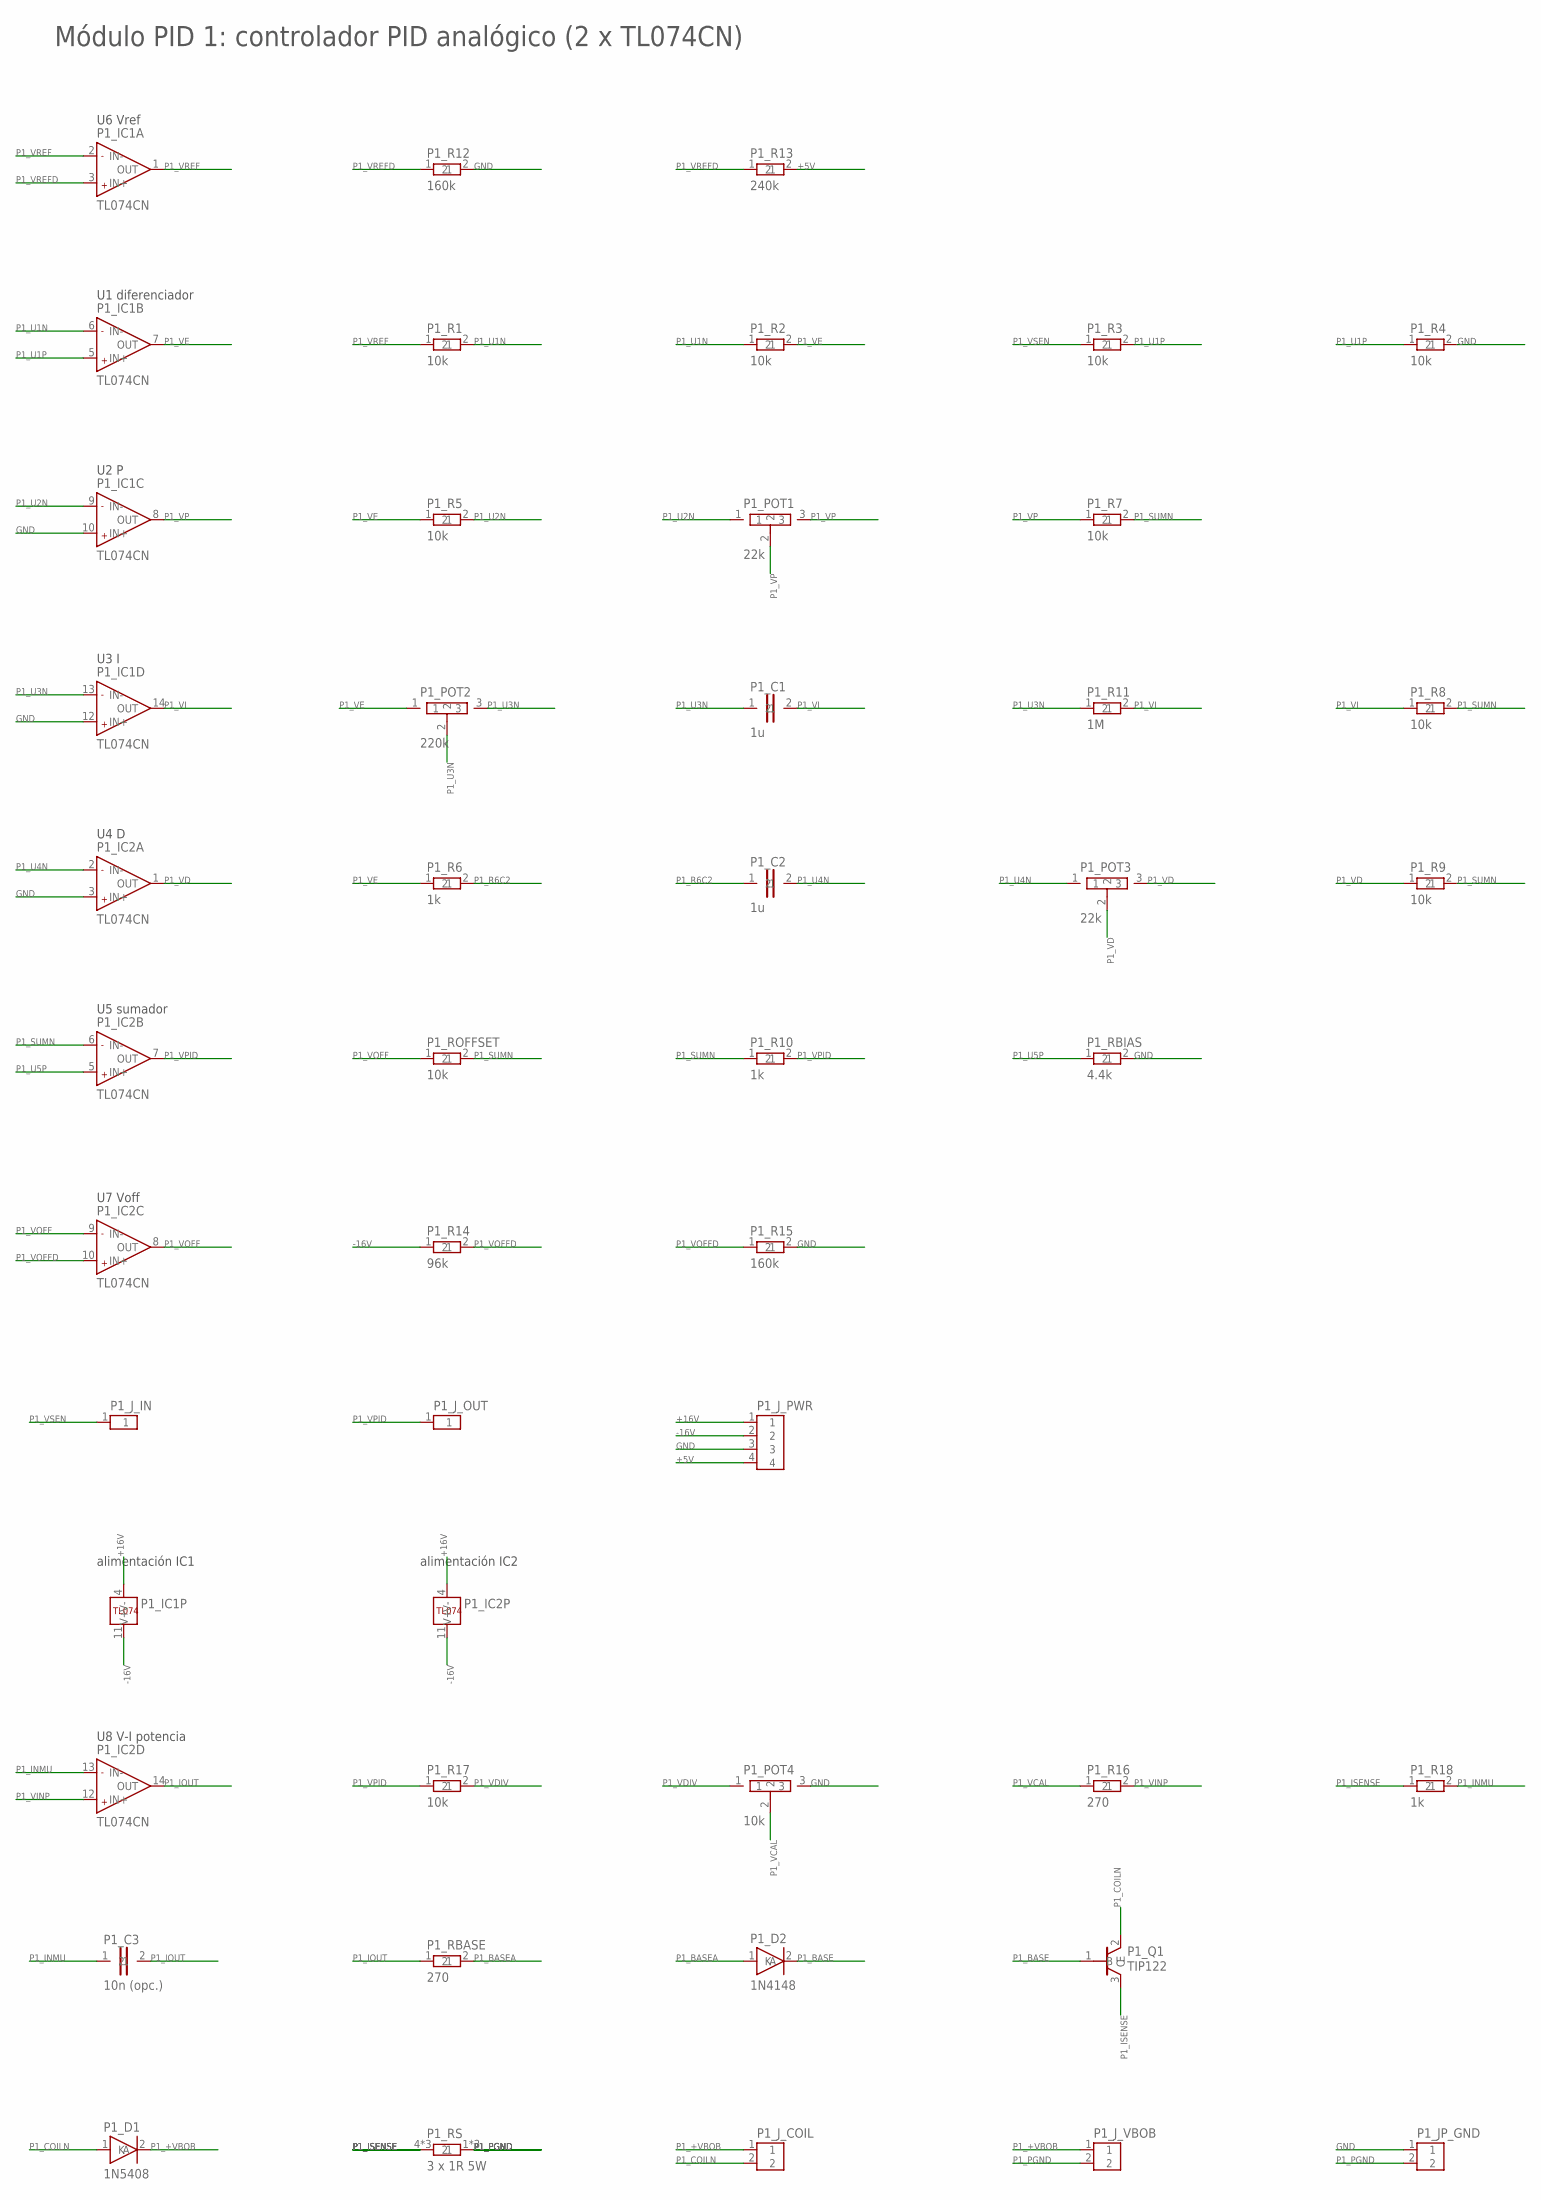
[picture p115: schematic pid2_levitador.sch, sheet 1]

Parts:
P1_C1, P1_C2: 1u; CAP
P1_C3: 10n (opc.); CAP
P1_D1: 1N5408; DIODE
P1_D2: 1N4148; DIODE_S
P1_IC1, P1_IC2: TL074CN; DIL14
P1_JP_GND: GND-PGND; HDR2
P1_J_COIL: BOBINA; TERM2
P1_J_IN: VSENSOR; HDR1
P1_J_OUT: VPID; HDR1
P1_J_PWR: PWR; HDR4
P1_J_VBOB: VBOB; TERM2
P1_POT1, P1_POT3: 22k; POT
P1_POT2: 220k; POT
P1_POT4: 10k; POT
P1_Q1: TIP122; TO220
P1_R1, P1_R2, P1_R3, P1_R4, P1_R5, P1_R7, P1_R8, P1_R9, P1_R17, P1_ROFFSET: 10k; RES
P1_R6, P1_R10, P1_R18: 1k; RES
P1_R11: 1M; RES
P1_R12, P1_R15: 160k; RES
P1_R13: 240k; RES
P1_R14: 96k; RES
P1_R16, P1_RBASE: 270; RES
P1_RBIAS: 4.4k; RES
P1_RS: 3 x 1R 5W; RSBANK

Connections:
+5V: P1_J_PWR.4, P1_R13.2; also elsewhere on the board
+16V: P1_IC1.4 (V+), P1_IC2.4 (V+), P1_J_PWR.1; also elsewhere on the board
-16V: P1_IC1.11 (V-), P1_IC2.11 (V-), P1_J_PWR.2, P1_R14.1; also elsewhere on the board
GND: P1_IC1.10 (IN+), P1_IC1.12 (IN+), P1_IC2.3 (IN+), P1_JP_GND.1, P1_J_PWR.3, P1_POT4.3, P1_R4.2, P1_R12.2, P1_R15.2, P1_RBIAS.2; also elsewhere on the board
P1_+VBOB: P1_D1.2 (K), P1_J_COIL.1, P1_J_VBOB.1
P1_BASE: P1_D2.2 (K), P1_Q1.1 (B)
P1_BASEA: P1_D2.1 (A), P1_RBASE.2
P1_COILN: P1_D1.1 (A), P1_J_COIL.2, P1_Q1.2 (C)
P1_INMU: P1_C3.1, P1_IC2.13 (IN-), P1_R18.2
P1_IOUT: P1_C3.2, P1_IC2.14 (OUT), P1_RBASE.1
P1_ISENSE: P1_Q1.3 (E), P1_R18.1, P1_RS.4 (1), P1_RS.5 (1), P1_RS.6 (1)
P1_PGND: P1_JP_GND.2, P1_J_VBOB.2, P1_RS.1 (2), P1_RS.2, P1_RS.3 (2)
P1_R6C2: P1_C2.1, P1_R6.2
P1_SUMN: P1_IC2.6 (IN-), P1_R7.2, P1_R8.2, P1_R9.2, P1_R10.1, P1_ROFFSET.2
P1_U1N: P1_IC1.6 (IN-), P1_R1.2, P1_R2.1
P1_U1P: P1_IC1.5 (IN+), P1_R3.2, P1_R4.1
P1_U2N: P1_IC1.9 (IN-), P1_POT1.1, P1_R5.2
P1_U3N: P1_C1.1, P1_IC1.13 (IN-), P1_POT2.2, P1_POT2.3, P1_R11.1
P1_U4N: P1_C2.2, P1_IC2.2 (IN-), P1_POT3.1
P1_U5P: P1_IC2.5 (IN+), P1_RBIAS.1
P1_VCAL: P1_POT4.2, P1_R16.1
P1_VD: P1_IC2.1 (OUT), P1_POT3.2, P1_POT3.3, P1_R9.1
P1_VDIV: P1_POT4.1, P1_R17.2
P1_VE: P1_IC1.7 (OUT), P1_POT2.1, P1_R2.2, P1_R5.1, P1_R6.1
P1_VI: P1_C1.2, P1_IC1.14 (OUT), P1_R8.1, P1_R11.2
P1_VINP: P1_IC2.12 (IN+), P1_R16.2
P1_VOFF: P1_IC2.8 (OUT), P1_IC2.9 (IN-), P1_ROFFSET.1
P1_VOFFD: P1_IC2.10 (IN+), P1_R14.2, P1_R15.1
P1_VP: P1_IC1.8 (OUT), P1_POT1.2, P1_POT1.3, P1_R7.1
P1_VPID: P1_IC2.7 (OUT), P1_J_OUT.1, P1_R10.2, P1_R17.1
P1_VREF: P1_IC1.1 (OUT), P1_IC1.2 (IN-), P1_R1.1
P1_VREFD: P1_IC1.3 (IN+), P1_R12.1, P1_R13.1
P1_VSEN: P1_J_IN.1, P1_R3.1

Notes on the sheet:
U6 Vref
U1 diferenciador
U2 P
U3 I
U4 D
U5 sumador
U7 Voff
alimentación IC1
alimentación IC2
U8 V-I potencia
Módulo PID 1: controlador PID analógico (2 x TL074CN)

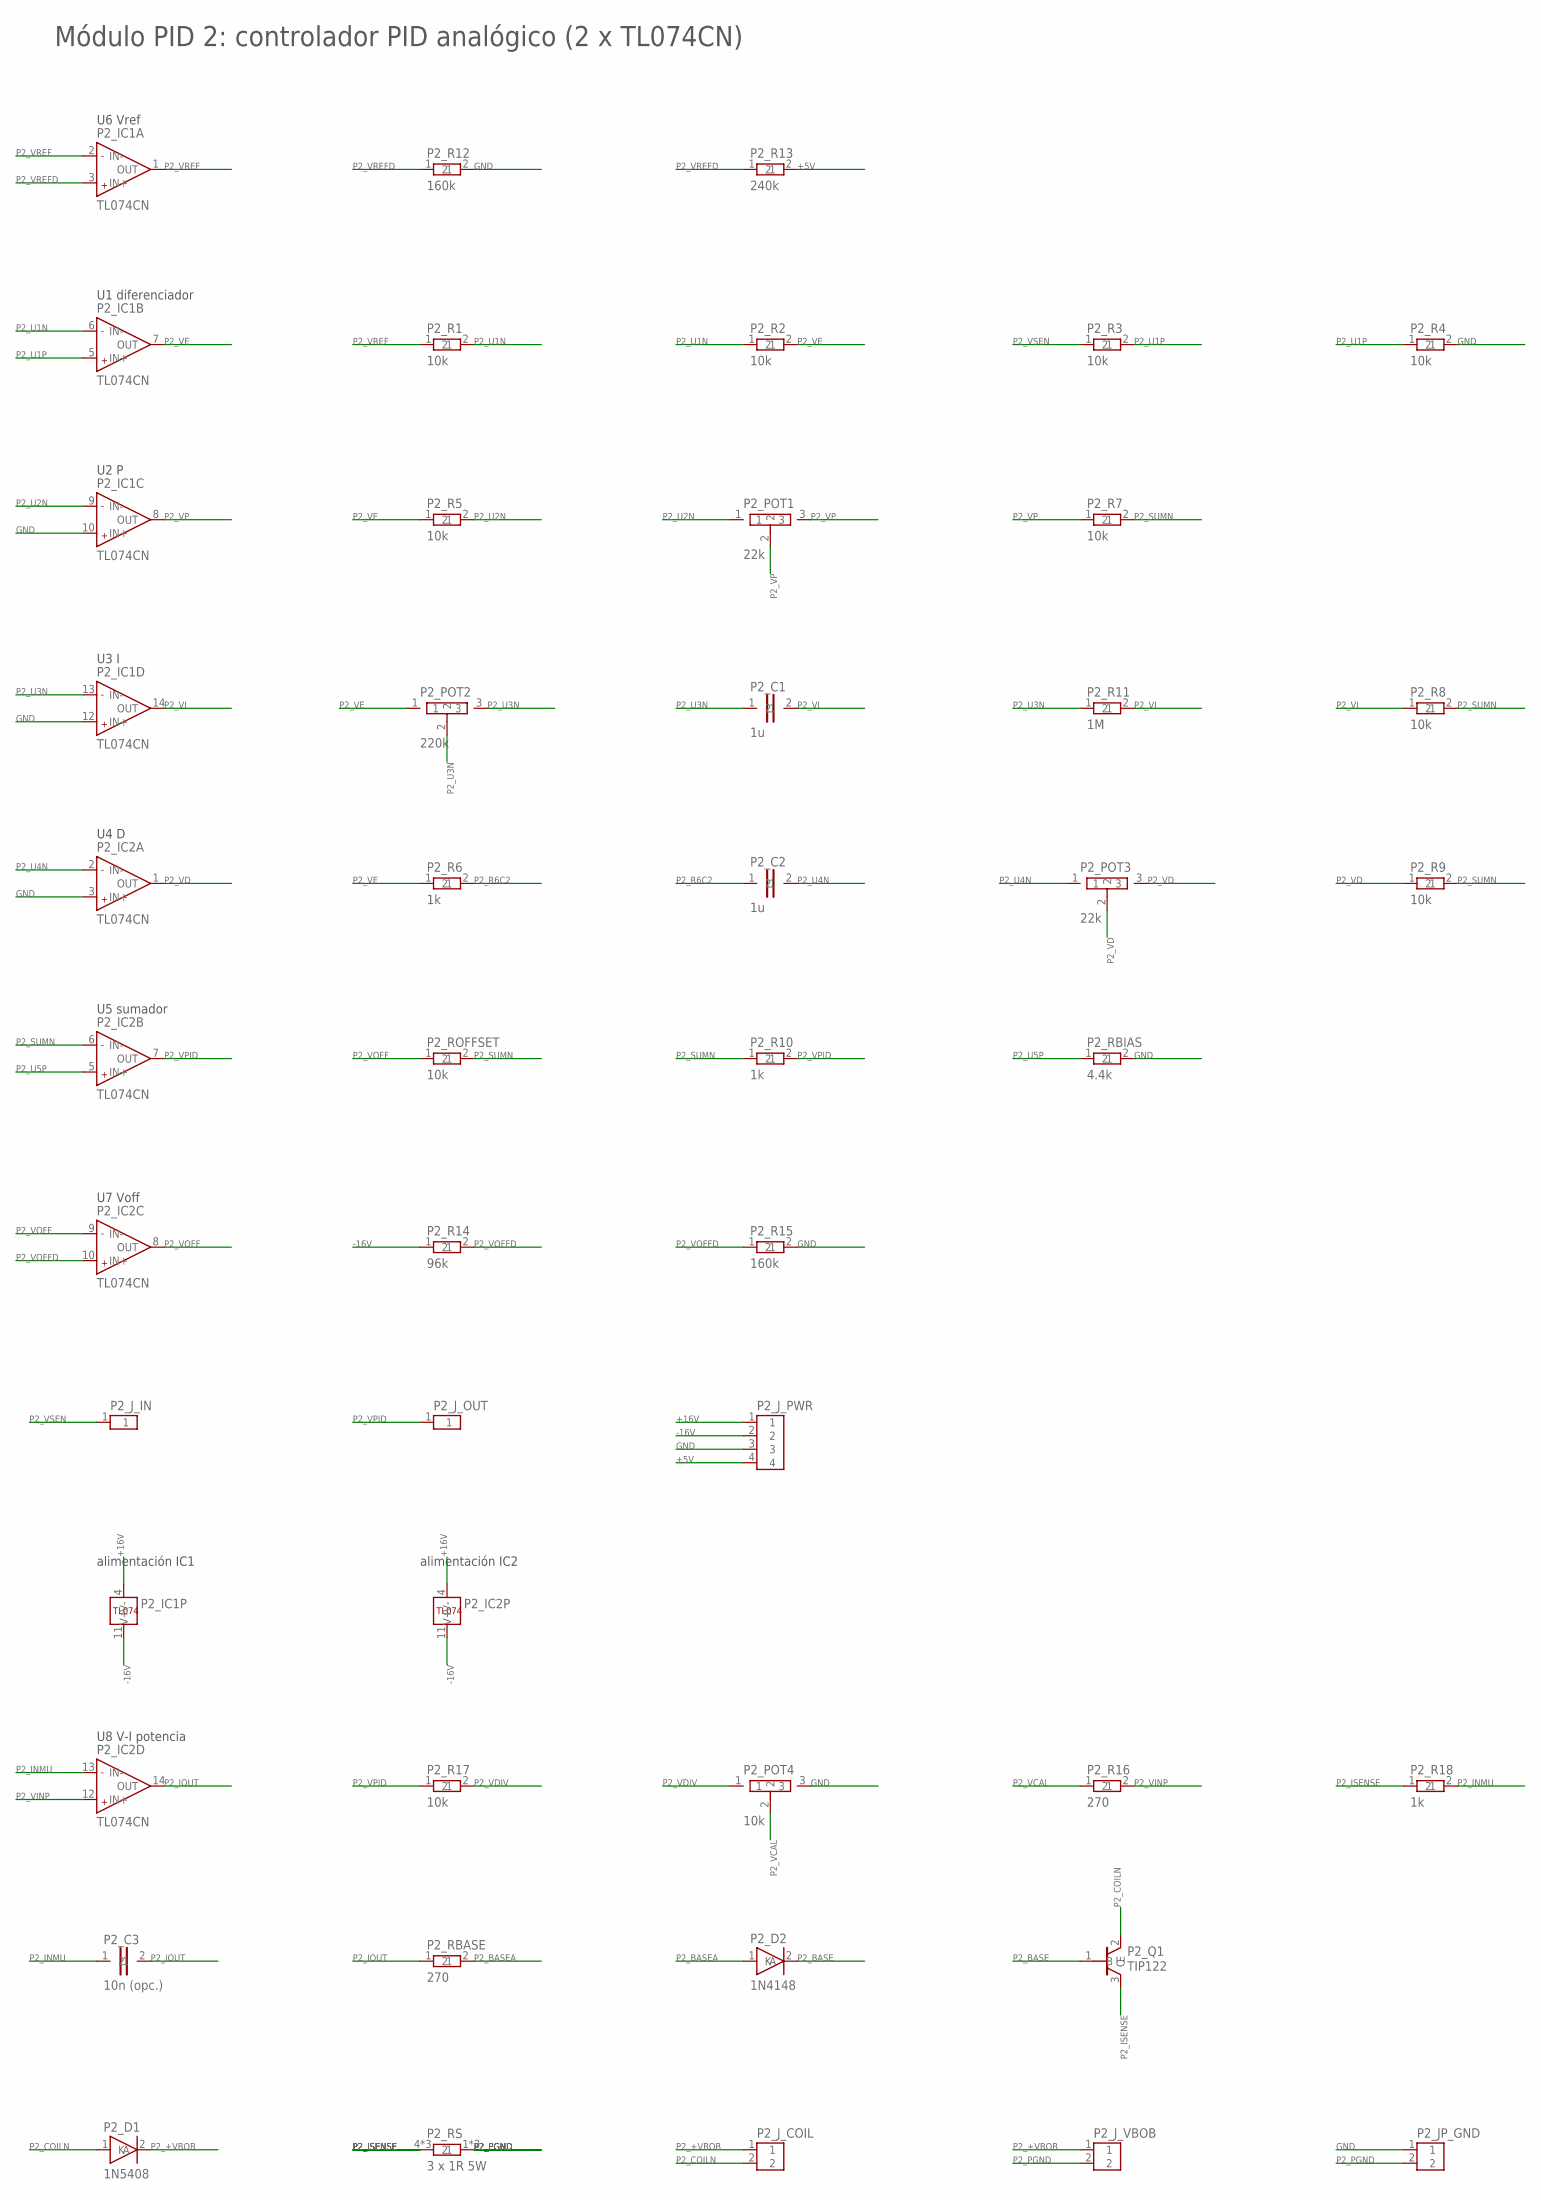
[picture p116: schematic pid2_levitador.sch, sheet 2]

Parts:
P2_C1, P2_C2: 1u; CAP
P2_C3: 10n (opc.); CAP
P2_D1: 1N5408; DIODE
P2_D2: 1N4148; DIODE_S
P2_IC1, P2_IC2: TL074CN; DIL14
P2_JP_GND: GND-PGND; HDR2
P2_J_COIL: BOBINA; TERM2
P2_J_IN: VSENSOR; HDR1
P2_J_OUT: VPID; HDR1
P2_J_PWR: PWR; HDR4
P2_J_VBOB: VBOB; TERM2
P2_POT1, P2_POT3: 22k; POT
P2_POT2: 220k; POT
P2_POT4: 10k; POT
P2_Q1: TIP122; TO220
P2_R1, P2_R2, P2_R3, P2_R4, P2_R5, P2_R7, P2_R8, P2_R9, P2_R17, P2_ROFFSET: 10k; RES
P2_R6, P2_R10, P2_R18: 1k; RES
P2_R11: 1M; RES
P2_R12, P2_R15: 160k; RES
P2_R13: 240k; RES
P2_R14: 96k; RES
P2_R16, P2_RBASE: 270; RES
P2_RBIAS: 4.4k; RES
P2_RS: 3 x 1R 5W; RSBANK

Connections:
+5V: P2_J_PWR.4, P2_R13.2; also elsewhere on the board
+16V: P2_IC1.4 (V+), P2_IC2.4 (V+), P2_J_PWR.1; also elsewhere on the board
-16V: P2_IC1.11 (V-), P2_IC2.11 (V-), P2_J_PWR.2, P2_R14.1; also elsewhere on the board
GND: P2_IC1.10 (IN+), P2_IC1.12 (IN+), P2_IC2.3 (IN+), P2_JP_GND.1, P2_J_PWR.3, P2_POT4.3, P2_R4.2, P2_R12.2, P2_R15.2, P2_RBIAS.2; also elsewhere on the board
P2_+VBOB: P2_D1.2 (K), P2_J_COIL.1, P2_J_VBOB.1
P2_BASE: P2_D2.2 (K), P2_Q1.1 (B)
P2_BASEA: P2_D2.1 (A), P2_RBASE.2
P2_COILN: P2_D1.1 (A), P2_J_COIL.2, P2_Q1.2 (C)
P2_INMU: P2_C3.1, P2_IC2.13 (IN-), P2_R18.2
P2_IOUT: P2_C3.2, P2_IC2.14 (OUT), P2_RBASE.1
P2_ISENSE: P2_Q1.3 (E), P2_R18.1, P2_RS.4 (1), P2_RS.5 (1), P2_RS.6 (1)
P2_PGND: P2_JP_GND.2, P2_J_VBOB.2, P2_RS.1 (2), P2_RS.2, P2_RS.3 (2)
P2_R6C2: P2_C2.1, P2_R6.2
P2_SUMN: P2_IC2.6 (IN-), P2_R7.2, P2_R8.2, P2_R9.2, P2_R10.1, P2_ROFFSET.2
P2_U1N: P2_IC1.6 (IN-), P2_R1.2, P2_R2.1
P2_U1P: P2_IC1.5 (IN+), P2_R3.2, P2_R4.1
P2_U2N: P2_IC1.9 (IN-), P2_POT1.1, P2_R5.2
P2_U3N: P2_C1.1, P2_IC1.13 (IN-), P2_POT2.2, P2_POT2.3, P2_R11.1
P2_U4N: P2_C2.2, P2_IC2.2 (IN-), P2_POT3.1
P2_U5P: P2_IC2.5 (IN+), P2_RBIAS.1
P2_VCAL: P2_POT4.2, P2_R16.1
P2_VD: P2_IC2.1 (OUT), P2_POT3.2, P2_POT3.3, P2_R9.1
P2_VDIV: P2_POT4.1, P2_R17.2
P2_VE: P2_IC1.7 (OUT), P2_POT2.1, P2_R2.2, P2_R5.1, P2_R6.1
P2_VI: P2_C1.2, P2_IC1.14 (OUT), P2_R8.1, P2_R11.2
P2_VINP: P2_IC2.12 (IN+), P2_R16.2
P2_VOFF: P2_IC2.8 (OUT), P2_IC2.9 (IN-), P2_ROFFSET.1
P2_VOFFD: P2_IC2.10 (IN+), P2_R14.2, P2_R15.1
P2_VP: P2_IC1.8 (OUT), P2_POT1.2, P2_POT1.3, P2_R7.1
P2_VPID: P2_IC2.7 (OUT), P2_J_OUT.1, P2_R10.2, P2_R17.1
P2_VREF: P2_IC1.1 (OUT), P2_IC1.2 (IN-), P2_R1.1
P2_VREFD: P2_IC1.3 (IN+), P2_R12.1, P2_R13.1
P2_VSEN: P2_J_IN.1, P2_R3.1

Notes on the sheet:
U6 Vref
U1 diferenciador
U2 P
U3 I
U4 D
U5 sumador
U7 Voff
alimentación IC1
alimentación IC2
U8 V-I potencia
Módulo PID 2: controlador PID analógico (2 x TL074CN)

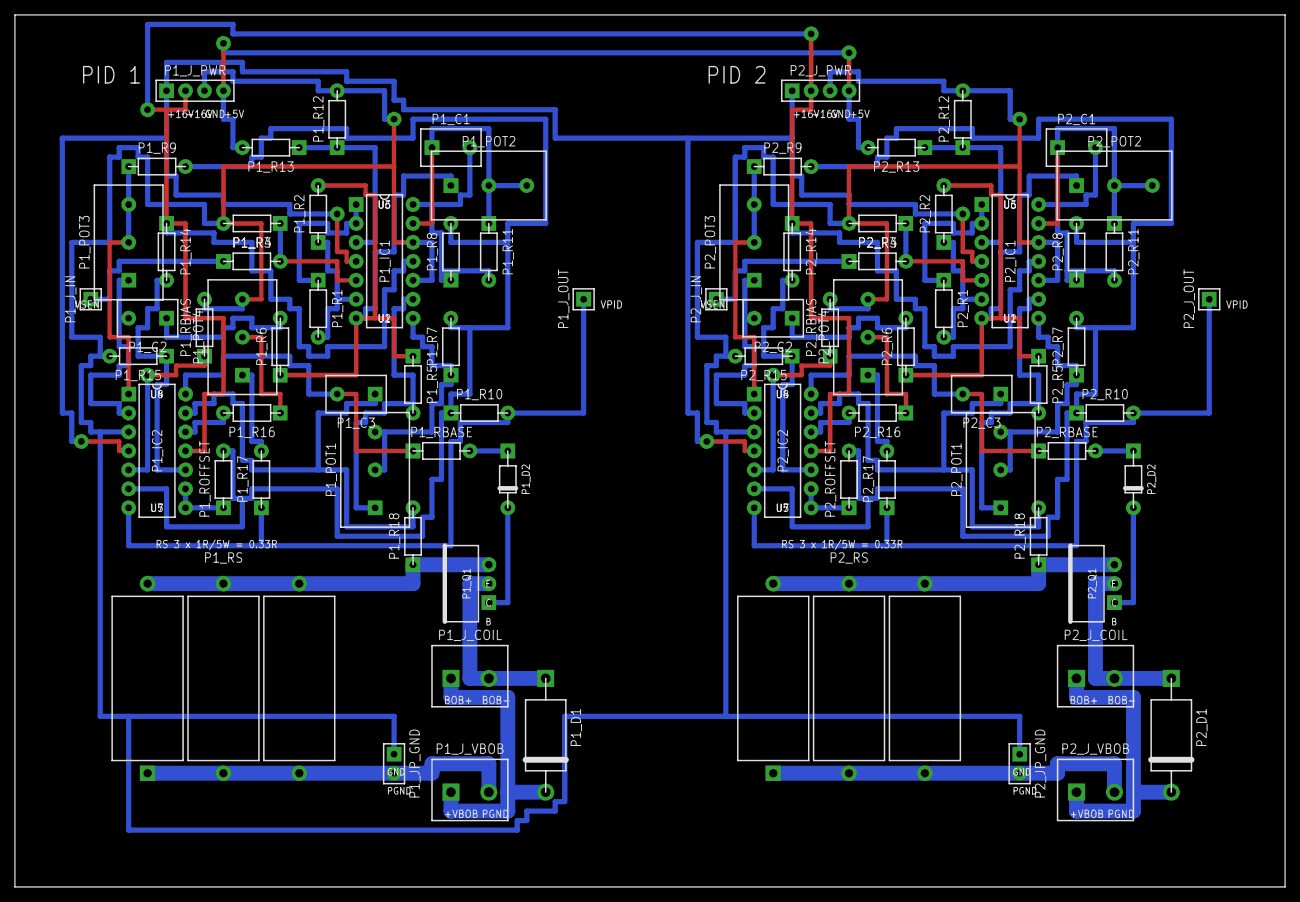
[picture p117: board pid2_levitador.brd from above]

Board: 2 copper layers, 170.2 x 116.8 mm, 80 parts (0 on the bottom side), 62 nets.
