Brahiam18/controlador-pid-analogico-levitador/(commit log)

2026-10-09 Agrega licencia MIT y .gitignore para LaTeX
2026-10-09 Agrega lista de materiales y plantilla de mediciones prácticas
    [lista_de_materiales.csv, mediciones_practicas.csv]
2026-10-13 Registra mediciones prácticas con error absoluto y relativo
    [mediciones_practicas.csv]
2026-10-18 Agrega placa de una cara con 4 controladores PID (EAGLE/Fusion, PDF de cobre espejado y generador)
    [pid4_levitador.brd, pid4_levitador.sch]
2026-10-18 Rehace la placa de 4 PID con TL074CN (2 por controlador, DIP-14) en lugar de LM741
    [pid4_levitador.brd, pid4_levitador.sch]
2026-10-18 Agrega la etapa de potencia a cada uno de los 4 PID de la placa (TIP122, banco de sensado 10 x 1R, protección y bornes de bobina)
    [lista_de_materiales.csv, pid4_levitador.brd, pid4_levitador.sch]
2026-10-18 Vista de ensamble con nombres: etiquetas U1 a U8 sobre cada TL074 y una página ampliada por PID
2026-10-21 Ignora archivos compilados de Python (__pycache__)
2026-10-21 Quita archivos compilados de Python del repositorio
2026-10-23 En curso: placa de 2 PID por tarjeta con banco de sensado de 3 x 1 ohm (generador y lista de materiales)
    [lista_de_materiales.csv]
2026-10-23 Placa de 2 PID por tarjeta (170 x 117 mm, cabe en 20 x 20 cm): banco de sensado de 3 x 1 ohm, R17 = 10 kohm, hojas de cobre y de ensamble con nombres U1 a U8
    [pid2_levitador.brd, pid2_levitador.sch, pid4_levitador.brd]
2026-10-23 Hoja de ensamble: rotula los pines de las regletas, borneras, TIP122 y diodos
2026-10-25 Guia de colores por red para verificar conexiones de la placa
2026-10-25 Estado del proyecto para retomar en otra conversacion
2026-10-25 Fuente ±16 V / +5 V para los 4 PID (proyecto de monografía, tema 3)
    - Informe IEEE de dos columnas con el diseño paso a paso: transformador M509
    (devanado de 18 V, media onda doble), filtros de 3300 uF, LM317/LM337
    ajustables, limitadores de corriente (Fig. 3-26 / ec. 3.27), rama de +5 V,
    disipadores y protecciones.
    - Esquemáticos por etapa y completo (circuitikz, PDF/PNG).
    - Simulación en ngspice: régimen, línea ±10 %, escalones de carga y cortos.
    - PCB de una cara 165 x 109 mm: EAGLE/Fusion (.sch/.brd), cobre espejado
    1:1, ensamble, puentes y generador.
    - Lista de materiales, plan de pruebas y tabla de mediciones.
    [fuente.brd, fuente.sch, lista_de_materiales.csv, mediciones.csv]
2026-10-26 Fuente: C1 y C2 de 6800 uF/50 V (D28 mm, paso 10 mm) y F2 lento T1A
    - Huella de C1/C2 ampliada a 28 mm de diámetro y taladro de 1.3 mm;
    se regeneran .brd/.sch, cobre espejado 1:1 y ensamble (sin cambios de ruteo).
    - Cálculos, simulación, esquemáticos, informe, lista de materiales y
    tabla de mediciones actualizados (rizado del filtro 0.73/0.59 V pp).
    [fuente.brd, fuente.sch, lista_de_materiales.csv, mediciones.csv]
2026-10-26 Informe: justificación del cambio de C1/C2 a 6800 uF y sus efectos
2026-10-29 Fuente v2: ±16 V a 1,5 A con ampliación de corriente y foldback
    - Transformador 18-0-18 V / 3 A con puente (onda completa); C1 15000 µF y 2x6800 µF reutilizados
    - Limitador con foldback (Darlington TIP42C/BD140, sensor BC557) antes de cada regulador
    - Ampliación de corriente (Fig. 3-21) con los mismos LM317/LM337
    - Carga de prueba RL removible en J4/J5
    - Cálculos, simulación (curva V-I, arranque con RL), esquemáticos, placa 190,5 x 139,7 mm,
    lista de materiales, plan de pruebas e informe actualizados
    [fuente.brd, fuente.sch, lista_de_materiales.csv, mediciones.csv]
2026-10-30 Lista de materiales: RL como 4 x 10 Ω 10 W en serie-paralelo; corrige fila de C9/C14
    [lista_de_materiales.csv]
2026-10-30 Placa 2 PID con esquinas a 45 grados (editada en Fusion) y union -16V restituida
    [pid2_levitador_esquinas45.brd]
2026-11-02 Fuente v2.1: R5 = R13 = 330 ohm, transformador de 5 A, PCB a 45° y J2 en dos borneras
    El proyecto de la fuente continúa en su propio repositorio:
    https://github.com/Brahiam18/Fuente-1.6A--16v-5v-con-anti-corto-en-solo-un-fuente-a-la-vez-carga-y-sin-carga
    [Lista_Materiales_Fuente_v2.1.xlsx, fuente.brd, fuente.sch, lista_de_materiales.csv, mediciones.csv]
2026-11-03 Corrige la corriente eficaz del devanado: 2,1 A calculada (2,28 A simulada) en lugar de 2,7 A
    Cada mitad del secundario lleva la mitad de los pulsos de cada riel (factor 1/raíz de 2).
    Tabla de transformadores: 2 A al 114 % (1,3 veces sus pérdidas), 3 A al 76 %, 5 A al 46 %.
2026-11-03 Hojas de ensamble, puentes y cobre de la placa con esquinas a 45 grados
2026-11-08 Documenta la etapa de potencia: captura de Proteus, proyecto EtapaPID1, README e informe
    [EtapaPID1.pdsprj]
2026-11-09 Agrega plano 1:1 de la base en MDF (placa, tablero, DXF) y su generador
    [placa_levitador.dxf, tablero_base.dxf]
2026-11-09 Agrega simulación magnética (FEM 2D/3D, gráficas y scripts de FEMM)
2026-11-09 Agrega resultados FEM 3D de las 4 bobinas con núcleo
2026-11-09 Agrega script de FEMM con las medidas finales de la bobina
2026-11-09 Corrige los scripts de FEMM: Lua 4 no tiene la biblioteca math (usa pi)
2026-11-09 FEMM: geometria con segmentos partidos para evitar regiones sin material
2026-11-09 FEMM: quita la caja de aire (chocaba con la frontera abierta) y deja solo mi_makeABC
2026-11-09 FEMM: diagnostico de B y fuerza, guarda el mapa de campo
2026-11-09 FEMM: caja exterior con A=0 en lugar de mi_makeABC (regiones duplicadas)
2026-11-09 FEMM: impresion robusta de B y fuerza
2026-11-09 FEMM: tamaños de malla explicitos y angulo minimo 20
2026-11-09 Agrega DXF de fabricación de la base en MDF (todas las piezas, capas para corte)
    [base_mdf_fabricacion.dxf]
2026-11-09 Actualiza el imán a las medidas reales (Ø25,4 x ~2,1 mm, 7,94 g) en el plano y el script de FEMM
    [base_mdf_fabricacion.dxf, placa_levitador.dxf, tablero_base.dxf]
2026-11-09 Agrega simulación 3D con el imán real (Ø25,4 x 2,1 mm, 7,94 g)
2026-11-10 Base impresa en 3D: STL del soporte de bobinas, tapa y bandeja de baquetas
    [bandeja_baqueta.stl, soporte_bobinas.stl, tapa_bobinas.stl]
2026-11-10 Base 3D: capuchón aislante para el sensor Hall, canal y ventana de conexión de sensores
    [capuchon_sensor.stl, soporte_bobinas.stl, tapa_bobinas.stl]
2026-11-10 Base 3D: surcos laterales para el cable plano y canal inferior hasta el borde frontal
    [soporte_bobinas.stl]
2026-11-11 Agrega gráfico de voltajes por nodo del PID con Vref = 2 V y V_sensor = 3 V
2026-11-11 Fuente v2.2: R7/R15 como 2 x 5,6 Ω en paralelo y 15 puntos de prueba en la placa
    [Lista_Materiales_Fuente_v2.1.xlsx, Lista_Materiales_Fuente_v2.2.xlsx, fuente.brd, fuente.sch, lista_de_materiales.csv]
2026-11-11 Fuente: placa de la carga de prueba R_L (10 Ω / 20 Ω)
    [carga.brd, carga.sch, lista_de_materiales.csv]
2026-11-11 Agrega simulación visual del campo magnético y video de presentación
2026-11-11 Agrega póster para la muestra METIE (pptx y pdf)
2026-11-13 Estado nov 2026: plan 2027, guía de depuración, fotos del montaje y resumen para posgrado
2026-11-13 README: agrega video de simulación del campo, visor 3D y póster METIE
